konradweh/ABEP_Koppeltest/Praesentation/img/RFN/draufsicht.pdf

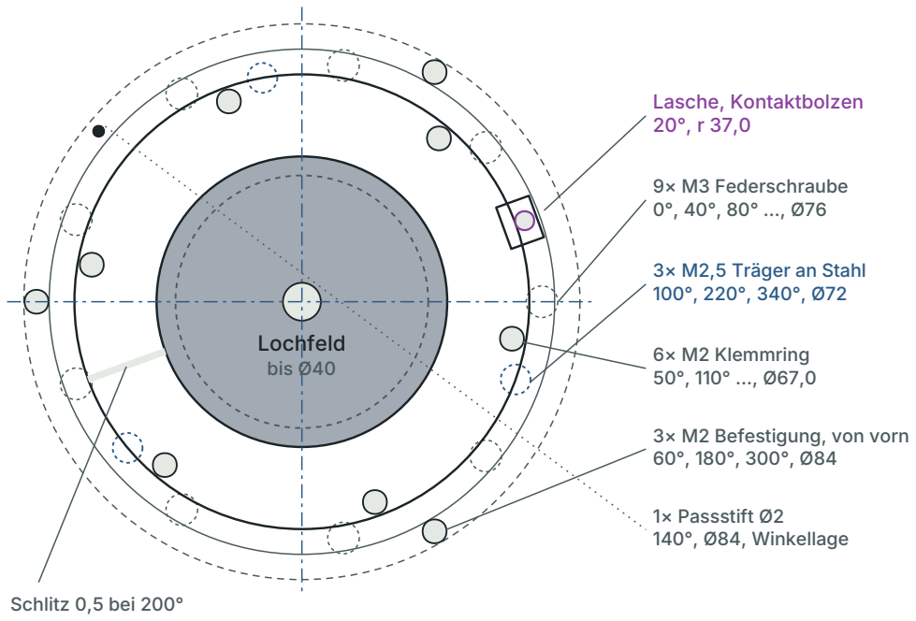
[picture p9: figure]
Lochfeld bis Ø40; Lasche, Kontaktbolzen 20°, r 37,0; 9× M3 Federschraube 0°, 40°, 80° …, Ø76; 3× M2,5 Träger an Stahl 100°, 220°, 340°, Ø72; 6× M2 Klemmring 50°, 110° …, Ø67,0; 3× M2 Befestigung, von vorn 60°, 180°, 300°, Ø84; 1× Passstift Ø2 140°, Ø84, Winkellage; Schlitz 0,5 bei 200°
