konradweh/ABEP_Koppeltest/Praesentation/img/RFN/entlueftung.pdf

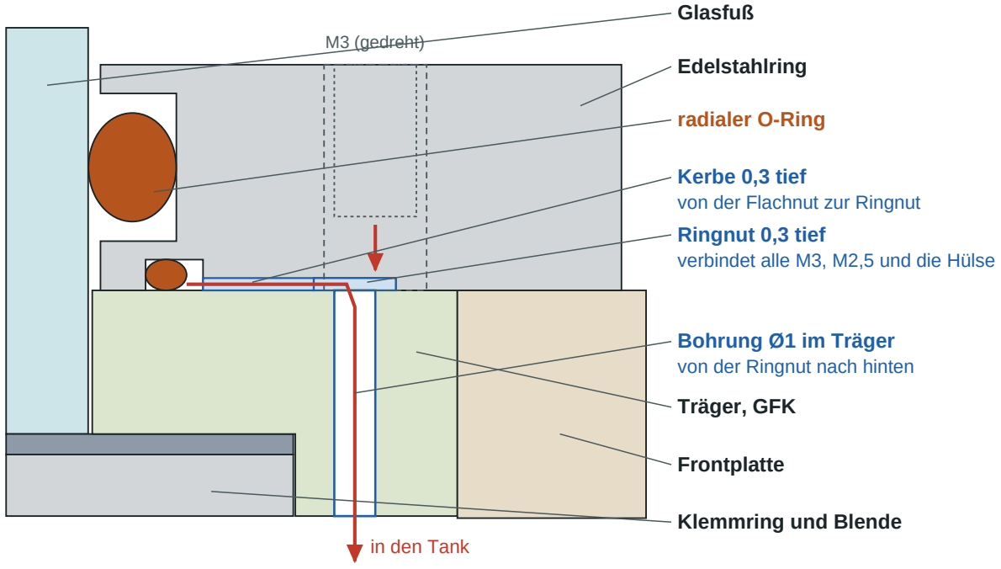
[picture p10: figure]
M3 (gedreht); in den Tank; Edelstahlring; radialer O-Ring; Kerbe 0,3 tief von der Flachnut zur Ringnut Ringnut 0,3 tief verbindet alle M3, M2,5 und die Hülse; Bohrung Ø1 im Träger von der Ringnut nach hinten; Träger, GFK; Frontplatte; Klemmring und Blende; Glasfuß

r 29 | 36,5 | 38,5 | 44
