konradweh/ABEP_Koppeltest/Praesentation/img/RFN/kontakt.pdf

Kontermutter

Kabelschuh

Mutter auf der Hülse,
0,5 über dem GFK-Ring

## Keramikhülse

Al₂O₃ Ø5 / Ø3,2 × 12,2
steht auf dem Träger

## Edelstahlring

Bohrung Ø5,3

## Träger

Bohrung Ø3,0, Freistich für die Lasche

Lasche mit M2,5-Gewinde bei r 37,0

GFK-Ring oben
Bohrung Ø6

Glasfuß

Frontplatte
