konradweh/ABEP_Koppeltest/CAD/RF-Neutralisator/RFN_Zeichnungen/DXF/100_RFN_Baugruppe.dxf

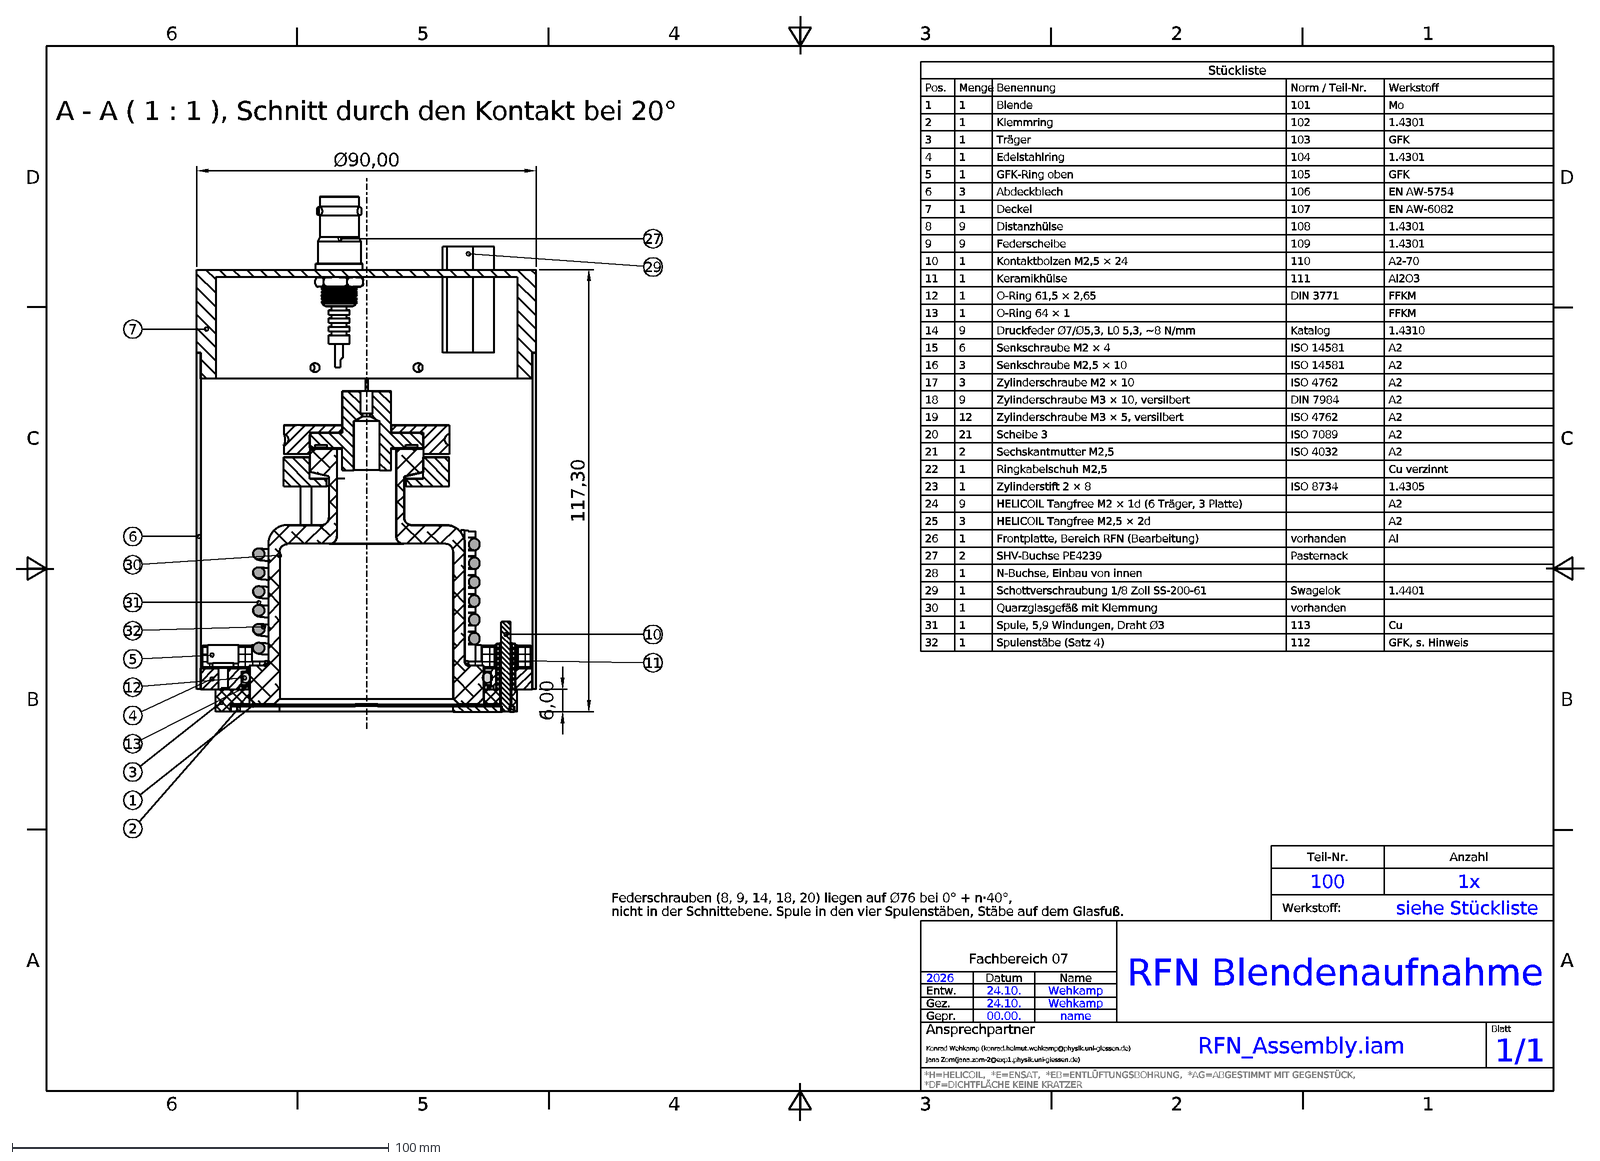
[picture p11: CAD file, 2026-10-25]
CAD/RF-Neutralisator/RFN_Zeichnungen/DXF/100_RFN_Baugruppe.dxf
6
5
4
3
2
1
A
B
C
D
Teil-Nr.
Anzahl
100
1x
Werkstoff:
siehe Stückliste
Fachbereich 07
2026
Datum
Name
Entw.
24.10.
Wehkamp
Gez.
Gepr.
00.00.
name
Ansprechpartner
Konrad Wehkamp (konrad.helmut.wehkamp@physik.uni-giessen.de)
Jana Zorn(jana.zorn-2@exp1.physik.uni-giessen.de)
RFN Blendenaufnahme
RFN_Assembly.iam
Blatt
1/1
*H=HELICOIL, *E=ENSAT, *EB=ENTLÜFTUNGSBOHRUNG, *AG=ABGESTIMMT MIT GEGENSTÜCK,
*DF=DICHTFLÄCHE KEINE KRATZER
A - A ( 1 : 1 ), Schnitt durch den Kontakt bei 20°
117,30
6,00
Ø90,00
7
30
31
32
12
13
27
29
10
11
Stückliste
Pos.
Menge
Benennung
Norm / Teil-Nr.
Werkstoff
Blende
101
Mo
Klemmring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
