konradweh/ABEP_Koppeltest/CAD/Aufhängung/RFN_Aufhängung_Drehscheibe.stp

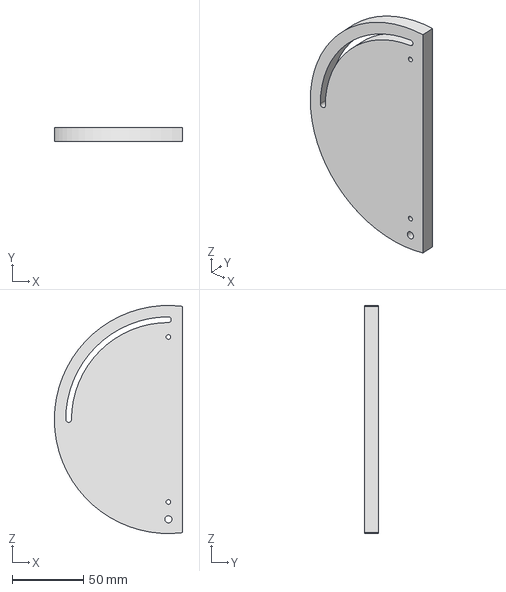
[picture p12: CAD file, 2026-10-22]
CAD/Aufhängung/RFN_Aufhängung_Drehscheibe.stp
90.0 x 10.0 x 159.9 mm
