konradweh/ABEP_Koppeltest/CAD/Halterung/Zeichnungen/Abgabe/Halterung_Grundplatte.stp

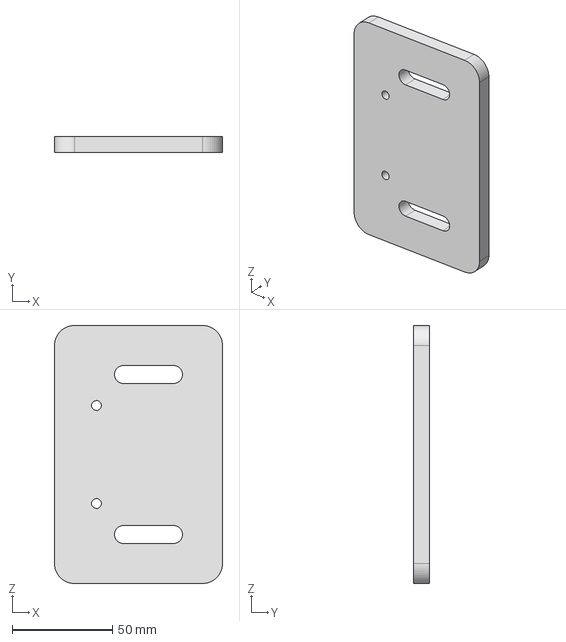
[picture p13: CAD file, 2026-10-22]
CAD/Halterung/Zeichnungen/Abgabe/Halterung_Grundplatte.stp
84.0 x 8.00 x 129.0 mm
