konradweh/ABEP_Koppeltest/CAD/RF-Neutralisator/RFN_Zeichnungen/DXF/103_Traeger.dxf

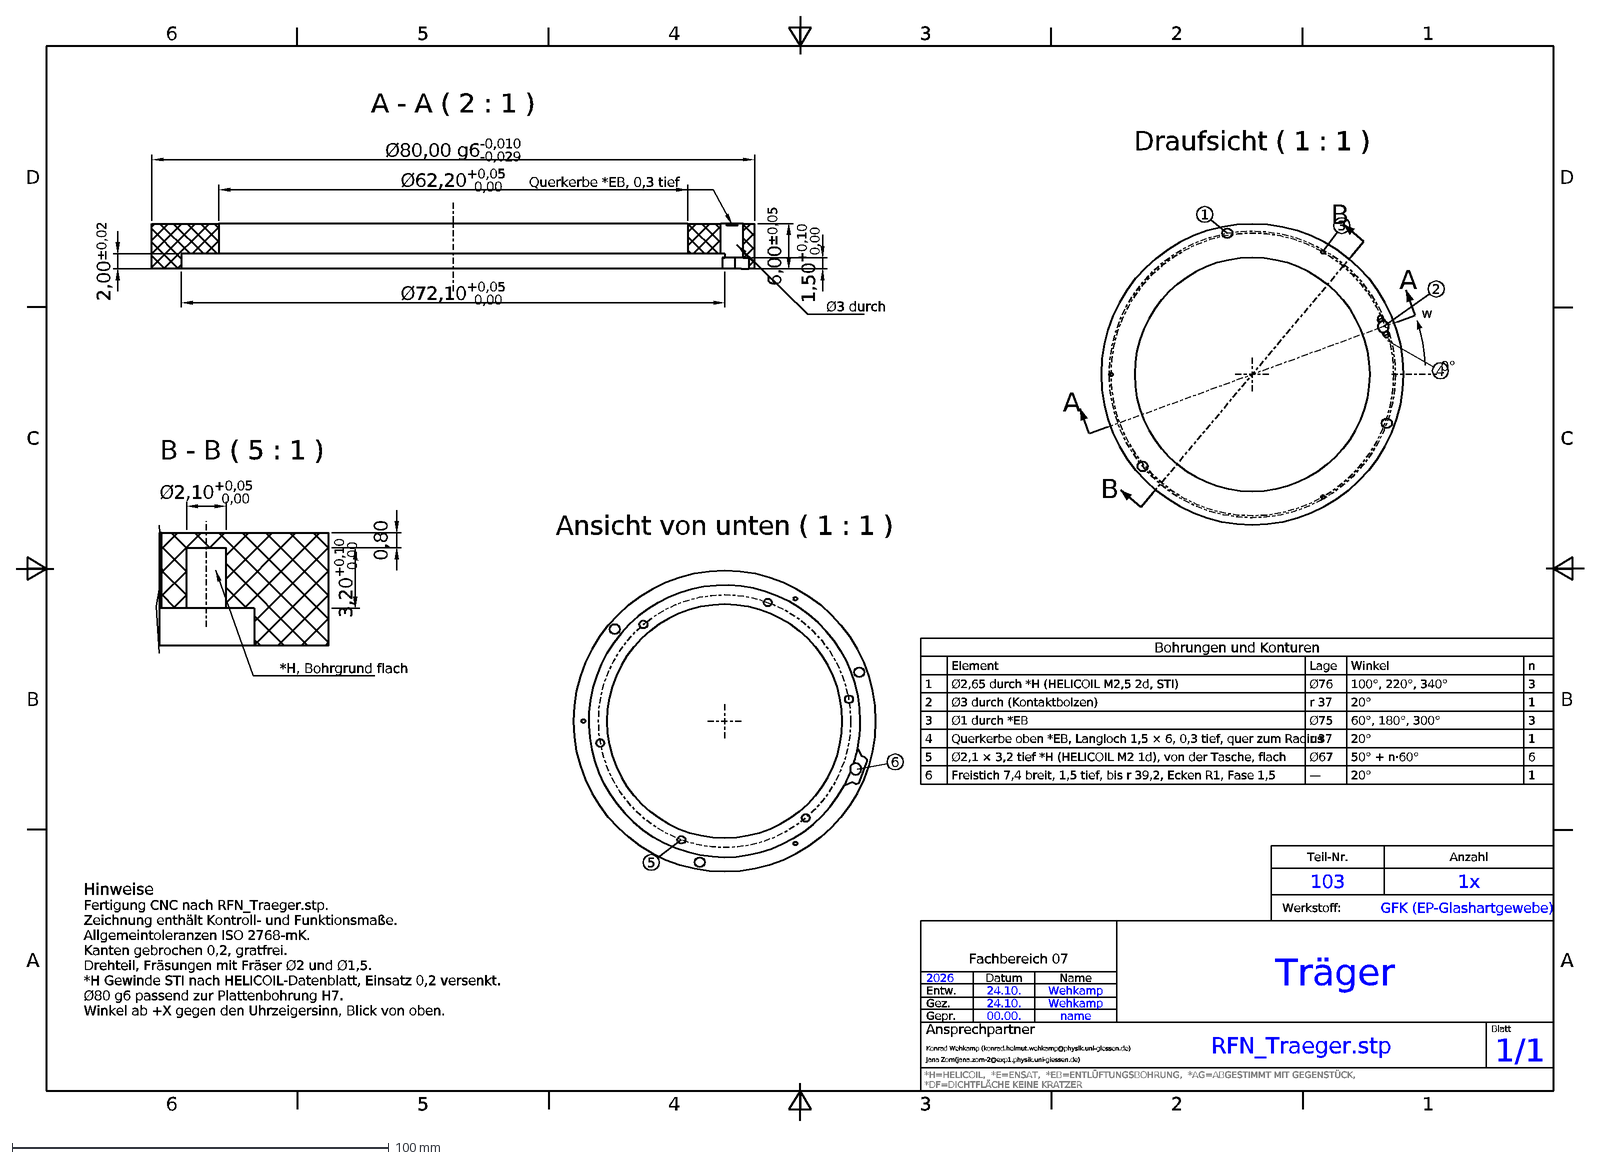
[picture p14: CAD file, 2026-10-25]
CAD/RF-Neutralisator/RFN_Zeichnungen/DXF/103_Traeger.dxf
6
5
4
3
2
1
A
B
C
D
Teil-Nr.
Anzahl
103
1x
Werkstoff:
GFK (EP-Glashartgewebe)
Fachbereich 07
2026
Datum
Name
Entw.
24.10.
Wehkamp
Gez.
Gepr.
00.00.
name
Ansprechpartner
Konrad Wehkamp (konrad.helmut.wehkamp@physik.uni-giessen.de)
Jana Zorn(jana.zorn-2@exp1.physik.uni-giessen.de)
Träger
RFN_Traeger.stp
Blatt
1/1
*H=HELICOIL, *E=ENSAT, *EB=ENTLÜFTUNGSBOHRUNG, *AG=ABGESTIMMT MIT GEGENSTÜCK,
*DF=DICHTFLÄCHE KEINE KRATZER
A - A ( 2 : 1 )
Ø62,20+0,05^ 0,00
Ø80,00 g6-0,010^-0,029
Ø72,10+0,05^ 0,00
6,00±0,05
2,00±0,02
1,50+0,10^ 0,00
Querkerbe *EB, 0,3 tief
Ø3 durch
B - B ( 5 : 1 )
Ø2,10+0,05^ 0,00
3,20+0,10^ 0,00
0,80
*H, Bohrgrund flach
Draufsicht ( 1 : 1 )
0°
w
Ansicht von unten ( 1 : 1 )
Bohrungen und Konturen
Element
Lage
Winkel
n
Ø2,65 durch *H (HELICOIL M2,5 2d, STI)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
