konradweh/ABEP_Koppeltest/CAD/RF-Neutralisator/RFN_Zeichnungen/DXF_2/Distanzhuelse.dxf

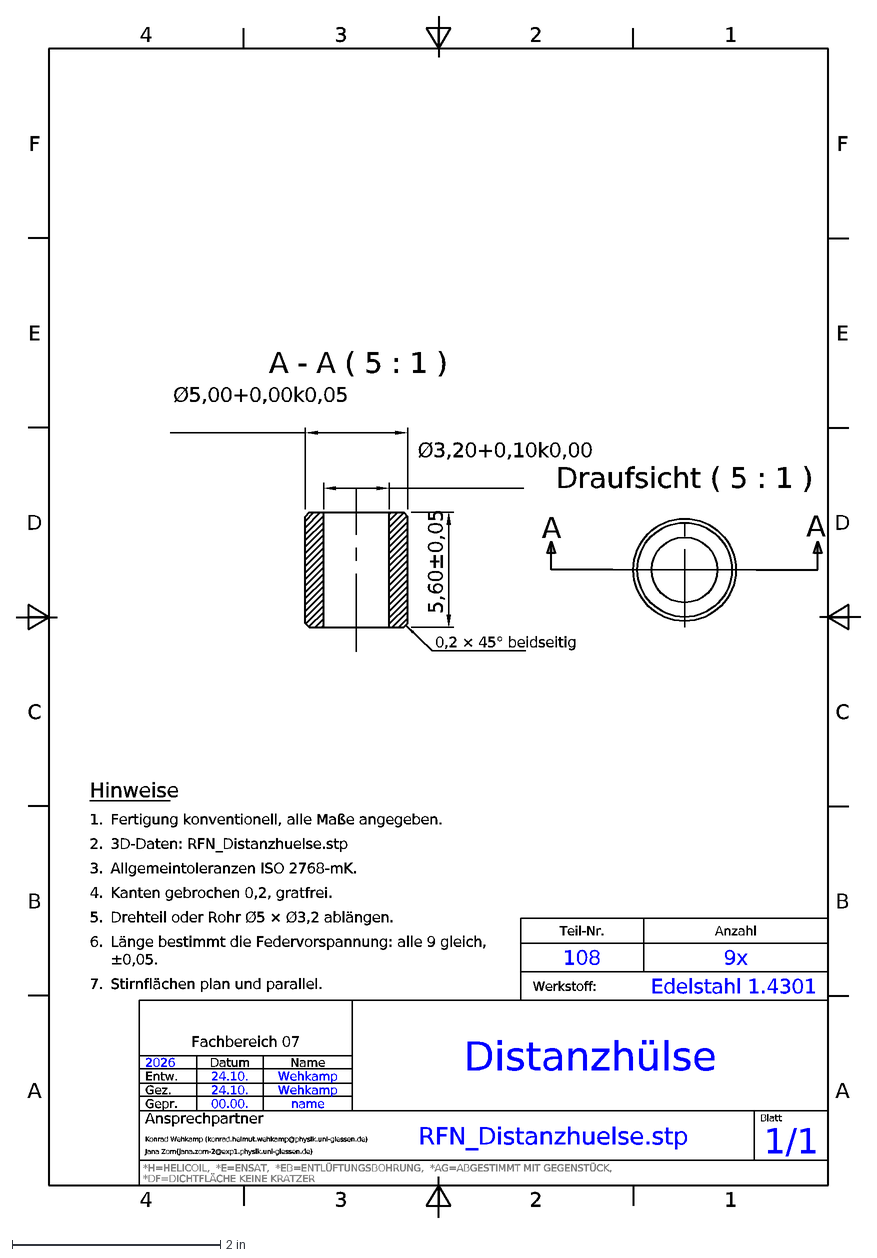
[picture p15: CAD file, 2026-10-27]
CAD/RF-Neutralisator/RFN_Zeichnungen/DXF_2/Distanzhuelse.dxf
4
3
2
1
A
B
C
D
E
F
Fachbereich 07
*H=HELICOIL, *E=ENSAT, *EB=ENTLÜFTUNGSBOHRUNG, *AG=ABGESTIMMT MIT GEGENSTÜCK,
Teil-Nr.
Werkstoff:
*DF=DICHTFLÄCHE KEINE KRATZER
Anzahl
Ansprechpartner
Blatt
108
9x
Edelstahl 1.4301
2026
A - A ( 5 : 1 )
RFN_Distanzhuelse.stp
Distanzhülse
Jana Zorn(jana.zorn-2@exp1.physik.uni-giessen.de)
Wehkamp
1/1
Konrad Wehkamp (konrad.helmut.wehkamp@physik.uni-giessen.de)
name
Draufsicht ( 5 : 1 )
00.00.
Gepr.
24.10.
Gez.
Entw.
Name
Datum
Ø5,00+0,00k0,05
Ø3,20+0,10k0,00
5,60±0,05
0,2 × 45° beidseitig
Hinweise
1.
Fertigung konventionell, alle Maße angegeben.
2.
3D-Daten: RFN_Distanzhuelse.stp
3.
Allgemeintoleranzen ISO 2768-mK.
4.
Kanten gebrochen 0,2, gratfrei.
5.
Drehteil oder Rohr Ø5 × Ø3,2 ablängen.
6.
Länge bestimmt die Federvorspannung: alle 9 gleich,
±0,05.
7.
Stirnflächen plan und parallel.
