konradweh/ABEP_Koppeltest/CAD/RF-Neutralisator/RFN_Zeichnungen/Zeichnungen_v10/Zeichnungen_v10/Aufhaengung/A-05_Teflonplatte.dxf

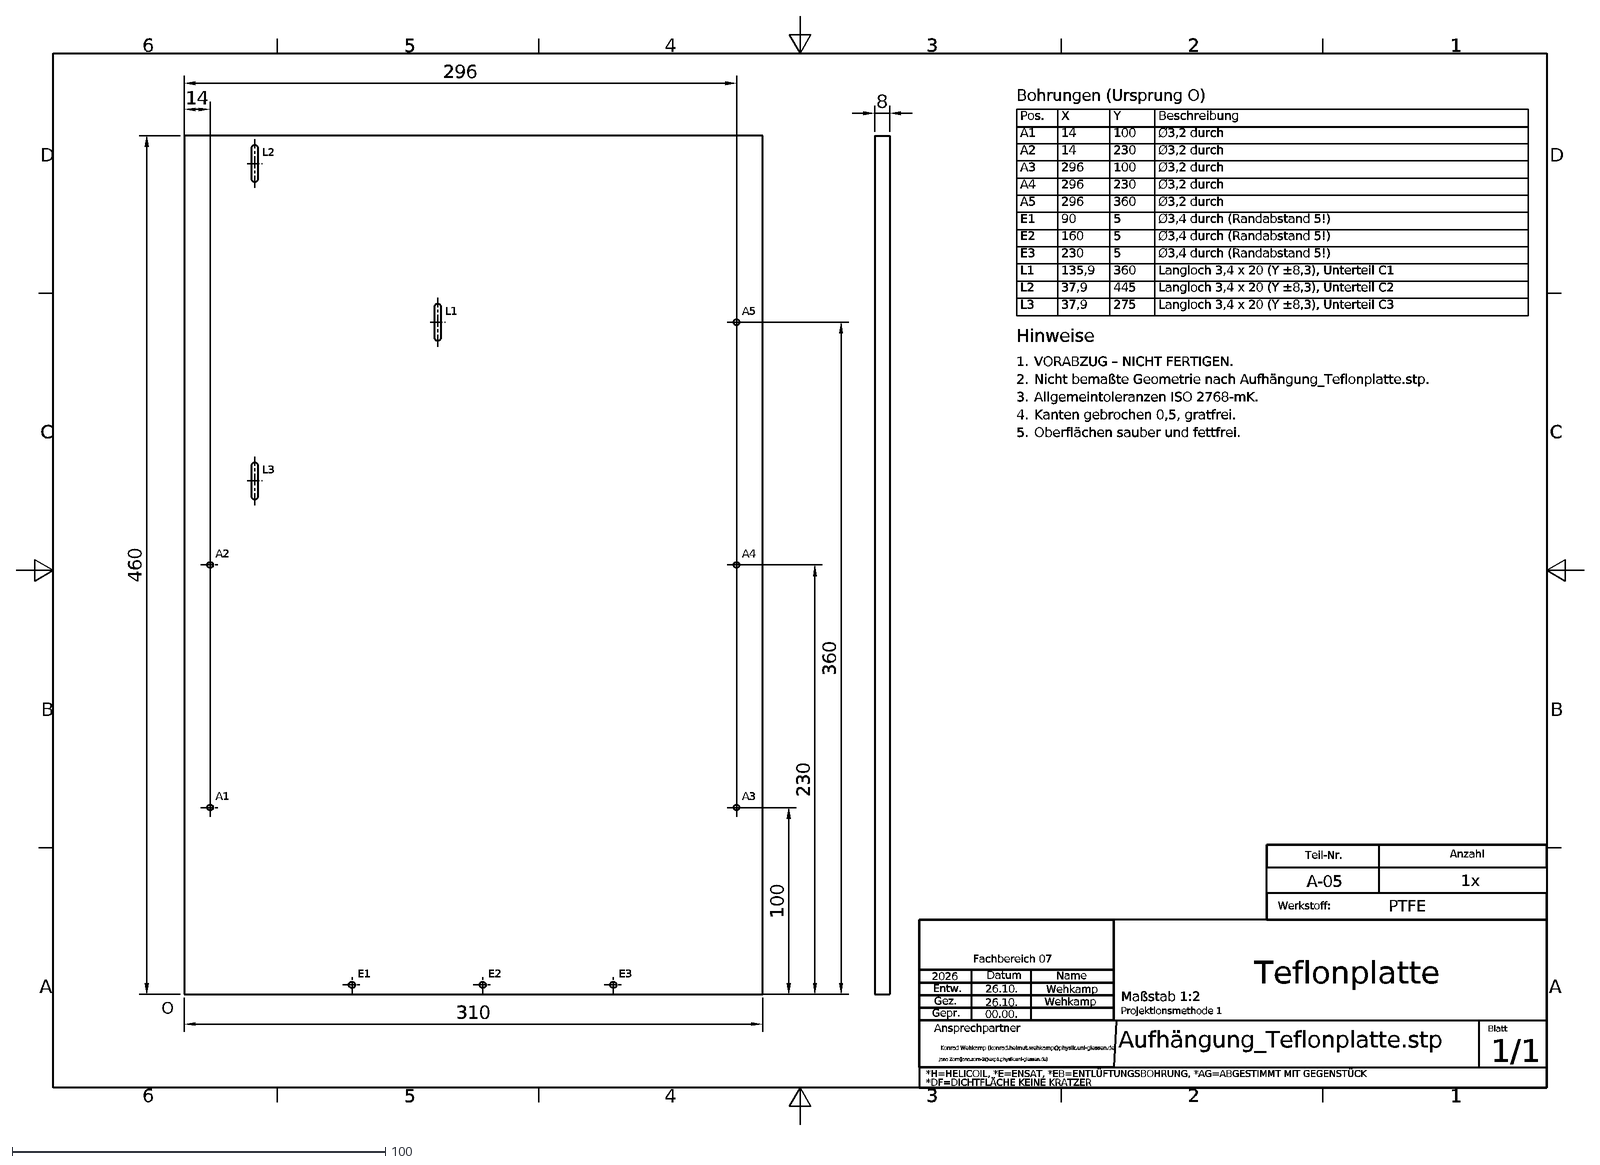
[picture p16: CAD file, 2026-10-27]
CAD/RF-Neutralisator/RFN_Zeichnungen/Zeichnungen_v10/Zeichnungen_v10/Aufhaengung/A-05_Teflonplatte.dxf
D
C
B
A
6
5
4
3
2
1
Wehkamp
00.00.
26.10.
1x
PTFE
A-05
Teflonplatte
2026
Aufhängung_Teflonplatte.stp
1/1
Werkstoff:
Anzahl
Jana Zorn(jana.zorn-2@exp1.physik.uni-giessen.de)
Konrad Wehkamp (konrad.helmut.wehkamp@physik.uni-giessen.de
Ansprechpartner
*DF=DICHTFLÄCHE KEINE KRATZER
*H=HELICOIL, *E=ENSAT, *EB=ENTLÜFTUNGSBOHRUNG, *AG=ABGESTIMMT MIT GEGENSTÜCK
Gepr.
Gez.
Entw.
Name
Datum
Fachbereich 07
Blatt
Teil-Nr.
Maßstab 1:2
Projektionsmethode 1
O
A1
A2
A3
A4
A5
E1
E2
E3
L1
L2
L3
310
460
14
296
100
230
360
8
Bohrungen (Ursprung O)
Pos.
X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
