konradweh/ABEP_Koppeltest/CAD/RF-Neutralisator/RFN_Zeichnungen/Zeichnungen_v10/Zeichnungen_v10/RFN/Spule.dxf

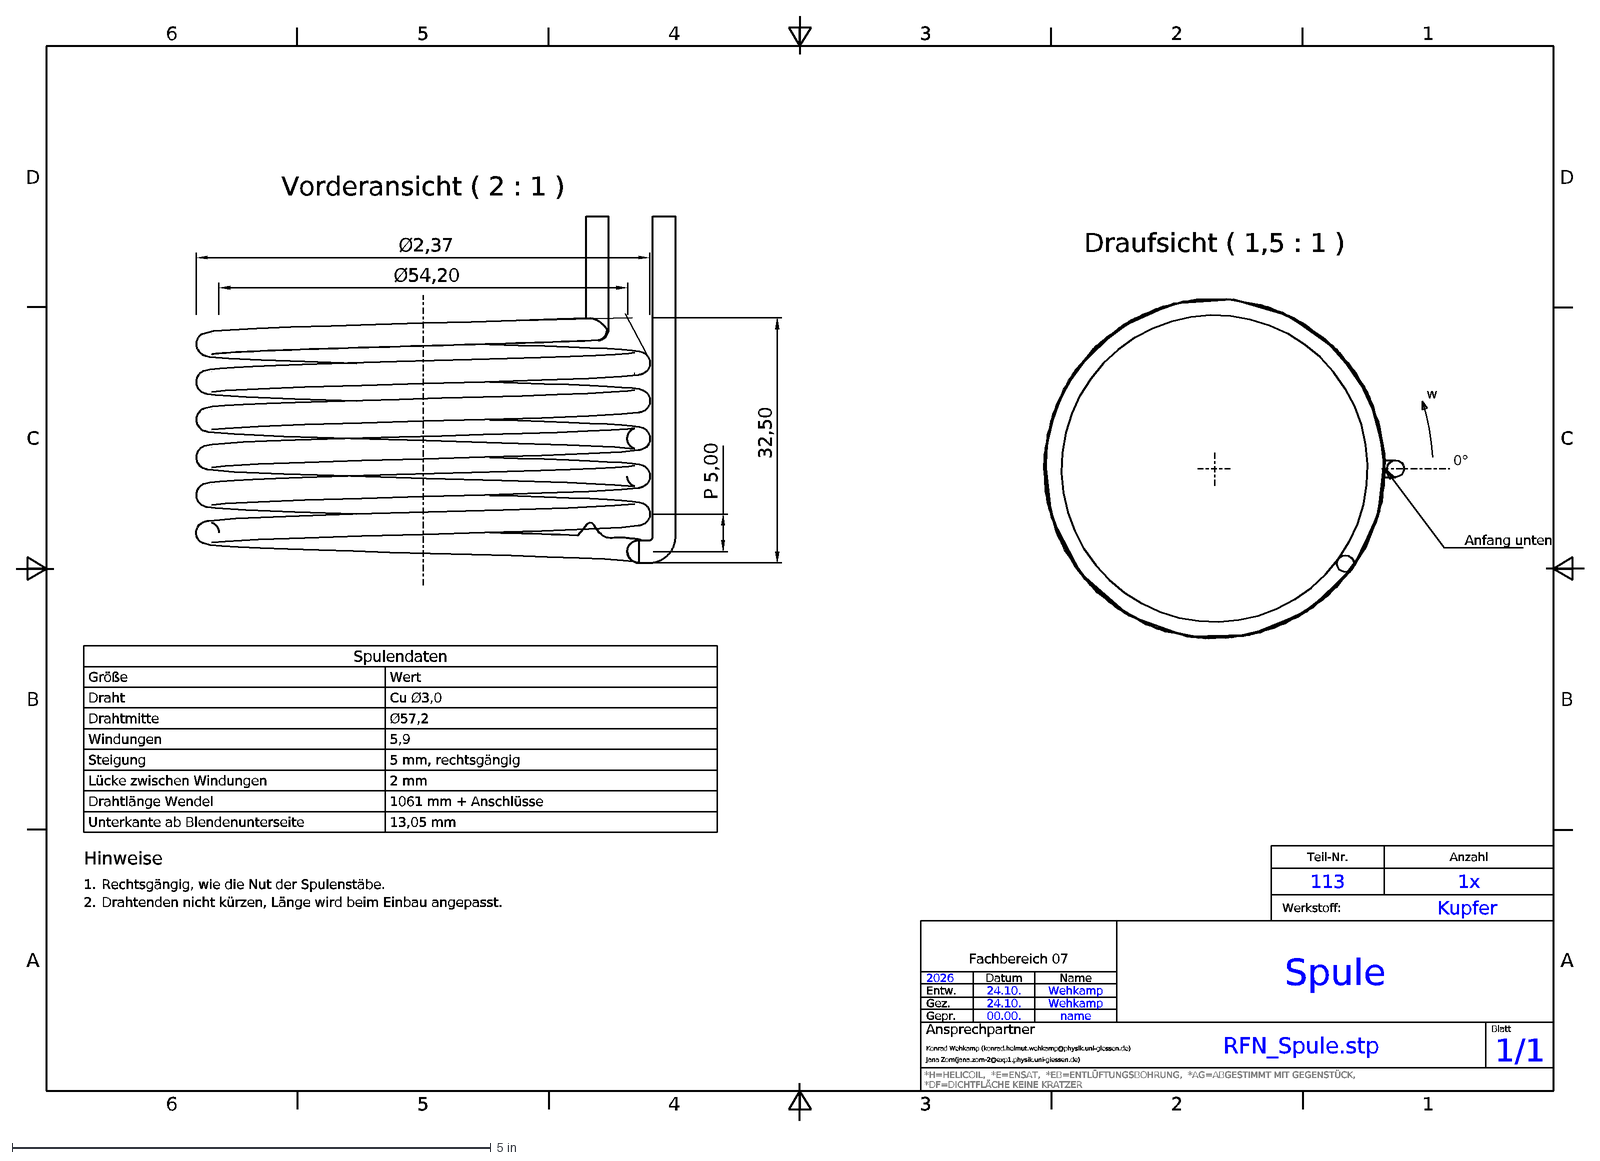
[picture p17: CAD file, 2026-10-27]
CAD/RF-Neutralisator/RFN_Zeichnungen/Zeichnungen_v10/Zeichnungen_v10/RFN/Spule.dxf
6
5
4
3
2
1
A
B
C
D
Fachbereich 07
Teil-Nr.
Anzahl
Ansprechpartner
Werkstoff:
Blatt
*H=HELICOIL, *E=ENSAT, *EB=ENTLÜFTUNGSBOHRUNG, *AG=ABGESTIMMT MIT GEGENSTÜCK,
*DF=DICHTFLÄCHE KEINE KRATZER
Vorderansicht ( 2 : 1 )
Draufsicht ( 1,5 : 1 )
name
00.00.
Gepr.
0°
Wehkamp
24.10.
w
Gez.
Anfang unten
Spulendaten
Größe
Wert
Draht
Cu Ø3,0
Drahtmitte
Ø57,2
Windungen
5,9
Steigung
5 mm, rechtsgängig
Lücke zwischen Windungen
2 mm
Drahtlänge Wendel
1061 mm + Anschlüsse
Unterkante ab Blendenunterseite
13,05 mm
Entw.
Name
Datum
2026
Kupfer
1x
113
RFN_Spule.stp
Spule
Jana Zorn(jana.zorn-2@exp1.physik.uni-giessen.de)
Konrad Wehkamp (konrad.helmut.wehkamp@physik.uni-giessen.de)
1/1
P 5,00
32,50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
