konradweh/ABEP_Koppeltest/CAD/Halterung/Zeichnungen/Abgabe/Halterung_Seitenteil.stp

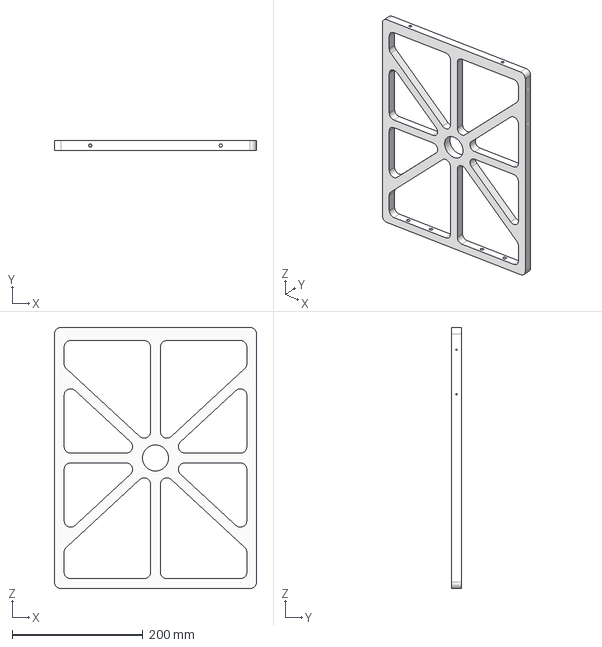
[picture p19: CAD file, 2026-10-22]
CAD/Halterung/Zeichnungen/Abgabe/Halterung_Seitenteil.stp
310.0 x 15.0 x 400.0 mm
