konradweh/ABEP_Koppeltest/CAD/RF-Neutralisator/RFN_Zeichnungen/DXF/113_Spule.dxf

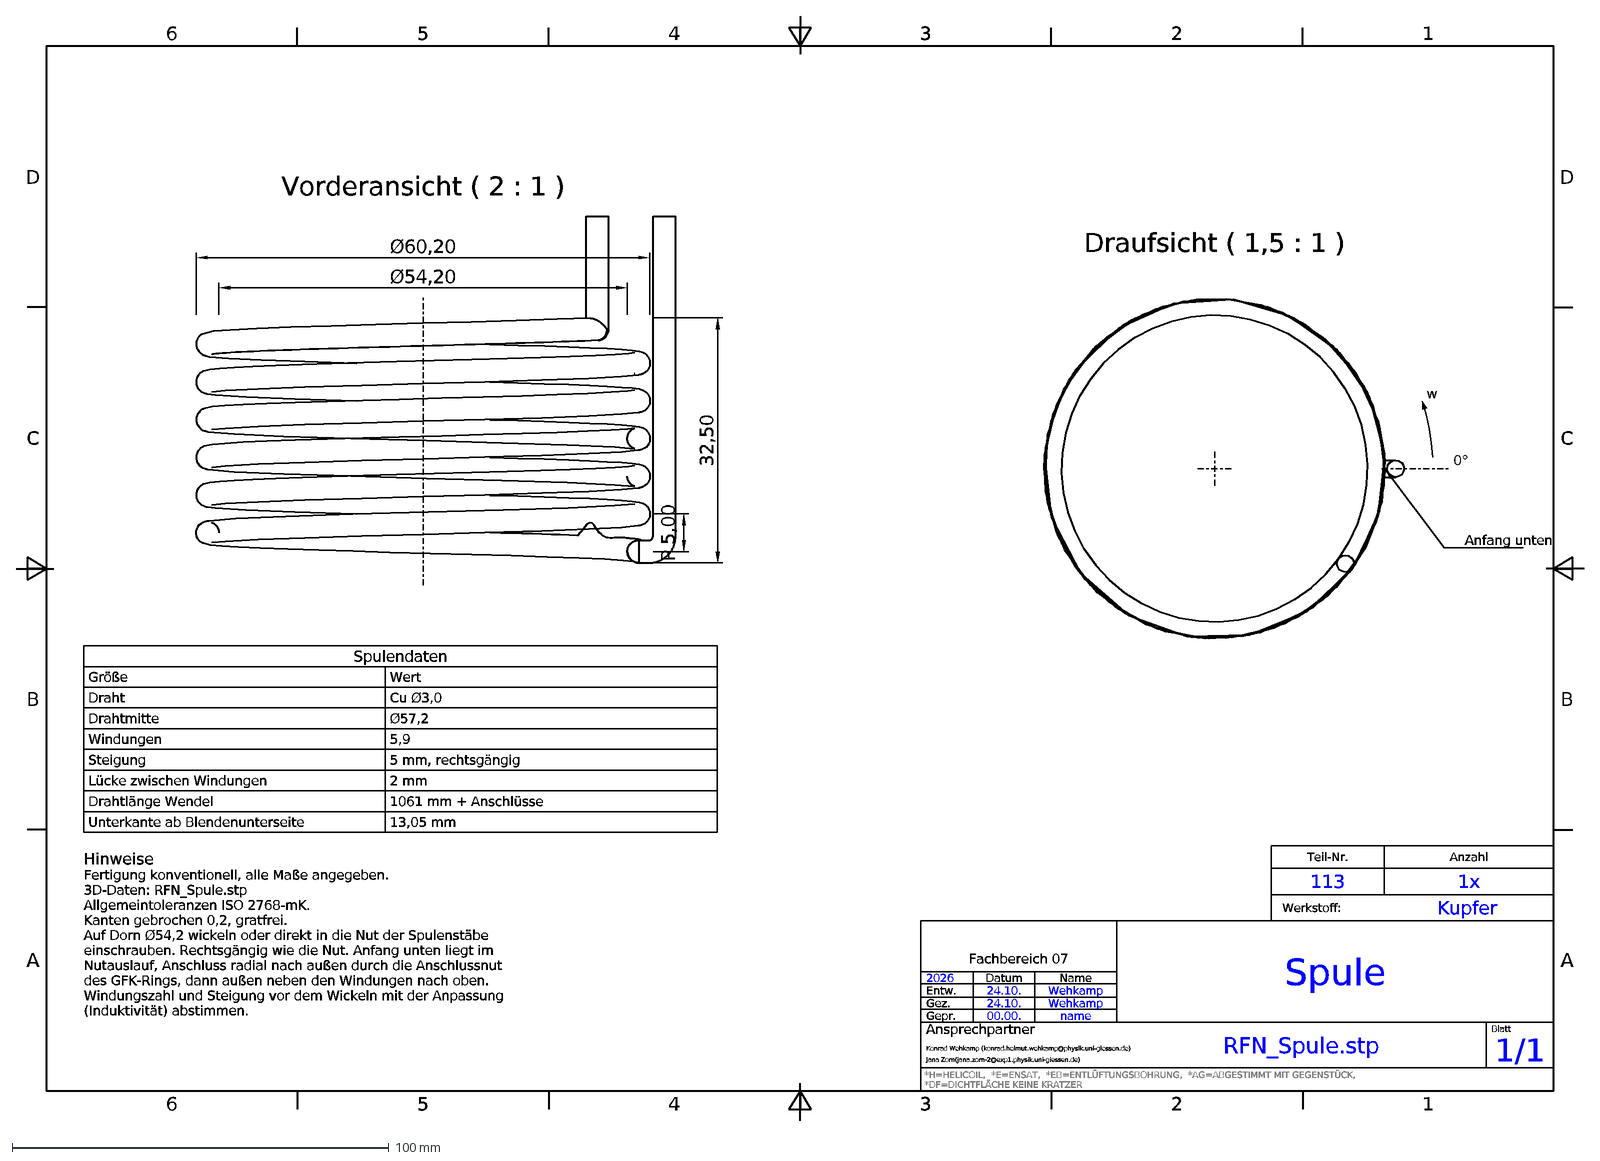
[picture p20: CAD file, 2026-10-25]
CAD/RF-Neutralisator/RFN_Zeichnungen/DXF/113_Spule.dxf
6
5
4
3
2
1
A
B
C
D
Teil-Nr.
Anzahl
113
1x
Werkstoff:
Kupfer
Fachbereich 07
2026
Datum
Name
Entw.
24.10.
Wehkamp
Gez.
Gepr.
00.00.
name
Ansprechpartner
Konrad Wehkamp (konrad.helmut.wehkamp@physik.uni-giessen.de)
Jana Zorn(jana.zorn-2@exp1.physik.uni-giessen.de)
Spule
RFN_Spule.stp
Blatt
1/1
*H=HELICOIL, *E=ENSAT, *EB=ENTLÜFTUNGSBOHRUNG, *AG=ABGESTIMMT MIT GEGENSTÜCK,
*DF=DICHTFLÄCHE KEINE KRATZER
Vorderansicht ( 2 : 1 )
Ø60,20
Ø54,20
32,50
P 5,00
Draufsicht ( 1,5 : 1 )
0°
w
Anfang unten
Spulendaten
Größe
Wert
Draht
Cu Ø3,0
Drahtmitte
Ø57,2
Windungen
5,9
Steigung
5 mm, rechtsgängig
Lücke zwischen Windungen
2 mm
Drahtlänge Wendel
1061 mm + Anschlüsse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
