konradweh/ABEP_Koppeltest/CAD/RF-Neutralisator/RFN_Zeichnungen/DXF_2/Kontaktbolzen.dxf

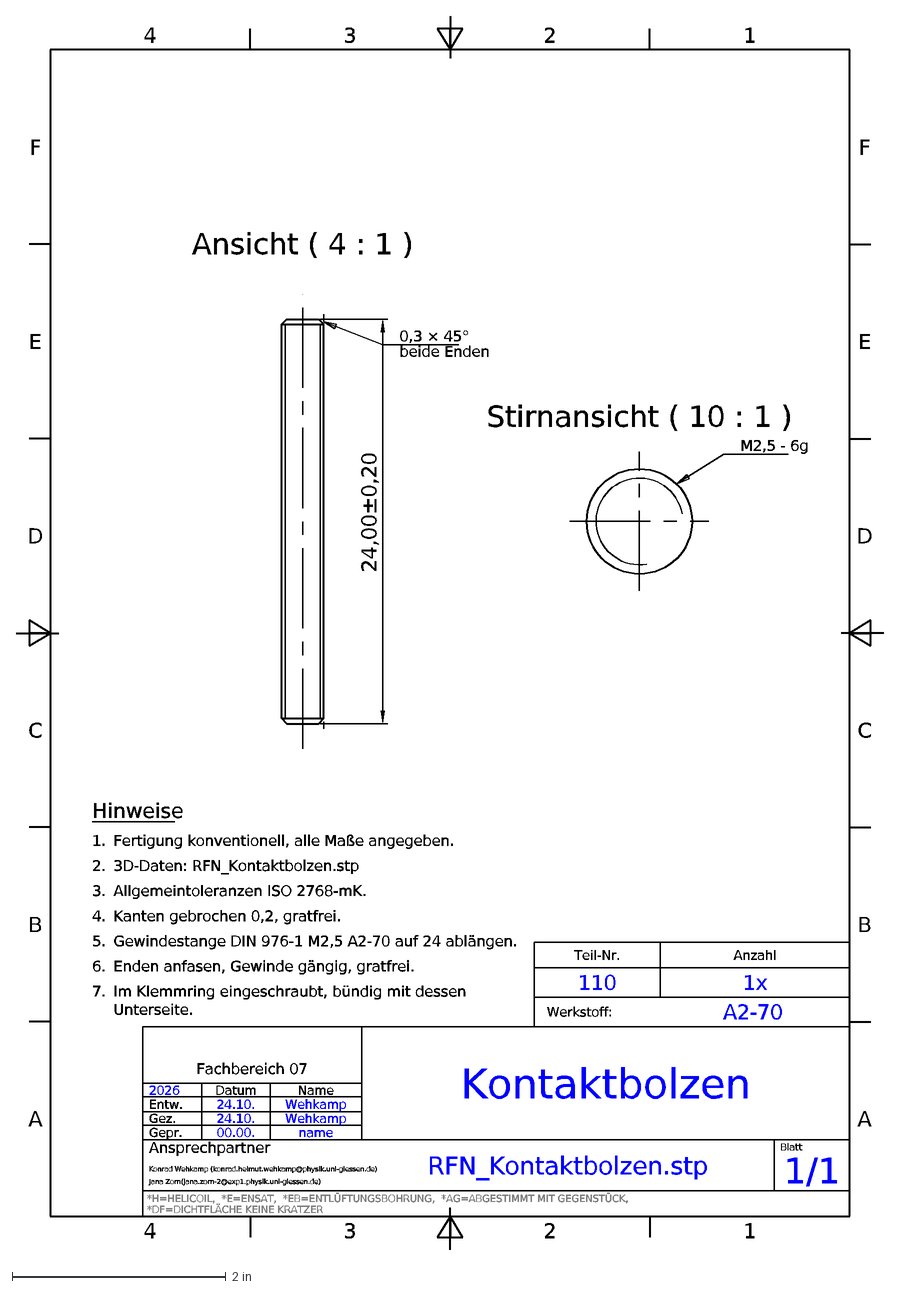
[picture p21: CAD file, 2026-10-27]
CAD/RF-Neutralisator/RFN_Zeichnungen/DXF_2/Kontaktbolzen.dxf
4
3
2
1
A
B
C
D
E
F
Fachbereich 07
Blatt
Teil-Nr.
*H=HELICOIL, *E=ENSAT, *EB=ENTLÜFTUNGSBOHRUNG, *AG=ABGESTIMMT MIT GEGENSTÜCK,
*DF=DICHTFLÄCHE KEINE KRATZER
Anzahl
Ansprechpartner
Werkstoff:
110
1x
A2-70
2026
Datum
Name
Entw.
24.10.
Wehkamp
Kontaktbolzen
Ansicht ( 4 : 1 )
Jana Zorn(jana.zorn-2@exp1.physik.uni-giessen.de)
Konrad Wehkamp (konrad.helmut.wehkamp@physik.uni-giessen.de)
0,3 × 45°
beide Enden
name
1/1
RFN_Kontaktbolzen.stp
00.00.
Gepr.
Stirnansicht ( 10 : 1 )
M2,5 - 6g
Gez.
24,00±0,20
Hinweise
1.
Fertigung konventionell, alle Maße angegeben.
2.
3D-Daten: RFN_Kontaktbolzen.stp
3.
Allgemeintoleranzen ISO 2768-mK.
4.
Kanten gebrochen 0,2, gratfrei.
5.
Gewindestange DIN 976-1 M2,5 A2-70 auf 24 ablängen.
6.
Enden anfasen, Gewinde gängig, gratfrei.
7.
Im Klemmring eingeschraubt, bündig mit dessen
Unterseite.
