konradweh/ABEP_Koppeltest/CAD/RF-Neutralisator/RFN_Zeichnungen/Zeichnungen_v10/Zeichnungen_v10/Aufhaengung/A-02_Drehscheibe.dxf

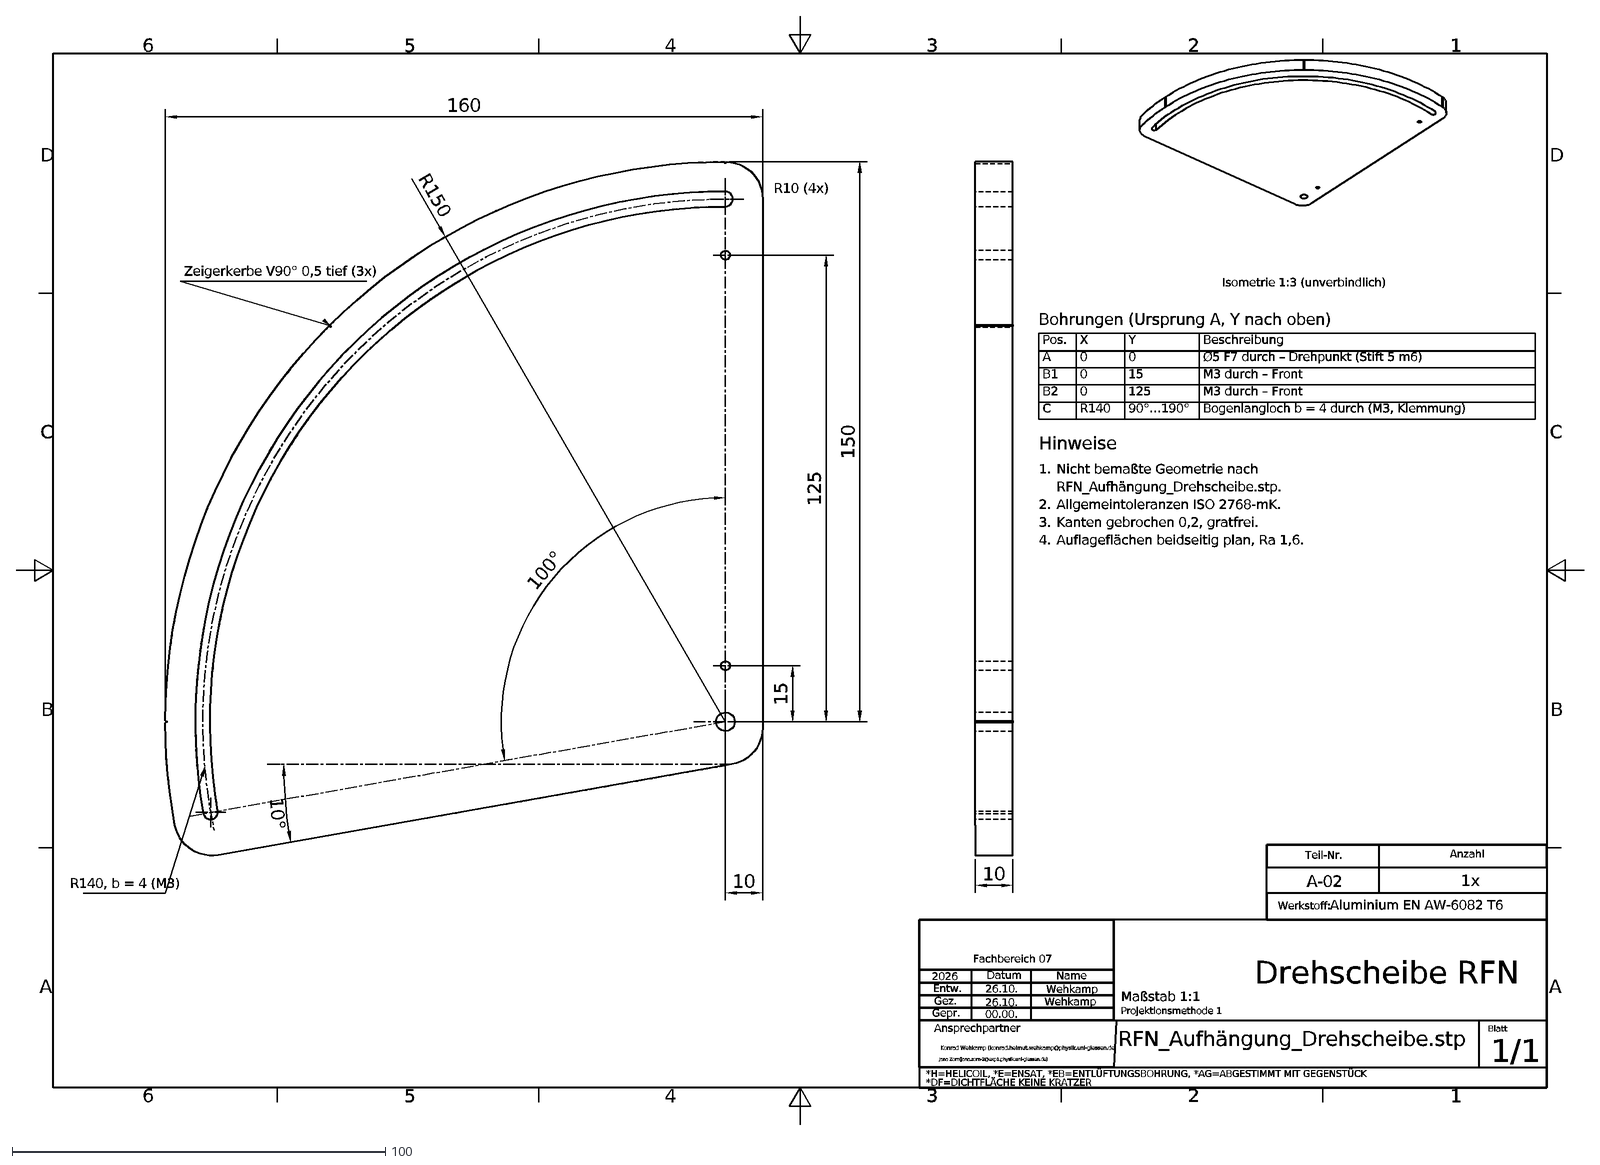
[picture p22: CAD file, 2026-10-27]
CAD/RF-Neutralisator/RFN_Zeichnungen/Zeichnungen_v10/Zeichnungen_v10/Aufhaengung/A-02_Drehscheibe.dxf
D
C
B
A
6
5
4
3
2
1
Wehkamp
00.00.
26.10.
1x
Aluminium EN AW-6082 T6
A-02
Drehscheibe RFN
2026
RFN_Aufhängung_Drehscheibe.stp
1/1
Werkstoff:
Anzahl
Jana Zorn(jana.zorn-2@exp1.physik.uni-giessen.de)
Konrad Wehkamp (konrad.helmut.wehkamp@physik.uni-giessen.de
Ansprechpartner
*DF=DICHTFLÄCHE KEINE KRATZER
*H=HELICOIL, *E=ENSAT, *EB=ENTLÜFTUNGSBOHRUNG, *AG=ABGESTIMMT MIT GEGENSTÜCK
Gepr.
Gez.
Entw.
Name
Datum
Fachbereich 07
Blatt
Teil-Nr.
Maßstab 1:1
Projektionsmethode 1
100°
R150
R140, b = 4 (M3)
160
15
125
150
10
10°
Zeigerkerbe V90° 0,5 tief (3x)
R10 (4x)
Isometrie 1:3 (unverbindlich)
Bohrungen (Ursprung A, Y nach oben)
Pos.
X
Y
Beschreibung
0
Ø5 F7 durch – Drehpunkt (Stift 5 m6)
B1
M3 durch – Front
B2
R140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
