konradweh/ABEP_Koppeltest/CAD/RF-Neutralisator/RFN_Zeichnungen/Zeichnungen_v10/Zeichnungen_v10/RFN/Keramikhuelse.dxf

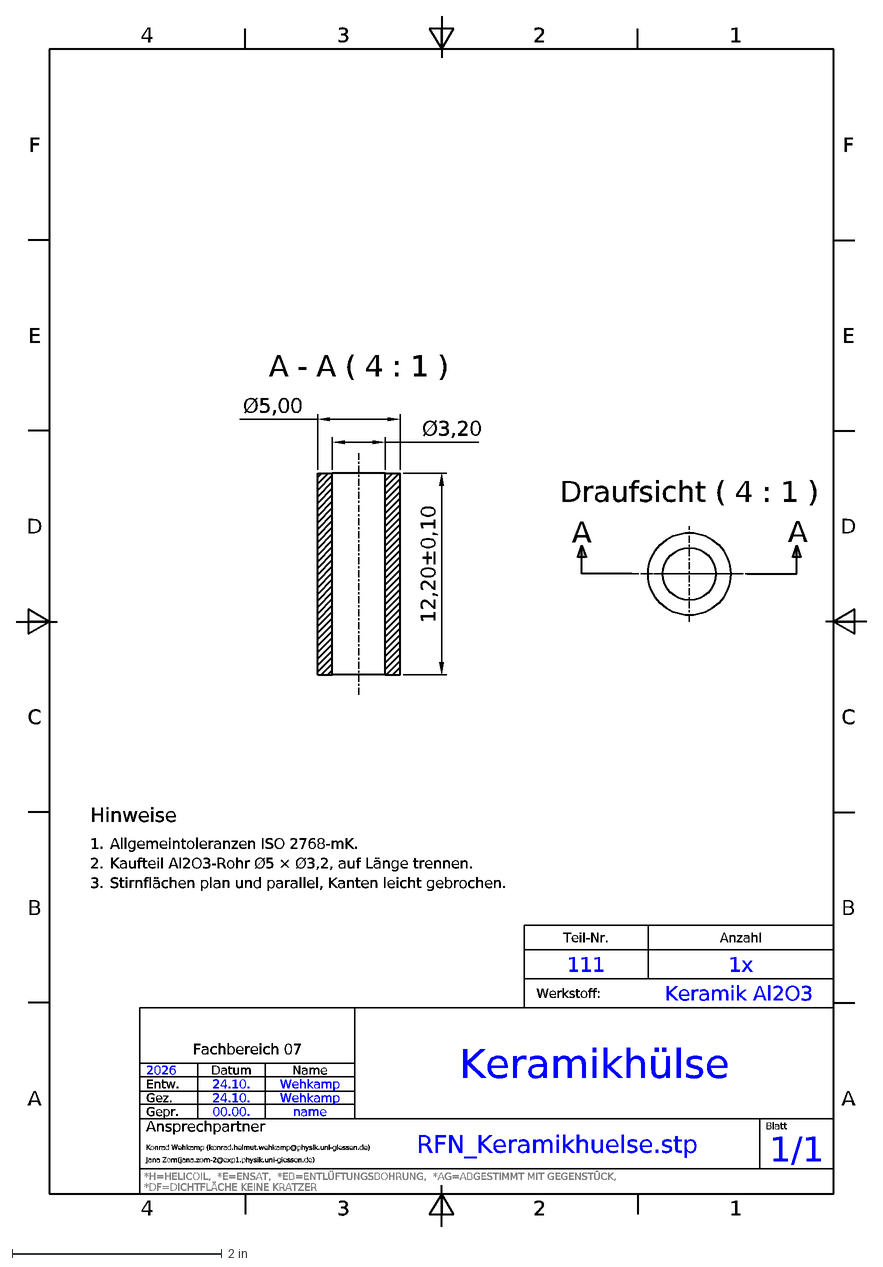
[picture p23: CAD file, 2026-10-27]
CAD/RF-Neutralisator/RFN_Zeichnungen/Zeichnungen_v10/Zeichnungen_v10/RFN/Keramikhuelse.dxf
4
3
2
1
A
B
C
D
E
F
Fachbereich 07
Blatt
*H=HELICOIL, *E=ENSAT, *EB=ENTLÜFTUNGSBOHRUNG, *AG=ABGESTIMMT MIT GEGENSTÜCK,
Teil-Nr.
*DF=DICHTFLÄCHE KEINE KRATZER
Werkstoff:
Anzahl
Ansprechpartner
111
1x
Keramik Al2O3
2026
Datum
Name
A - A ( 4 : 1 )
RFN_Keramikhuelse.stp
Keramikhülse
Jana Zorn(jana.zorn-2@exp1.physik.uni-giessen.de)
Gez.
1/1
Konrad Wehkamp (konrad.helmut.wehkamp@physik.uni-giessen.de)
name
Draufsicht ( 4 : 1 )
00.00.
Gepr.
Wehkamp
24.10.
Entw.
12,20±0,10
Ø3,20
Ø5,00
Hinweise
1.
Allgemeintoleranzen ISO 2768-mK.
2.
Kaufteil Al2O3-Rohr Ø5 × Ø3,2, auf Länge trennen.
3.
Stirnflächen plan und parallel, Kanten leicht gebrochen.
