konradweh/ABEP_Koppeltest/CAD/Halterung/Zeichnungen/Abgabe/Halterung_Winkelprofil_kurz.stp

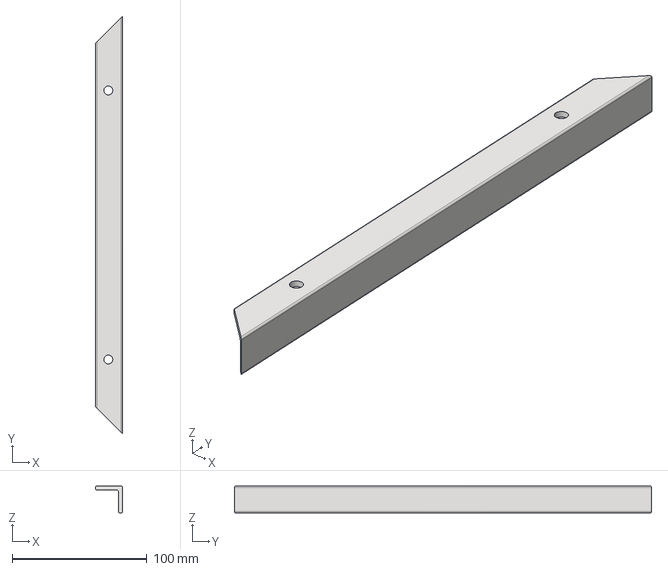
[picture p25: CAD file, 2026-10-22]
CAD/Halterung/Zeichnungen/Abgabe/Halterung_Winkelprofil_kurz.stp
20.0 x 310.0 x 20.0 mm
