konradweh/ABEP_Koppeltest/CAD/RF-Neutralisator/RFN_Zeichnungen/DXF/101_Blende.dxf

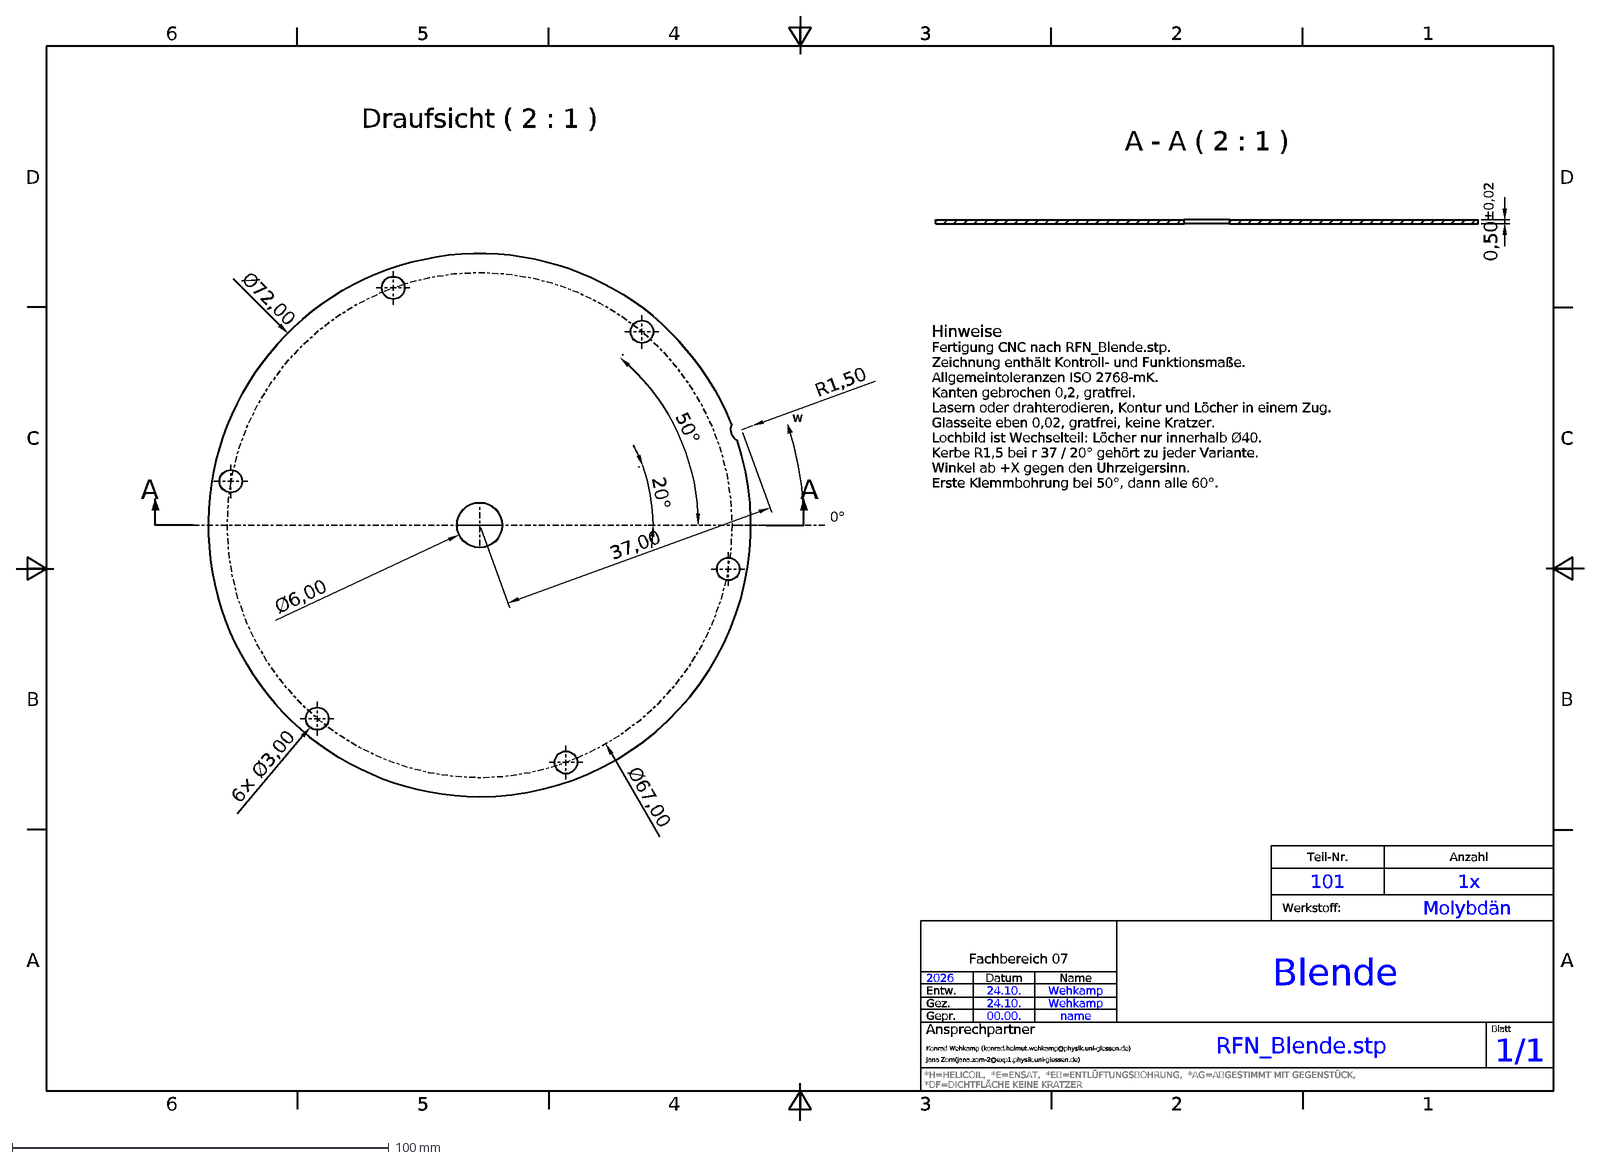
[picture p26: CAD file, 2026-10-25]
CAD/RF-Neutralisator/RFN_Zeichnungen/DXF/101_Blende.dxf
6
5
4
3
2
1
A
B
C
D
Teil-Nr.
Anzahl
101
1x
Werkstoff:
Molybdän
Fachbereich 07
2026
Datum
Name
Entw.
24.10.
Wehkamp
Gez.
Gepr.
00.00.
name
Ansprechpartner
Konrad Wehkamp (konrad.helmut.wehkamp@physik.uni-giessen.de)
Jana Zorn(jana.zorn-2@exp1.physik.uni-giessen.de)
Blende
RFN_Blende.stp
Blatt
1/1
*H=HELICOIL, *E=ENSAT, *EB=ENTLÜFTUNGSBOHRUNG, *AG=ABGESTIMMT MIT GEGENSTÜCK,
*DF=DICHTFLÄCHE KEINE KRATZER
Draufsicht ( 2 : 1 )
Ø72,00
Ø6,00
Ø67,00
6× Ø3,00
R1,50
37,00
20°
50°
0°
w
A - A ( 2 : 1 )
0,50±0,02
Hinweise
Fertigung CNC nach RFN_Blende.stp.
Zeichnung enthält Kontroll- und Funktionsmaße.
Allgemeintoleranzen ISO 2768-mK.
Kanten gebrochen 0,2, gratfrei.
Lasern oder drahterodieren, Kontur und Löcher in einem Zug.
Glasseite eben 0,02, gratfrei, keine Kratzer.
Lochbild ist Wechselteil: Löcher nur innerhalb Ø40.
Kerbe R1,5 bei r 37 / 20° gehört zu jeder Variante.
Winkel ab +X gegen den Uhrzeigersinn.
Erste Klemmbohrung bei 50°, dann alle 60°.
