konradweh/ABEP_Koppeltest/CAD/RF-Neutralisator/RFN_Zeichnungen/Zeichnungen_v10/Zeichnungen_v10/Aufhaengung/A-04_Erhoehung.dxf

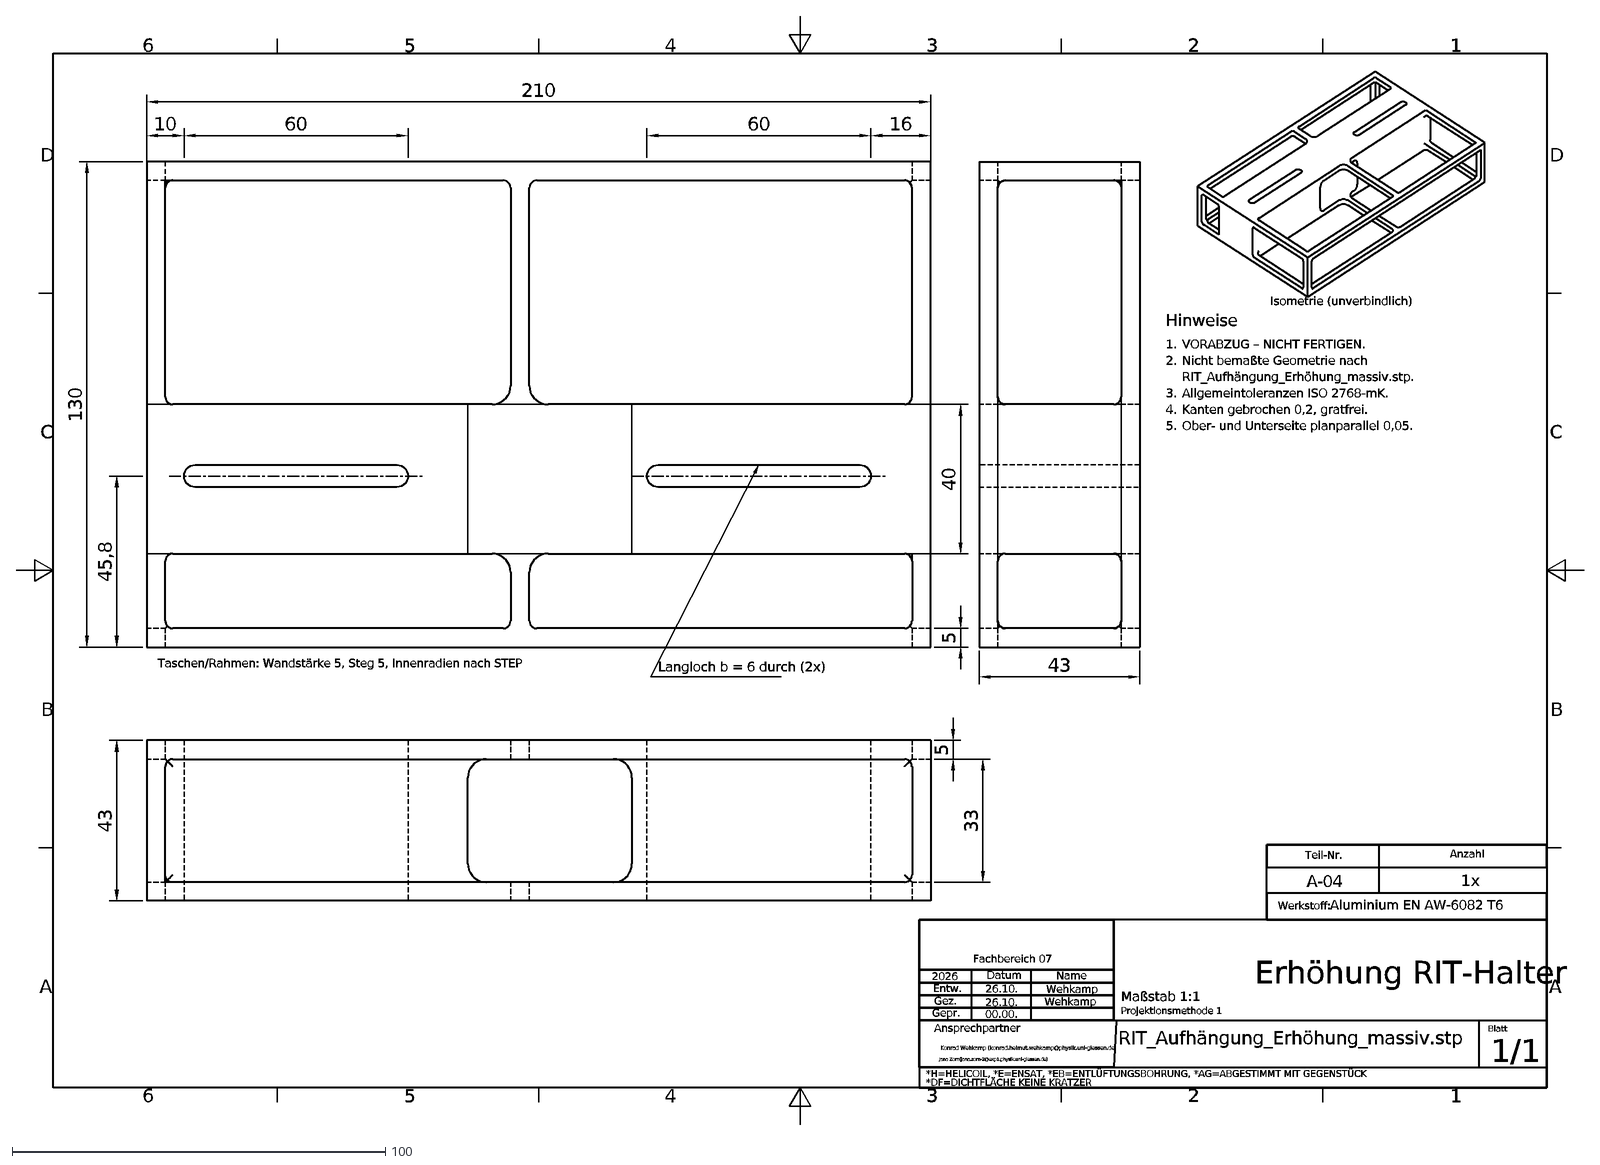
[picture p28: CAD file, 2026-10-27]
CAD/RF-Neutralisator/RFN_Zeichnungen/Zeichnungen_v10/Zeichnungen_v10/Aufhaengung/A-04_Erhoehung.dxf
D
C
B
A
6
5
4
3
2
1
Wehkamp
00.00.
26.10.
1x
Aluminium EN AW-6082 T6
A-04
Erhöhung RIT-Halter
2026
RIT_Aufhängung_Erhöhung_massiv.stp
1/1
Werkstoff:
Anzahl
Jana Zorn(jana.zorn-2@exp1.physik.uni-giessen.de)
Konrad Wehkamp (konrad.helmut.wehkamp@physik.uni-giessen.de
Ansprechpartner
*DF=DICHTFLÄCHE KEINE KRATZER
*H=HELICOIL, *E=ENSAT, *EB=ENTLÜFTUNGSBOHRUNG, *AG=ABGESTIMMT MIT GEGENSTÜCK
Gepr.
Gez.
Entw.
Name
Datum
Fachbereich 07
Blatt
Teil-Nr.
Maßstab 1:1
Projektionsmethode 1
210
16
60
10
130
45,8
40
Langloch b = 6 durch (2x)
Taschen/Rahmen: Wandstärke 5, Steg 5, Innenradien nach STEP
43
33
Isometrie (unverbindlich)
Hinweise
1.
VORABZUG – NICHT FERTIGEN.
2.
Nicht bemaßte Geometrie nach
RIT_Aufhängung_Erhöhung_massiv.stp.
3.
Allgemeintoleranzen ISO 2768-mK.
4.
Kanten gebrochen 0,2, gratfrei.
5.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
