konradweh/ABEP_Koppeltest/CAD/RF-Neutralisator/RFN_Zeichnungen/Zeichnungen_v10/Zeichnungen_v10/RFN/Spulenstaebe.dxf

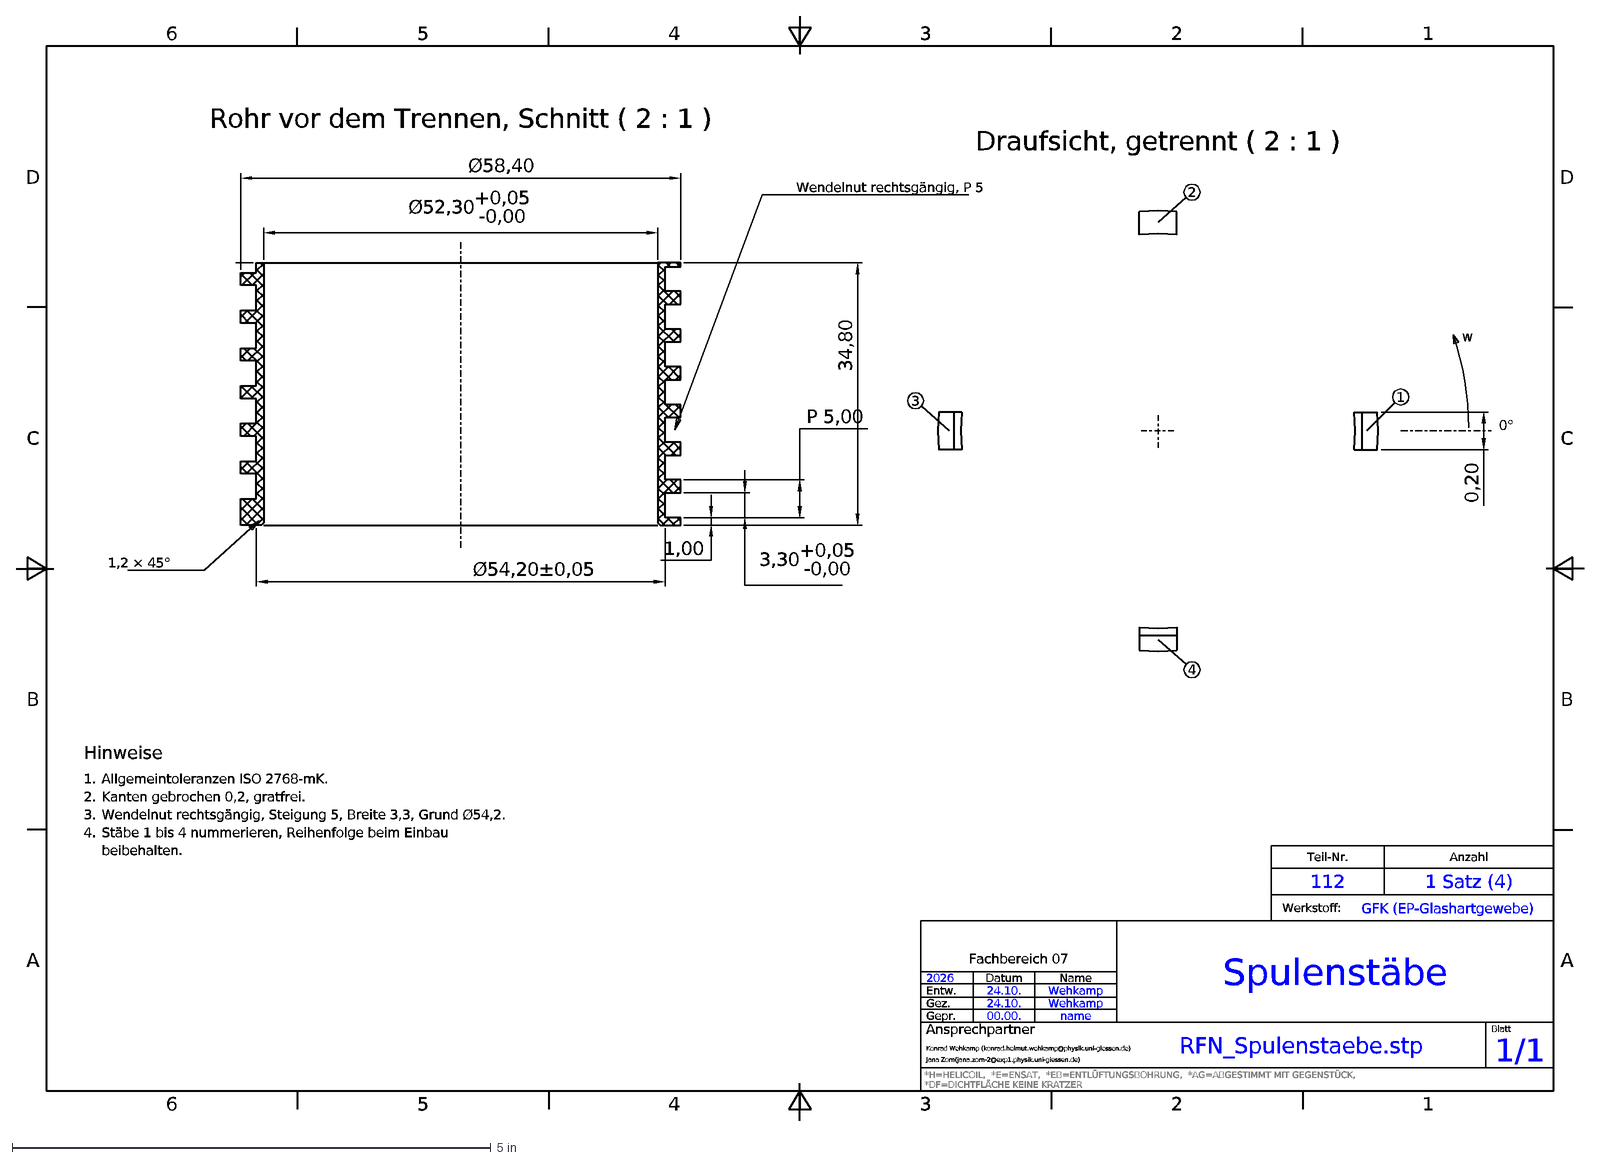
[picture p29: CAD file, 2026-10-27]
CAD/RF-Neutralisator/RFN_Zeichnungen/Zeichnungen_v10/Zeichnungen_v10/RFN/Spulenstaebe.dxf
A
B
C
D
6
5
4
3
2
1
Teil-Nr.
Anzahl
Werkstoff:
*DF=DICHTFLÄCHE KEINE KRATZER
Ansprechpartner
Blatt
*H=HELICOIL, *E=ENSAT, *EB=ENTLÜFTUNGSBOHRUNG, *AG=ABGESTIMMT MIT GEGENSTÜCK,
Fachbereich 07
1/1
Rohr vor dem Trennen, Schnitt ( 2 : 1 )
RFN_Spulenstaebe.stp
Spulenstäbe
Jana Zorn(jana.zorn-2@exp1.physik.uni-giessen.de)
Konrad Wehkamp (konrad.helmut.wehkamp@physik.uni-giessen.de)
name
Gepr.
Wehkamp
Draufsicht, getrennt ( 2 : 1 )
Name
24.10.
Datum
2026
GFK (EP-Glashartgewebe)
1 Satz (4)
112
1,2 × 45°
Gez.
Wendelnut rechtsgängig, P 5
0°
Entw.
00.00.
w
34,80
P 5,00
3,30+0,05^-0,00
1,00
Ø54,20±0,05
Ø58,40
Ø52,30+0,05^-0,00
0,20
Hinweise
1.
Allgemeintoleranzen ISO 2768-mK.
2.
Kanten gebrochen 0,2, gratfrei.
3.
Wendelnut rechtsgängig, Steigung 5, Breite 3,3, Grund Ø54,2.
4.
Stäbe 1 bis 4 nummerieren, Reihenfolge beim Einbau
beibehalten.
