konradweh/ABEP_Koppeltest/CAD/Zeichnungen_v10/Zeichnungen_v10/RFN/Federscheibe.dxf

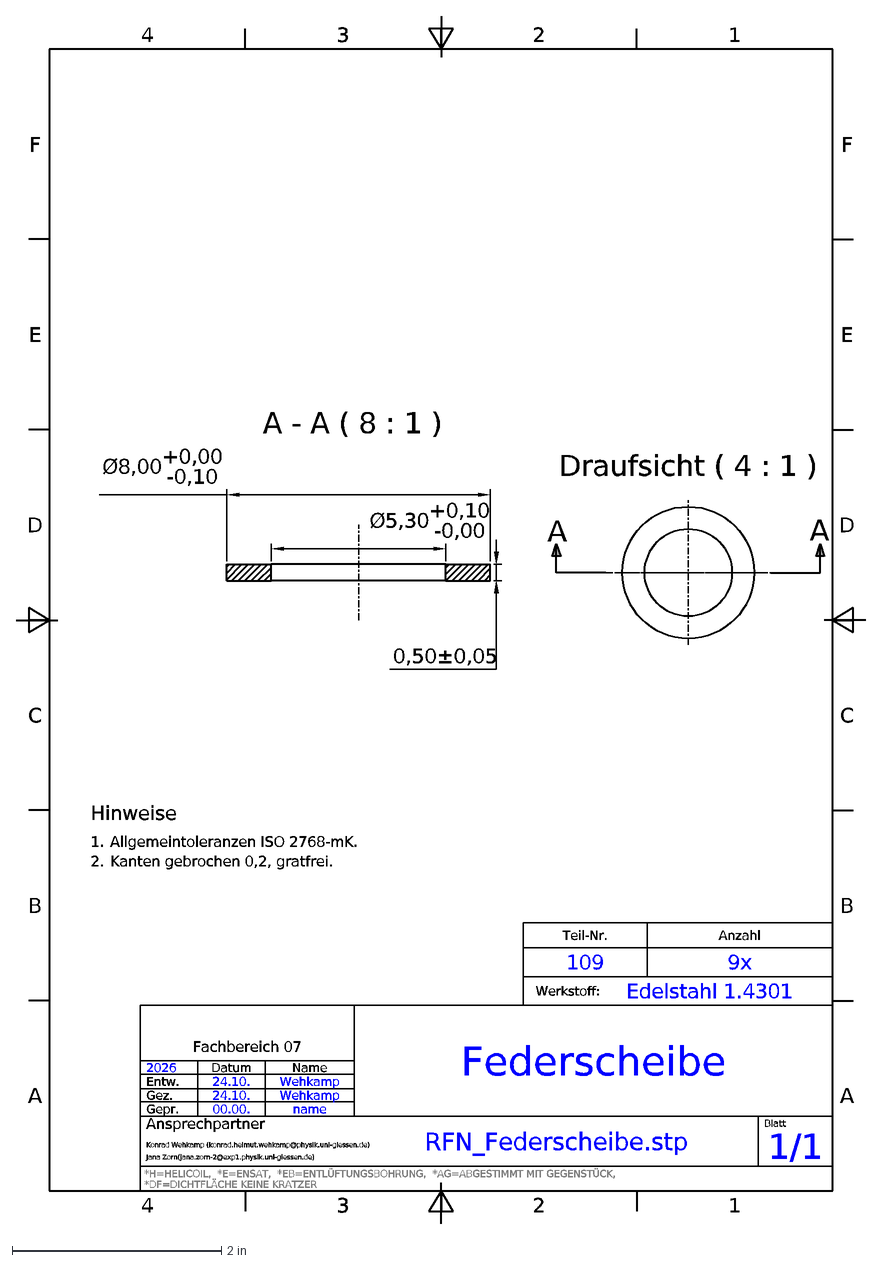
[picture p30: CAD file, 2026-10-27]
CAD/Zeichnungen_v10/Zeichnungen_v10/RFN/Federscheibe.dxf
4
3
2
1
A
B
C
D
E
F
Fachbereich 07
Blatt
*H=HELICOIL, *E=ENSAT, *EB=ENTLÜFTUNGSBOHRUNG, *AG=ABGESTIMMT MIT GEGENSTÜCK,
Teil-Nr.
*DF=DICHTFLÄCHE KEINE KRATZER
Werkstoff:
Anzahl
Ansprechpartner
109
9x
Edelstahl 1.4301
2026
Datum
Name
A - A ( 8 : 1 )
RFN_Federscheibe.stp
Federscheibe
Jana Zorn(jana.zorn-2@exp1.physik.uni-giessen.de)
Wehkamp
1/1
Konrad Wehkamp (konrad.helmut.wehkamp@physik.uni-giessen.de)
name
Draufsicht ( 4 : 1 )
00.00.
Gepr.
24.10.
Gez.
Entw.
0,50±0,05
Ø5,30+0,10^-0,00
Ø8,00+0,00^-0,10
Hinweise
1.
Allgemeintoleranzen ISO 2768-mK.
2.
Kanten gebrochen 0,2, gratfrei.
