konradweh/ABEP_Koppeltest/CAD/RF-Neutralisator/RFN_Zeichnungen/DXF/109_Federscheibe.dxf

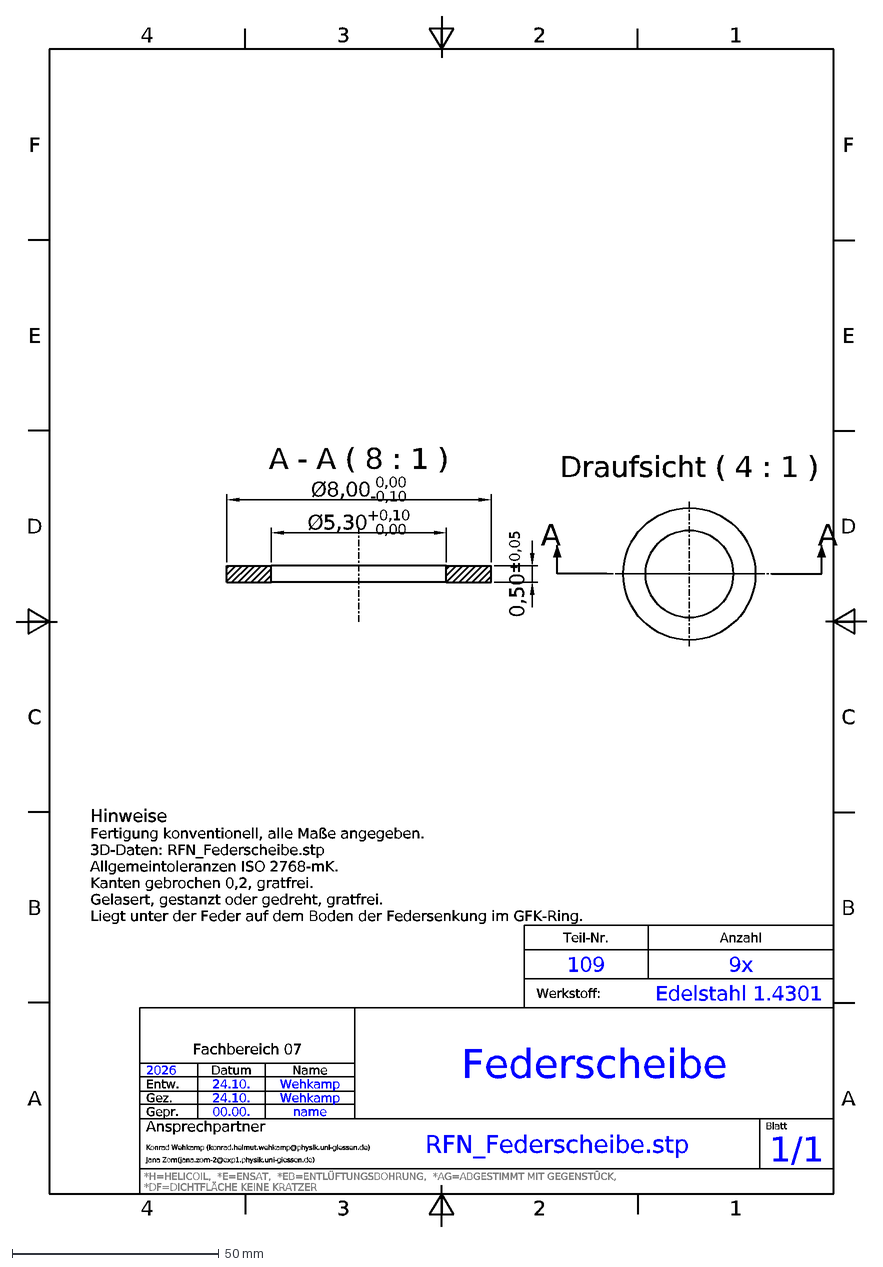
[picture p31: CAD file, 2026-10-25]
CAD/RF-Neutralisator/RFN_Zeichnungen/DXF/109_Federscheibe.dxf
4
3
2
1
A
B
C
D
E
F
Teil-Nr.
Anzahl
109
9x
Werkstoff:
Edelstahl 1.4301
Fachbereich 07
2026
Datum
Name
Entw.
24.10.
Wehkamp
Gez.
Gepr.
00.00.
name
Ansprechpartner
Konrad Wehkamp (konrad.helmut.wehkamp@physik.uni-giessen.de)
Jana Zorn(jana.zorn-2@exp1.physik.uni-giessen.de)
Federscheibe
RFN_Federscheibe.stp
Blatt
1/1
*H=HELICOIL, *E=ENSAT, *EB=ENTLÜFTUNGSBOHRUNG, *AG=ABGESTIMMT MIT GEGENSTÜCK,
*DF=DICHTFLÄCHE KEINE KRATZER
A - A ( 8 : 1 )
Ø8,00 0,00^-0,10
Ø5,30+0,10^ 0,00
0,50±0,05
Draufsicht ( 4 : 1 )
Hinweise
Fertigung konventionell, alle Maße angegeben.
3D-Daten: RFN_Federscheibe.stp
Allgemeintoleranzen ISO 2768-mK.
Kanten gebrochen 0,2, gratfrei.
Gelasert, gestanzt oder gedreht, gratfrei.
Liegt unter der Feder auf dem Boden der Federsenkung im GFK-Ring.
