konradweh/ABEP_Koppeltest/CAD/RF-Neutralisator/RFN_Zeichnungen/DXF_2/Abdeckblech.dxf

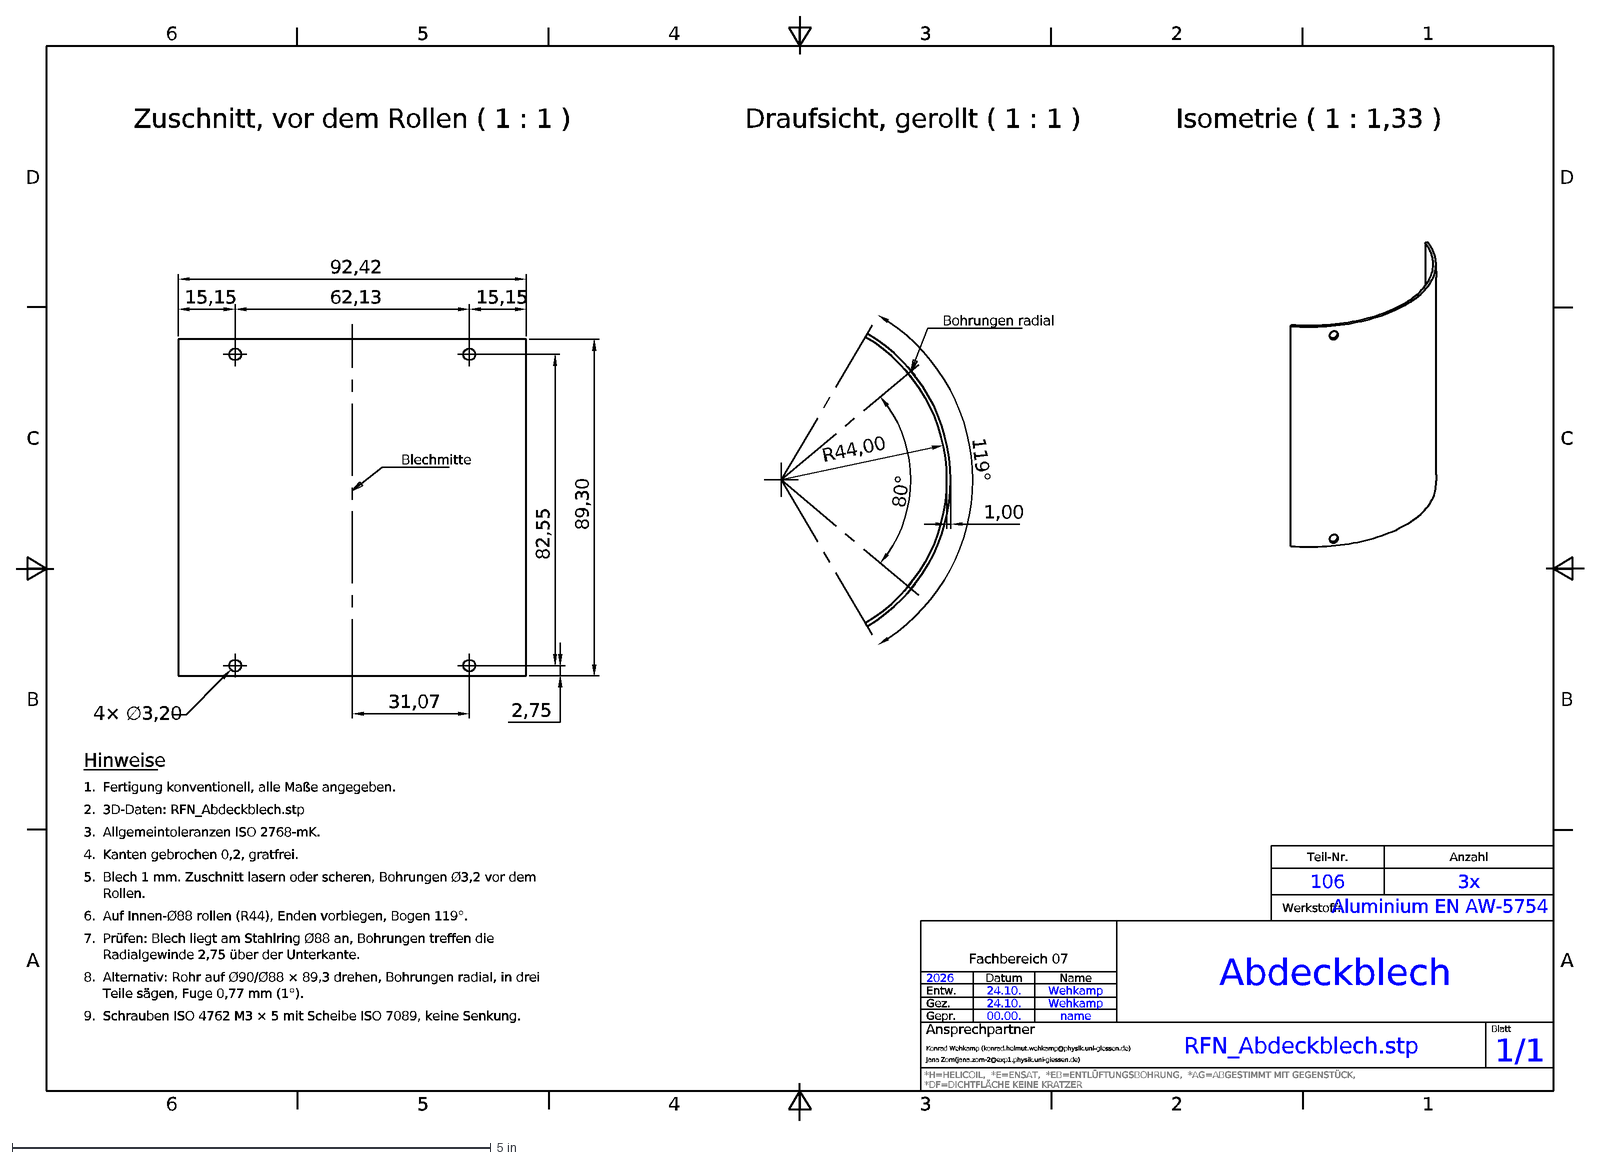
[picture p32: CAD file, 2026-10-27]
CAD/RF-Neutralisator/RFN_Zeichnungen/DXF_2/Abdeckblech.dxf
A
B
C
D
6
5
4
3
2
1
Ansprechpartner
Fachbereich 07
Blatt
*H=HELICOIL, *E=ENSAT, *EB=ENTLÜFTUNGSBOHRUNG, *AG=ABGESTIMMT MIT GEGENSTÜCK,
*DF=DICHTFLÄCHE KEINE KRATZER
Teil-Nr.
Anzahl
Werkstoff:
106
3x
Aluminium EN AW-5754
2026
Datum
Name
Entw.
24.10.
Wehkamp
Gez.
Bohrungen radial
Draufsicht, gerollt ( 1 : 1 )
Blechmitte
Zuschnitt, vor dem Rollen ( 1 : 1 )
1/1
RFN_Abdeckblech.stp
Abdeckblech
Jana Zorn(jana.zorn-2@exp1.physik.uni-giessen.de)
Konrad Wehkamp (konrad.helmut.wehkamp@physik.uni-giessen.de)
name
00.00.
Gepr.
Isometrie ( 1 : 1,33 )
92,42
15,15
62,13
1,00
80°
119°
R44,00
89,30
2,75
82,55
31,07
4× ∅3,20
Hinweise
1.
Fertigung konventionell, alle Maße angegeben.
2.
3D-Daten: RFN_Abdeckblech.stp
3.
Allgemeintoleranzen ISO 2768-mK.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
