konradweh/ABEP_Koppeltest/CAD/RF-Neutralisator/RFN_Zeichnungen/Zeichnungen_v10/Zeichnungen_v10/Aufhaengung/A-01_Unterteil.dxf

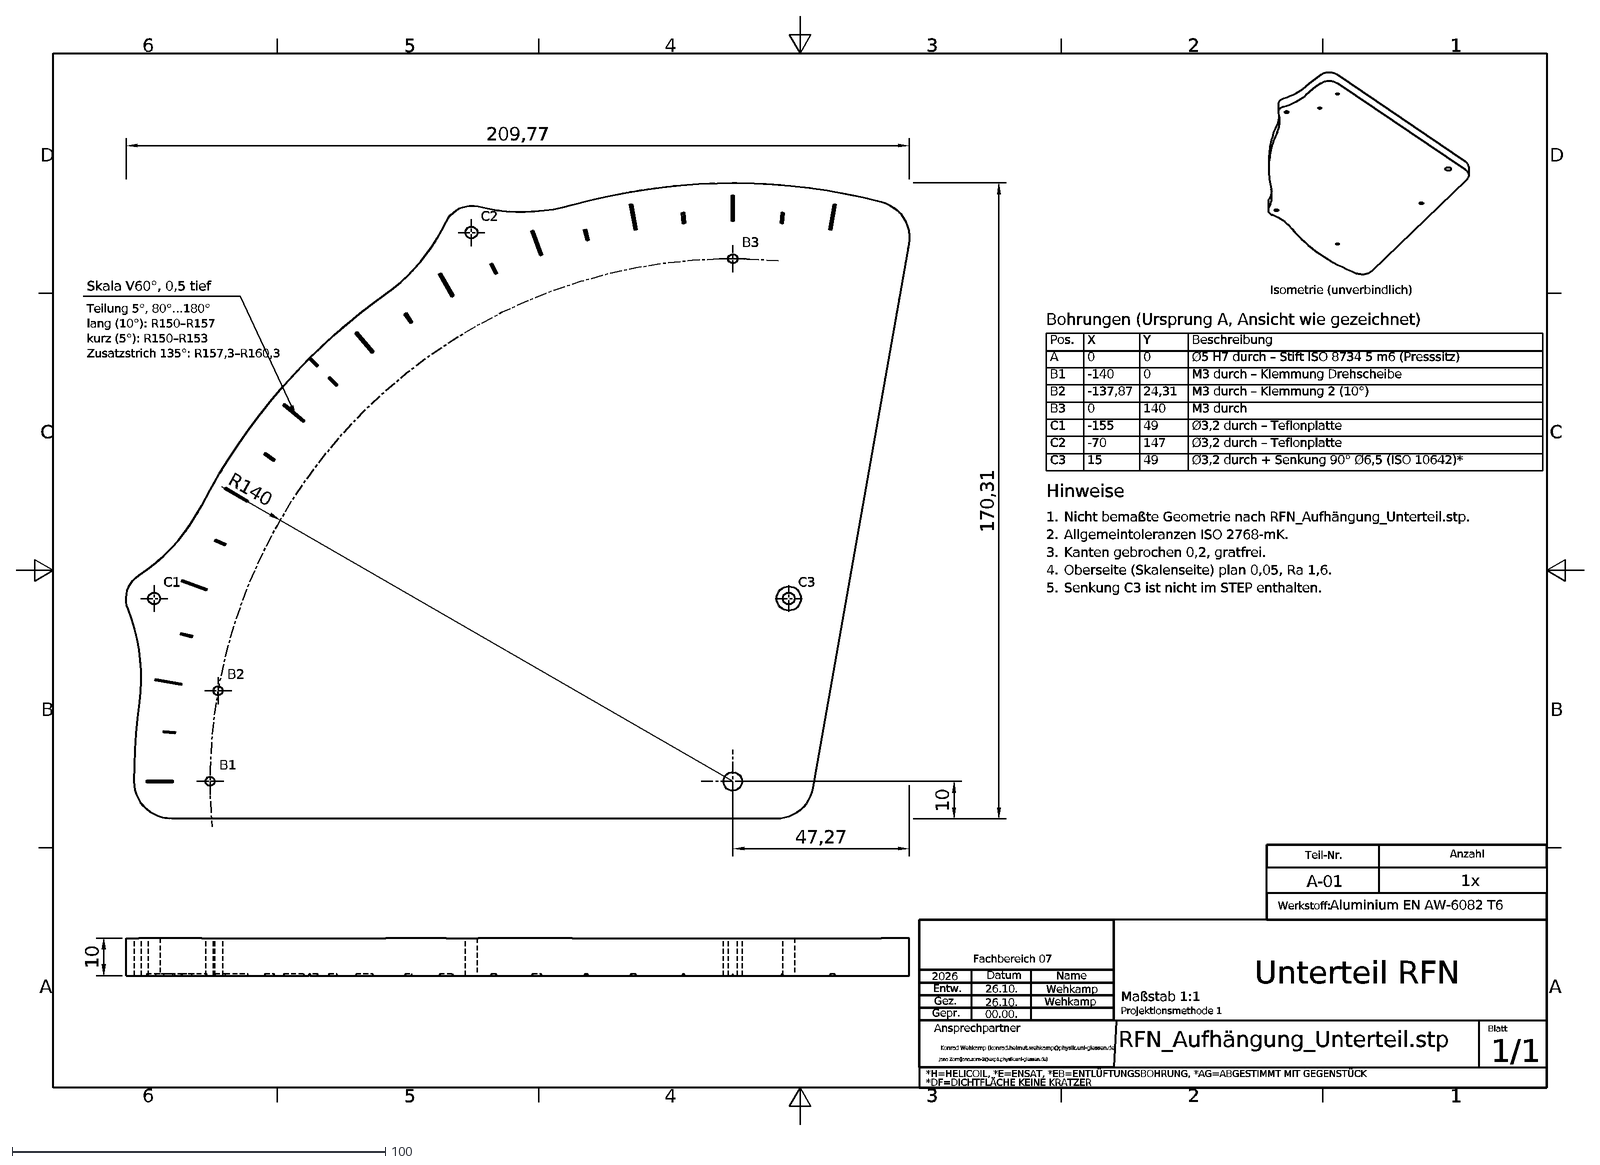
[picture p33: CAD file, 2026-10-27]
CAD/RF-Neutralisator/RFN_Zeichnungen/Zeichnungen_v10/Zeichnungen_v10/Aufhaengung/A-01_Unterteil.dxf
D
C
B
A
6
5
4
3
2
1
Wehkamp
00.00.
26.10.
1x
Aluminium EN AW-6082 T6
A-01
Unterteil RFN
2026
RFN_Aufhängung_Unterteil.stp
1/1
Werkstoff:
Anzahl
Jana Zorn(jana.zorn-2@exp1.physik.uni-giessen.de)
Konrad Wehkamp (konrad.helmut.wehkamp@physik.uni-giessen.de
Ansprechpartner
*DF=DICHTFLÄCHE KEINE KRATZER
*H=HELICOIL, *E=ENSAT, *EB=ENTLÜFTUNGSBOHRUNG, *AG=ABGESTIMMT MIT GEGENSTÜCK
Gepr.
Gez.
Entw.
Name
Datum
Fachbereich 07
Blatt
Teil-Nr.
Maßstab 1:1
Projektionsmethode 1
B1
B2
B3
C1
C2
C3
209,77
170,31
47,27
10
R140
Skala V60°, 0,5 tief
Teilung 5°, 80°…180°
lang (10°): R150–R157
kurz (5°): R150–R153
Zusatzstrich 135°: R157,3–R160,3
Isometrie (unverbindlich)
Bohrungen (Ursprung A, Ansicht wie gezeichnet)
Pos.
X
Y
Beschreibung
0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
