konradweh/ABEP_Koppeltest/CAD/RF-Neutralisator/RFN_Zeichnungen/DXF/108_Distanzhuelse.dxf

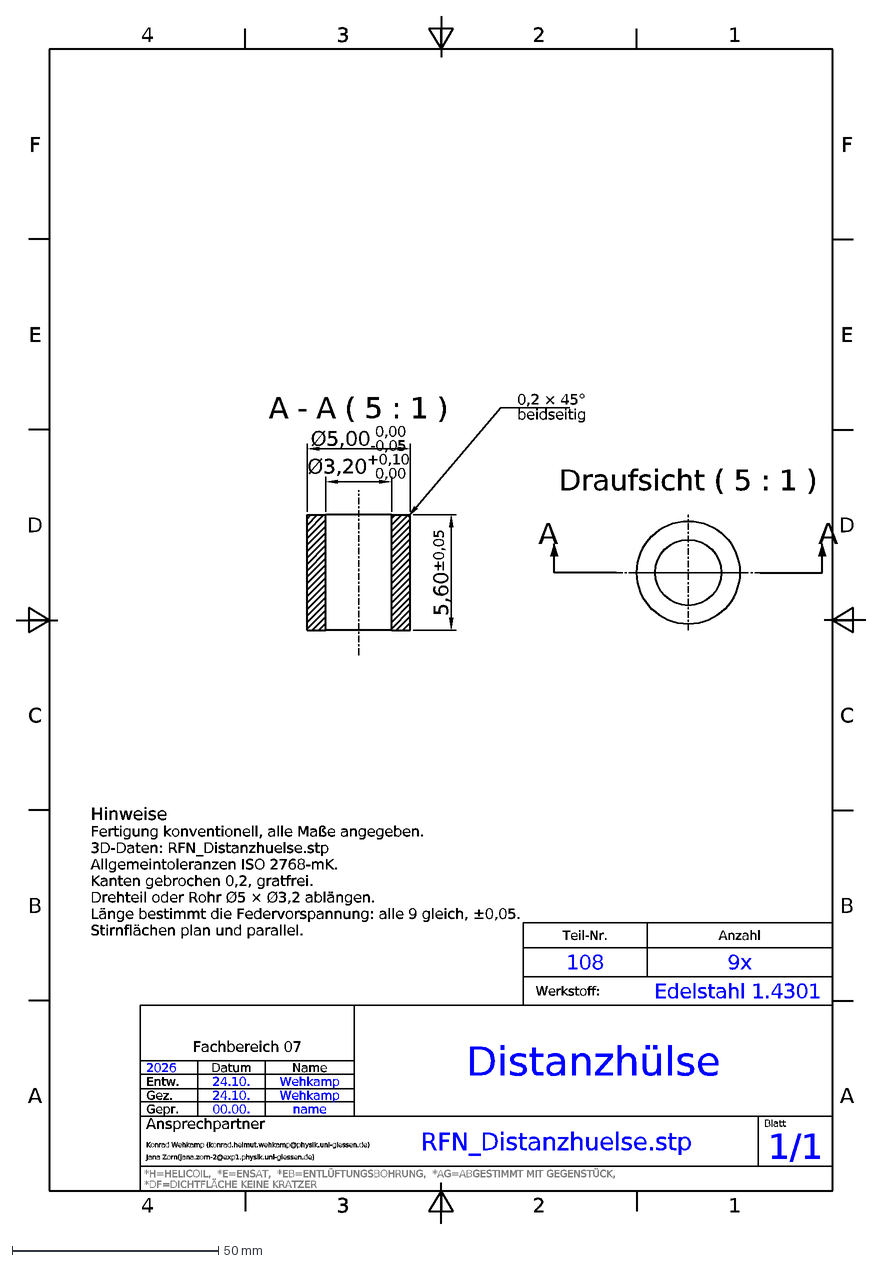
[picture p35: CAD file, 2026-10-25]
CAD/RF-Neutralisator/RFN_Zeichnungen/DXF/108_Distanzhuelse.dxf
4
3
2
1
A
B
C
D
E
F
Teil-Nr.
Anzahl
108
9x
Werkstoff:
Edelstahl 1.4301
Fachbereich 07
2026
Datum
Name
Entw.
24.10.
Wehkamp
Gez.
Gepr.
00.00.
name
Ansprechpartner
Konrad Wehkamp (konrad.helmut.wehkamp@physik.uni-giessen.de)
Jana Zorn(jana.zorn-2@exp1.physik.uni-giessen.de)
Distanzhülse
RFN_Distanzhuelse.stp
Blatt
1/1
*H=HELICOIL, *E=ENSAT, *EB=ENTLÜFTUNGSBOHRUNG, *AG=ABGESTIMMT MIT GEGENSTÜCK,
*DF=DICHTFLÄCHE KEINE KRATZER
A - A ( 5 : 1 )
Ø5,00 0,00^-0,05
Ø3,20+0,10^ 0,00
5,60±0,05
Draufsicht ( 5 : 1 )
0,2 × 45°
beidseitig
Hinweise
Fertigung konventionell, alle Maße angegeben.
3D-Daten: RFN_Distanzhuelse.stp
Allgemeintoleranzen ISO 2768-mK.
Kanten gebrochen 0,2, gratfrei.
Drehteil oder Rohr Ø5 × Ø3,2 ablängen.
Länge bestimmt die Federvorspannung: alle 9 gleich, ±0,05.
Stirnflächen plan und parallel.
