konradweh/ABEP_Koppeltest/CAD/RF-Neutralisator/RFN_Zeichnungen/DXF_2/Klemmring.dxf

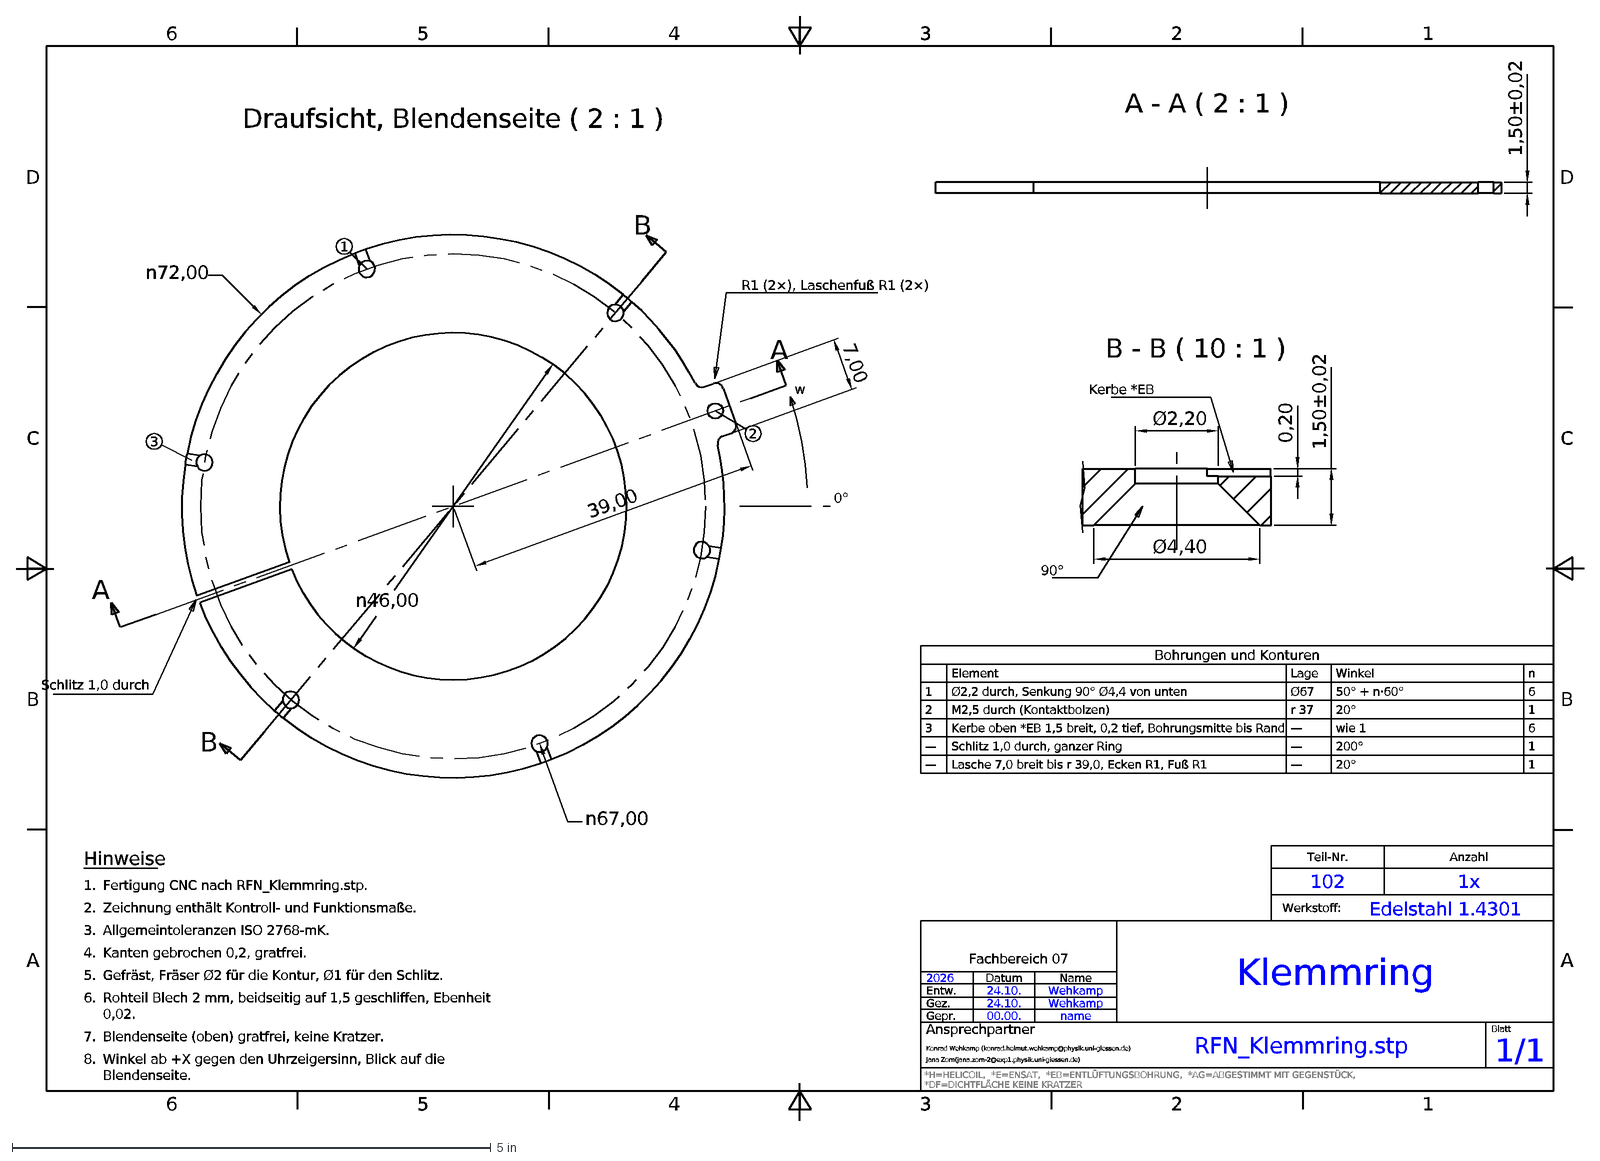
[picture p36: CAD file, 2026-10-27]
CAD/RF-Neutralisator/RFN_Zeichnungen/DXF_2/Klemmring.dxf
5
4
3
2
1
A
B
C
D
6
*H=HELICOIL, *E=ENSAT, *EB=ENTLÜFTUNGSBOHRUNG, *AG=ABGESTIMMT MIT GEGENSTÜCK,
*DF=DICHTFLÄCHE KEINE KRATZER
Werkstoff:
Anzahl
Teil-Nr.
Fachbereich 07
Ansprechpartner
Blatt
102
1x
Edelstahl 1.4301
2026
Datum
Name
A - A ( 2 : 1 )
0°
w
B - B ( 10 : 1 )
Schlitz 1,0 durch
R1 (2×), Laschenfuß R1 (2×)
90°
24.10.
Kerbe *EB
Bohrungen und Konturen
Element
Lage
Winkel
n
Ø2,2 durch, Senkung 90° Ø4,4 von unten
Ø67
50° + n·60°
M2,5 durch (Kontaktbolzen)
r 37
20°
Kerbe oben *EB 1,5 breit, 0,2 tief, Bohrungsmitte bis Rand
—
wie 1
Schlitz 1,0 durch, ganzer Ring
200°
Lasche 7,0 breit bis r 39,0, Ecken R1, Fuß R1
Draufsicht, Blendenseite ( 2 : 1 )
1/1
RFN_Klemmring.stp
Klemmring
Jana Zorn(jana.zorn-2@exp1.physik.uni-giessen.de)
Konrad Wehkamp (konrad.helmut.wehkamp@physik.uni-giessen.de)
name
00.00.
Gepr.
Wehkamp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
