konradweh/ABEP_Koppeltest/CAD/RF-Neutralisator/RFN_Zeichnungen/Zeichnungen_v10/Zeichnungen_v10/Aufhaengung/A-03_Front.dxf

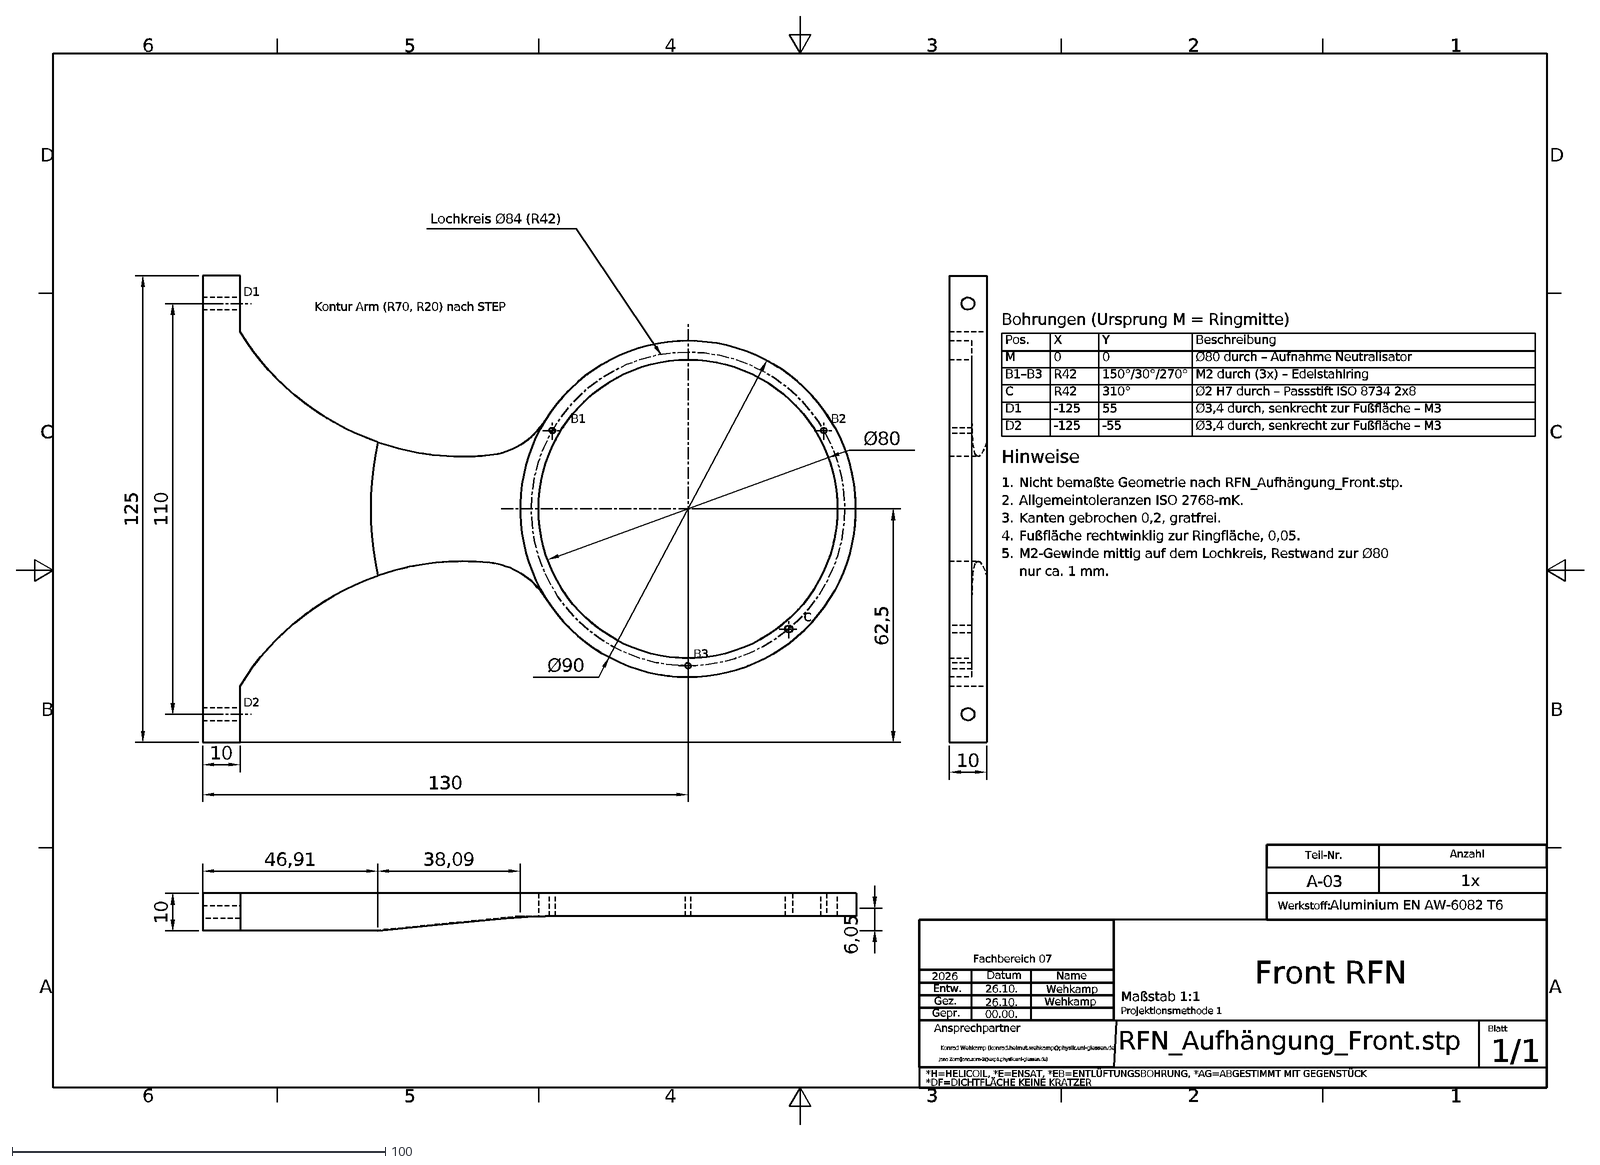
[picture p37: CAD file, 2026-10-27]
CAD/RF-Neutralisator/RFN_Zeichnungen/Zeichnungen_v10/Zeichnungen_v10/Aufhaengung/A-03_Front.dxf
D
C
B
A
6
5
4
3
2
1
Wehkamp
00.00.
26.10.
1x
Aluminium EN AW-6082 T6
A-03
Front RFN
2026
RFN_Aufhängung_Front.stp
1/1
Werkstoff:
Anzahl
Jana Zorn(jana.zorn-2@exp1.physik.uni-giessen.de)
Konrad Wehkamp (konrad.helmut.wehkamp@physik.uni-giessen.de
Ansprechpartner
*DF=DICHTFLÄCHE KEINE KRATZER
*H=HELICOIL, *E=ENSAT, *EB=ENTLÜFTUNGSBOHRUNG, *AG=ABGESTIMMT MIT GEGENSTÜCK
Gepr.
Gez.
Entw.
Name
Datum
Fachbereich 07
Blatt
Teil-Nr.
Maßstab 1:1
Projektionsmethode 1
B1
B2
B3
D1
D2
Ø80
Ø90
130
10
125
110
62,5
Lochkreis Ø84 (R42)
Kontur Arm (R70, R20) nach STEP
6,05
46,91
38,09
Bohrungen (Ursprung M = Ringmitte)
Pos.
X
Y
Beschreibung
M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
