konradweh/ABEP_Koppeltest/CAD/Zeichnungen_v10/Zeichnungen_v10/RFN/Distanzhuelse.dxf

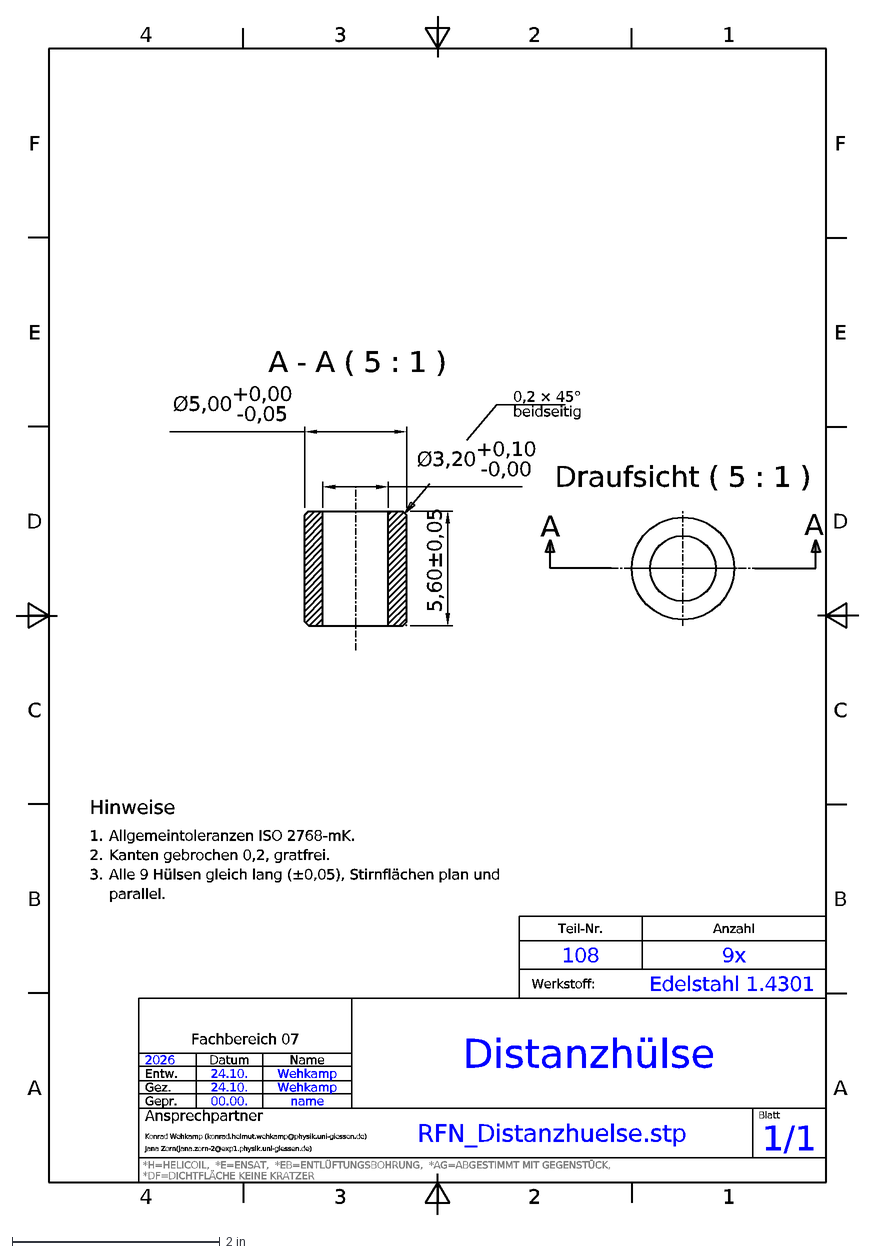
[picture p39: CAD file, 2026-10-27]
CAD/Zeichnungen_v10/Zeichnungen_v10/RFN/Distanzhuelse.dxf
4
3
2
1
A
B
C
D
E
F
Fachbereich 07
*H=HELICOIL, *E=ENSAT, *EB=ENTLÜFTUNGSBOHRUNG, *AG=ABGESTIMMT MIT GEGENSTÜCK,
Teil-Nr.
Werkstoff:
*DF=DICHTFLÄCHE KEINE KRATZER
Anzahl
Ansprechpartner
Blatt
108
9x
Edelstahl 1.4301
2026
A - A ( 5 : 1 )
RFN_Distanzhuelse.stp
Distanzhülse
Jana Zorn(jana.zorn-2@exp1.physik.uni-giessen.de)
Wehkamp
1/1
Konrad Wehkamp (konrad.helmut.wehkamp@physik.uni-giessen.de)
name
Draufsicht ( 5 : 1 )
00.00.
Gepr.
24.10.
Gez.
Entw.
Name
0,2 × 45°
beidseitig
Datum
Ø5,00+0,00^-0,05
Ø3,20+0,10^-0,00
5,60±0,05
Hinweise
1.
Allgemeintoleranzen ISO 2768-mK.
2.
Kanten gebrochen 0,2, gratfrei.
3.
Alle 9 Hülsen gleich lang (±0,05), Stirnflächen plan und
parallel.
