konradweh/ABEP_Koppeltest/CAD/RF-Neutralisator/RFN_Zeichnungen/DXF/112_Spulenstaebe.dxf

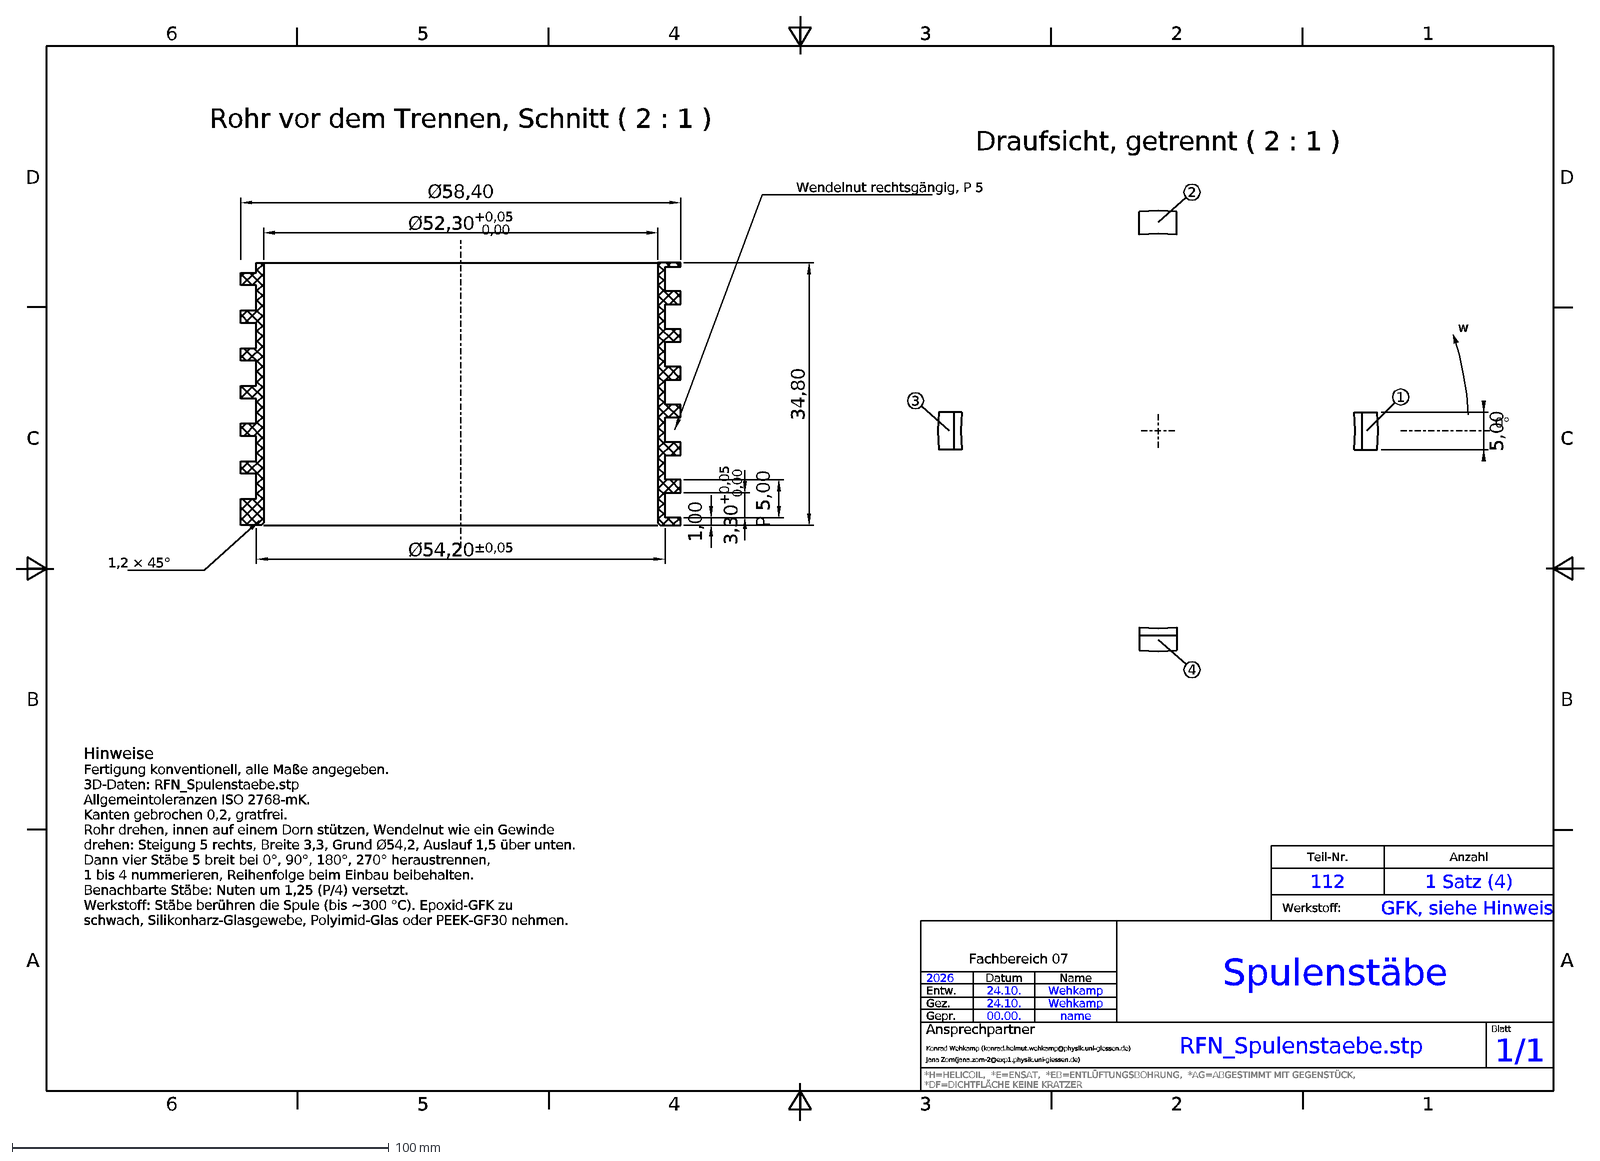
[picture p40: CAD file, 2026-10-25]
CAD/RF-Neutralisator/RFN_Zeichnungen/DXF/112_Spulenstaebe.dxf
6
5
4
3
2
1
A
B
C
D
Teil-Nr.
Anzahl
112
1 Satz (4)
Werkstoff:
GFK, siehe Hinweis
Fachbereich 07
2026
Datum
Name
Entw.
24.10.
Wehkamp
Gez.
Gepr.
00.00.
name
Ansprechpartner
Konrad Wehkamp (konrad.helmut.wehkamp@physik.uni-giessen.de)
Jana Zorn(jana.zorn-2@exp1.physik.uni-giessen.de)
Spulenstäbe
RFN_Spulenstaebe.stp
Blatt
1/1
*H=HELICOIL, *E=ENSAT, *EB=ENTLÜFTUNGSBOHRUNG, *AG=ABGESTIMMT MIT GEGENSTÜCK,
*DF=DICHTFLÄCHE KEINE KRATZER
Rohr vor dem Trennen, Schnitt ( 2 : 1 )
Ø52,30+0,05^ 0,00
Ø58,40
Ø54,20±0,05
34,80
1,00
3,30+0,05^ 0,00
P 5,00
1,2 × 45°
Wendelnut rechtsgängig, P 5
Draufsicht, getrennt ( 2 : 1 )
5,00
0°
w
Hinweise
Fertigung konventionell, alle Maße angegeben.
3D-Daten: RFN_Spulenstaebe.stp
Allgemeintoleranzen ISO 2768-mK.
Kanten gebrochen 0,2, gratfrei.
Rohr drehen, innen auf einem Dorn stützen, Wendelnut wie ein Gewinde
drehen: Steigung 5 rechts, Breite 3,3, Grund Ø54,2, Auslauf 1,5 über unten.
Dann vier Stäbe 5 breit bei 0°, 90°, 180°, 270° heraustrennen,
1 bis 4 nummerieren, Reihenfolge beim Einbau beibehalten.
Benachbarte Stäbe: Nuten um 1,25 (P/4) versetzt.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
