konradweh/ABEP_Koppeltest/CAD/RF-Neutralisator/RFN_Zeichnungen/DXF_2/Deckel.dxf

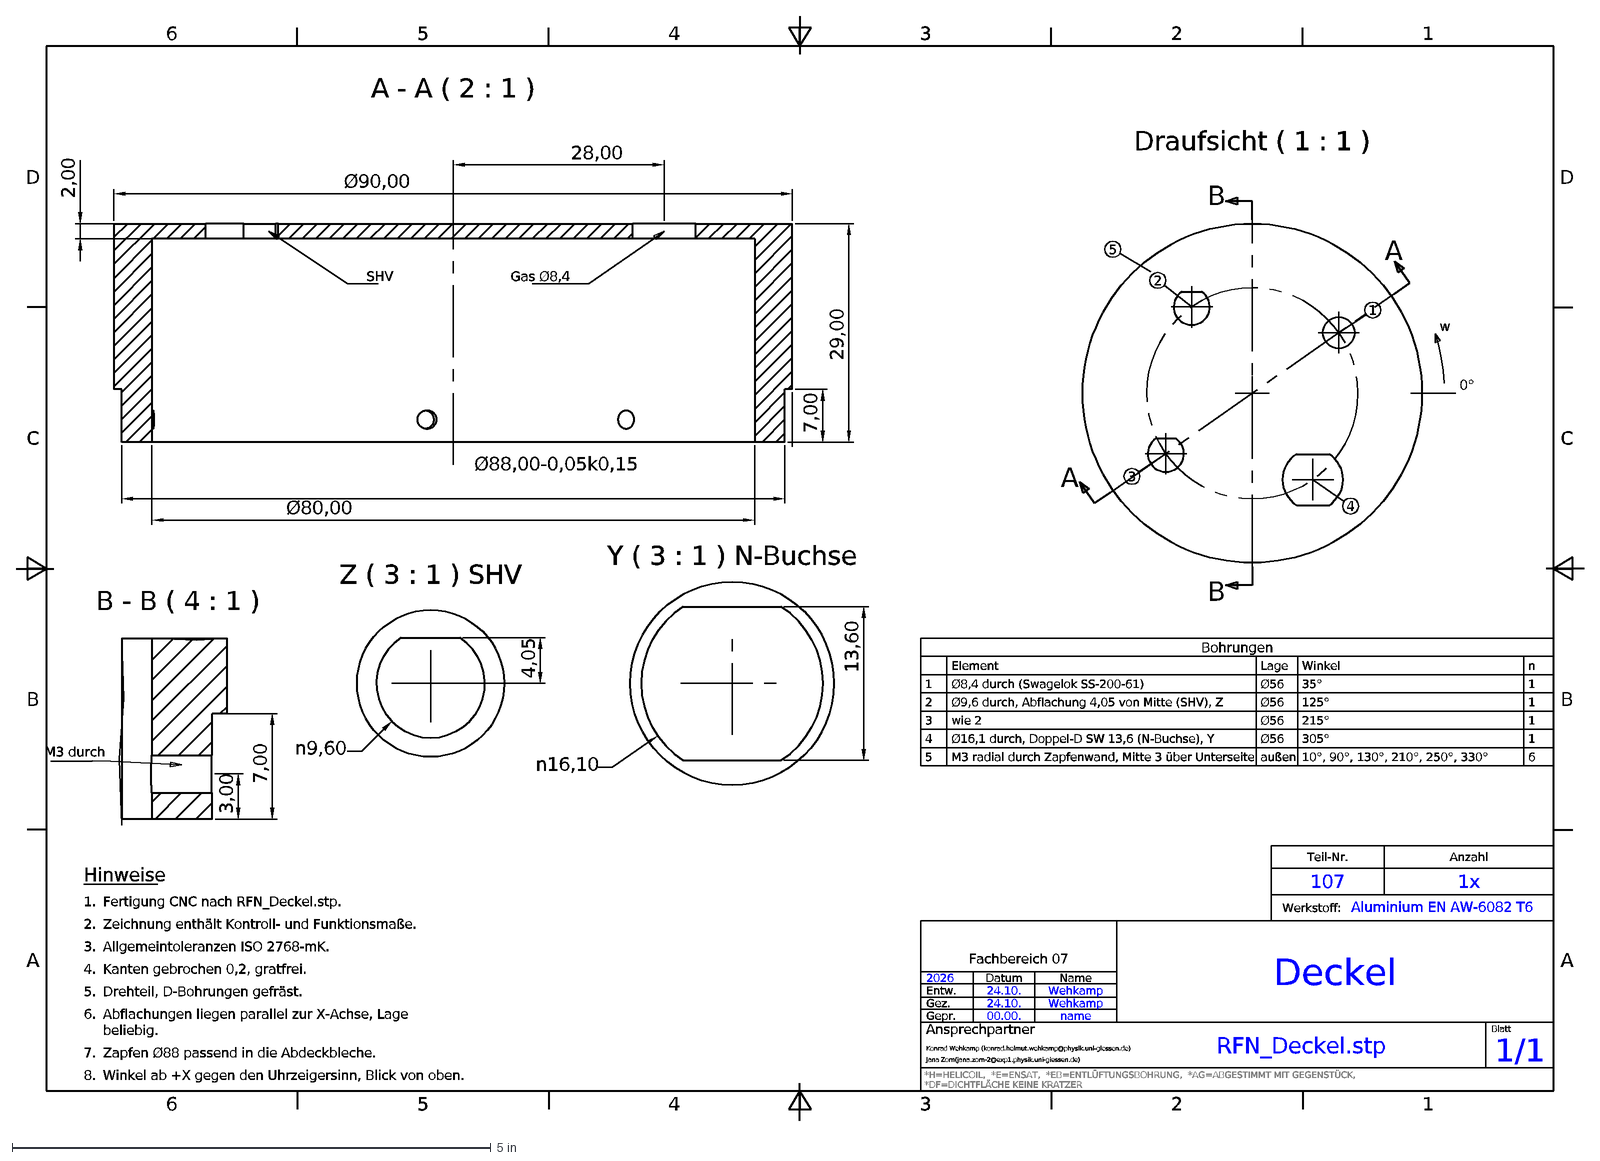
[picture p41: CAD file, 2026-10-27]
CAD/RF-Neutralisator/RFN_Zeichnungen/DXF_2/Deckel.dxf
A
B
C
D
3
6
5
4
2
1
Anzahl
Teil-Nr.
Fachbereich 07
Ansprechpartner
Blatt
*H=HELICOIL, *E=ENSAT, *EB=ENTLÜFTUNGSBOHRUNG, *AG=ABGESTIMMT MIT GEGENSTÜCK,
*DF=DICHTFLÄCHE KEINE KRATZER
Werkstoff:
24.10.
Y ( 3 : 1 ) N-Buchse
Entw.
Name
Datum
2026
Aluminium EN AW-6082 T6
1x
107
Gez.
SHV
B - B ( 4 : 1 )
0°
Wehkamp
M3 durch
w
Bohrungen
Element
Lage
Winkel
n
Ø8,4 durch (Swagelok SS-200-61)
Ø56
35°
Ø9,6 durch, Abflachung 4,05 von Mitte (SHV), Z
125°
wie 2
215°
Ø16,1 durch, Doppel-D SW 13,6 (N-Buchse), Y
305°
M3 radial durch Zapfenwand, Mitte 3 über Unterseite
außen
10°, 90°, 130°, 210°, 250°, 330°
1/1
A - A ( 2 : 1 )
RFN_Deckel.stp
Deckel
Jana Zorn(jana.zorn-2@exp1.physik.uni-giessen.de)
Z ( 3 : 1 ) SHV
Konrad Wehkamp (konrad.helmut.wehkamp@physik.uni-giessen.de)
name
00.00.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
