konradweh/ABEP_Koppeltest/CAD/RF-Neutralisator/RFN_Zeichnungen/DXF/107_Deckel.dxf

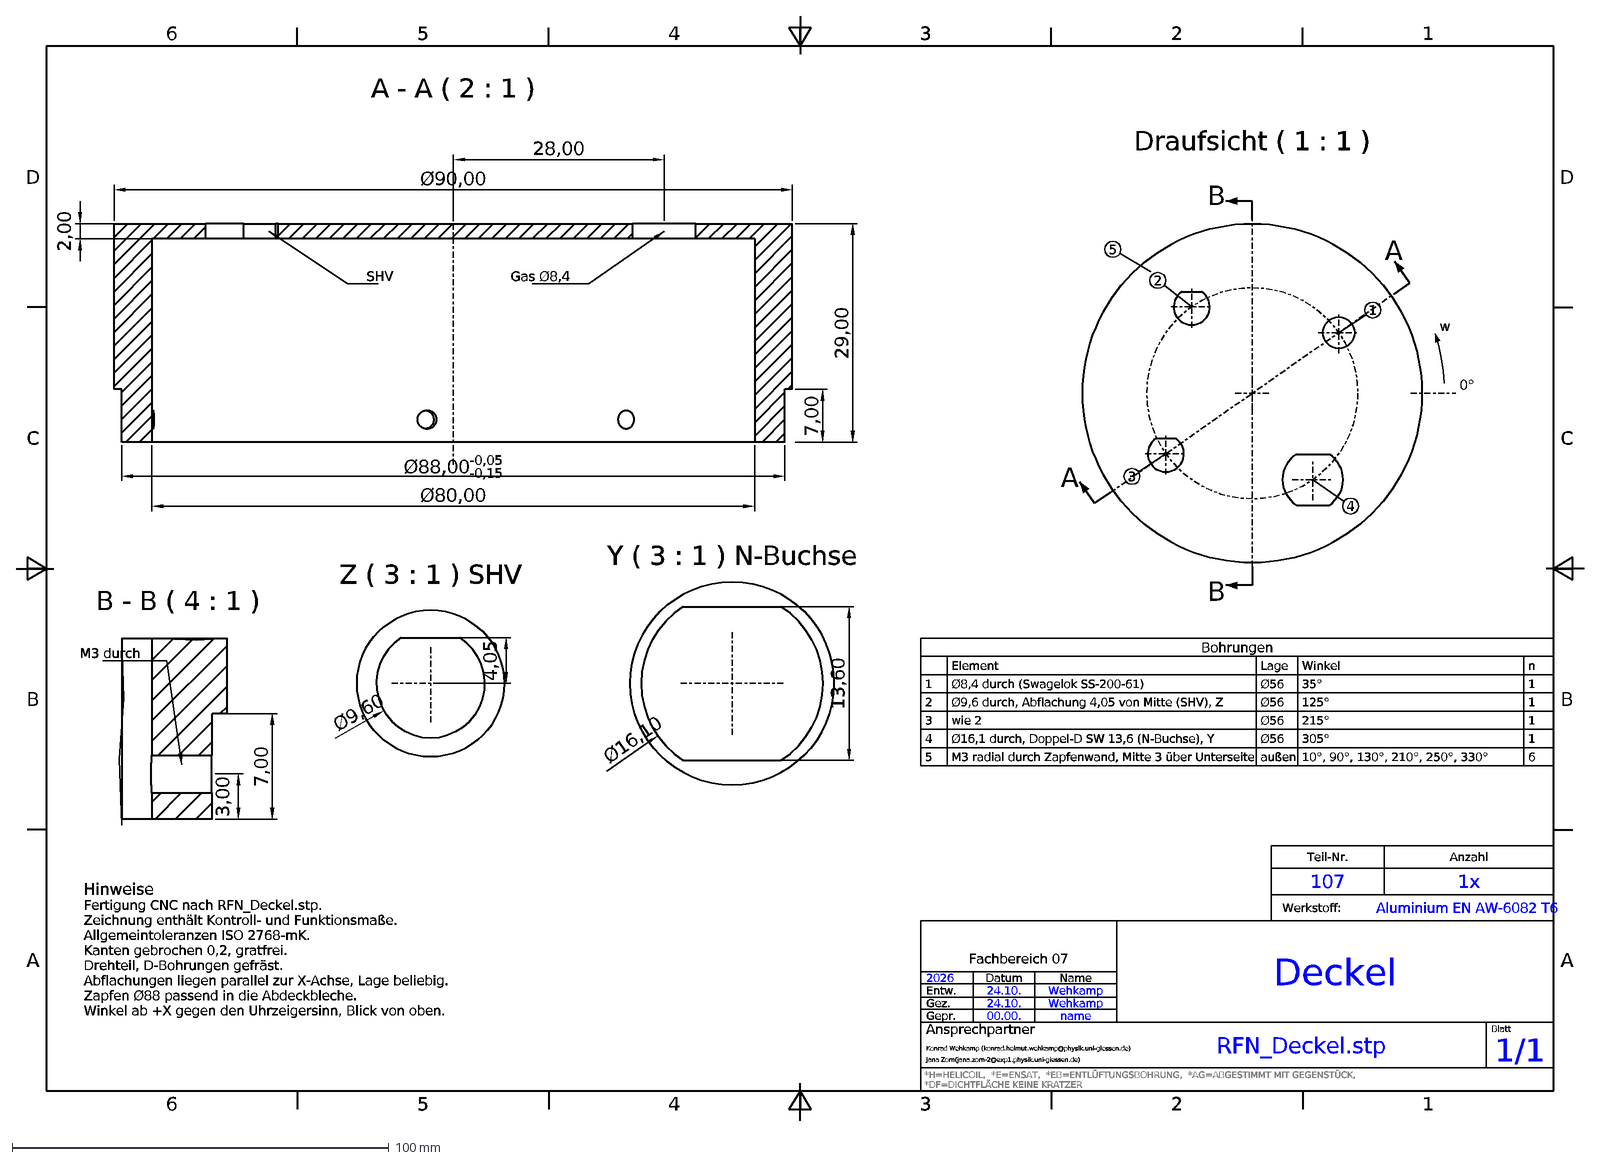
[picture p42: CAD file, 2026-10-25]
CAD/RF-Neutralisator/RFN_Zeichnungen/DXF/107_Deckel.dxf
6
5
4
3
2
1
A
B
C
D
Teil-Nr.
Anzahl
107
1x
Werkstoff:
Aluminium EN AW-6082 T6
Fachbereich 07
2026
Datum
Name
Entw.
24.10.
Wehkamp
Gez.
Gepr.
00.00.
name
Ansprechpartner
Konrad Wehkamp (konrad.helmut.wehkamp@physik.uni-giessen.de)
Jana Zorn(jana.zorn-2@exp1.physik.uni-giessen.de)
Deckel
RFN_Deckel.stp
Blatt
1/1
*H=HELICOIL, *E=ENSAT, *EB=ENTLÜFTUNGSBOHRUNG, *AG=ABGESTIMMT MIT GEGENSTÜCK,
*DF=DICHTFLÄCHE KEINE KRATZER
A - A ( 2 : 1 )
Ø90,00
Ø88,00-0,05^-0,15
Ø80,00
29,00
7,00
2,00
28,00
Gas Ø8,4
SHV
Draufsicht ( 1 : 1 )
0°
w
Z ( 3 : 1 ) SHV
Ø9,60
4,05
Y ( 3 : 1 ) N-Buchse
Ø16,10
13,60
B - B ( 4 : 1 )
3,00
M3 durch
Bohrungen
Element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
