konradweh/ABEP_Koppeltest/CAD/RF-Neutralisator/RFN_Zeichnungen/DXF_2/Edelstahlring.dxf

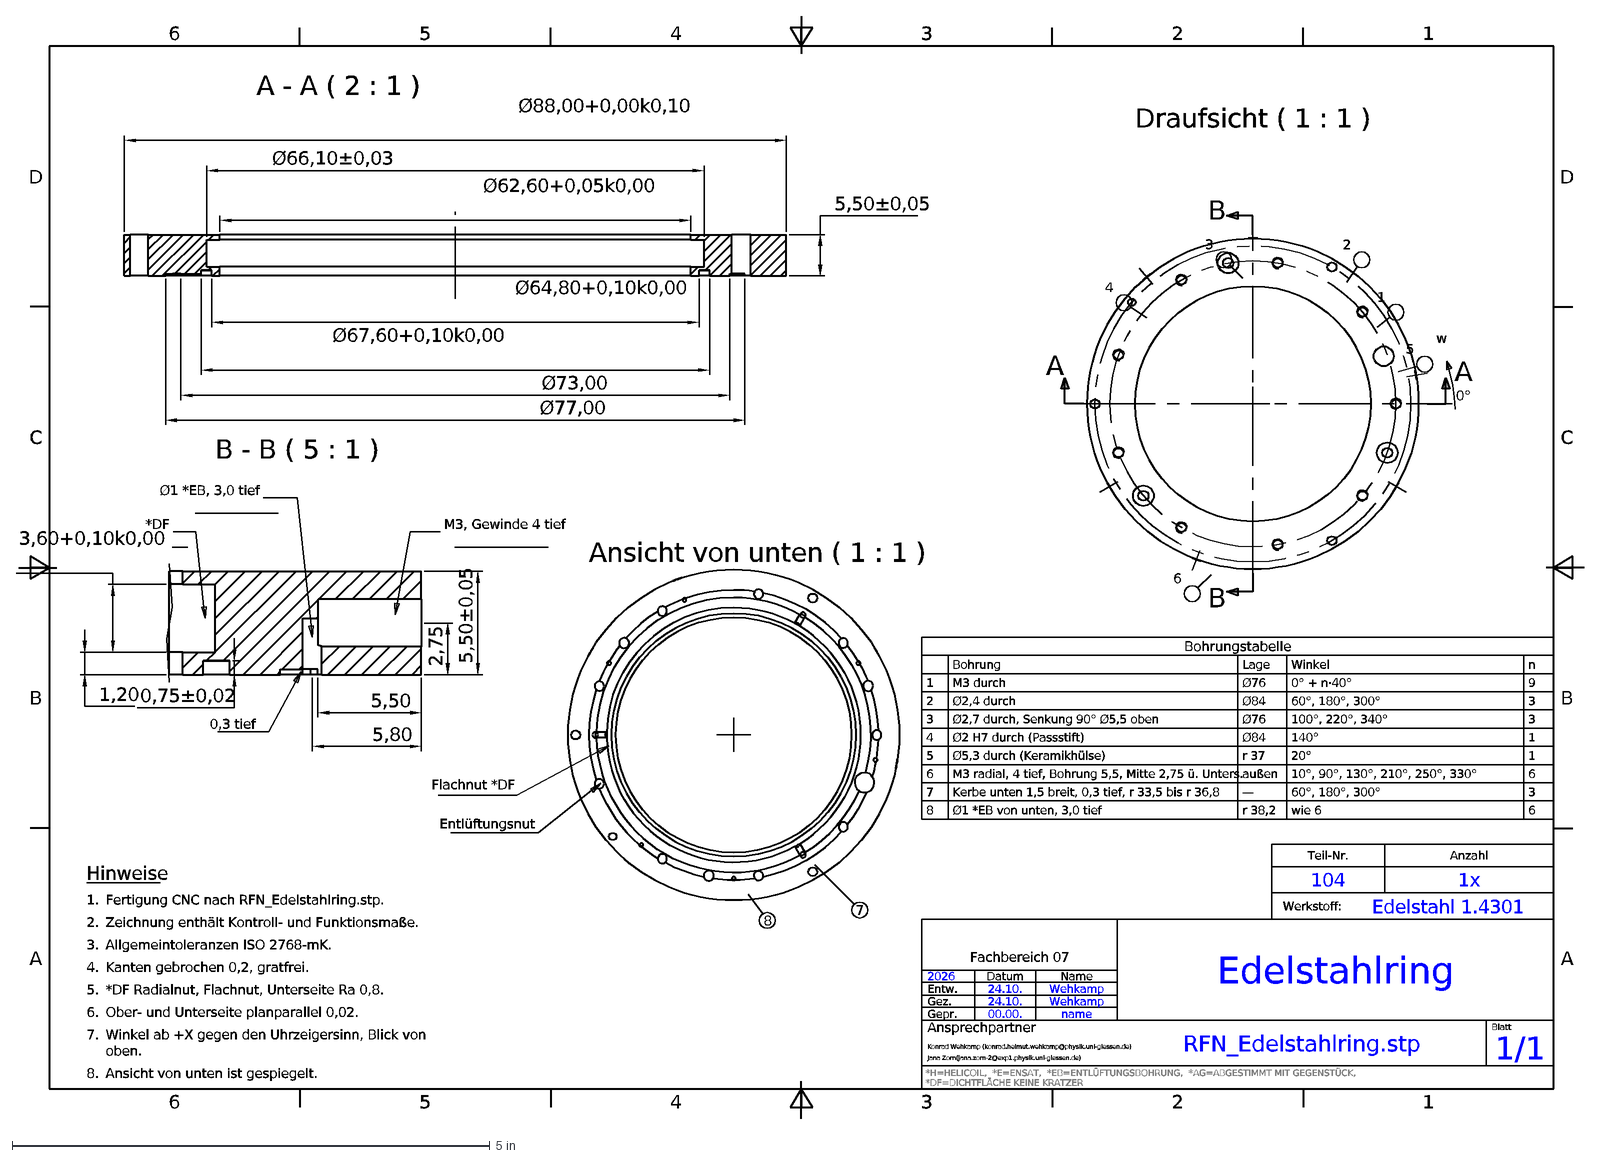
[picture p43: CAD file, 2026-10-27]
CAD/RF-Neutralisator/RFN_Zeichnungen/DXF_2/Edelstahlring.dxf
6
5
4
3
2
1
A
D
C
B
Werkstoff:
Blatt
Anzahl
Ansprechpartner
Fachbereich 07
Teil-Nr.
*H=HELICOIL, *E=ENSAT, *EB=ENTLÜFTUNGSBOHRUNG, *AG=ABGESTIMMT MIT GEGENSTÜCK,
*DF=DICHTFLÄCHE KEINE KRATZER
Draufsicht ( 1 : 1 )
0,3 tief
Ø1 *EB, 3,0 tief
*DF
M3, Gewinde 4 tief
B - B ( 5 : 1 )
Ansicht von unten ( 1 : 1 )
A - A ( 2 : 1 )
1/1
7
RFN_Edelstahlring.stp
8
Edelstahlring
Entlüftungsnut
Jana Zorn(jana.zorn-2@exp1.physik.uni-giessen.de)
Flachnut *DF
0°
Bohrungstabelle
Bohrung
Lage
Winkel
n
M3 durch
Ø76
0° + n·40°
9
Ø2,4 durch
Ø84
60°, 180°, 300°
Ø2,7 durch, Senkung 90° Ø5,5 oben
100°, 220°, 340°
Ø2 H7 durch (Passstift)
140°
Ø5,3 durch (Keramikhülse)
r 37
20°
M3 radial, 4 tief, Bohrung 5,5, Mitte 2,75 ü. Unters.
außen
10°, 90°, 130°, 210°, 250°, 330°
Kerbe unten 1,5 breit, 0,3 tief, r 33,5 bis r 36,8
—
Ø1 *EB von unten, 3,0 tief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
