konradweh/ABEP_Koppeltest/CAD/RF-Neutralisator/RFN_Zeichnungen/Zeichnungen_v10/Zeichnungen_v10/RFN/Kontaktbolzen.dxf

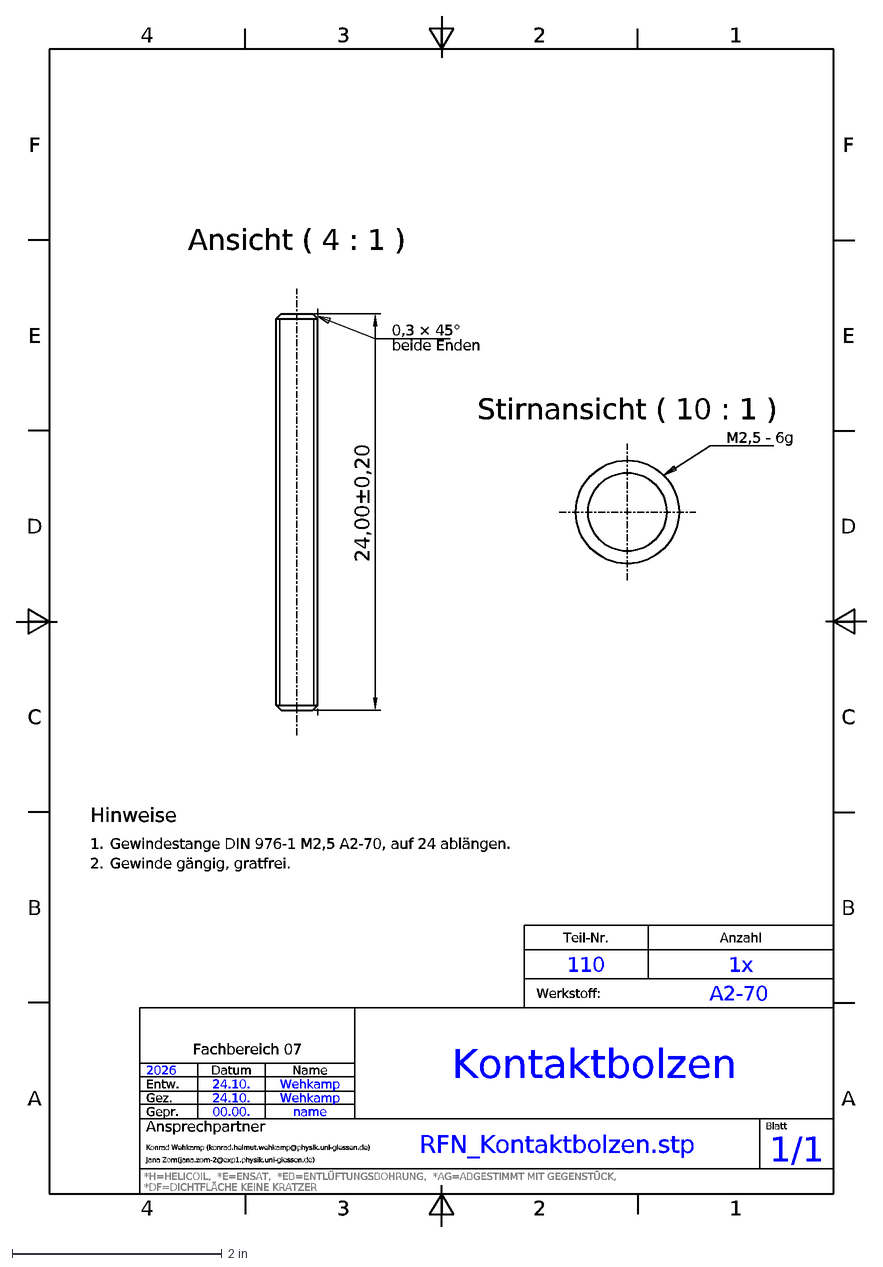
[picture p44: CAD file, 2026-10-27]
CAD/RF-Neutralisator/RFN_Zeichnungen/Zeichnungen_v10/Zeichnungen_v10/RFN/Kontaktbolzen.dxf
4
3
2
1
A
B
C
D
E
F
Fachbereich 07
Blatt
Teil-Nr.
*H=HELICOIL, *E=ENSAT, *EB=ENTLÜFTUNGSBOHRUNG, *AG=ABGESTIMMT MIT GEGENSTÜCK,
*DF=DICHTFLÄCHE KEINE KRATZER
Anzahl
Ansprechpartner
Werkstoff:
110
1x
A2-70
2026
Datum
Name
Entw.
24.10.
Wehkamp
Kontaktbolzen
Ansicht ( 4 : 1 )
Jana Zorn(jana.zorn-2@exp1.physik.uni-giessen.de)
Konrad Wehkamp (konrad.helmut.wehkamp@physik.uni-giessen.de)
0,3 × 45°
beide Enden
name
1/1
RFN_Kontaktbolzen.stp
00.00.
Gepr.
Stirnansicht ( 10 : 1 )
M2,5 - 6g
Gez.
24,00±0,20
Hinweise
1.
Gewindestange DIN 976-1 M2,5 A2-70, auf 24 ablängen.
2.
Gewinde gängig, gratfrei.
