konradweh/ABEP_Koppeltest/CAD/RF-Neutralisator/RFN_Zeichnungen/DXF/110_Kontaktbolzen.dxf

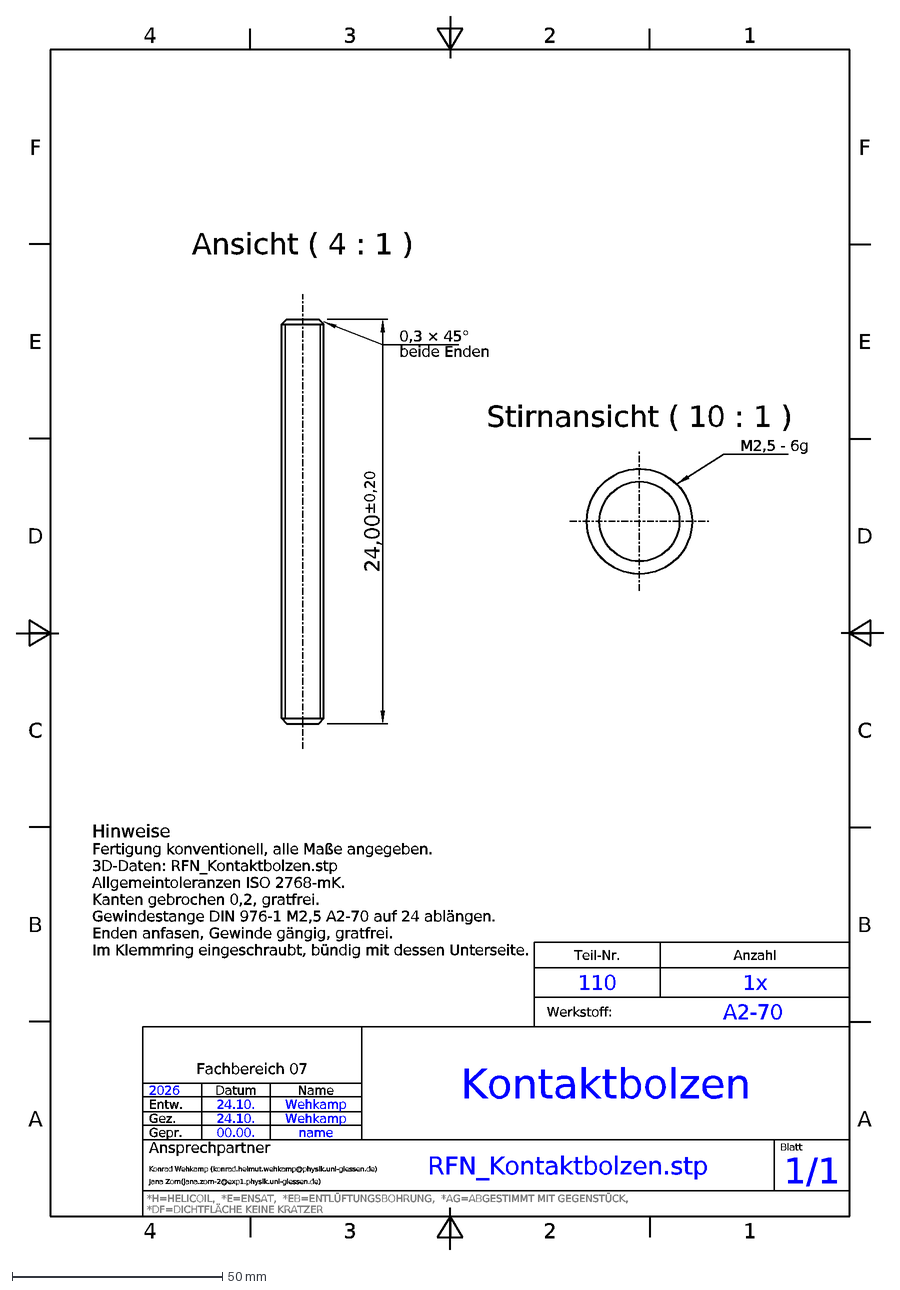
[picture p45: CAD file, 2026-10-25]
CAD/RF-Neutralisator/RFN_Zeichnungen/DXF/110_Kontaktbolzen.dxf
4
3
2
1
A
B
C
D
E
F
Teil-Nr.
Anzahl
110
1x
Werkstoff:
A2-70
Fachbereich 07
2026
Datum
Name
Entw.
24.10.
Wehkamp
Gez.
Gepr.
00.00.
name
Ansprechpartner
Konrad Wehkamp (konrad.helmut.wehkamp@physik.uni-giessen.de)
Jana Zorn(jana.zorn-2@exp1.physik.uni-giessen.de)
Kontaktbolzen
RFN_Kontaktbolzen.stp
Blatt
1/1
*H=HELICOIL, *E=ENSAT, *EB=ENTLÜFTUNGSBOHRUNG, *AG=ABGESTIMMT MIT GEGENSTÜCK,
*DF=DICHTFLÄCHE KEINE KRATZER
Ansicht ( 4 : 1 )
24,00±0,20
0,3 × 45°
beide Enden
Stirnansicht ( 10 : 1 )
M2,5 - 6g
Hinweise
Fertigung konventionell, alle Maße angegeben.
3D-Daten: RFN_Kontaktbolzen.stp
Allgemeintoleranzen ISO 2768-mK.
Kanten gebrochen 0,2, gratfrei.
Gewindestange DIN 976-1 M2,5 A2-70 auf 24 ablängen.
Enden anfasen, Gewinde gängig, gratfrei.
Im Klemmring eingeschraubt, bündig mit dessen Unterseite.
