konradweh/ABEP_Koppeltest/CAD/RF-Neutralisator/RFN_Zeichnungen/DXF_2/Federscheibe.dxf

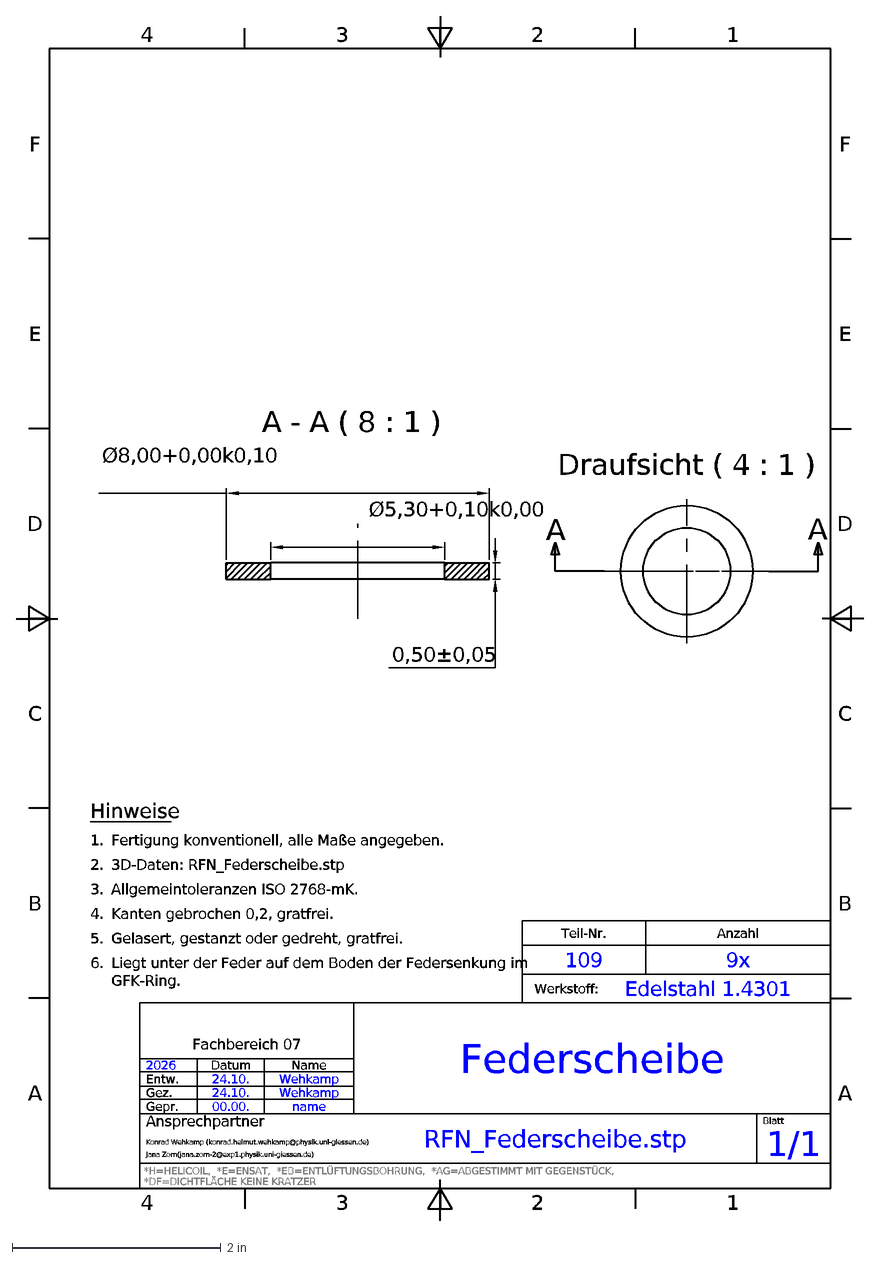
[picture p46: CAD file, 2026-10-27]
CAD/RF-Neutralisator/RFN_Zeichnungen/DXF_2/Federscheibe.dxf
4
3
2
1
A
B
C
D
E
F
Fachbereich 07
Blatt
*H=HELICOIL, *E=ENSAT, *EB=ENTLÜFTUNGSBOHRUNG, *AG=ABGESTIMMT MIT GEGENSTÜCK,
Teil-Nr.
*DF=DICHTFLÄCHE KEINE KRATZER
Werkstoff:
Anzahl
Ansprechpartner
109
9x
Edelstahl 1.4301
2026
Datum
Name
A - A ( 8 : 1 )
RFN_Federscheibe.stp
Federscheibe
Jana Zorn(jana.zorn-2@exp1.physik.uni-giessen.de)
Wehkamp
1/1
Konrad Wehkamp (konrad.helmut.wehkamp@physik.uni-giessen.de)
name
Draufsicht ( 4 : 1 )
00.00.
Gepr.
24.10.
Gez.
Entw.
0,50±0,05
Ø5,30+0,10k0,00
Ø8,00+0,00k0,10
Hinweise
1.
Fertigung konventionell, alle Maße angegeben.
2.
3D-Daten: RFN_Federscheibe.stp
3.
Allgemeintoleranzen ISO 2768-mK.
4.
Kanten gebrochen 0,2, gratfrei.
5.
Gelasert, gestanzt oder gedreht, gratfrei.
6.
Liegt unter der Feder auf dem Boden der Federsenkung im
GFK-Ring.
