konradweh/ABEP_Koppeltest/CAD/RF-Neutralisator/RFN_Zeichnungen/DXF/104_Edelstahlring.dxf

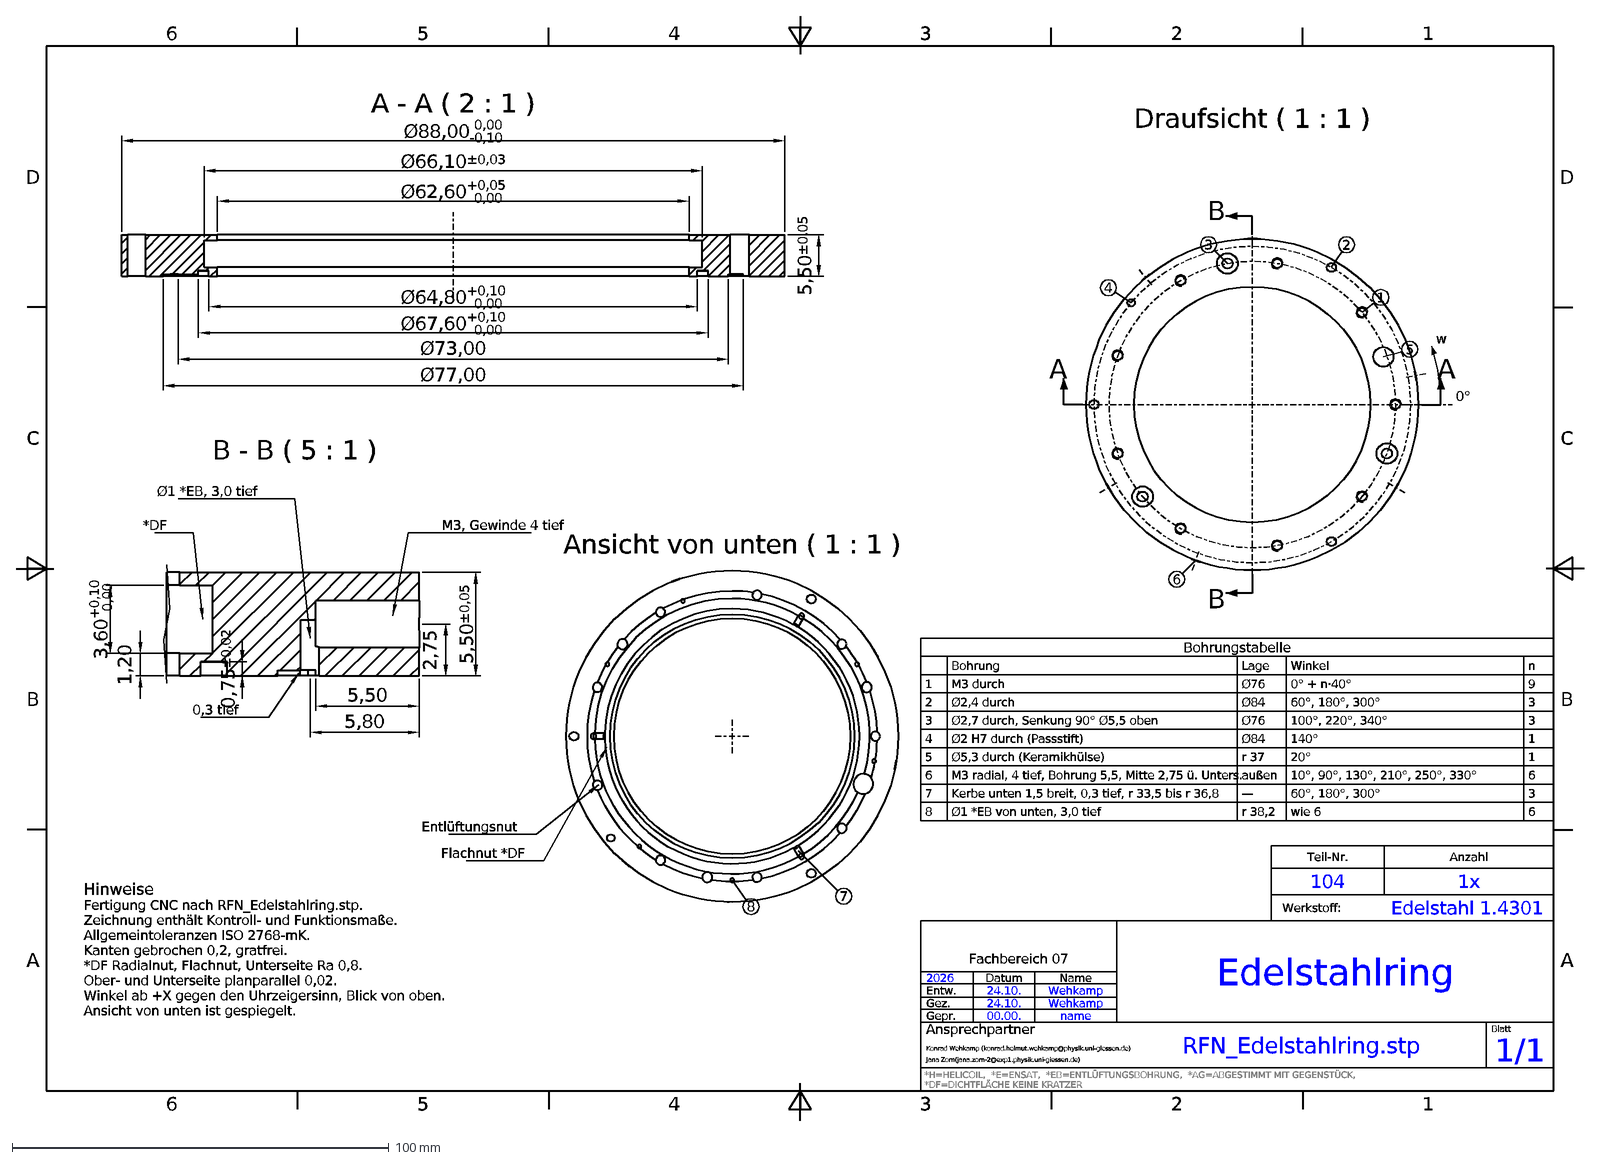
[picture p48: CAD file, 2026-10-25]
CAD/RF-Neutralisator/RFN_Zeichnungen/DXF/104_Edelstahlring.dxf
6
5
4
3
2
1
A
B
C
D
Teil-Nr.
Anzahl
104
1x
Werkstoff:
Edelstahl 1.4301
Fachbereich 07
2026
Datum
Name
Entw.
24.10.
Wehkamp
Gez.
Gepr.
00.00.
name
Ansprechpartner
Konrad Wehkamp (konrad.helmut.wehkamp@physik.uni-giessen.de)
Jana Zorn(jana.zorn-2@exp1.physik.uni-giessen.de)
Edelstahlring
RFN_Edelstahlring.stp
Blatt
1/1
*H=HELICOIL, *E=ENSAT, *EB=ENTLÜFTUNGSBOHRUNG, *AG=ABGESTIMMT MIT GEGENSTÜCK,
*DF=DICHTFLÄCHE KEINE KRATZER
A - A ( 2 : 1 )
Ø62,60+0,05^ 0,00
Ø66,10±0,03
Ø88,00 0,00^-0,10
5,50±0,05
Ø64,80+0,10^ 0,00
Ø67,60+0,10^ 0,00
Ø73,00
Ø77,00
B - B ( 5 : 1 )
1,20
3,60+0,10^ 0,00
2,75
0,75±0,02
5,50
5,80
M3, Gewinde 4 tief
*DF
Ø1 *EB, 3,0 tief
0,3 tief
Draufsicht ( 1 : 1 )
0°
w
Ansicht von unten ( 1 : 1 )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
