konradweh/ABEP_Koppeltest/CAD/RF-Neutralisator/RFN_Zeichnungen/DXF/105_GFK_Ring_oben.dxf

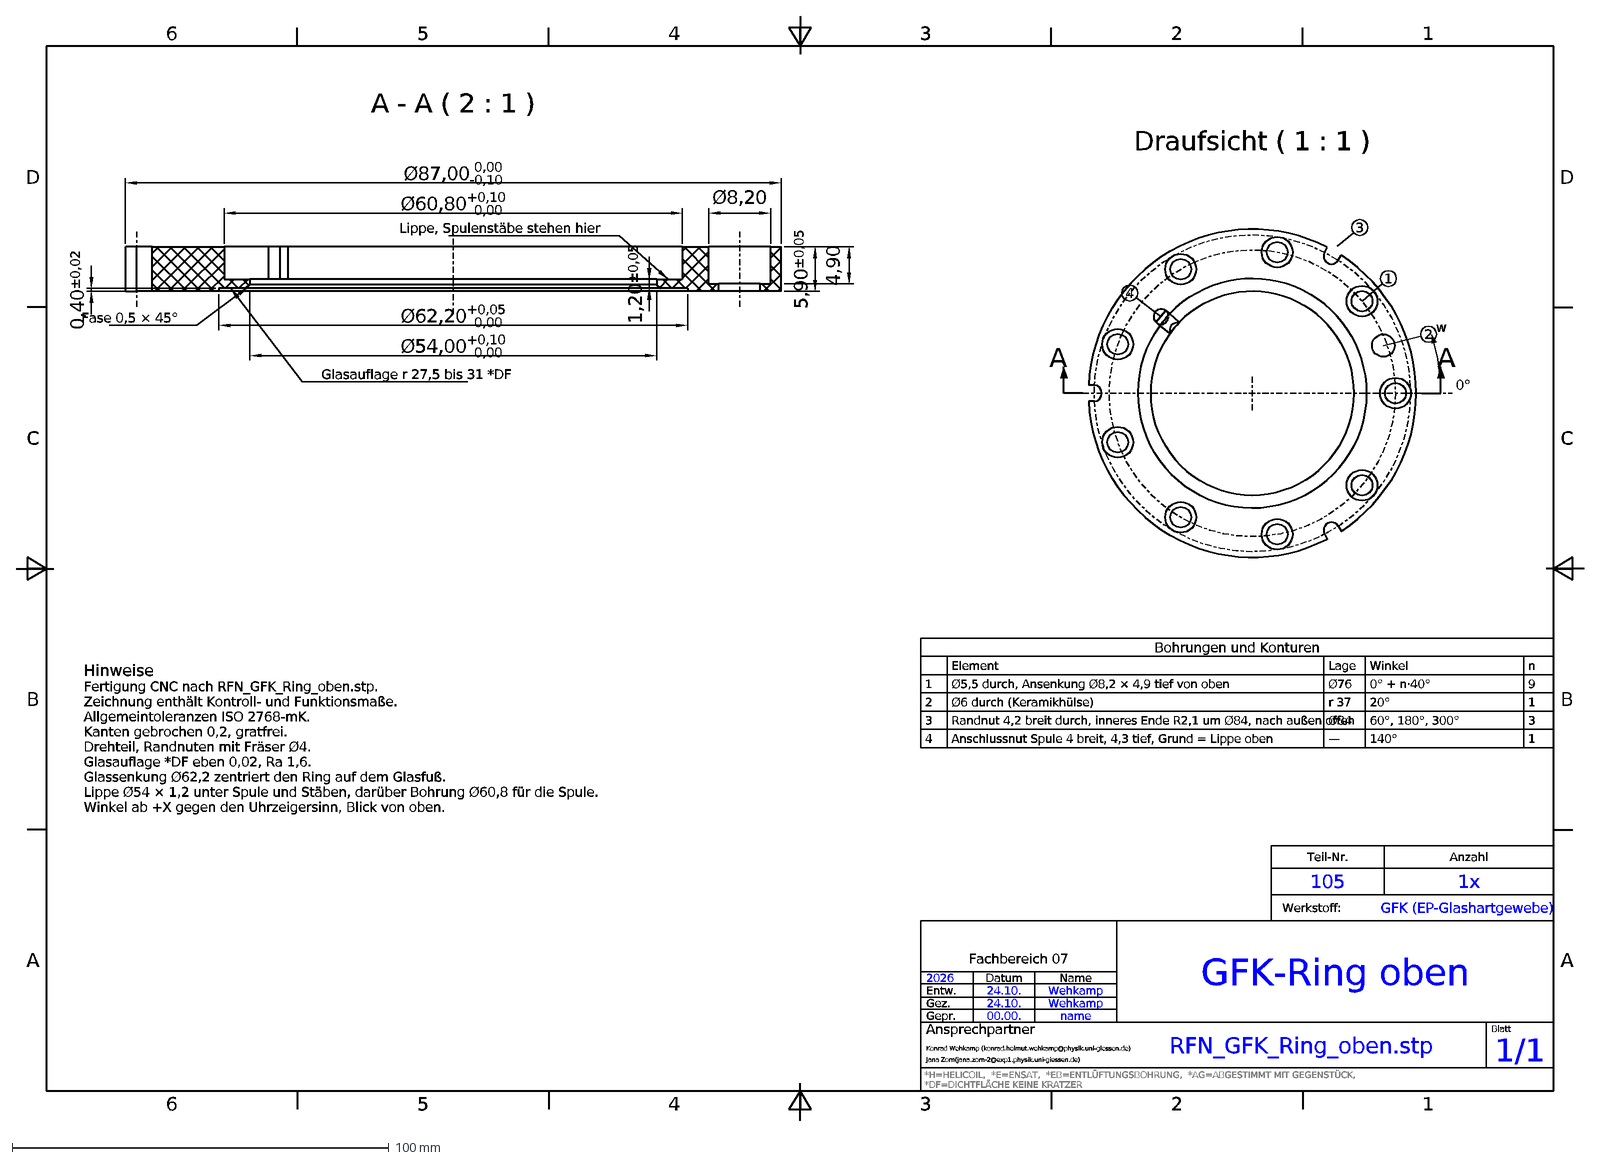
[picture p50: CAD file, 2026-10-25]
CAD/RF-Neutralisator/RFN_Zeichnungen/DXF/105_GFK_Ring_oben.dxf
6
5
4
3
2
1
A
B
C
D
Teil-Nr.
Anzahl
105
1x
Werkstoff:
GFK (EP-Glashartgewebe)
Fachbereich 07
2026
Datum
Name
Entw.
24.10.
Wehkamp
Gez.
Gepr.
00.00.
name
Ansprechpartner
Konrad Wehkamp (konrad.helmut.wehkamp@physik.uni-giessen.de)
Jana Zorn(jana.zorn-2@exp1.physik.uni-giessen.de)
GFK-Ring oben
RFN_GFK_Ring_oben.stp
Blatt
1/1
*H=HELICOIL, *E=ENSAT, *EB=ENTLÜFTUNGSBOHRUNG, *AG=ABGESTIMMT MIT GEGENSTÜCK,
*DF=DICHTFLÄCHE KEINE KRATZER
A - A ( 2 : 1 )
Ø60,80+0,10^ 0,00
Ø87,00 0,00^-0,10
Ø62,20+0,05^ 0,00
Ø54,00+0,10^ 0,00
1,20±0,05
Ø8,20
5,90±0,05
4,90
0,40±0,02
Fase 0,5 × 45°
Glasauflage r 27,5 bis 31 *DF
Lippe, Spulenstäbe stehen hier
Draufsicht ( 1 : 1 )
0°
w
Bohrungen und Konturen
Element
Lage
Winkel
n
Ø5,5 durch, Ansenkung Ø8,2 × 4,9 tief von oben
Ø76
0° + n·40°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
