konradweh/ABEP_Koppeltest/CAD/RF-Neutralisator/RFN_Zeichnungen/DXF_2/Spulenstaebe.dxf

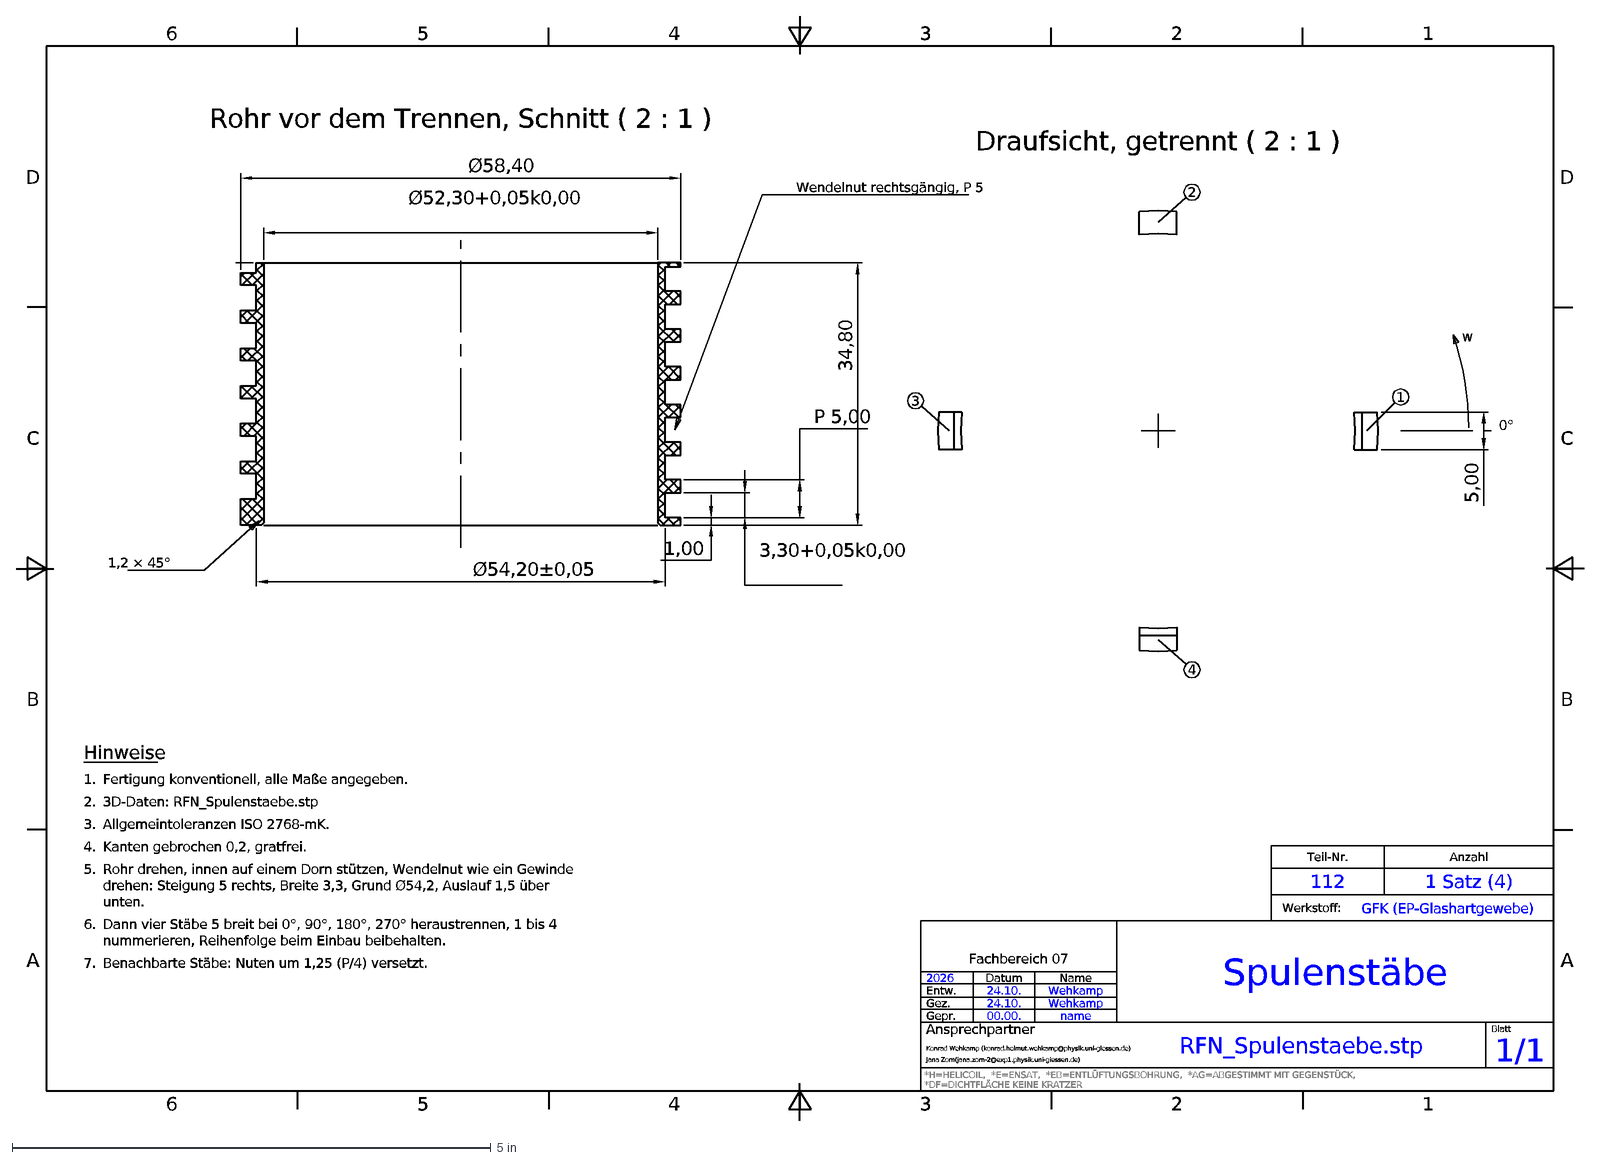
[picture p51: CAD file, 2026-10-27]
CAD/RF-Neutralisator/RFN_Zeichnungen/DXF_2/Spulenstaebe.dxf
A
B
C
D
6
5
4
3
2
1
Teil-Nr.
Anzahl
Werkstoff:
*DF=DICHTFLÄCHE KEINE KRATZER
Ansprechpartner
Blatt
*H=HELICOIL, *E=ENSAT, *EB=ENTLÜFTUNGSBOHRUNG, *AG=ABGESTIMMT MIT GEGENSTÜCK,
Fachbereich 07
1/1
Rohr vor dem Trennen, Schnitt ( 2 : 1 )
RFN_Spulenstaebe.stp
Spulenstäbe
Jana Zorn(jana.zorn-2@exp1.physik.uni-giessen.de)
Konrad Wehkamp (konrad.helmut.wehkamp@physik.uni-giessen.de)
name
Gepr.
Wehkamp
Draufsicht, getrennt ( 2 : 1 )
Name
24.10.
Datum
2026
GFK (EP-Glashartgewebe)
1 Satz (4)
112
1,2 × 45°
Gez.
Wendelnut rechtsgängig, P 5
0°
Entw.
00.00.
w
34,80
P 5,00
3,30+0,05k0,00
1,00
Ø54,20±0,05
Ø58,40
Ø52,30+0,05k0,00
5,00
Hinweise
1.
Fertigung konventionell, alle Maße angegeben.
2.
3D-Daten: RFN_Spulenstaebe.stp
3.
Allgemeintoleranzen ISO 2768-mK.
4.
Kanten gebrochen 0,2, gratfrei.
5.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
