konradweh/ABEP_Koppeltest/CAD/RF-Neutralisator/RFN_Zeichnungen/DXF/102_Klemmring.dxf

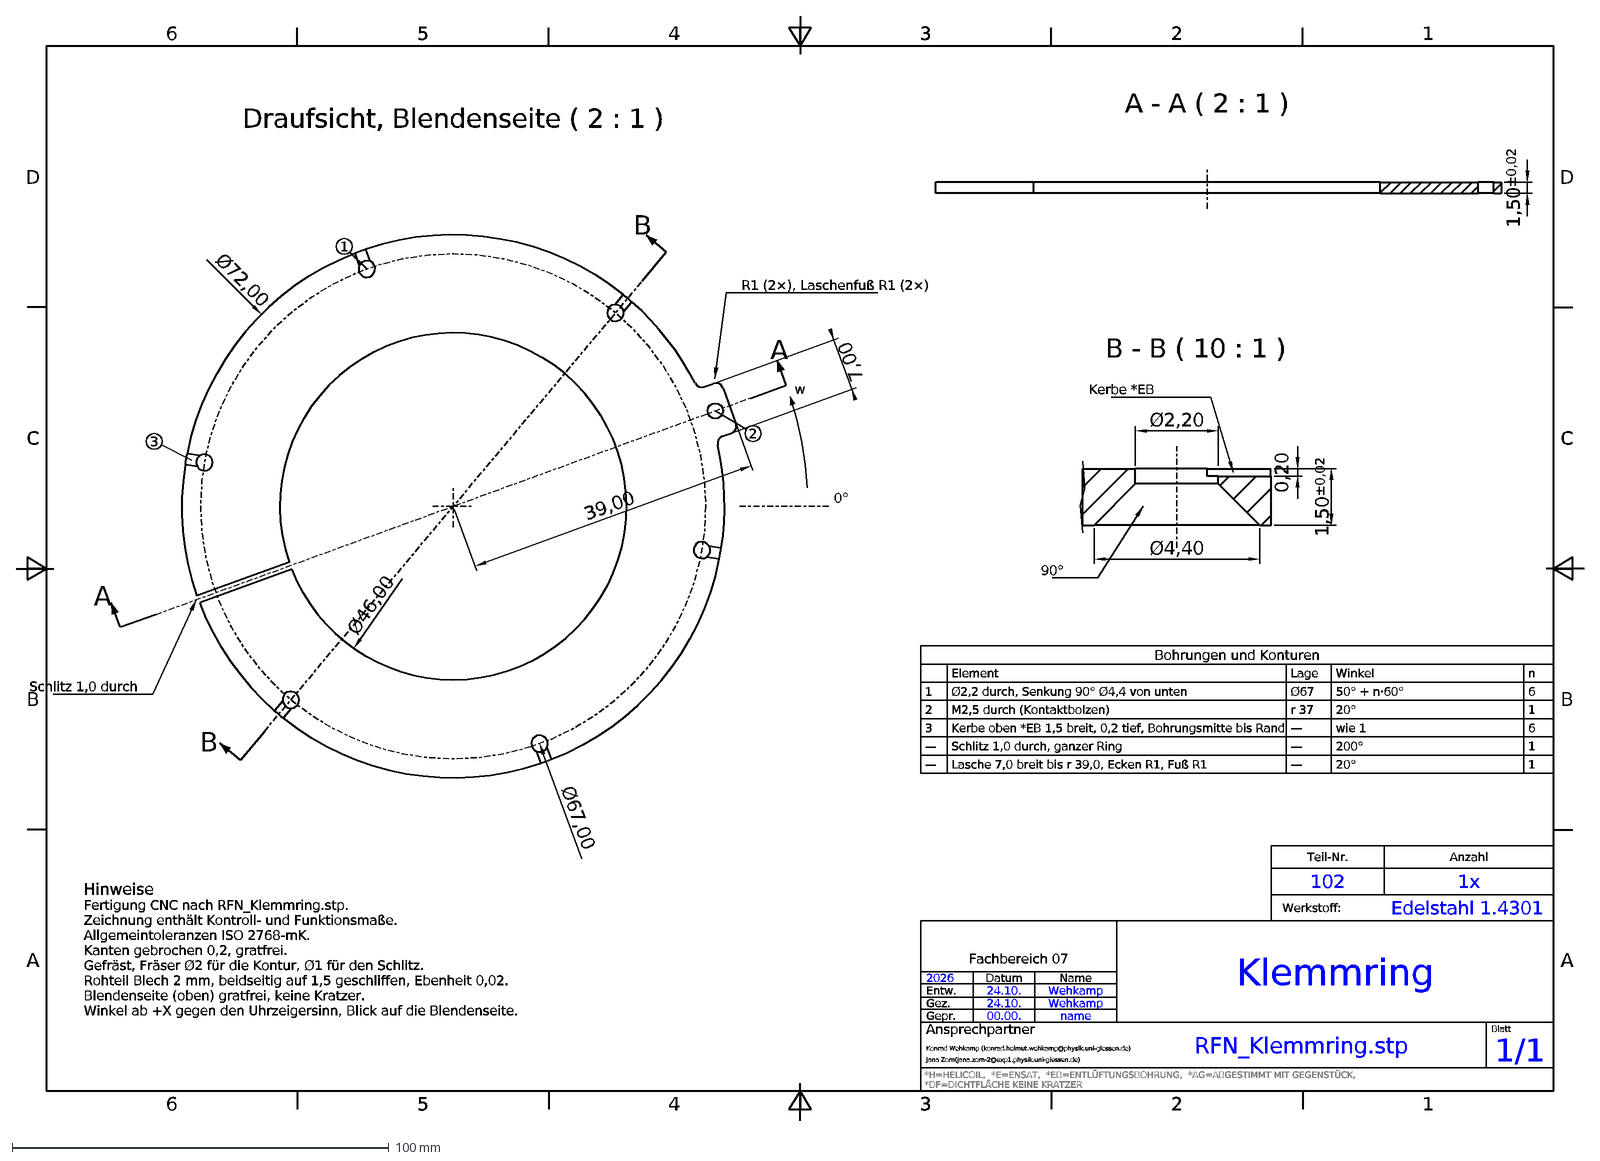
[picture p52: CAD file, 2026-10-25]
CAD/RF-Neutralisator/RFN_Zeichnungen/DXF/102_Klemmring.dxf
6
5
4
3
2
1
A
B
C
D
Teil-Nr.
Anzahl
102
1x
Werkstoff:
Edelstahl 1.4301
Fachbereich 07
2026
Datum
Name
Entw.
24.10.
Wehkamp
Gez.
Gepr.
00.00.
name
Ansprechpartner
Konrad Wehkamp (konrad.helmut.wehkamp@physik.uni-giessen.de)
Jana Zorn(jana.zorn-2@exp1.physik.uni-giessen.de)
Klemmring
RFN_Klemmring.stp
Blatt
1/1
*H=HELICOIL, *E=ENSAT, *EB=ENTLÜFTUNGSBOHRUNG, *AG=ABGESTIMMT MIT GEGENSTÜCK,
*DF=DICHTFLÄCHE KEINE KRATZER
Draufsicht, Blendenseite ( 2 : 1 )
Ø72,00
Ø46,00
Ø67,00
39,00
7,00
R1 (2×), Laschenfuß R1 (2×)
Schlitz 1,0 durch
0°
w
A - A ( 2 : 1 )
1,50±0,02
B - B ( 10 : 1 )
Ø4,40
Ø2,20
0,20
90°
Kerbe *EB
Bohrungen und Konturen
Element
Lage
Winkel
n
Ø2,2 durch, Senkung 90° Ø4,4 von unten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
