konradweh/ABEP_Koppeltest/CAD/RF-Neutralisator/RFN_Zeichnungen/DXF_2/Traeger.dxf

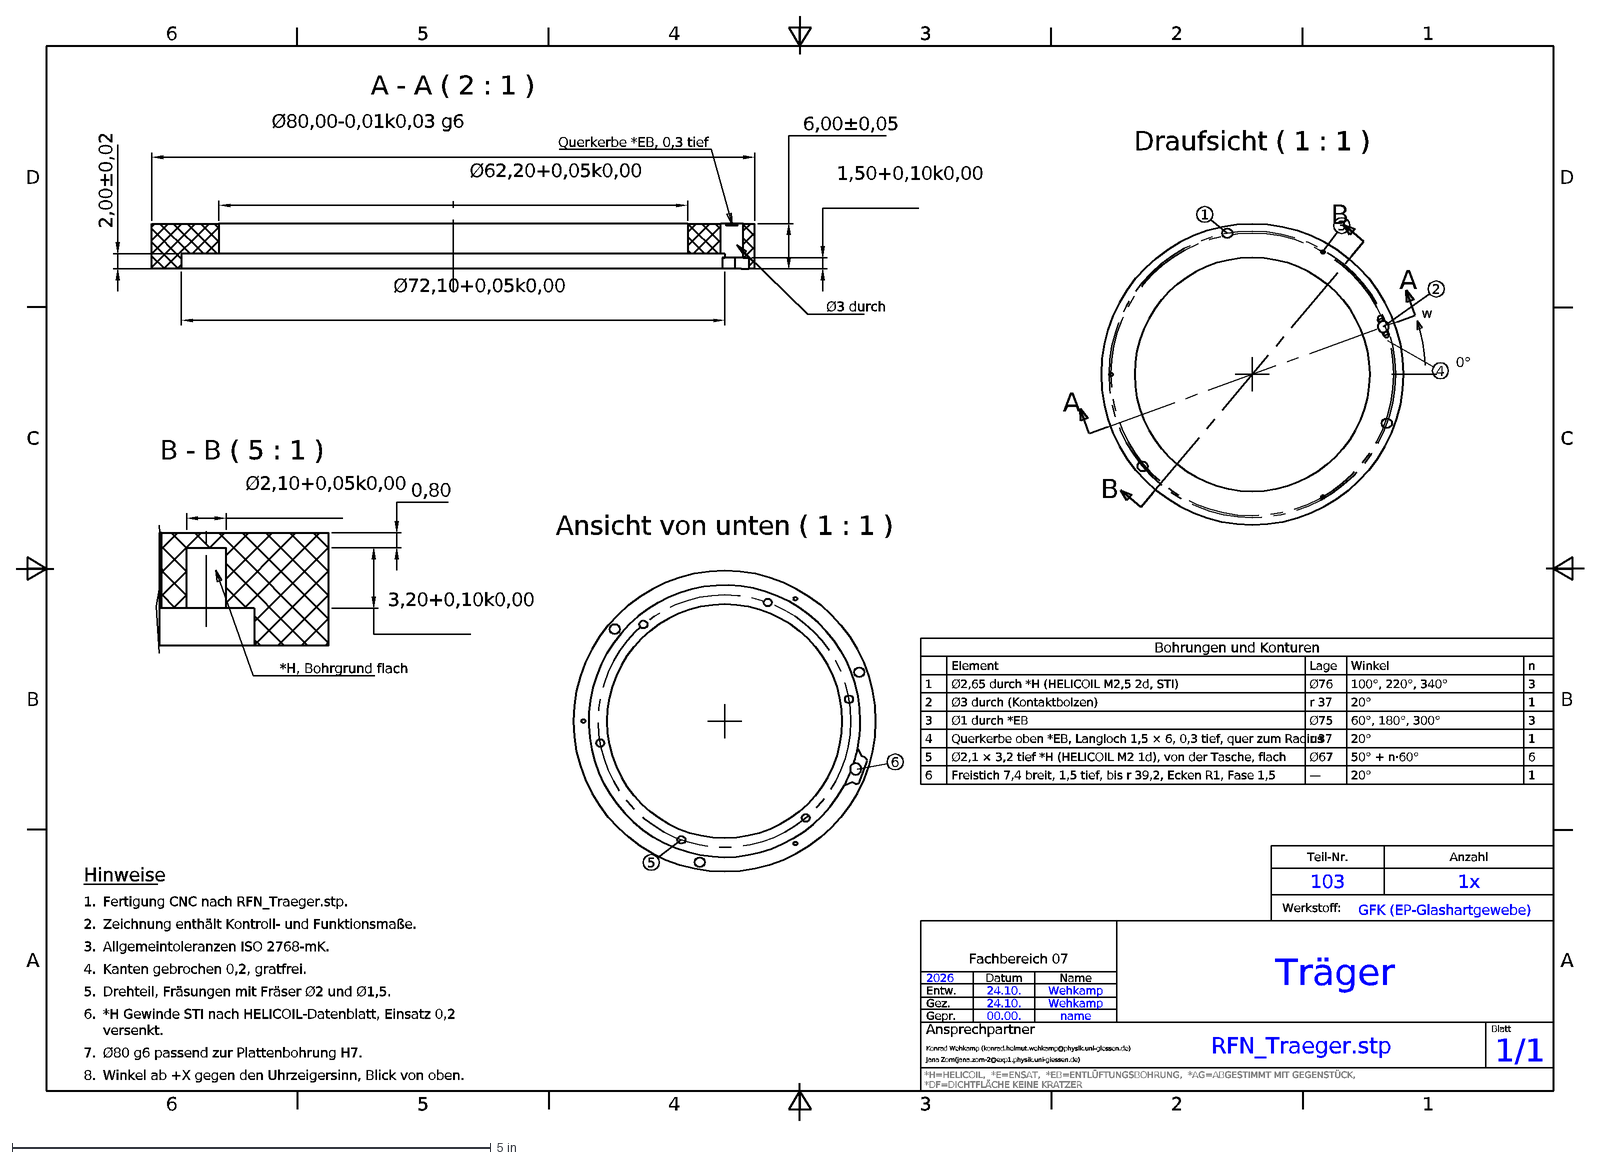
[picture p53: CAD file, 2026-10-27]
CAD/RF-Neutralisator/RFN_Zeichnungen/DXF_2/Traeger.dxf
3
2
1
A
B
C
D
4
6
5
*H=HELICOIL, *E=ENSAT, *EB=ENTLÜFTUNGSBOHRUNG, *AG=ABGESTIMMT MIT GEGENSTÜCK,
*DF=DICHTFLÄCHE KEINE KRATZER
Anzahl
Fachbereich 07
Teil-Nr.
Werkstoff:
Blatt
Ansprechpartner
name
00.00.
B - B ( 5 : 1 )
Wehkamp
24.10.
Entw.
Name
Datum
*H, Bohrgrund flach
2026
Ansicht von unten ( 1 : 1 )
Gepr.
Querkerbe *EB, 0,3 tief
0°
Bohrungen und Konturen
Element
Lage
Winkel
n
Ø2,65 durch *H (HELICOIL M2,5 2d, STI)
Ø76
100°, 220°, 340°
Ø3 durch (Kontaktbolzen)
r 37
20°
Ø1 durch *EB
Ø75
60°, 180°, 300°
Querkerbe oben *EB, Langloch 1,5 × 6, 0,3 tief, quer zum Radius
Ø2,1 × 3,2 tief *H (HELICOIL M2 1d), von der Tasche, flach
Ø67
50° + n·60°
Freistich 7,4 breit, 1,5 tief, bis r 39,2, Ecken R1, Fase 1,5
—
Draufsicht ( 1 : 1 )
w
GFK (EP-Glashartgewebe)
1x
103
Ø3 durch
Gez.
1/1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
