konradweh/ABEP_Koppeltest/CAD/RF-Neutralisator/RFN_Zeichnungen/DXF/106_Abdeckblech.dxf

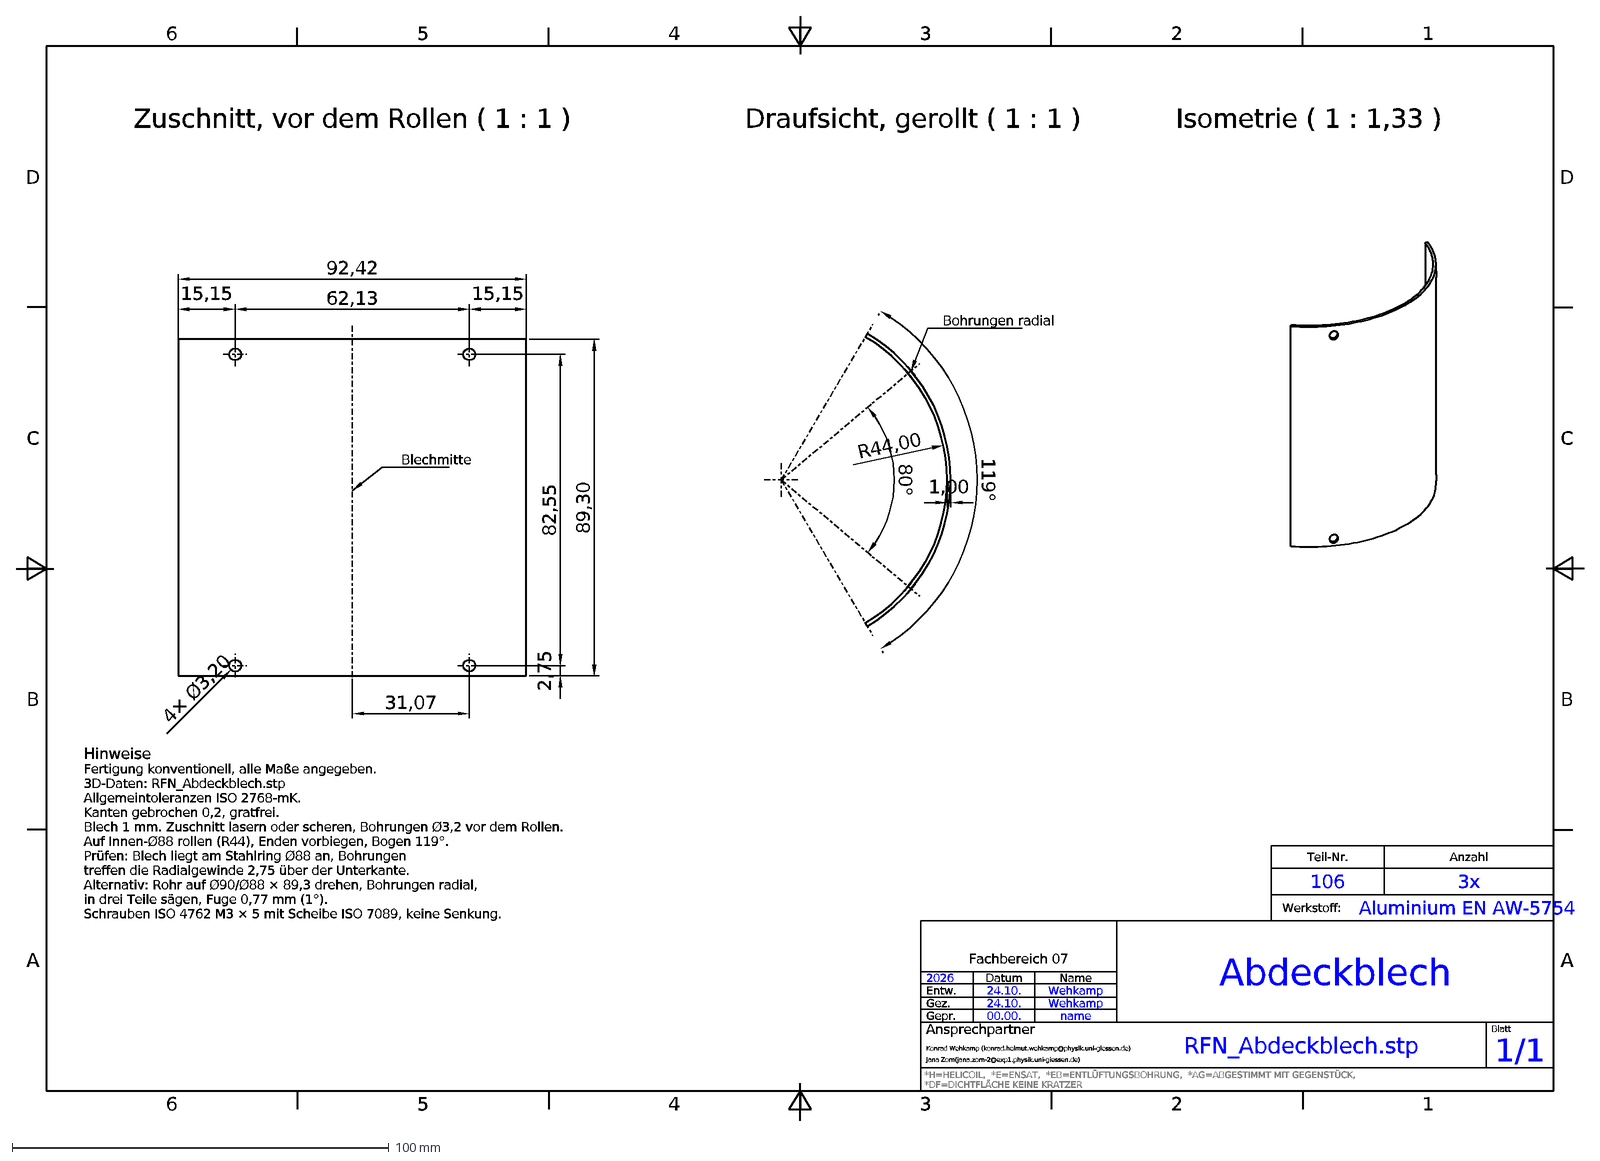
[picture p55: CAD file, 2026-10-25]
CAD/RF-Neutralisator/RFN_Zeichnungen/DXF/106_Abdeckblech.dxf
6
5
4
3
2
1
A
B
C
D
Teil-Nr.
Anzahl
106
3x
Werkstoff:
Aluminium EN AW-5754
Fachbereich 07
2026
Datum
Name
Entw.
24.10.
Wehkamp
Gez.
Gepr.
00.00.
name
Ansprechpartner
Konrad Wehkamp (konrad.helmut.wehkamp@physik.uni-giessen.de)
Jana Zorn(jana.zorn-2@exp1.physik.uni-giessen.de)
Abdeckblech
RFN_Abdeckblech.stp
Blatt
1/1
*H=HELICOIL, *E=ENSAT, *EB=ENTLÜFTUNGSBOHRUNG, *AG=ABGESTIMMT MIT GEGENSTÜCK,
*DF=DICHTFLÄCHE KEINE KRATZER
Zuschnitt, vor dem Rollen ( 1 : 1 )
92,42
15,15
62,13
89,30
2,75
82,55
31,07
4× Ø3,20
Blechmitte
Draufsicht, gerollt ( 1 : 1 )
R44,00
119°
80°
1,00
Bohrungen radial
Isometrie ( 1 : 1,33 )
Hinweise
Fertigung konventionell, alle Maße angegeben.
3D-Daten: RFN_Abdeckblech.stp
Allgemeintoleranzen ISO 2768-mK.
Kanten gebrochen 0,2, gratfrei.
Blech 1 mm. Zuschnitt lasern oder scheren, Bohrungen Ø3,2 vor dem Rollen.
Auf Innen-Ø88 rollen (R44), Enden vorbiegen, Bogen 119°.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
