konradweh/ABEP_Koppeltest/CAD/RF-Neutralisator/RFN_Zeichnungen/DXF_2/GFK-Ring_oben.dxf

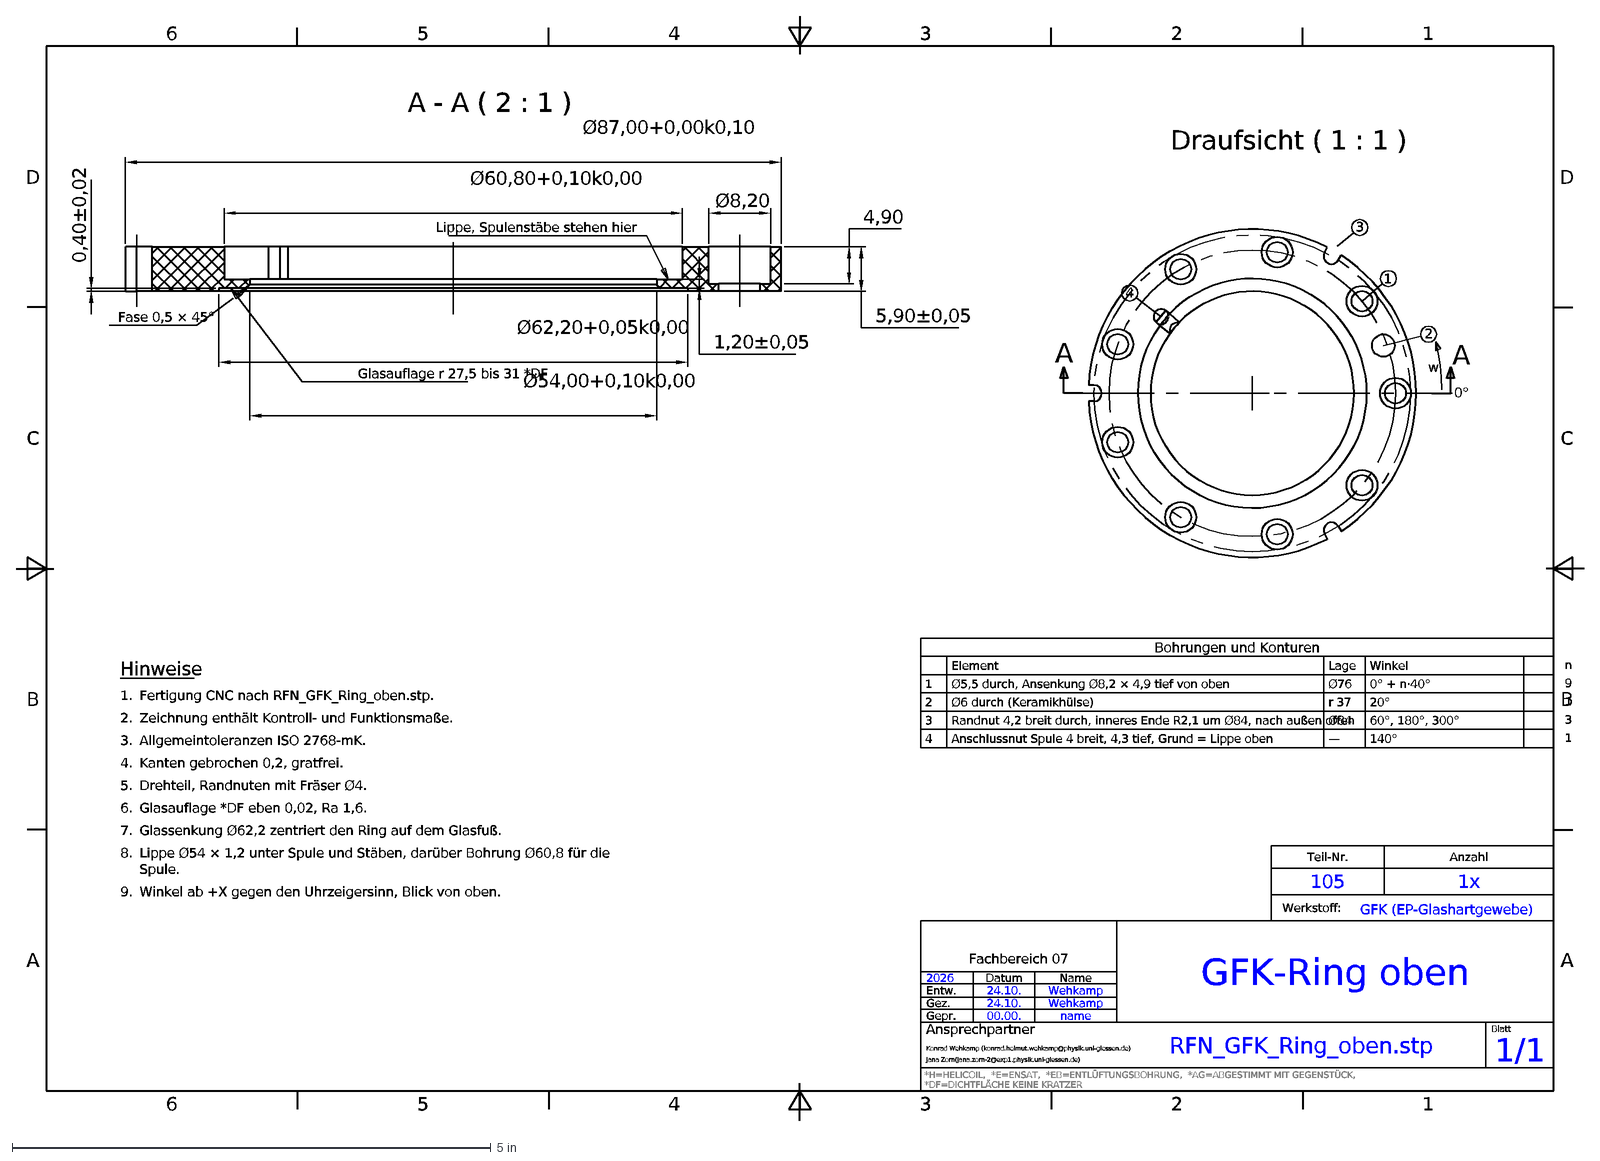
[picture p56: CAD file, 2026-10-27]
CAD/RF-Neutralisator/RFN_Zeichnungen/DXF_2/GFK-Ring_oben.dxf
3
2
1
A
B
C
D
6
5
4
Ansprechpartner
Blatt
*H=HELICOIL, *E=ENSAT, *EB=ENTLÜFTUNGSBOHRUNG, *AG=ABGESTIMMT MIT GEGENSTÜCK,
Fachbereich 07
Werkstoff:
*DF=DICHTFLÄCHE KEINE KRATZER
Anzahl
Teil-Nr.
Glasauflage r 27,5 bis 31 *DF
Datum
2026
Lippe, Spulenstäbe stehen hier
GFK (EP-Glashartgewebe)
1/1
RFN_GFK_Ring_oben.stp
GFK-Ring oben
A - A ( 2 : 1 )
Jana Zorn(jana.zorn-2@exp1.physik.uni-giessen.de)
Konrad Wehkamp (konrad.helmut.wehkamp@physik.uni-giessen.de)
0°
name
00.00.
w
Bohrungen und Konturen
Element
Lage
Winkel
n
Ø5,5 durch, Ansenkung Ø8,2 × 4,9 tief von oben
Ø76
0° + n·40°
9
Ø6 durch (Keramikhülse)
r 37
20°
Randnut 4,2 breit durch, inneres Ende R2,1 um Ø84, nach außen offen
Ø84
60°, 180°, 300°
Anschlussnut Spule 4 breit, 4,3 tief, Grund = Lippe oben
—
140°
Gepr.
Wehkamp
Draufsicht ( 1 : 1 )
1x
105
24.10.
Gez.
Fase 0,5 × 45°
Entw.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
