konradweh/ABEP_Koppeltest/CAD/RF-Neutralisator/RFN_Zeichnungen/DXF/111_Keramikhuelse.dxf

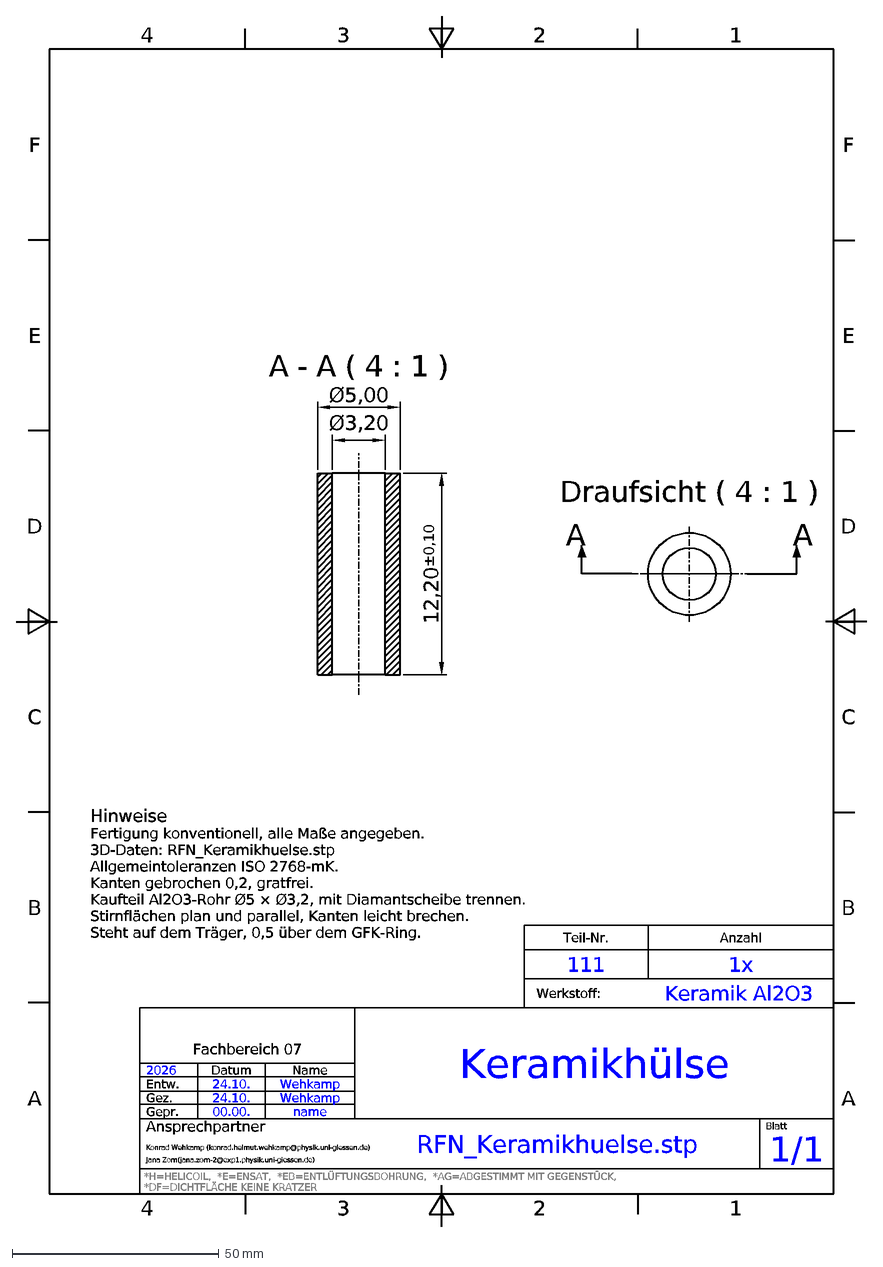
[picture p57: CAD file, 2026-10-25]
CAD/RF-Neutralisator/RFN_Zeichnungen/DXF/111_Keramikhuelse.dxf
4
3
2
1
A
B
C
D
E
F
Teil-Nr.
Anzahl
111
1x
Werkstoff:
Keramik Al2O3
Fachbereich 07
2026
Datum
Name
Entw.
24.10.
Wehkamp
Gez.
Gepr.
00.00.
name
Ansprechpartner
Konrad Wehkamp (konrad.helmut.wehkamp@physik.uni-giessen.de)
Jana Zorn(jana.zorn-2@exp1.physik.uni-giessen.de)
Keramikhülse
RFN_Keramikhuelse.stp
Blatt
1/1
*H=HELICOIL, *E=ENSAT, *EB=ENTLÜFTUNGSBOHRUNG, *AG=ABGESTIMMT MIT GEGENSTÜCK,
*DF=DICHTFLÄCHE KEINE KRATZER
A - A ( 4 : 1 )
Ø5,00
Ø3,20
12,20±0,10
Draufsicht ( 4 : 1 )
Hinweise
Fertigung konventionell, alle Maße angegeben.
3D-Daten: RFN_Keramikhuelse.stp
Allgemeintoleranzen ISO 2768-mK.
Kanten gebrochen 0,2, gratfrei.
Kaufteil Al2O3-Rohr Ø5 × Ø3,2, mit Diamantscheibe trennen.
Stirnflächen plan und parallel, Kanten leicht brechen.
Steht auf dem Träger, 0,5 über dem GFK-Ring.
