konradweh/ABEP_Koppeltest/(list of files, cad)

Other CAD files:
Fertigung/Halterung/Halterung_Assembly.stp
CAD/Halterung/Zeichnungen/Halterung_Assembly.dwg
CAD/Aufhängung/Zeichnungen/RFN_Aufhängung_Drehscheibe.dwg
CAD/Halterung/Zeichnungen/Halterung_Grundplatte.dwg
CAD/RF-Neutralisator/RFN_Zeichnungen/IDW_richtig/Distanzhülse.dwg
CAD/RF-Neutralisator/RFN_Zeichnungen/selbst_gemacht/Träger.dwg
CAD/RF-Neutralisator/Zeichnungen/Blende.dwg
Fertigung/Aufhängung/RFN_Aufhängung_Drehscheibe.stp
Fertigung/Halterung/Halterung_Winkelprofil_kurz.stp
Fertigung/RF-Neutralisator/Blende.dwg
Koppeltest_Halterung/RFN_Aufhängung_Drehscheibe_2.stp
Koppeltest_Halterung/Zeichnungen/Template.dwg
Zeichnungen/Halterung_Grundplatte.dwg
CAD/Halterung/Zeichnungen/Halterung_Seitenteil.dwg
CAD/RF-Neutralisator/RFN_Zeichnungen/IDW_richtig/Keramikhuelse.dwg
CAD/RF-Neutralisator/RFN_Zeichnungen/selbst_gemacht/Ring_unten.dwg
CAD/RF-Neutralisator/Zeichnungen/Klemmring.dwg
Fertigung/Halterung/Halterung_Winkelprofil_lang.stp
Fertigung/RF-Neutralisator/Abdeckung_Gaseinlass.dwg
Koppeltest_Halterung/Halterung_Seitenteil.stp
Koppeltest_Halterung/Zeichnungen/Halterung_Querwinkel.dwg
Zeichnungen/Template.dwg
CAD/Halterung/Zeichnungen/Halterung_Winkelprofil_kurz.dwg
CAD/RF-Neutralisator/RFN_Zeichnungen/IDW_richtig/Klemmring.dwg
CAD/RF-Neutralisator/RFN_Zeichnungen/selbst_gemacht/Klemmring.dwg
CAD/RF-Neutralisator/Zeichnungen/Träger.dwg
Fertigung/Halterung/Halterung_Querwinkel.stp
Koppeltest_Halterung/Zeichnungen/Halterung_Seitenteil.dwg
CAD/Halterung/Zeichnungen/Halterung_Gewindestange.dwg
CAD/RF-Neutralisator/RFN_Zeichnungen/IDW_richtig/Federscheibe+.dwg
CAD/RF-Neutralisator/Zeichnungen/Ring_unten.dwg
CAD/Zeichnungen_v10/Zeichnungen_v10/RFN/GFK-Ring_oben.dxf
Fertigung/Halterung/Halterung_Seitenteil.stp
Koppeltest_Halterung/Zeichnungen/Aufhängung_Seitenteil.dwg
CAD/Halterung/Zeichnungen/Halterung_Winkelprofilrahmen.dwg
CAD/RF-Neutralisator/RFN_Zeichnungen/IDW_richtig/Kontaktbolzen.dwg
CAD/RF-Neutralisator/Zeichnungen/Abdeckung_Gaseinlass.dwg
CAD/RF-Neutralisator/RFN_Zeichnungen/Zeichnungen_v10/Zeichnungen_v10/RFN/Abdeckblech.dxf
CAD/Zeichnungen_v10/Zeichnungen_v10/RFN/Spulenstaebe.dxf
Fertigung/Halterung/Halterung_Grundplatte.stp
CAD/Halterung/Zeichnungen/Halterung_Querwinkel.dwg
CAD/Zeichnungen_v10/Zeichnungen_v10/RFN/Keramikhuelse.dxf
Fertigung/Halterung/Halterung_Gewindestange.stp
CAD/Halterung/Zeichnungen/Halterung_Winkelprofil_lang.dwg
CAD/RF-Neutralisator/RFN_Zeichnungen/Zeichnungen_v10/Zeichnungen_v10/RFN/Federscheibe.dxf
Fertigung/Halterung/Aufhängung_Seitenteil.dwg
CAD/RF-Neutralisator/RFN_Zeichnungen/Zeichnungen_v10/Zeichnungen_v10/RFN/Deckel.dxf
CAD/Zeichnungen_v10/Zeichnungen_v10/RFN/Spule.dxf
CAD/RF-Neutralisator/RFN_Zeichnungen/Zeichnungen_v10/Zeichnungen_v10/RFN/Traeger.dxf
CAD/Zeichnungen_v10/Zeichnungen_v10/RFN/Kontaktbolzen.dxf
CAD/Zeichnungen_v10/Zeichnungen_v10/RFN/Klemmring.dxf
CAD/RF-Neutralisator/RFN_Zeichnungen/Zeichnungen_v10/Zeichnungen_v10/RFN/Distanzhuelse.dxf
CAD/Zeichnungen_v10/Zeichnungen_v10/RFN/Edelstahlring.dxf
19K_001_010_00_A_RIM_10_2019_EFRE_3D_2024_0228/15K_019_010_00_A_80XX_00_ISO_K_ZENTRIERRING_AUSSEN_312 ZRA 160.ipt
19K_001_010_00_A_RIM_10_2019_EFRE_3D_2024_0228/15K_019_025_00_A_010_00_GRUNDTRAEGER_V1.ipt
19K_001_010_00_A_RIM_10_2019_EFRE_3D_2024_0228/15K_019_025_00_A_010_00_SCHWEISSTEIL.iam
19K_001_010_00_A_RIM_10_2019_EFRE_3D_2024_0228/15K_019_025_00_A_030_00_ROHR_06MM_X_1.ipt
19K_001_010_00_A_RIM_10_2019_EFRE_3D_2024_0228/15K_019_025_00_A_GRUNDTRAEGER_ISO_K_160_OPTI_3D.iam
19K_001_010_00_A_RIM_10_2019_EFRE_3D_2024_0228/15K_019_028_00_A_010_00_KONTAKT.ipt
19K_001_010_00_A_RIM_10_2019_EFRE_3D_2024_0228/15K_019_028_00_A_020_00_STAB.ipt
19K_001_010_00_A_RIM_10_2019_EFRE_3D_2024_0228/15K_019_030_00_A_010_00_GRIDTRAEGER_3.ipt
19K_001_010_00_A_RIM_10_2019_EFRE_3D_2024_0228/15K_019_030_00_A_020_01_GRIDTRAEGER_2.ipt
19K_001_010_00_A_RIM_10_2019_EFRE_3D_2024_0228/15K_019_030_00_A_070_00_GRID_1_37L.ipt
19K_001_010_00_A_RIM_10_2019_EFRE_3D_2024_0228/15K_019_030_00_A_090_00_GRID_2_37L.ipt
19K_001_010_00_A_RIM_10_2019_EFRE_3D_2024_0228/15K_019_038_00_A_010_00_BOLZEN.ipt
19K_001_010_00_A_RIM_10_2019_EFRE_3D_2024_0228/15K_019_038_00_A_020_00_DREHTEIL.ipt
19K_001_010_00_A_RIM_10_2019_EFRE_3D_2024_0228/15K_019_038_00_A_030_00_HUELSE.ipt
19K_001_010_00_A_RIM_10_2019_EFRE_3D_2024_0228/15K_019_038_00_A_ISOLIEBOLZEN_3D.iam
19K_001_010_00_A_RIM_10_2019_EFRE_3D_2024_0228/15K_019_050_00_A_450_00_KABELSCHUH.ipt
19K_001_010_00_A_RIM_10_2019_EFRE_3D_2024_0228/19K_001_010_00_A_RIM_10_2019_EFRE_3D_2024_0228.ipt
19K_001_010_00_A_RIM_10_2019_EFRE_3D_2024_0228/19K_001_040_00_A_GEFAESS_SPULE_3D.iam
19K_001_010_00_A_RIM_10_2019_EFRE_3D_2024_0228/19K_005_040_00_A_010_00_KLEMMRING.ipt
19K_001_010_00_A_RIM_10_2019_EFRE_3D_2024_0228/19K_005_040_00_A_020_00_KAMM_01.ipt
19K_001_010_00_A_RIM_10_2019_EFRE_3D_2024_0228/19K_005_040_00_A_040_00_KAMM_03.ipt
19K_001_010_00_A_RIM_10_2019_EFRE_3D_2024_0228/19K_005_040_00_A_060_00_KAMM_05.ipt
19K_001_010_00_A_RIM_10_2019_EFRE_3D_2024_0228/19K_005_040_00_A_070_00_KAMM_06.ipt
19K_001_010_00_A_RIM_10_2019_EFRE_3D_2024_0228/19K_005_040_00_A_090_00_KLOTZ.ipt
19K_001_010_00_A_RIM_10_2019_EFRE_3D_2024_0228/19K_005_040_00_A_100_00_SPULE.ipt
19K_001_010_00_A_RIM_10_2019_EFRE_3D_2024_0228/19K_005_040_00_A_100_MONTAGE.iam
19K_001_010_00_A_RIM_10_2019_EFRE_3D_2024_0228/19K_005_040_00_A_110_00_KERAMIKGEFAESS.ipt
19K_001_010_00_A_RIM_10_2019_EFRE_3D_2024_0228/19K_005_040_00_A_440_00_FESTO_SCHW_QSL-G1_8-6.ipt
19K_001_010_00_A_RIM_10_2019_EFRE_3D_2024_0228/19K_005_040_00_A_450_00_ORING_115X_2P5.ipt
19K_001_010_00_A_RIM_10_2019_EFRE_3D_2024_0228/19K_005_040_00_A_6504_00_ZYL_M_IN_DIN4762_M_4_006.ipt
19K_001_010_00_A_RIM_10_2019_EFRE_3D_2024_0228/19K_005_040_00_A_6504_00_ZYL_M_IN_DIN4762_M_4_012.ipt
19K_001_010_00_A_RIM_10_2019_EFRE_3D_2024_0228/19K_005_040_00_A_650_00_KABELSCHUH_D_FUER_M4.ipt
19K_001_010_00_A_RIM_10_2019_EFRE_3D_2024_0228/OldVersions/15K_019_025_00_A_020_00_DECKEL.0001.ipt
19K_001_010_00_A_RIM_10_2019_EFRE_3D_2024_0228/OldVersions/15K_019_025_00_A_030_00_ROHR_06MM_X_1.0001.ipt
19K_001_010_00_A_RIM_10_2019_EFRE_3D_2024_0228/OldVersions/15K_019_025_00_A_040_00_BOLZEN.0001.ipt
19K_001_010_00_A_RIM_10_2019_EFRE_3D_2024_0228/OldVersions/15K_019_025_00_A_GRUNDTRAEGER_ISO_K_160_OPTI_3D.0001.iam
19K_001_010_00_A_RIM_10_2019_EFRE_3D_2024_0228/OldVersions/15K_019_028_00_A_010_00_KONTAKT.0001.ipt
19K_001_010_00_A_RIM_10_2019_EFRE_3D_2024_0228/OldVersions/15K_019_028_00_A_020_00_STAB.0001.ipt
19K_001_010_00_A_RIM_10_2019_EFRE_3D_2024_0228/OldVersions/15K_019_030_00_A_010_00_GRIDTRAEGER_3.0001.ipt
19K_001_010_00_A_RIM_10_2019_EFRE_3D_2024_0228/OldVersions/15K_019_030_00_A_020_00_SCHWEISSTEIL.0001.iam
19K_001_010_00_A_RIM_10_2019_EFRE_3D_2024_0228/OldVersions/15K_019_030_00_A_020_01_GRIDTRAEGER_2.0001.ipt
19K_001_010_00_A_RIM_10_2019_EFRE_3D_2024_0228/OldVersions/15K_019_030_00_A_030_00_GRIDTRAEGER_1.0001.ipt
19K_001_010_00_A_RIM_10_2019_EFRE_3D_2024_0228/OldVersions/15K_019_030_00_A_070_00_GRID_1_37L.0001.ipt
19K_001_010_00_A_RIM_10_2019_EFRE_3D_2024_0228/OldVersions/15K_019_038_00_A_010_00_BOLZEN.0001.ipt
19K_001_010_00_A_RIM_10_2019_EFRE_3D_2024_0228/OldVersions/15K_019_038_00_A_040_00_ABSTANDHALTER.0001.ipt
19K_001_010_00_A_RIM_10_2019_EFRE_3D_2024_0228/OldVersions/15K_019_038_00_A_ISOLIEBOLZEN_3D.0001.iam
19K_001_010_00_A_RIM_10_2019_EFRE_3D_2024_0228/OldVersions/15P_019_030_00_A_TOEPFE_MIT_GITTER_3D.0001.iam
19K_001_010_00_A_RIM_10_2019_EFRE_3D_2024_0228/OldVersions/19K_005_040_00_A_010_00_KLEMMRING.0001.ipt
19K_001_010_00_A_RIM_10_2019_EFRE_3D_2024_0228/OldVersions/19K_005_040_00_A_040_00_KAMM_03.0001.ipt
19K_001_010_00_A_RIM_10_2019_EFRE_3D_2024_0228/OldVersions/19K_005_040_00_A_050_00_KAMM_04.0001.ipt
19K_001_010_00_A_RIM_10_2019_EFRE_3D_2024_0228/OldVersions/19K_005_040_00_A_070_00_KAMM_06.0001.ipt
19K_001_010_00_A_RIM_10_2019_EFRE_3D_2024_0228/OldVersions/19K_005_040_00_A_080_00_DREHTEIL.0001.ipt
19K_001_010_00_A_RIM_10_2019_EFRE_3D_2024_0228/OldVersions/19K_005_040_00_A_090_00_KLOTZ.0001.ipt
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
