konradweh/ABEP_Koppeltest/Fertigung/RF-Neutralisator/PDF/RF-NeutralisatorSpule.pdf

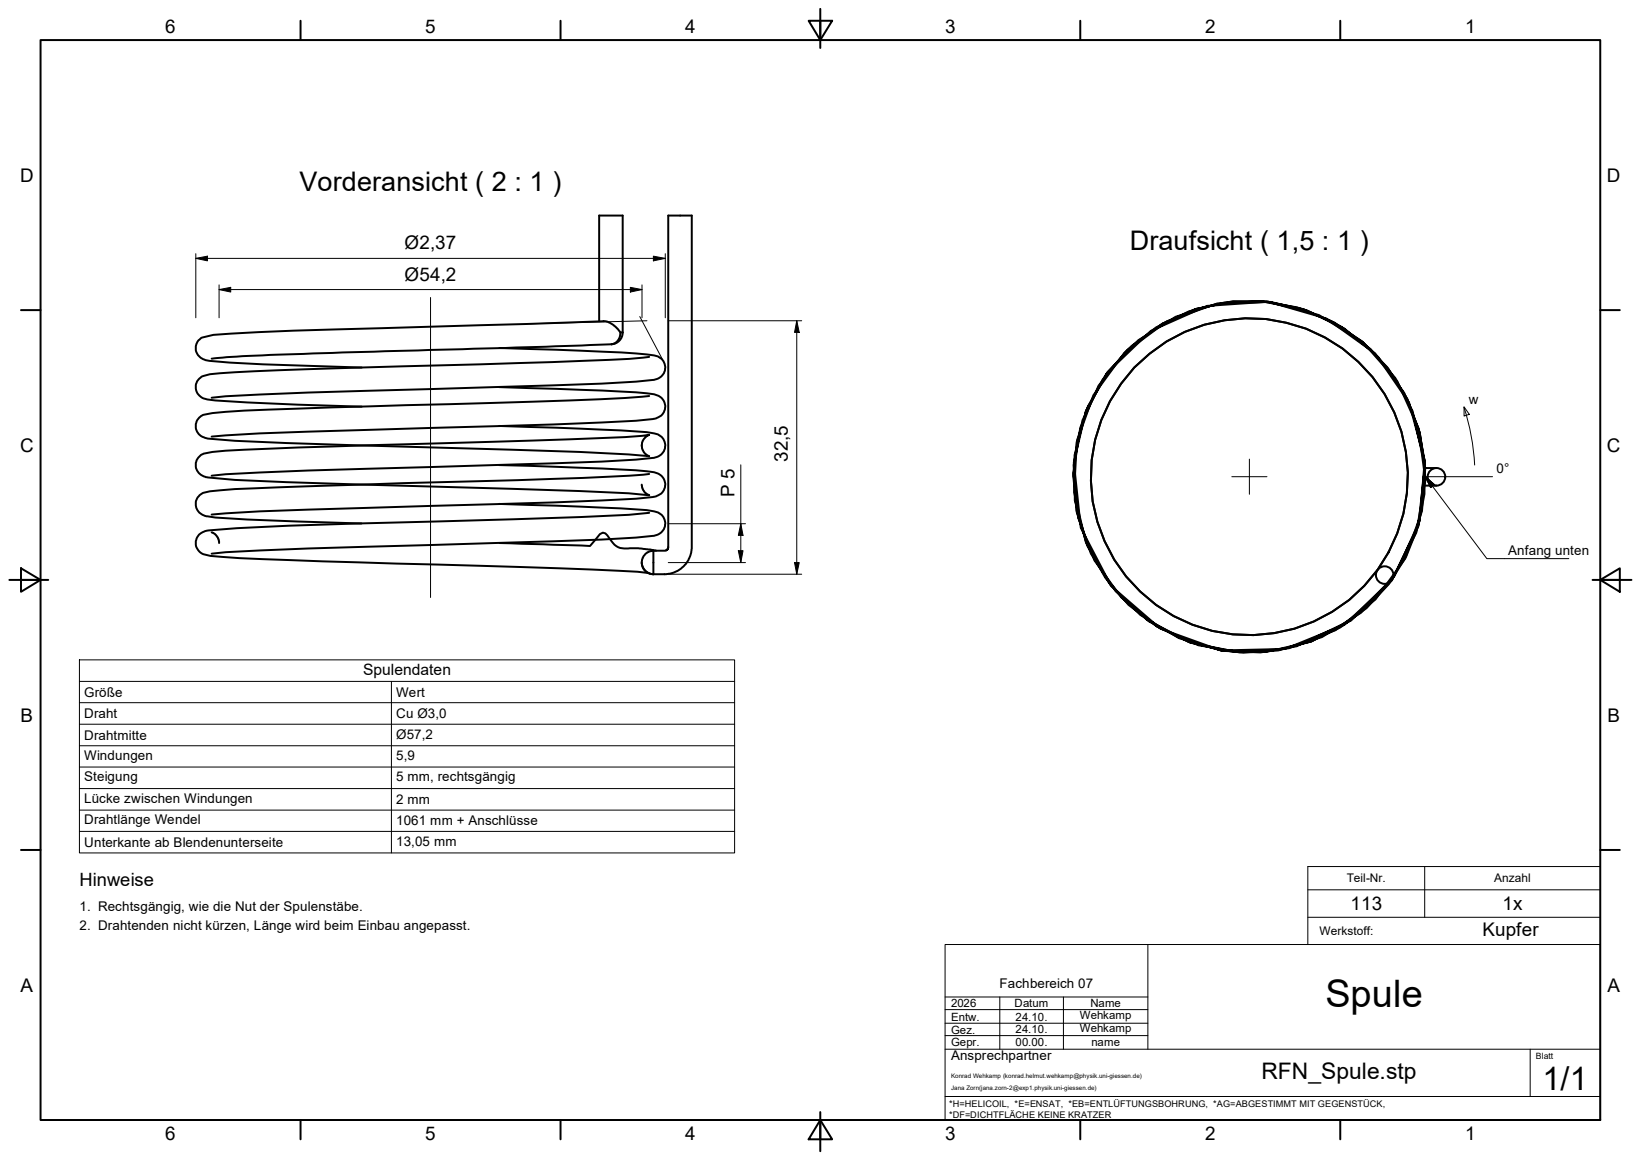
[picture p62: page 1]
Anfang unten; Vorderansicht ( 2 : 1 ); Draufsicht ( 1,5 : 1 )

Größe | Wert
Draht | Cu Ø3,0
Drahtmitte | Ø57,2
Windungen | 5,9
Steigung | 5 mm, rechtsgängig
Lücke zwischen Windungen | 2 mm
Drahtlänge Wendel | 1061 mm + Anschlüsse
Unterkante ab Blendenunterseite | 13,05 mm

Teil-Nr. | Anzahl
113 | 1x

1. Rechtsgängig, wie die Nut der Spulenstäbe.
2. Drahtenden nicht kürzen, Länge wird beim Einbau angepasst.

Fachbereich 07 | Spule

2026 | Datum | Name
Entw. | 24.10. | Wehkamp
Gez. | 24.10. Wehkamp
Gepr. | 00.00. | name
Ansprechpartner RFN_Spule.stp Konrad Wehkamp (konrad.helmut.wehkamp@physik.uni-giessen.de) Jana Zorn(jana.zorn-2@exp1.physik.uni-giessen.de) | Blatt 1/1

*H=HELICOIL, *E=ENSAT, *EB=ENTLÜFTUNGSBOHRUNG, *AG=ABGESTIMMT MIT GEGENSTÜCK,
*DF=DICHTFLÄCHE KEINE KRATZER
