konradweh/ABEP_Koppeltest/Fertigung/Halterung/Halterung_Assembly.pdf

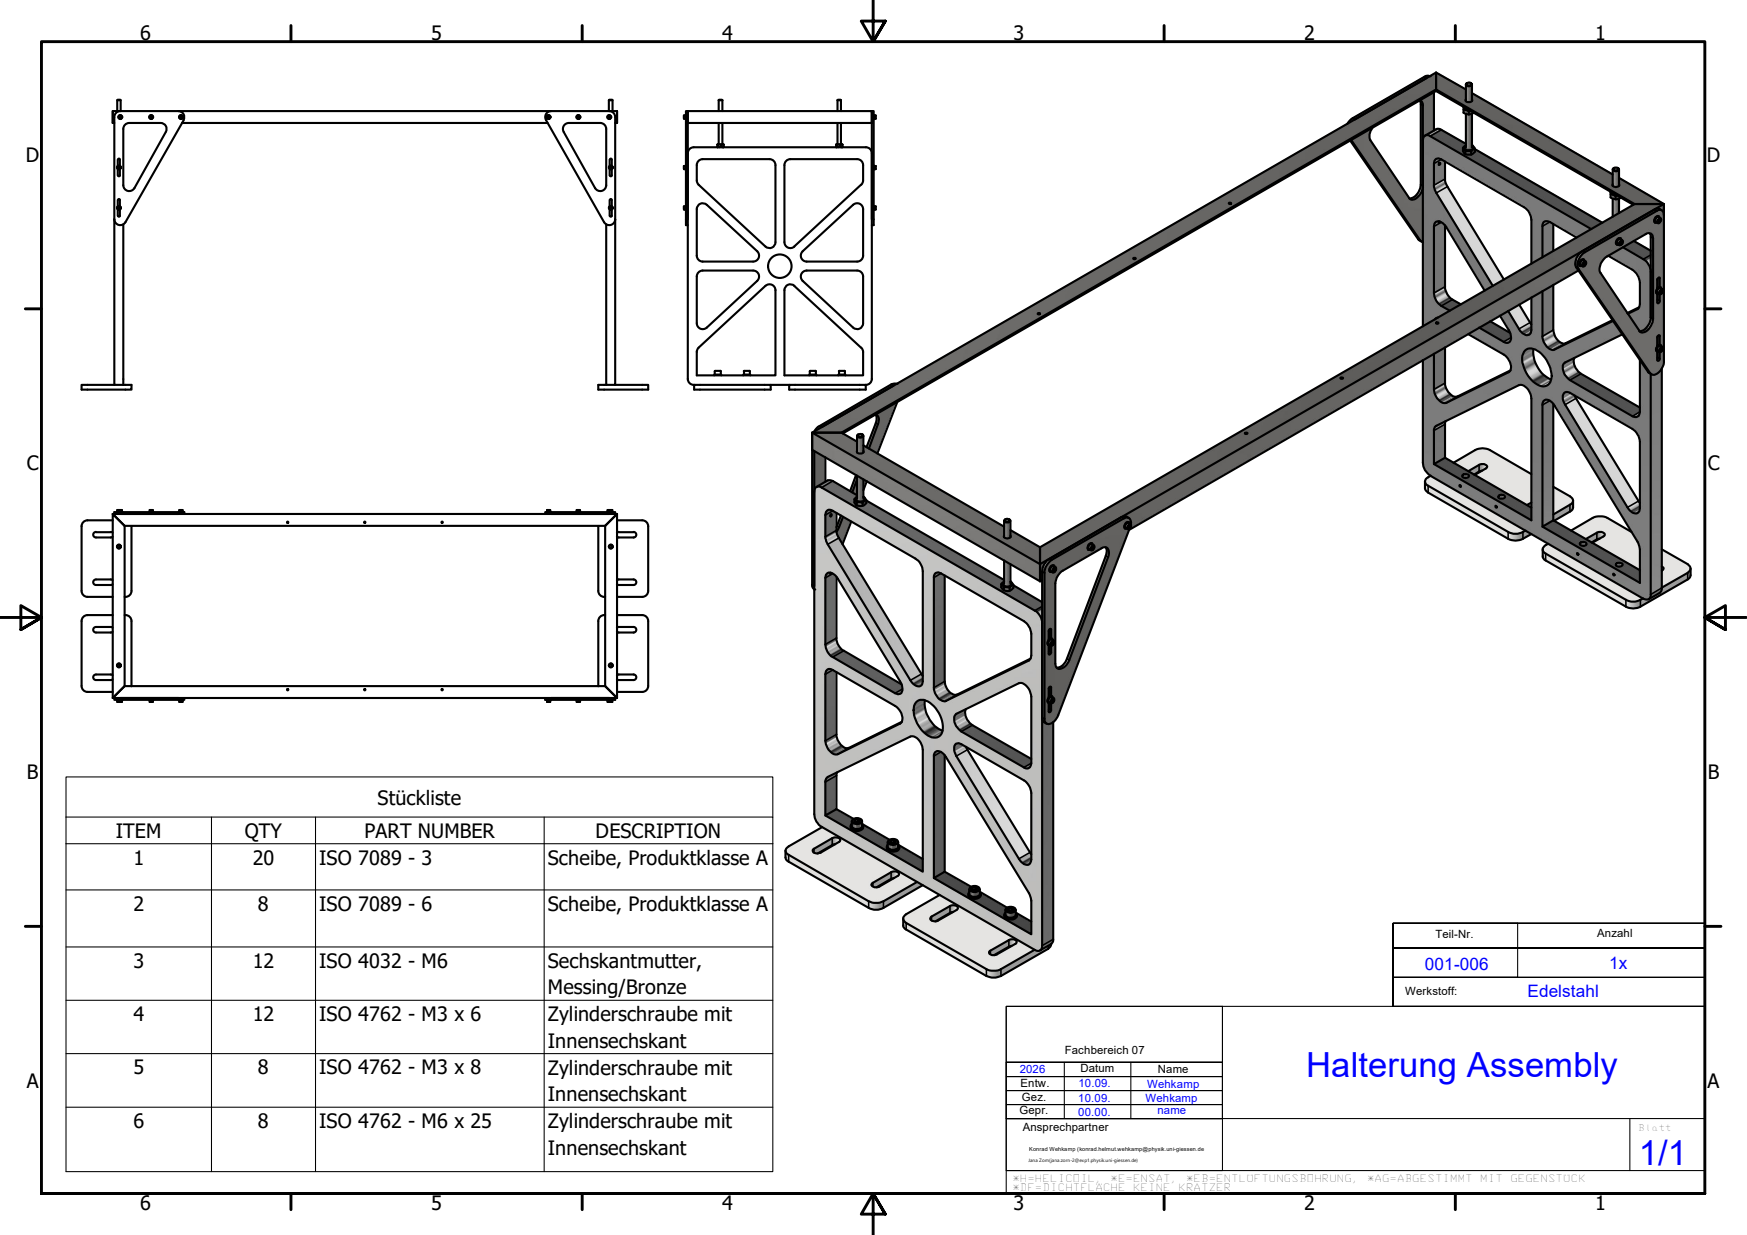
[picture p63: page 1]
ISO 4032 - M6; Zylinderschraube mit; ISO 4762 - M6 x 25

ITEM | QTY | PART NUMBER | DESCRIPTION
1 | 20 | ISO 7089 - 3 | Scheibe, Produktklasse A

2 | 8 | ISO 7089 - 6 | Scheibe, Produktklasse A

Teil-Nr. | Anzahl

4 | 12 | ISO 4762 - M3 x 6 | Zylinderschraube mit Innensechskant

Fachbereich 07 | Halterung Assembly
2026 | Datum | Name

5 | 8 | ISO 4762 - M3 x 8 | Zylinderschraube mit Innensechskant

Entw. | 10.09. | Wehkamp
Gez. | 10.09. | Wehkamp

Konrad Wehkamp (konrad.helmut.wehkamp@physik.uni-giessen.de

Jana Zorn(jana.zorn-2@exp1.physik.uni-giessen.de)
*H=HELICOIL, *E=ENSAT, *EB=ENTLÜFTUNGSBOHRUNG, *AG=ABGESTIMMT MIT GEGENSTÜCK
*DF=DICHTFLÄCHE KEINE KRATZER
