konradweh/ABEP_Koppeltest/Fertigung/Aufhängung/Aufhaengung_010-014.pdf

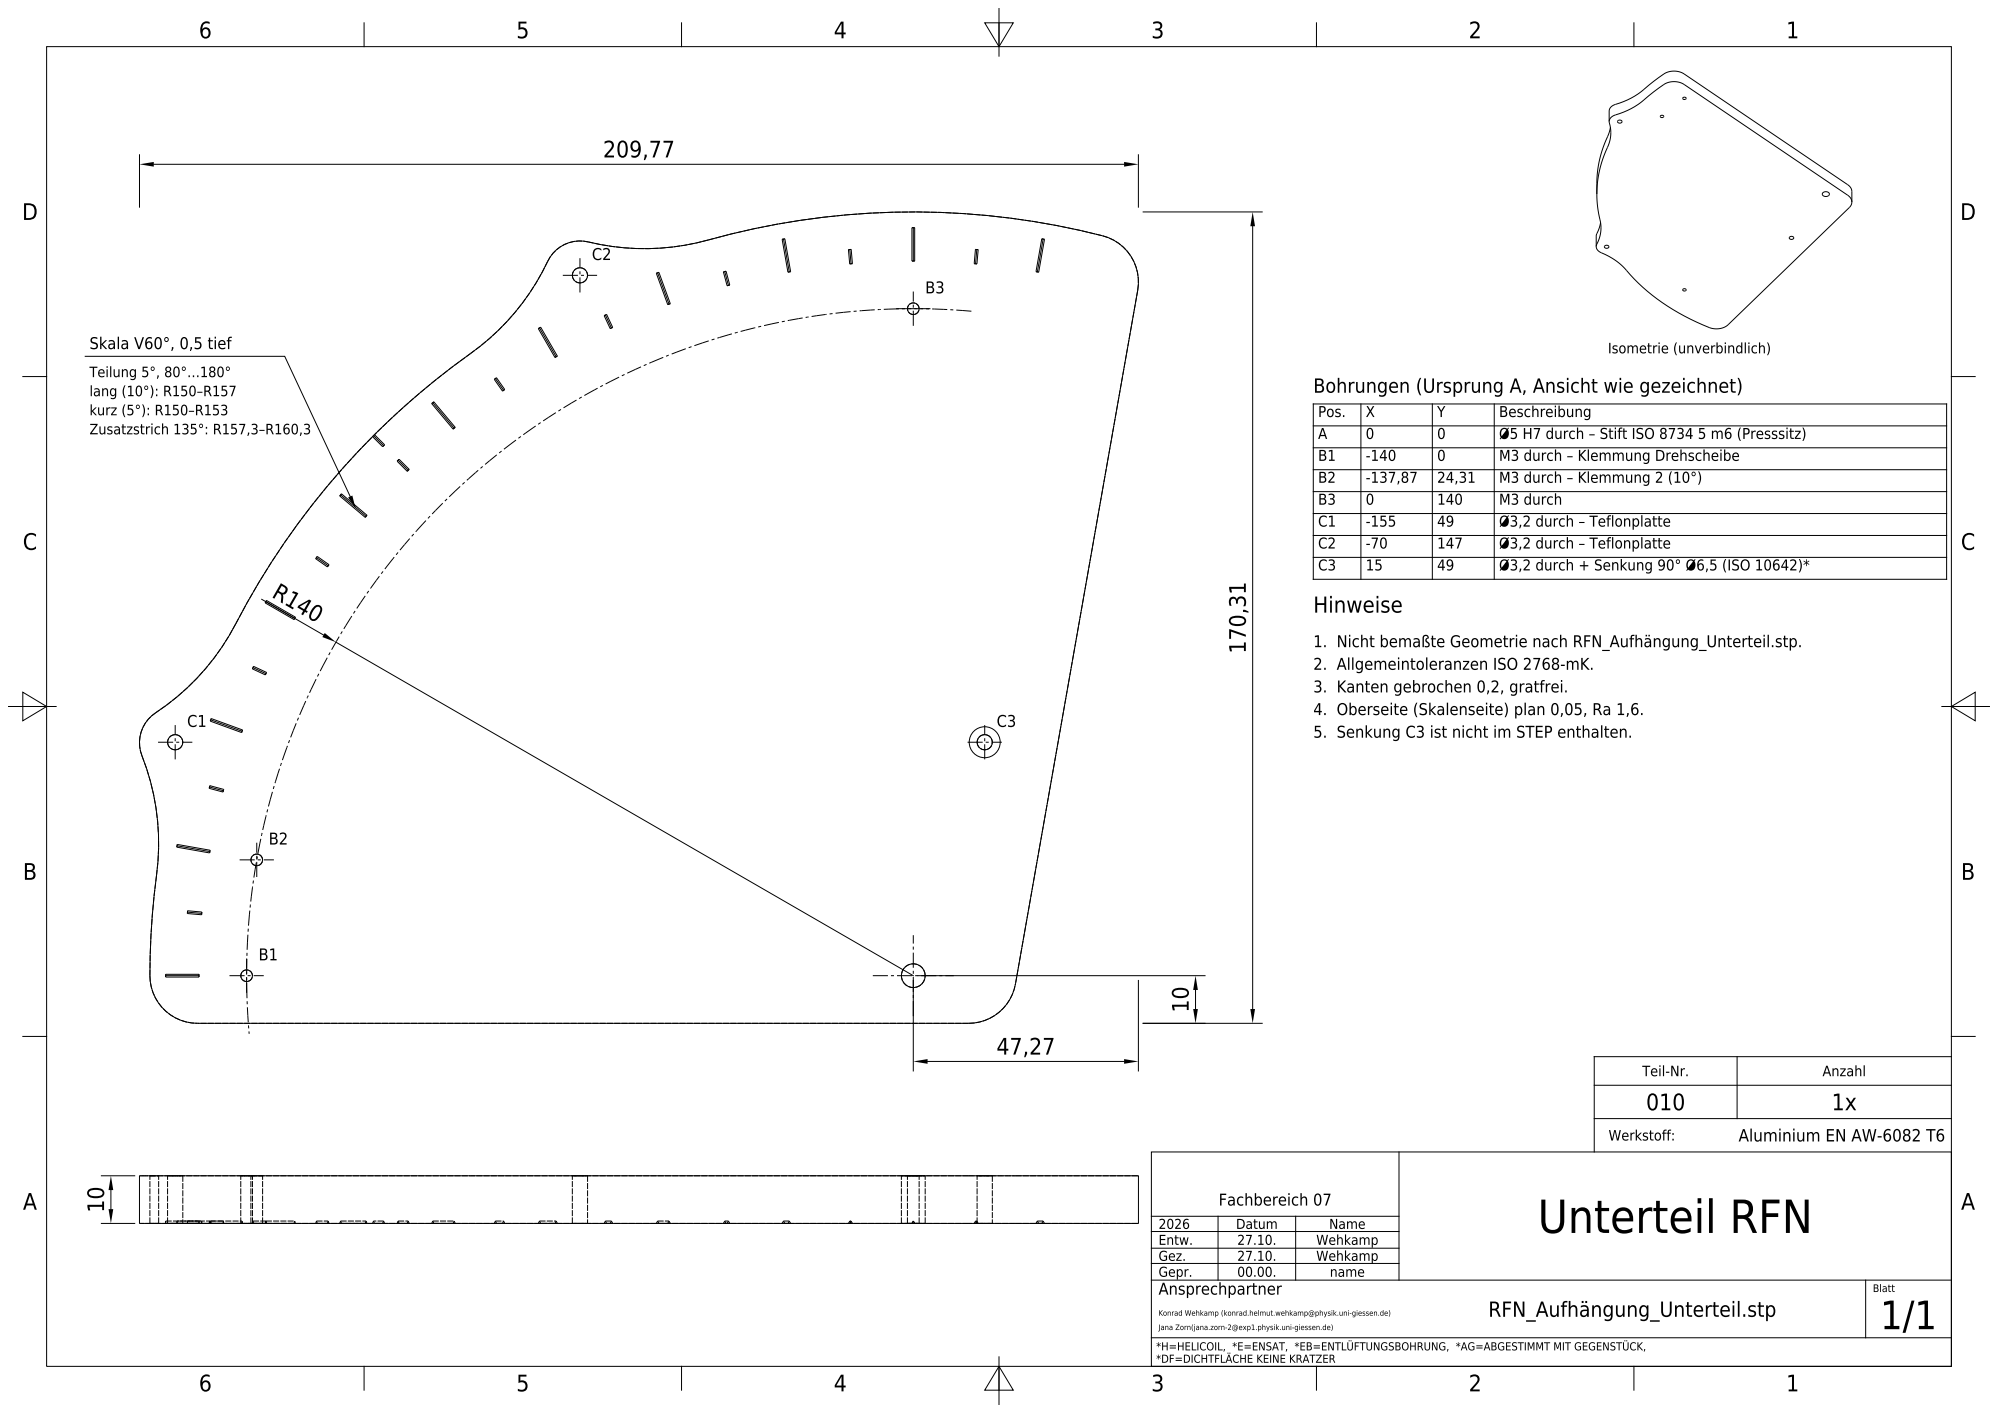
[picture p64: page 1]

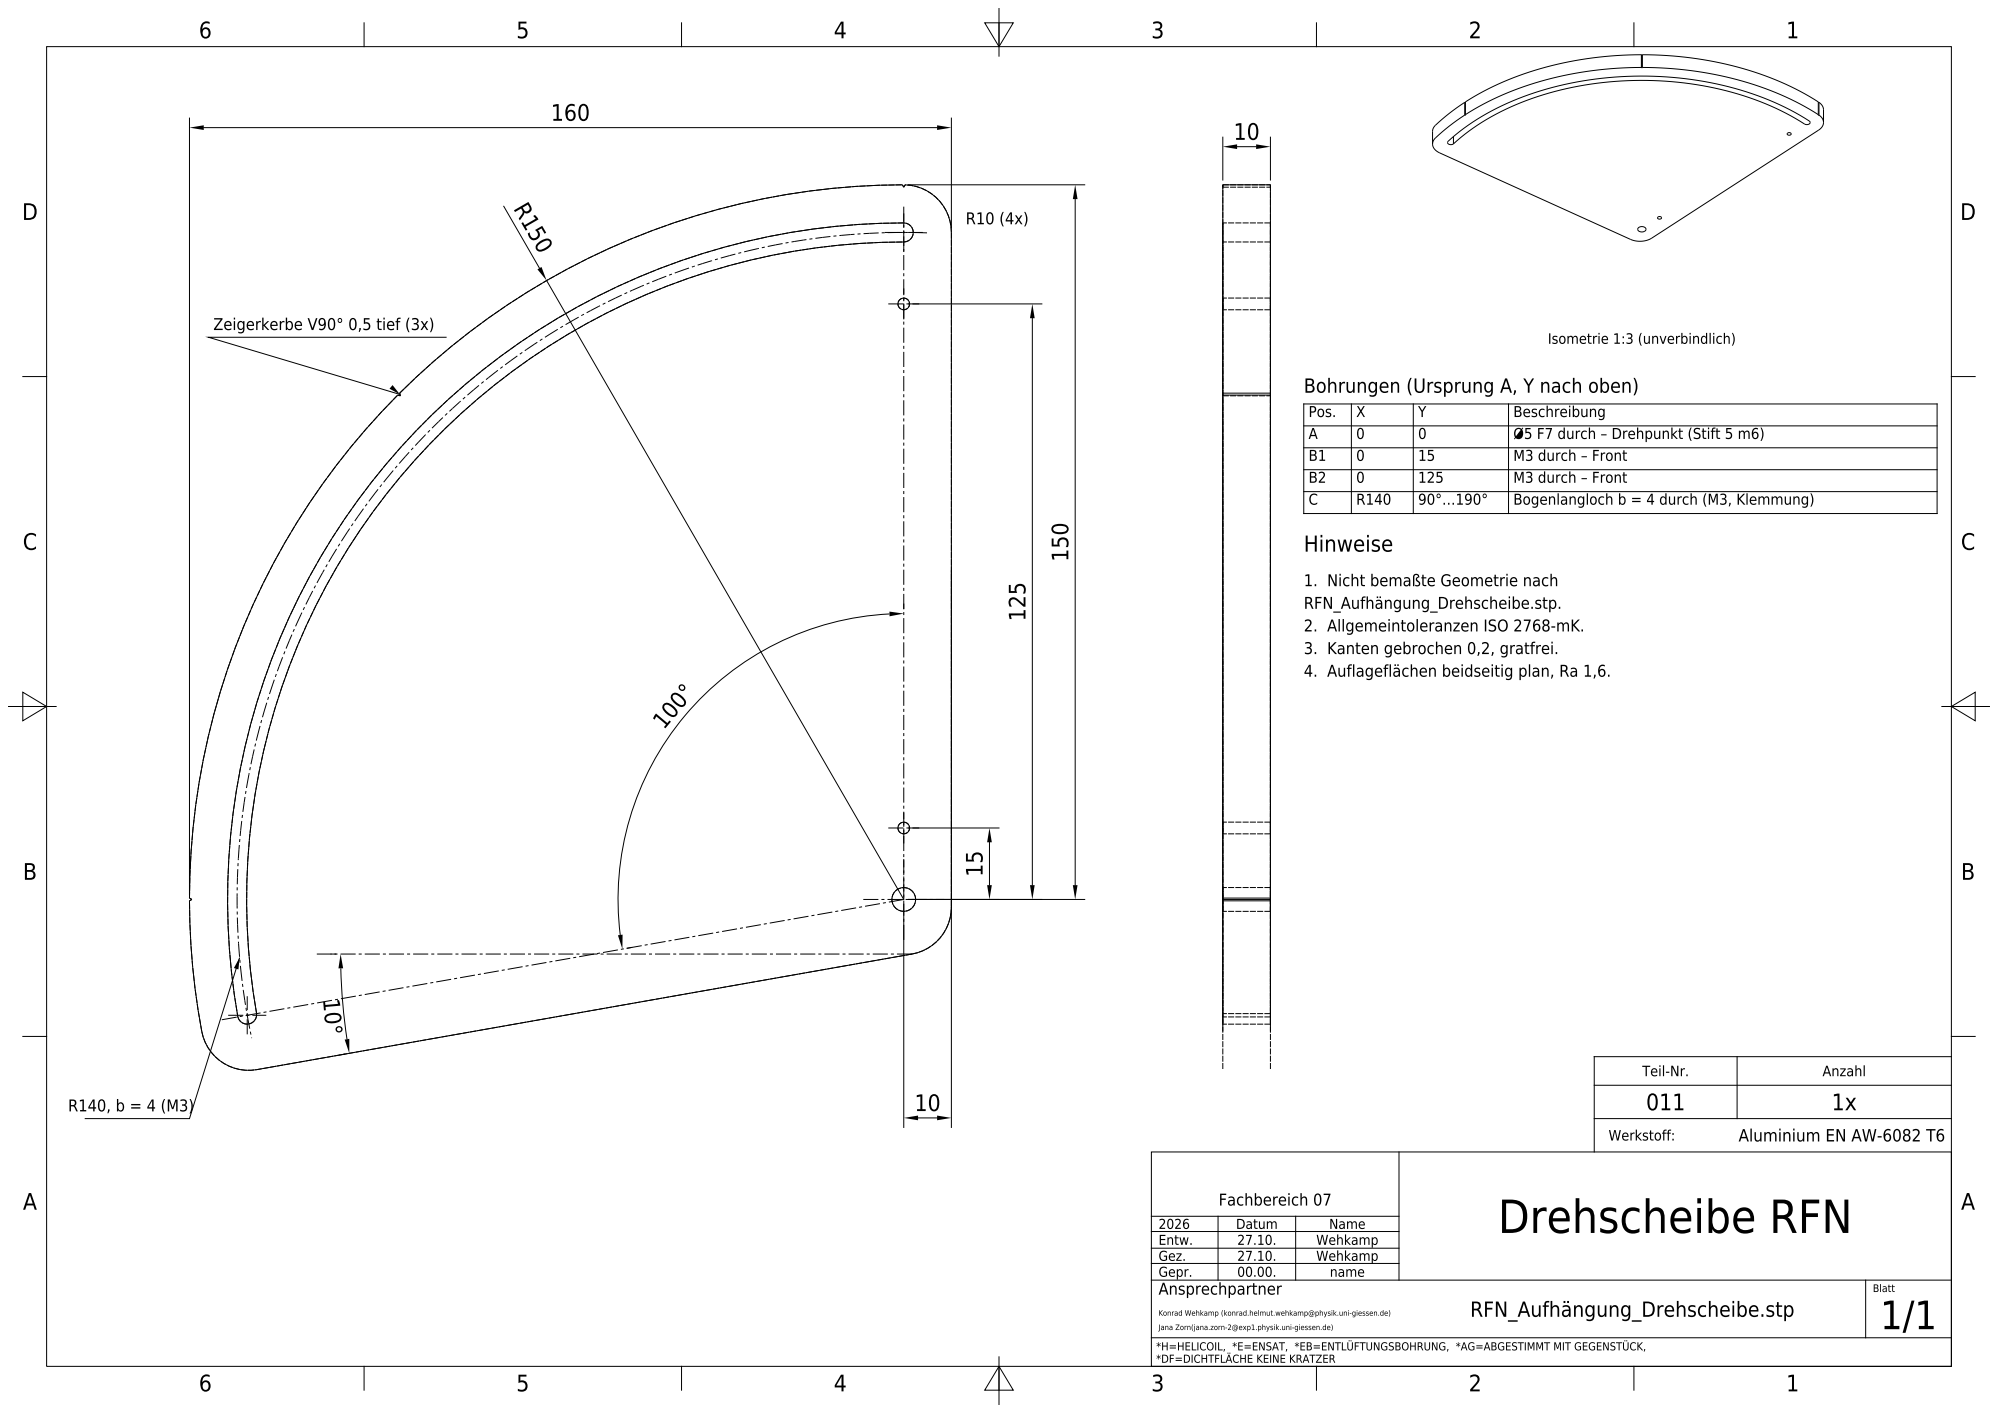
[picture p65: page 2]

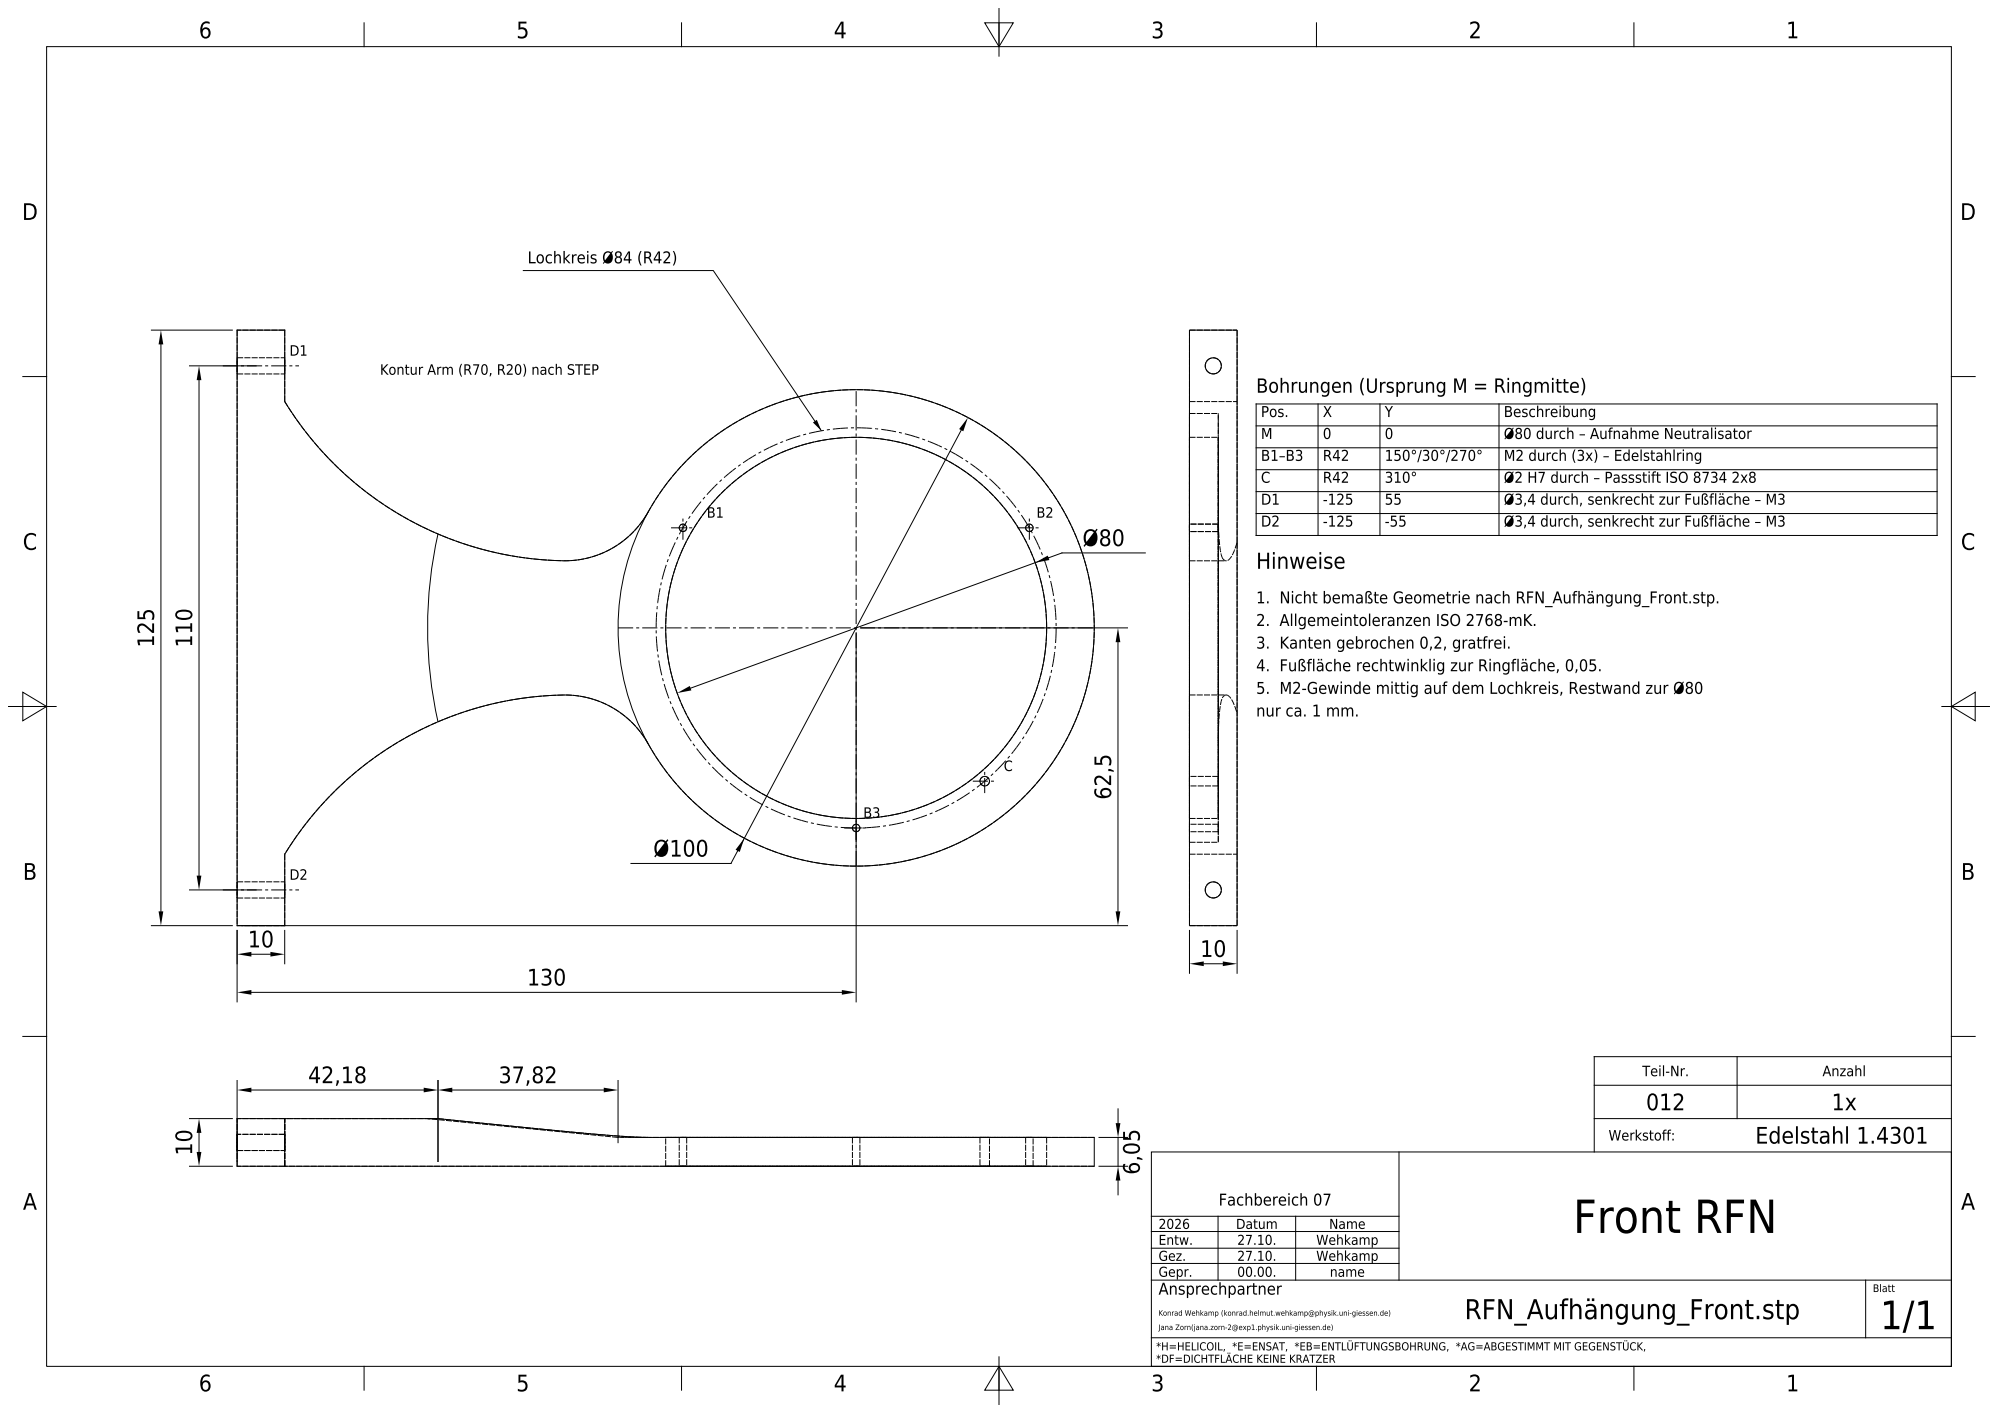
[picture p66: page 3]

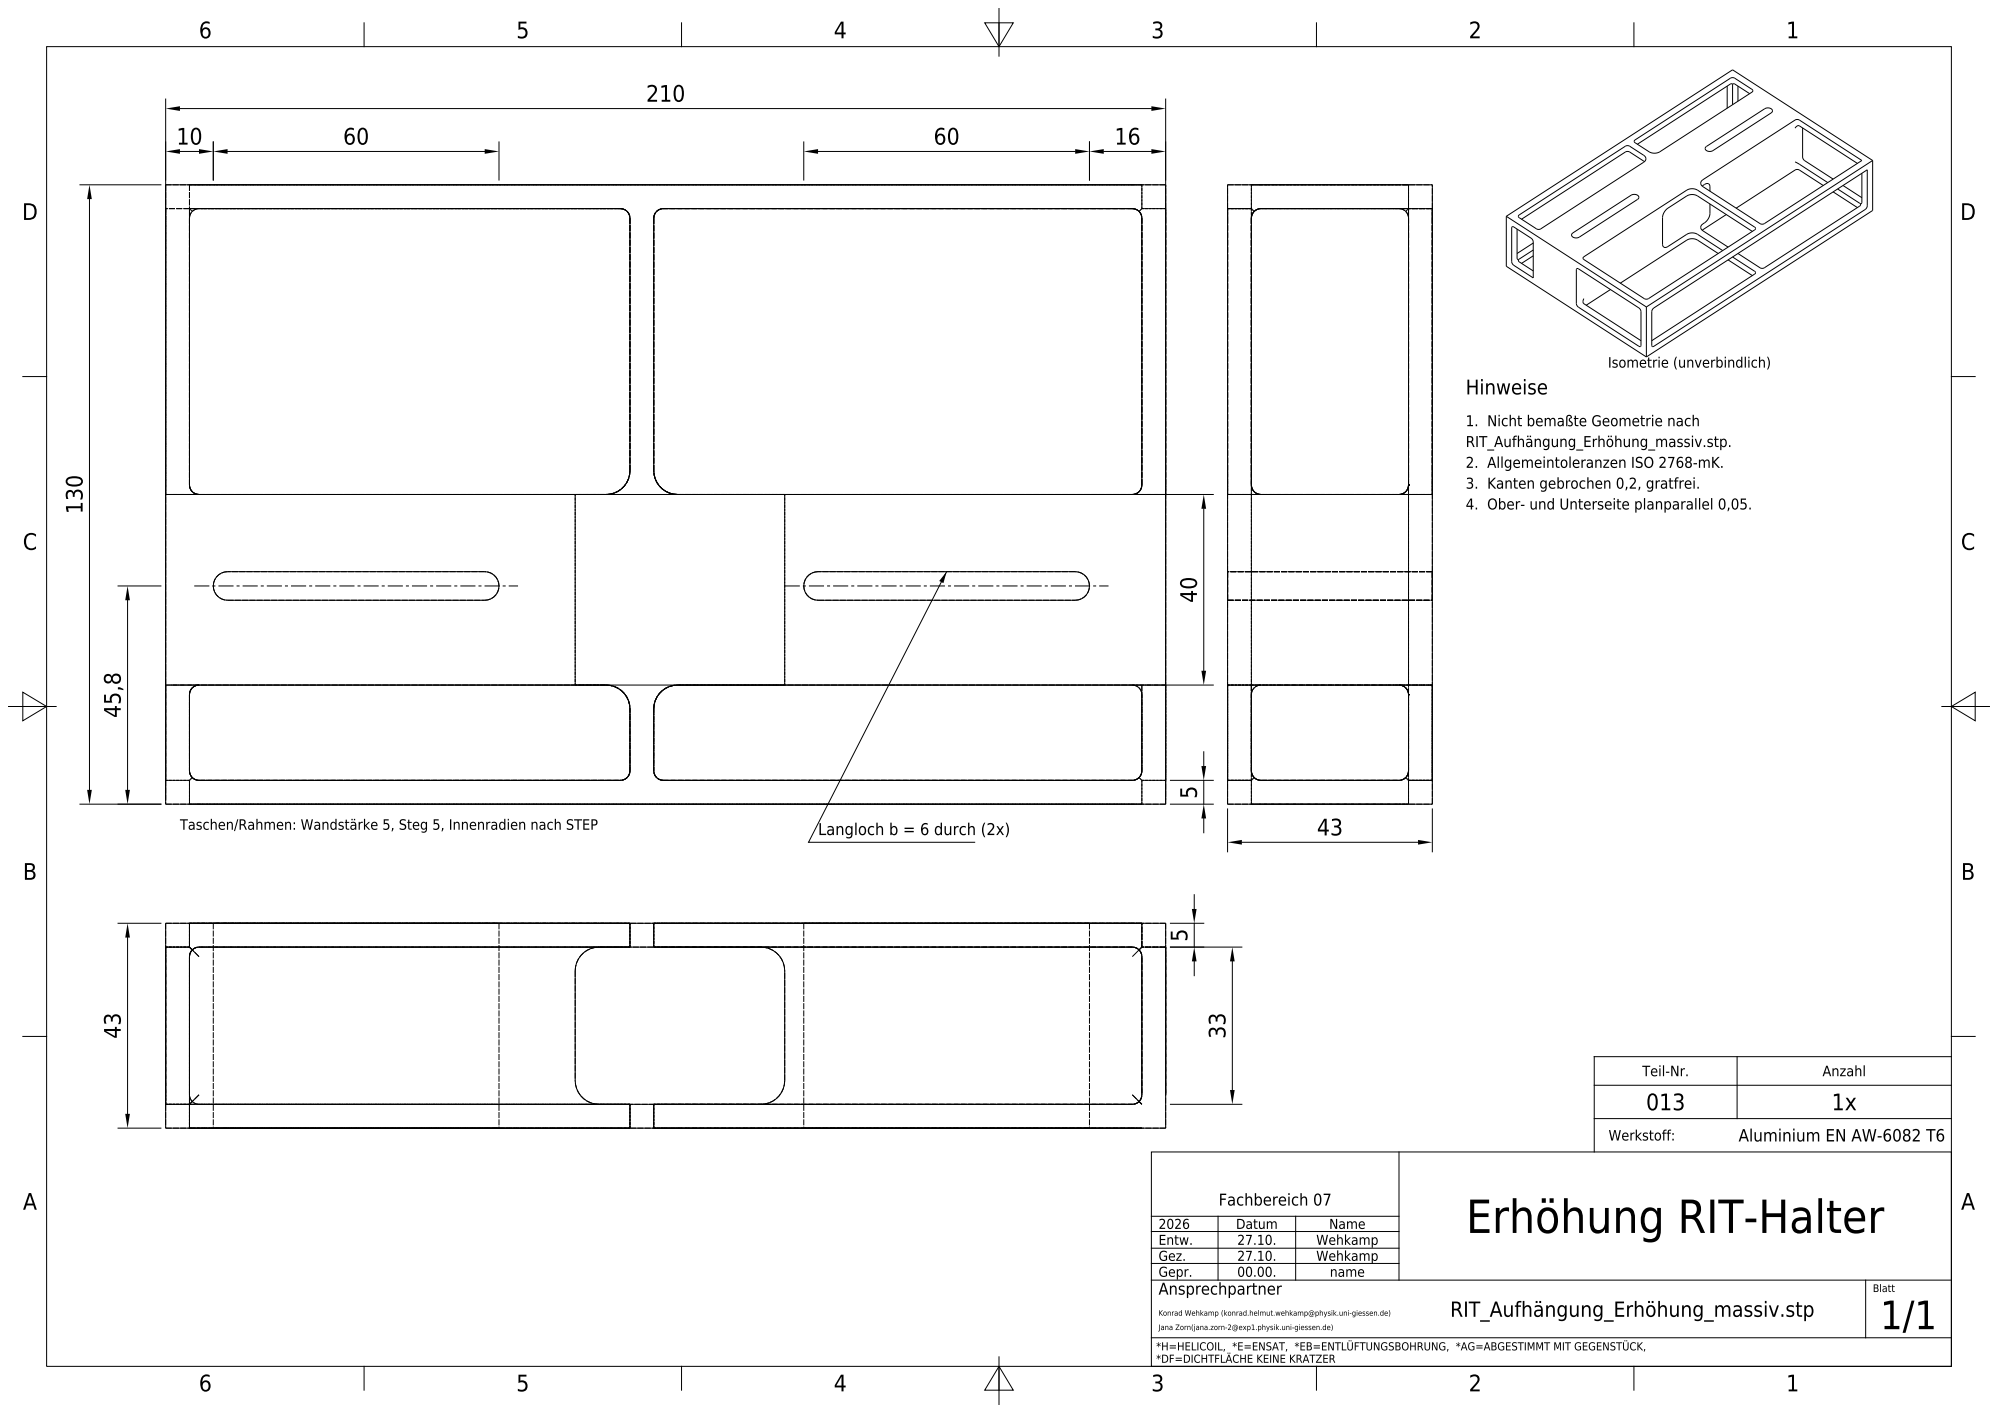
[picture p67: page 4]

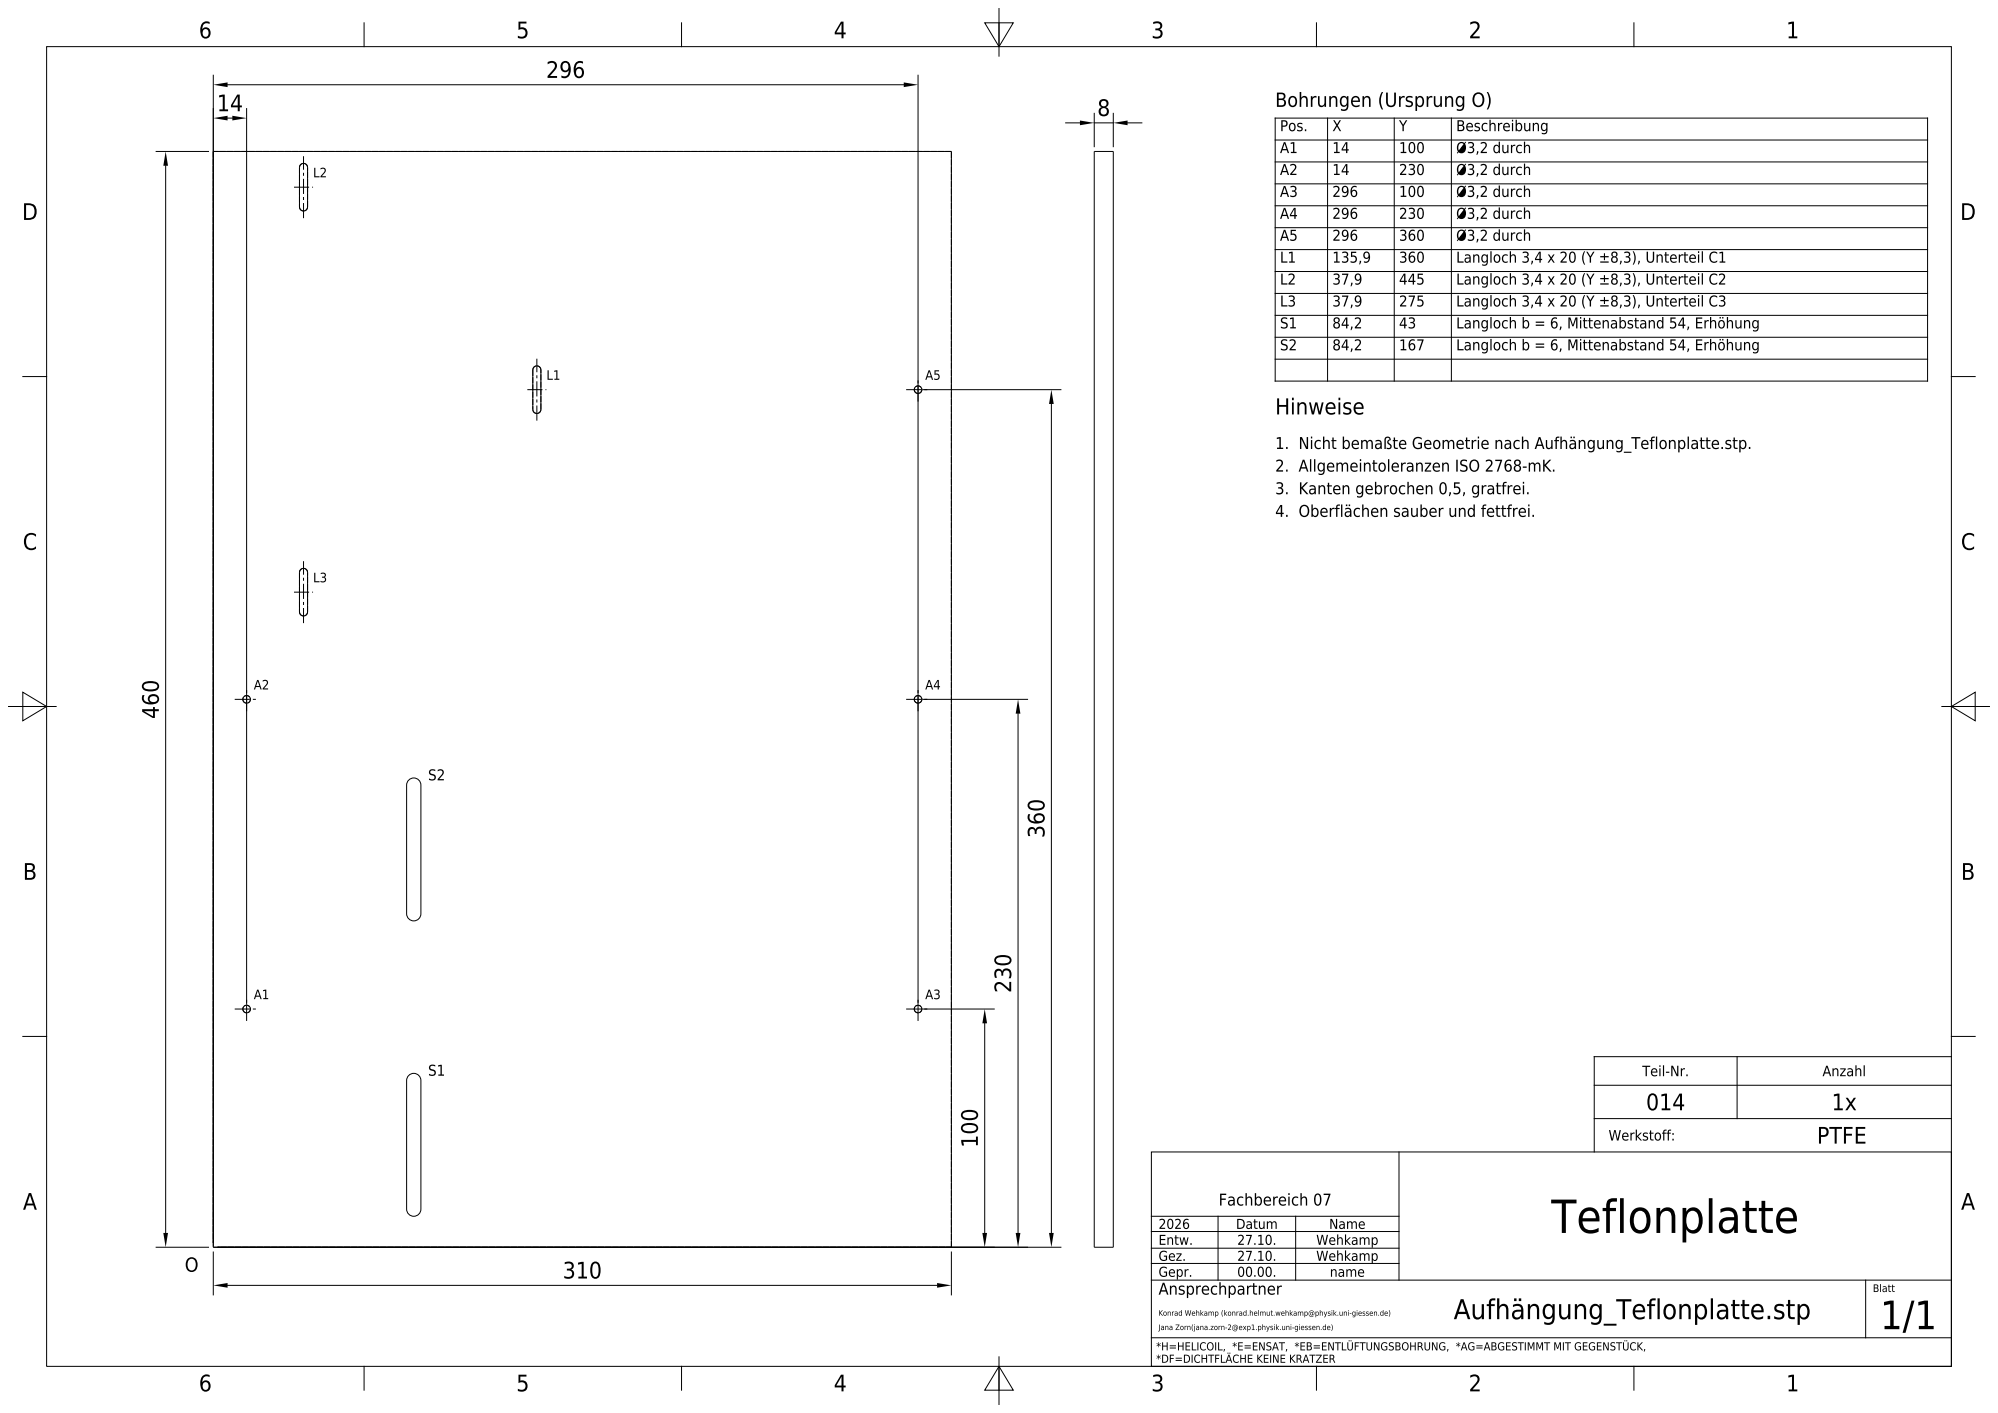
[picture p68: page 5]
