konradweh/ABEP_Koppeltest/Fertigung/RF-Neutralisator/Aufhaengung_Zeichnungssatz.pdf

D | D

6

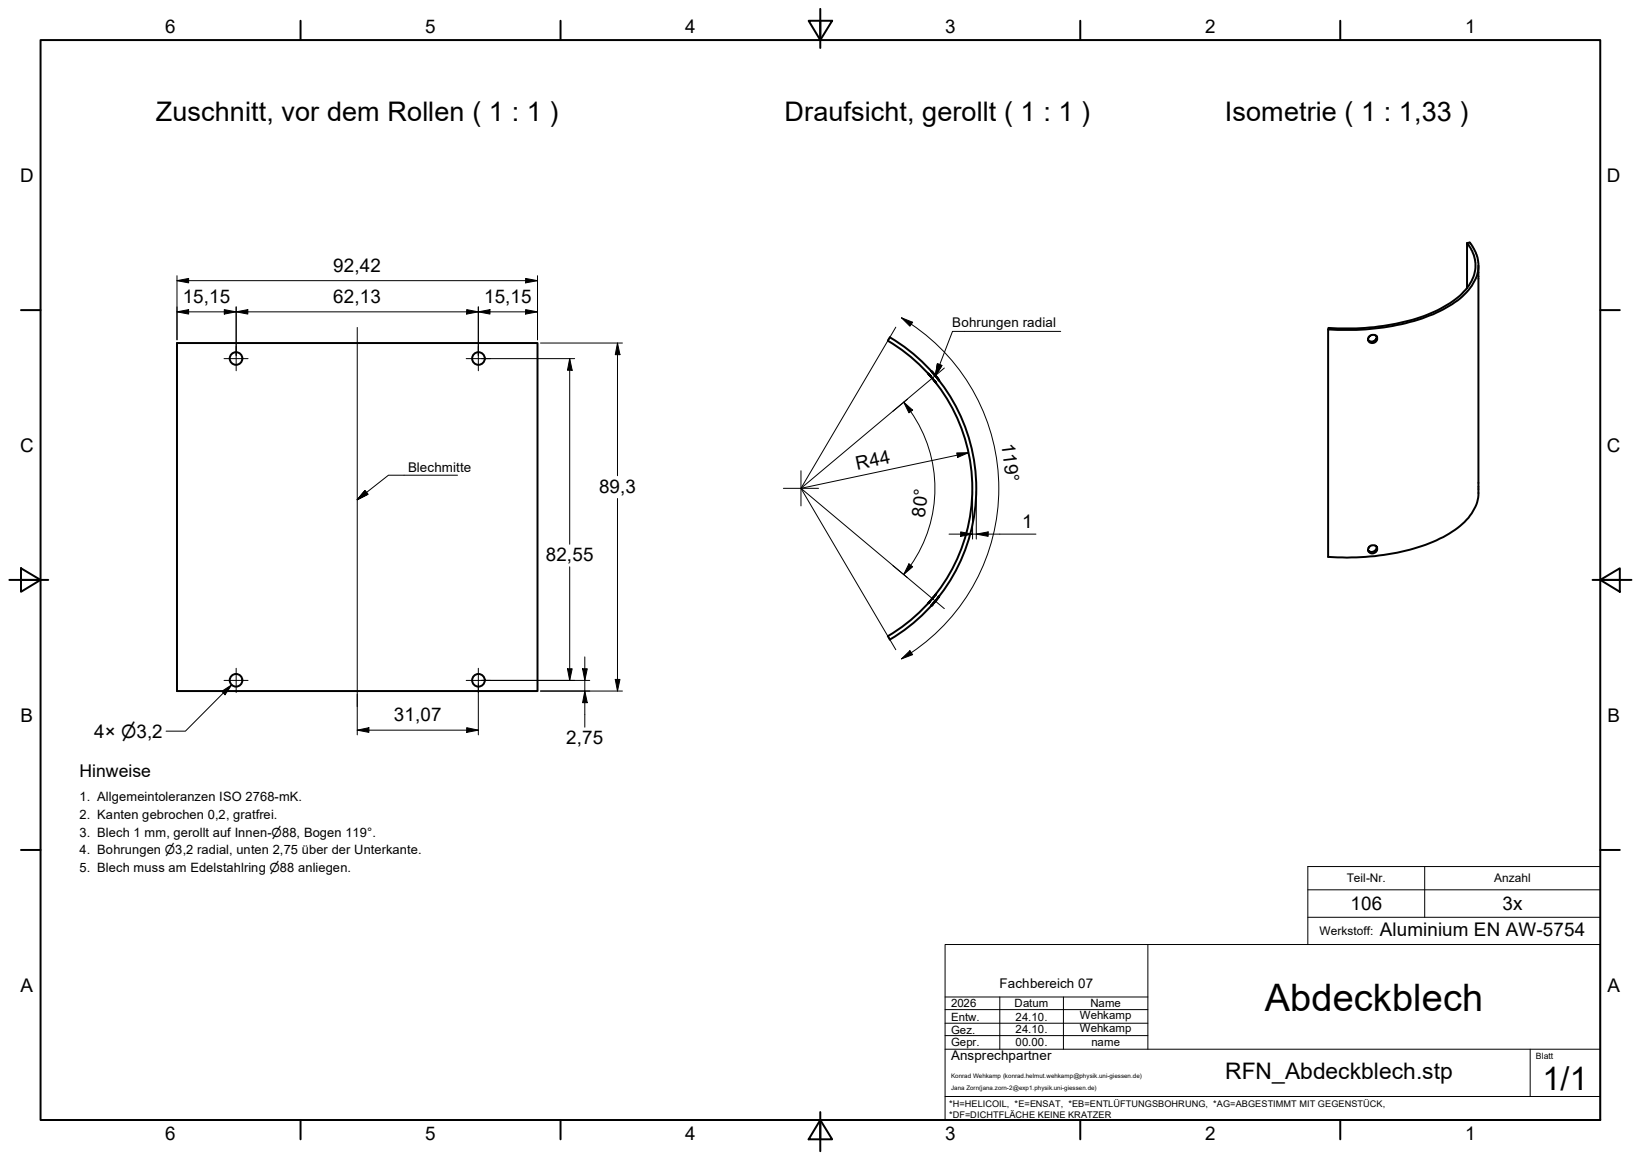
[picture p69: page 1]
Ansprechpartner; Fachbereich 07; Blatt; Werkstoff:; Anzahl; Draufsicht, gerollt ( 1 : 1 ); Blechmitte; RFN_Abdeckblech.stp; Abdeckblech; Gepr.; name; Isometrie ( 1 : 1,33 ); Datum; Name; Entw.; Wehkamp; Gez.; Bohrungen radial; Hinweise

Zuschnitt, vor dem Rollen ( 1 : 1 )

1. Allgemeintoleranzen ISO 2768-mK.
2. Kanten gebrochen 0,2, gratfrei.
3. Blech 1 mm, gerollt auf Innen-n88, Bogen 119°.
4. Bohrungen n3,2 radial, unten 2,75 über der Unterkante.
5. Blech muss am Edelstahlring n88 anliegen.

Teil-Nr.
Aluminium EN AW-5754

Konrad Wehkamp (konrad.helmut.wehkamp@physik.uni-giessen.de)

Jana Zorn(jana.zorn-2@exp1.physik.uni-giessen.de)
*H=HELICOIL, *E=ENSAT, *EB=ENTLÜFTUNGSBOHRUNG, *AG=ABGESTIMMT MIT GEGENSTÜCK,
*DF=DICHTFLÄCHE KEINE KRATZER

D | D

6

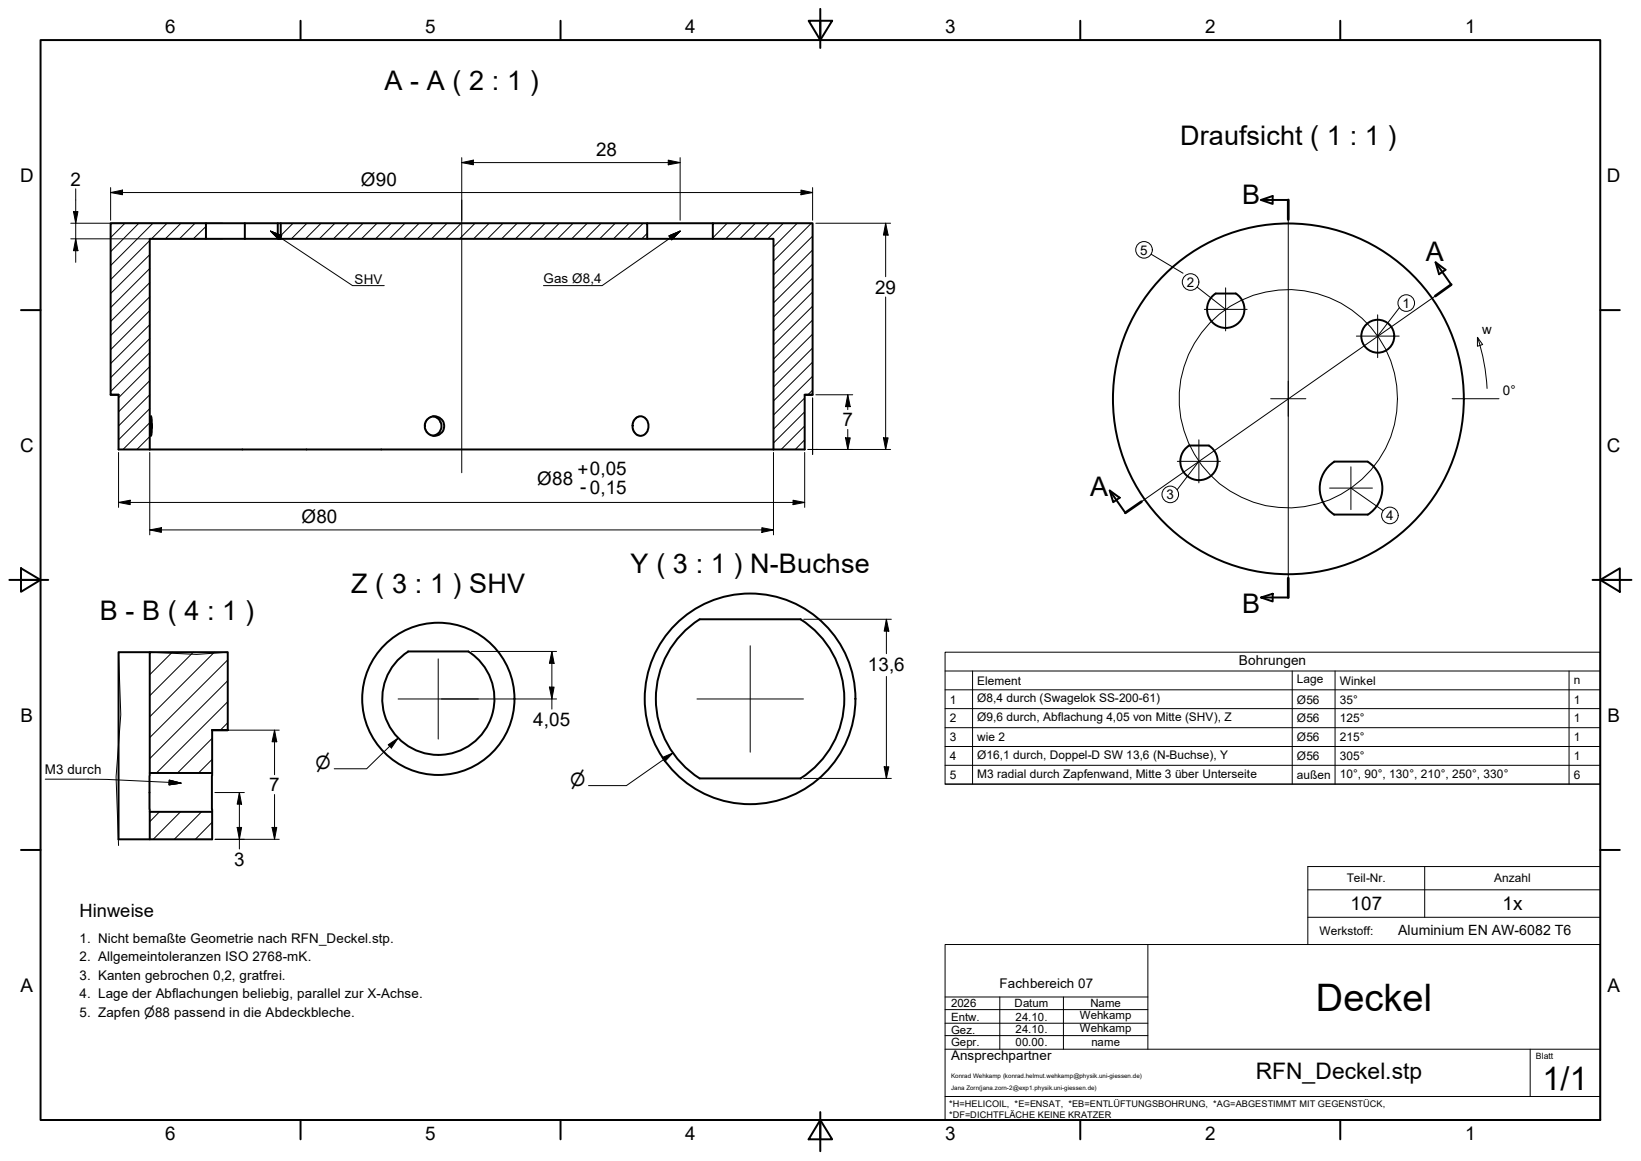
[picture p70: page 2]
Teil-Nr.; Anzahl; Fachbereich 07; Blatt; Werkstoff:; Ansprechpartner; Gez.; SHV; Wehkamp; M3 durch; Bohrungen; Element; Lage; Winkel; Ø8,4 durch (Swagelok SS-200-61); Ø9,6 durch, Abflachung 4,05 von Mitte (SHV), Z; wie 2; Ø16,1 durch, Doppel-D SW 13,6 (N-Buchse), Y; M3 radial durch Zapfenwand, Mitte 3 über Unterseite; außen; RFN_Deckel.stp; Z ( 3 : 1 ) SHV; Gepr.; name; Gas Ø8,4; Draufsicht ( 1 : 1 ); Y ( 3 : 1 ) N-Buchse; Entw.; Name; Datum; Hinweise

Aluminium EN AW-6082 T6
Deckel

1. Nicht bemaßte Geometrie nach RFN_Deckel.stp.
2. Allgemeintoleranzen ISO 2768-mK.
3. Kanten gebrochen 0,2, gratfrei.
4. Lage der Abflachungen beliebig, parallel zur X-Achse.
5. Zapfen n88 passend in die Abdeckbleche.

Konrad Wehkamp (konrad.helmut.wehkamp@physik.uni-giessen.de)

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

4 | 3
2

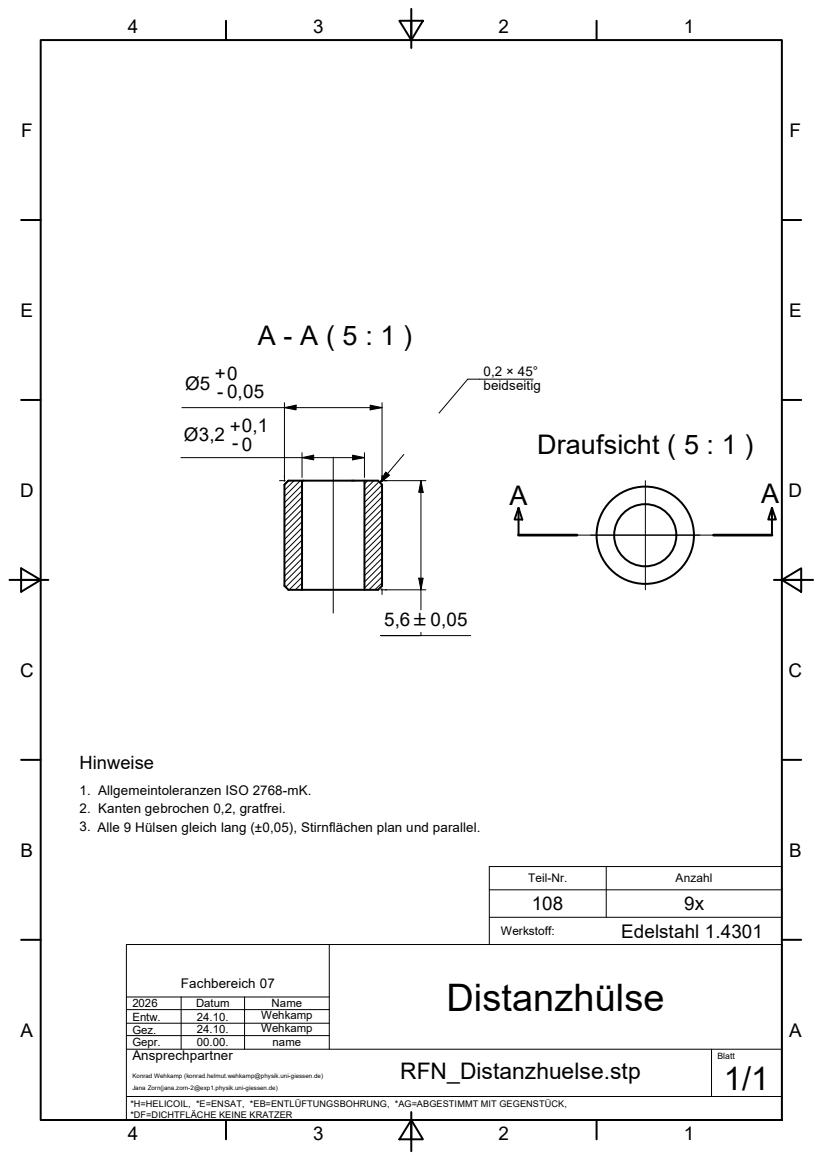
[picture p71: page 3]
Fachbereich 07; Teil-Nr.; Werkstoff:; Anzahl; Ansprechpartner; Blatt; Wehkamp; name; Draufsicht ( 5 : 1 ); Gepr.; Gez.; 24.10. Wehkamp; Entw.; Name; 0,2 × 45° beidseitig; Datum; Edelstahl 1.4301; Hinweise; RFN_Distanzhuelse.stp; Distanzhülse

1. Allgemeintoleranzen ISO 2768-mK.
2. Kanten gebrochen 0,2, gratfrei.
3. Alle 9 Hülsen gleich lang (±0,05), Stirnflächen plan und parallel.

Konrad Wehkamp (konrad.helmut.wehkamp@physik.uni-giessen.de)

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

6

5

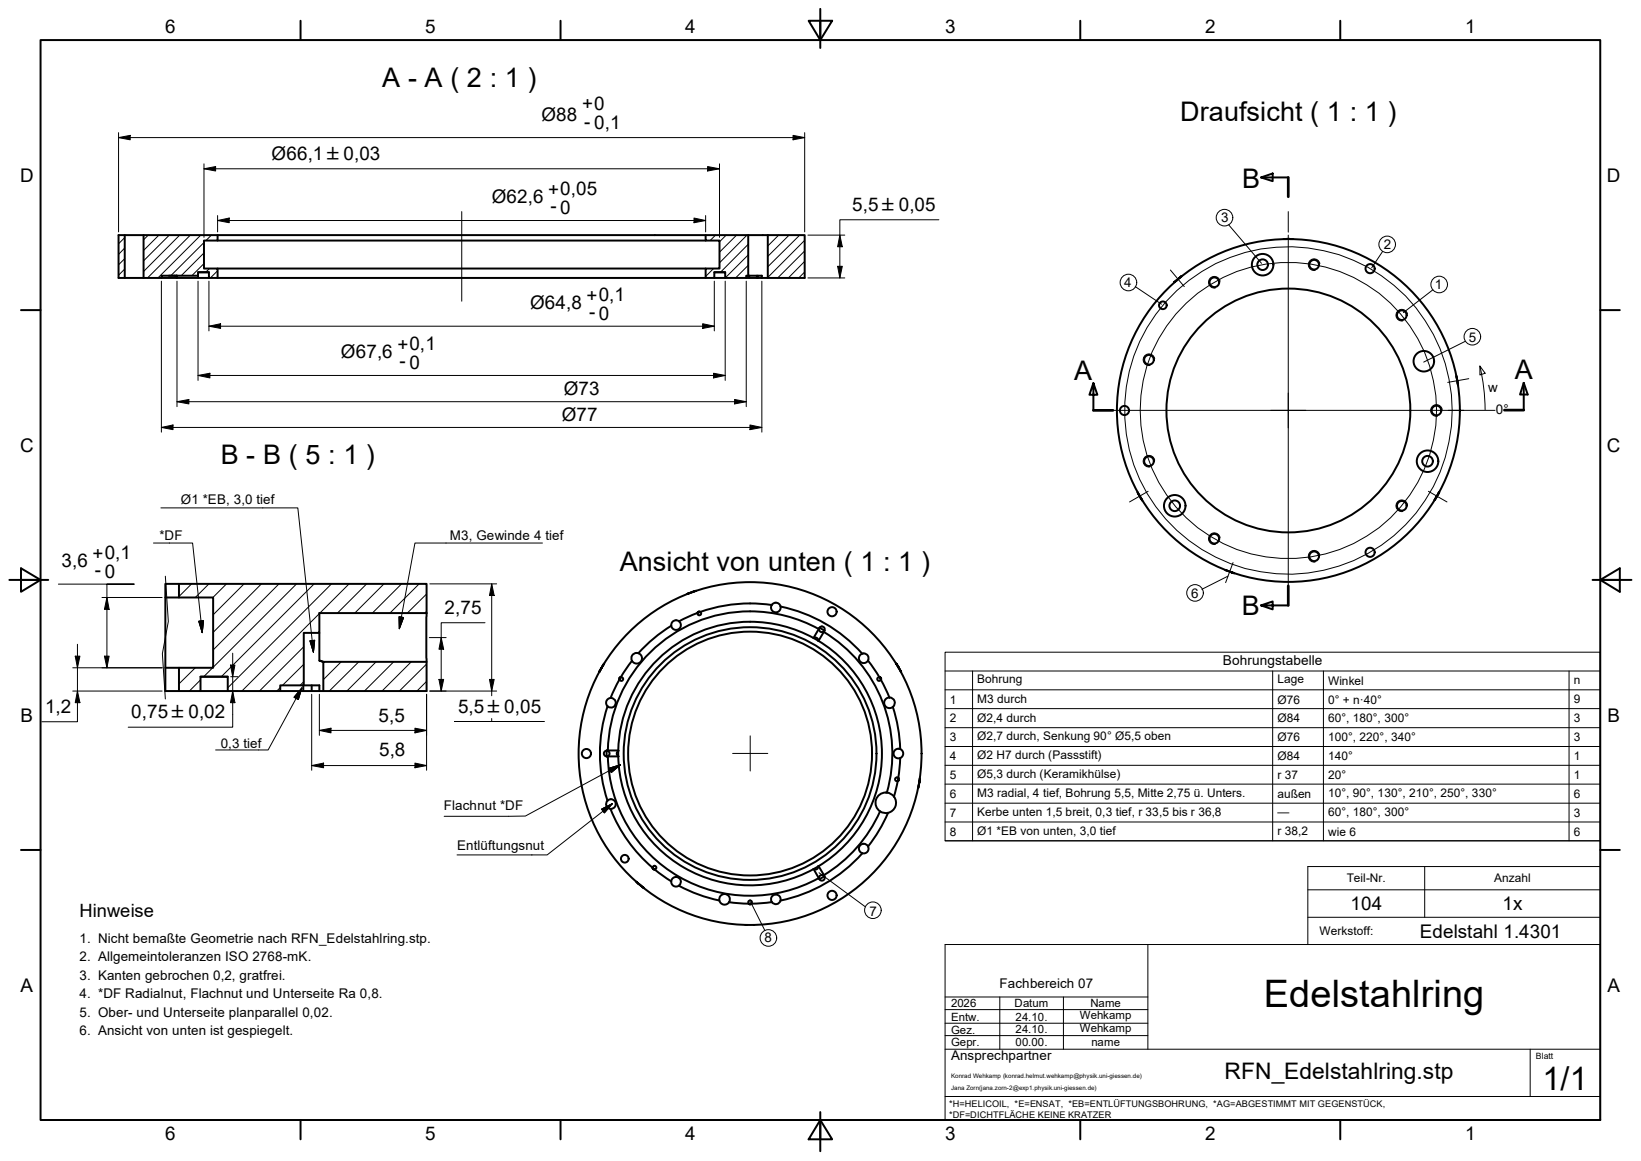
[picture p72: page 4]
Werkstoff:; Blatt; Anzahl; Ansprechpartner; Fachbereich 07; Teil-Nr.; RFN_Edelstahlring.stp; Edelstahlring; Entlüftungsnut; Flachnut *DF; Bohrungstabelle; Bohrung; Lage; Winkel; M3 durch; Ø2,4 durch; Ø2,7 durch, Senkung 90° Ø5,5 oben; Ø2 H7 durch (Passstift); Ø5,3 durch (Keramikhülse); M3 radial, 4 tief, Bohrung 5,5, Mitte 2,75 ü. Unters.; außen; Kerbe unten 1,5 breit, 0,3 tief, r 33,5 bis r 36,8; Ø1 *EB von unten, 3,0 tief; wie 6; Gepr.; name; Edelstahl 1.4301; Draufsicht ( 1 : 1 ); 0,3 tief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

Ansicht von unten ( 1 : 1 )

1. Nicht bemaßte Geometrie nach RFN_Edelstahlring.stp.
2. Allgemeintoleranzen ISO 2768-mK.
3. Kanten gebrochen 0,2, gratfrei.
4. *DF Radialnut, Flachnut und Unterseite Ra 0,8.
5. Ober- und Unterseite planparallel 0,02.
6. Ansicht von unten ist gespiegelt.

2026 | Datum | Name
Entw. | 24.10. | Wehkamp
Gez. | 24.10. | Wehkamp

Konrad Wehkamp (konrad.helmut.wehkamp@physik.uni-giessen.de)

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

4 | 3
2

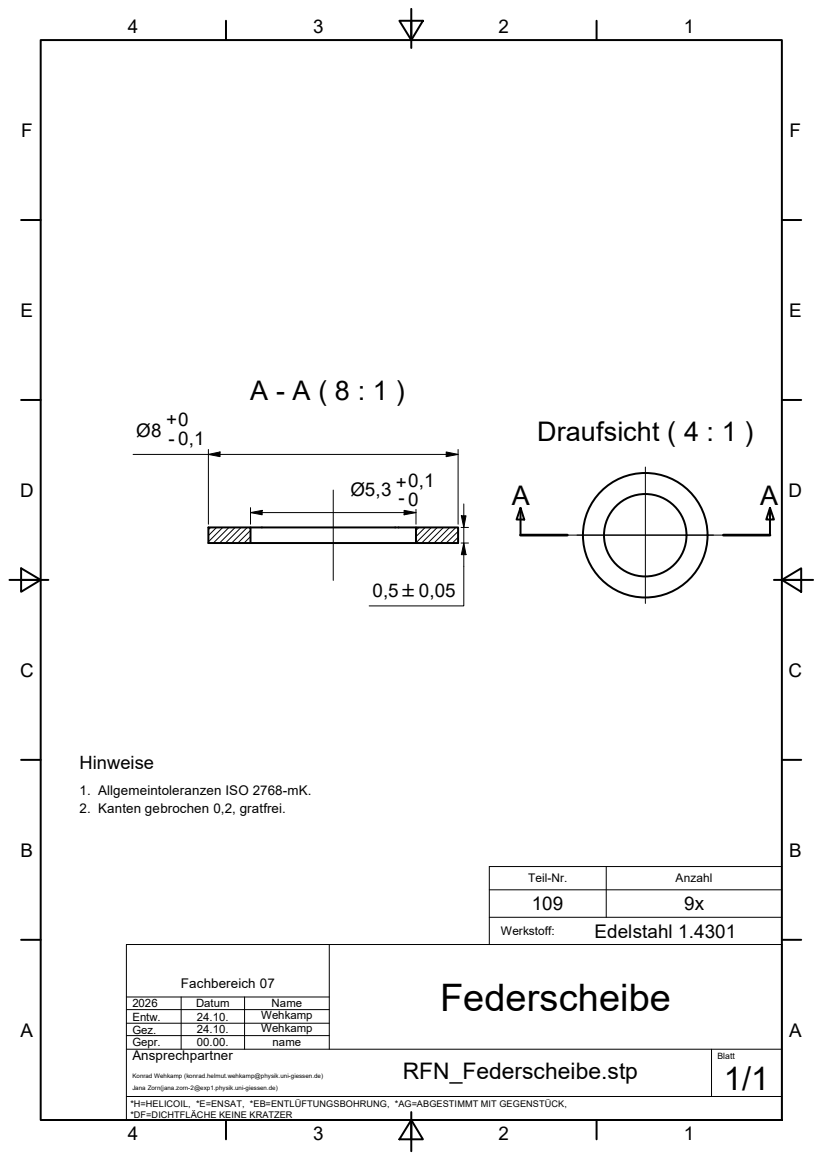
[picture p73: page 5]
Fachbereich 07; Blatt; Teil-Nr.; Werkstoff:; Anzahl; Ansprechpartner; Datum; Name; RFN_Federscheibe.stp; Federscheibe; Wehkamp; name; Draufsicht ( 4 : 1 ); Gepr.; Gez.; Entw.; Edelstahl 1.4301; Hinweise

1. Allgemeintoleranzen ISO 2768-mK.
2. Kanten gebrochen 0,2, gratfrei.

Konrad Wehkamp (konrad.helmut.wehkamp@physik.uni-giessen.de)

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

3
2

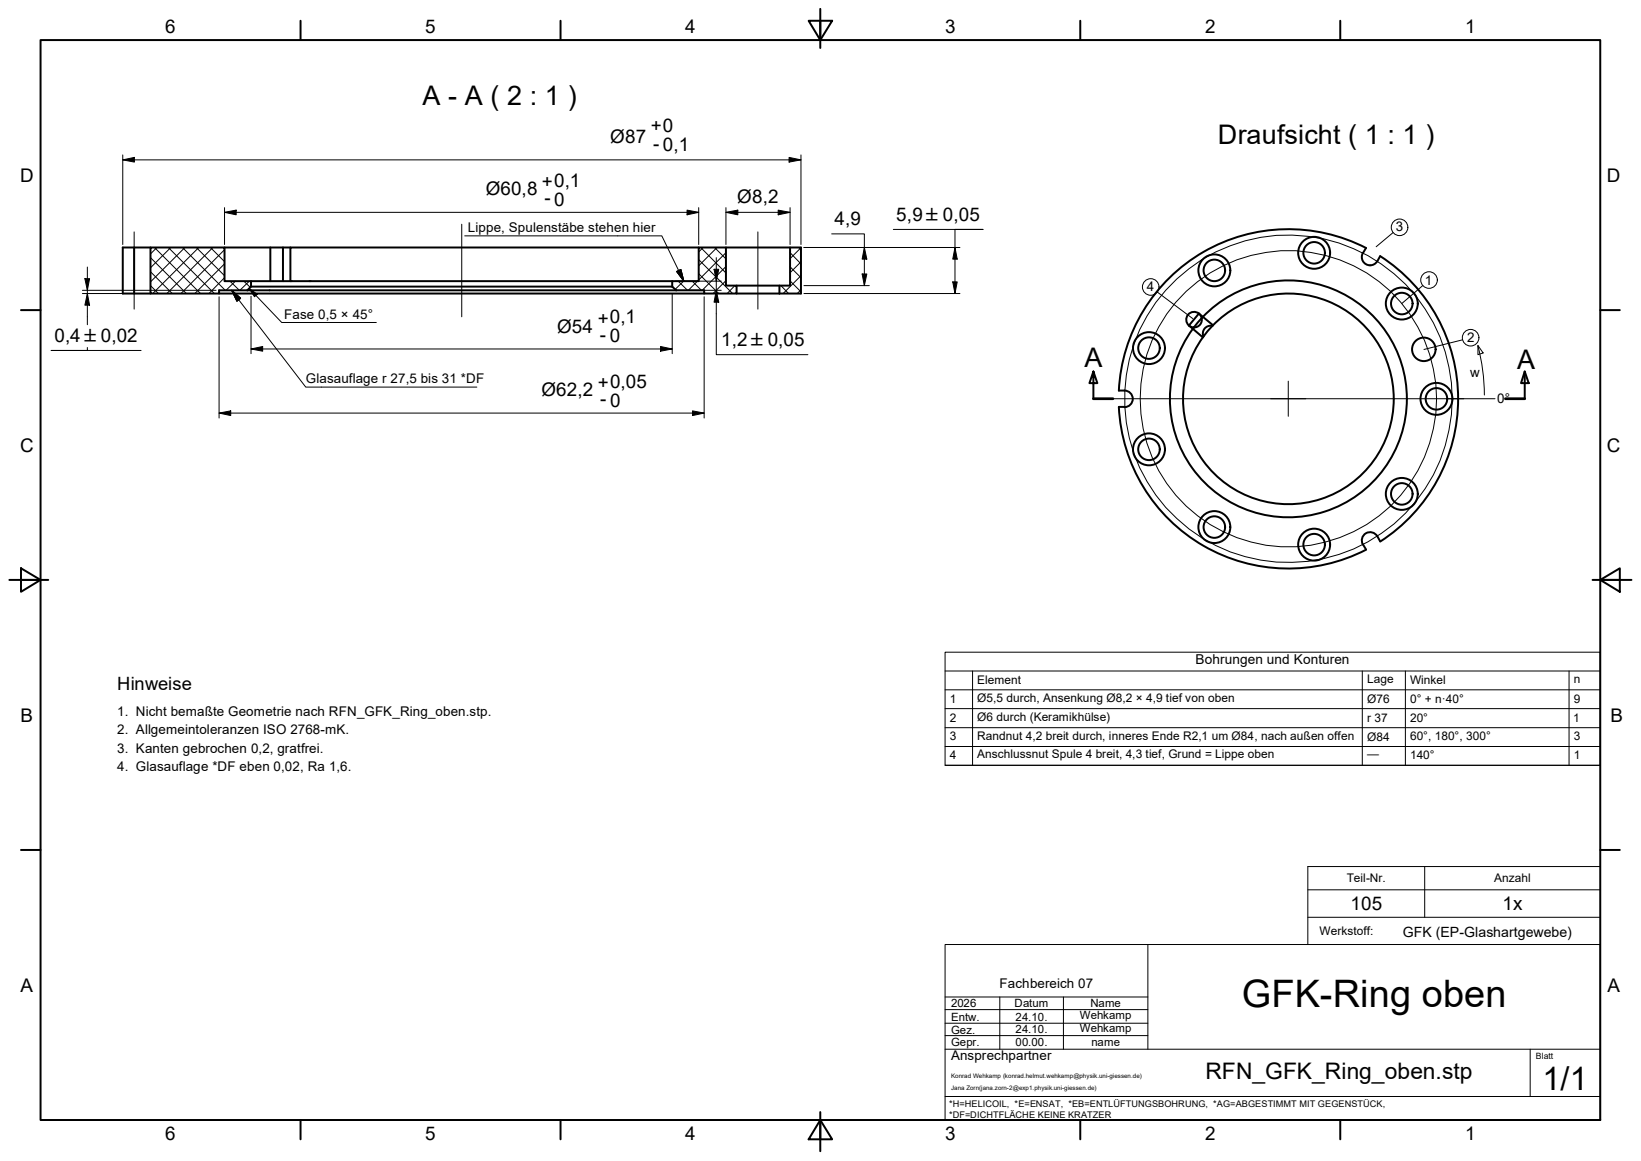
[picture p74: page 6]
Ansprechpartner; Blatt; Fachbereich 07; Teil-Nr.; Anzahl; 00.00. name; Element; Lage; Winkel; Ø5,5 durch, Ansenkung Ø8,2 × 4,9 tief von oben; Ø6 durch (Keramikhülse); Randnut 4,2 breit durch, inneres Ende R2,1 um Ø84, nach außen offen; Anschlussnut Spule 4 breit, 4,3 tief, Grund = Lippe oben; Gepr.; Wehkamp; Draufsicht ( 1 : 1 ); Gez.; 24.10. Wehkamp; Fase 0,5 × 45°; Entw.; Name; Datum; RFN_GFK_Ring_oben.stp; Hinweise

Lippe, Spulenstäbe stehen hier

Glasauflage r 27,5 bis 31 *DF

Bohrungen und Konturen

1. Nicht bemaßte Geometrie nach RFN_GFK_Ring_oben.stp.
2. Allgemeintoleranzen ISO 2768-mK.
3. Kanten gebrochen 0,2, gratfrei.
4. Glasauflage *DF eben 0,02, Ra 1,6.

Werkstoff:
GFK-Ring oben

GFK (EP-Glashartgewebe)

Konrad Wehkamp (konrad.helmut.wehkamp@physik.uni-giessen.de)

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

4 | 3
2

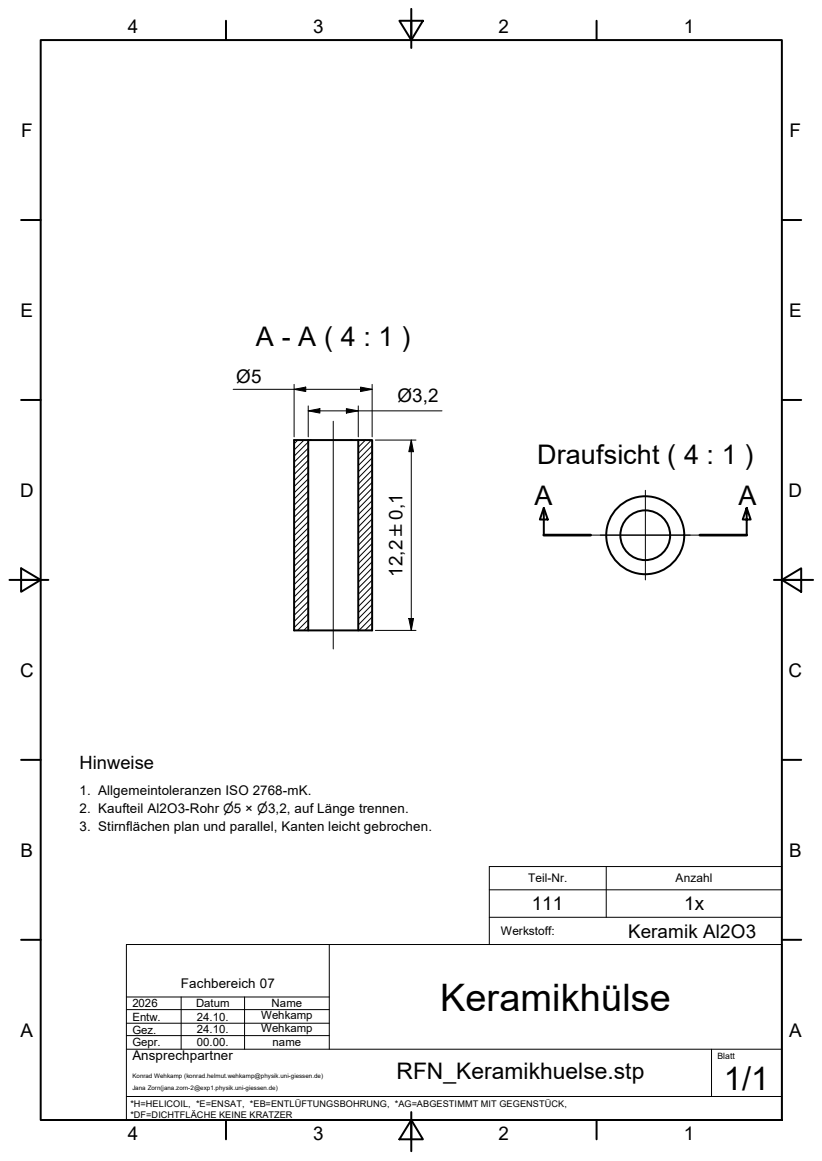
[picture p75: page 7]
Fachbereich 07; Blatt; Teil-Nr.; Werkstoff:; Anzahl; Ansprechpartner; Datum; Name; RFN_Keramikhuelse.stp; Keramikhülse; Gez.; name; Draufsicht ( 4 : 1 ); Gepr.; Wehkamp; 24.10. Wehkamp; Entw.; Keramik Al2O3; Hinweise

1. Allgemeintoleranzen ISO 2768-mK.
2. Kaufteil Al2O3-Rohr n5 × n3,2, auf Länge trennen.
3. Stirnflächen plan und parallel, Kanten leicht gebrochen.

Konrad Wehkamp (konrad.helmut.wehkamp@physik.uni-giessen.de)

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

5 | 4

3

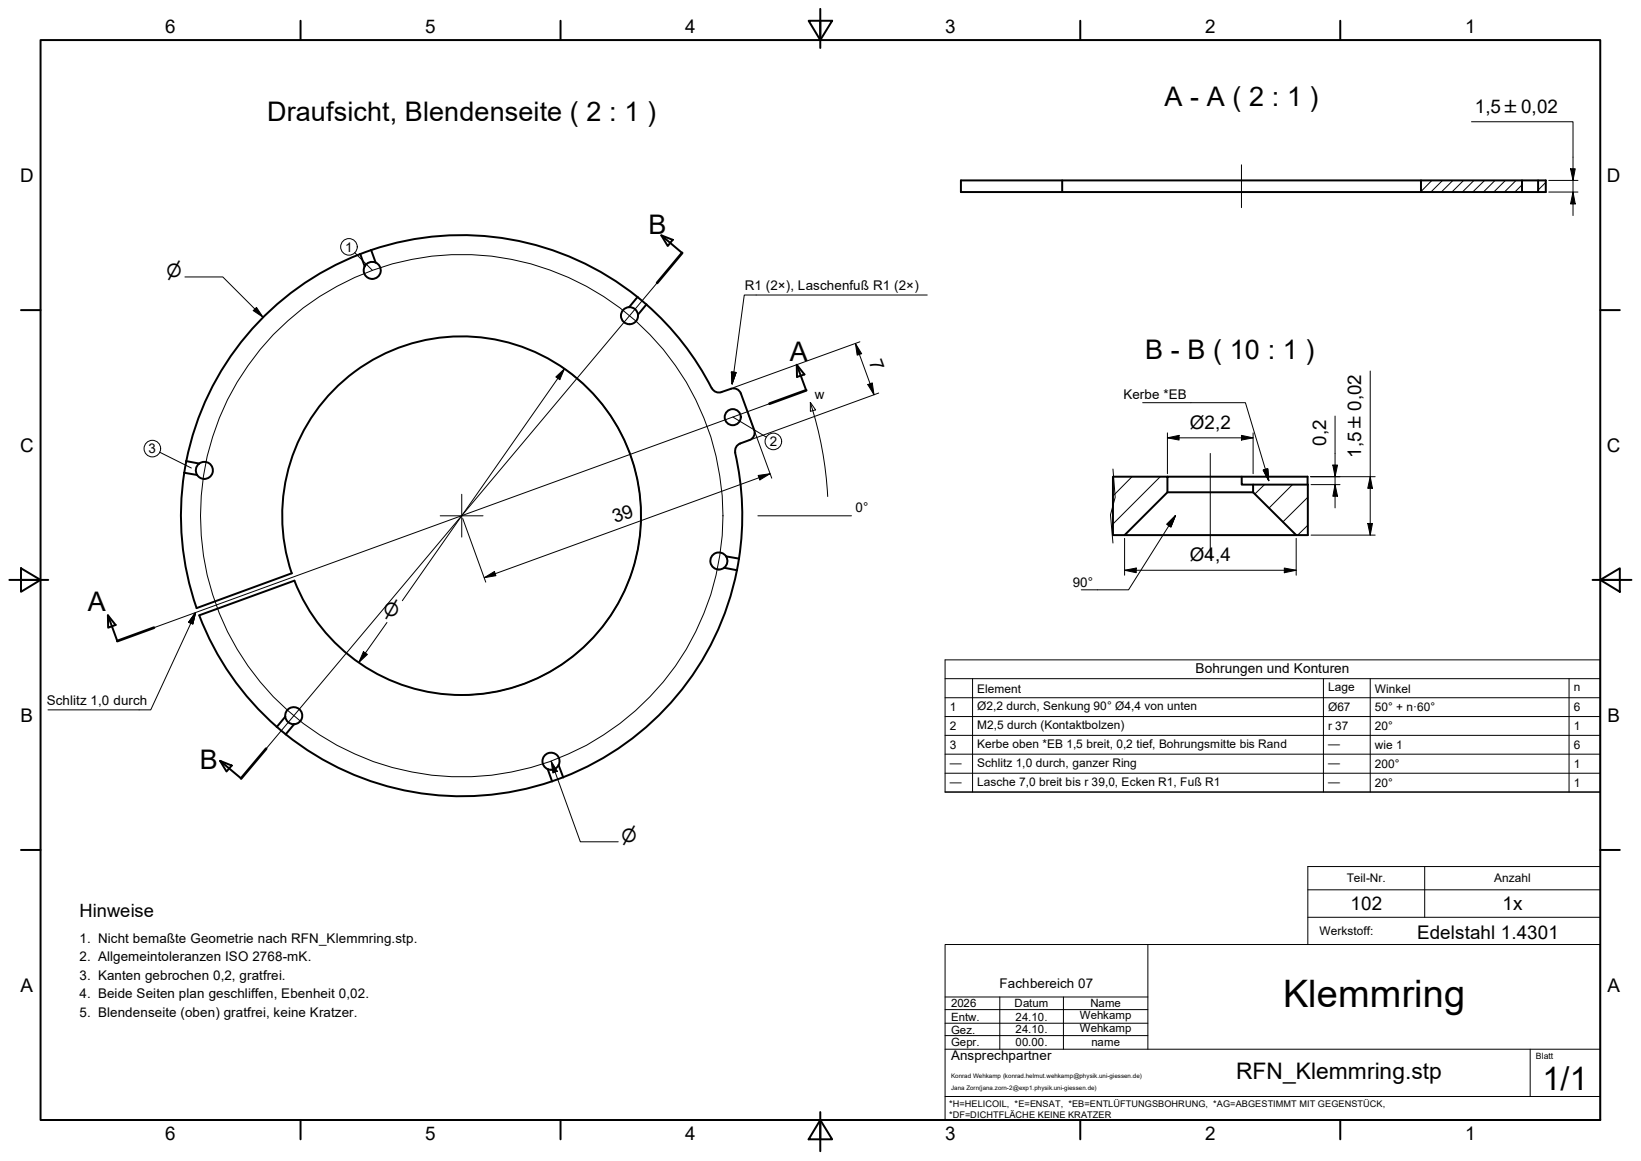
[picture p76: page 8]
Werkstoff:; Teil-Nr.; Fachbereich 07; Ansprechpartner; Blatt; Anzahl; Schlitz 1,0 durch; R1 (2×), Laschenfuß R1 (2×); Kerbe *EB; Draufsicht, Blendenseite ( 2 : 1 ); RFN_Klemmring.stp; Klemmring; Gepr.; name; Gez.; Wehkamp; Entw.; Edelstahl 1.4301; Datum; Name; Hinweise

Bohrungen und Konturen

Element | Lage | Winkel | n
1 | Ø2,2 durch, Senkung 90° Ø4,4 von unten | Ø67 | 50° + n·60° | 6
2 | M2,5 durch (Kontaktbolzen) | r 37 | 20° | 1
3 | Kerbe oben *EB 1,5 breit, 0,2 tief, Bohrungsmitte bis Rand | — | wie 1 | 6
— | Schlitz 1,0 durch, ganzer Ring | — | 200° | 1
— | Lasche 7,0 breit bis r 39,0, Ecken R1, Fuß R1 | — | 20° | 1

1. Nicht bemaßte Geometrie nach RFN_Klemmring.stp.
2. Allgemeintoleranzen ISO 2768-mK.
3. Kanten gebrochen 0,2, gratfrei.
4. Beide Seiten plan geschliffen, Ebenheit 0,02.
5. Blendenseite (oben) gratfrei, keine Kratzer.

Konrad Wehkamp (konrad.helmut.wehkamp@physik.uni-giessen.de)

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

3
2

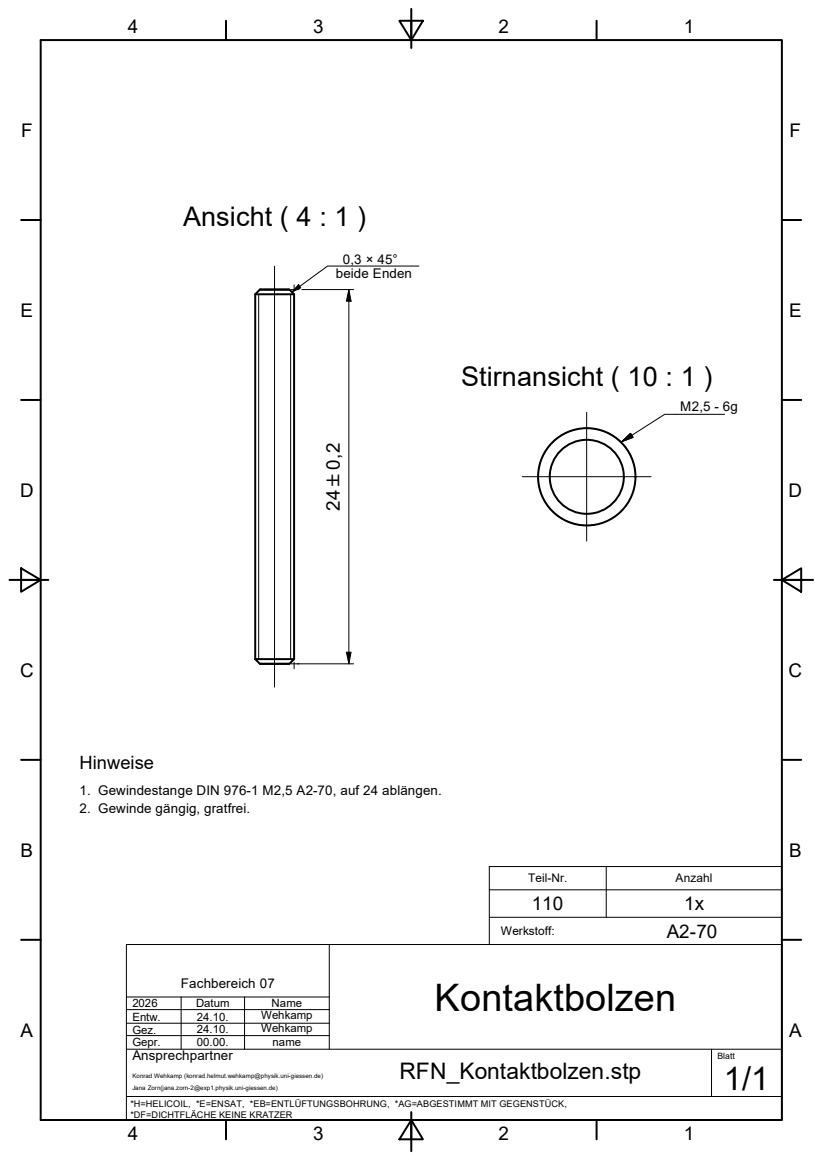
[picture p77: page 9]
Blatt; Teil-Nr.; Anzahl; Ansprechpartner; Werkstoff:; Fachbereich 07; 24.10. Wehkamp; Kontaktbolzen; Ansicht ( 4 : 1 ); 0,3 × 45° beide Enden; name; RFN_Kontaktbolzen.stp; Gepr.; Wehkamp; Stirnansicht ( 10 : 1 ); Gez.; Datum; Hinweise; Name; Entw.

1. Gewindestange DIN 976-1 M2,5 A2-70, auf 24 ablängen.
2. Gewinde gängig, gratfrei.

Konrad Wehkamp (konrad.helmut.wehkamp@physik.uni-giessen.de)

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

6

5

Teil-Nr.; Anzahl; Ansprechpartner; Werkstoff:; Blatt; Fachbereich 07; 24.10. Wehkamp; Gez.; Anfang unten; Wehkamp; Spulendaten; Größe; Wert; Draht; Drahtmitte; Windungen; Steigung; 5 mm, rechtsgängig; Lücke zwischen Windungen; Drahtlänge Wendel; 1061 mm + Anschlüsse; Unterkante ab Blendenunterseite; Entw.; Datum; Name; Kupfer; RFN_Spule.stp; Spule; Konrad Wehkamp (konrad.helmut.wehkamp@physik.uni-giessen.de); Vorderansicht ( 2 : 1 ); Draufsicht ( 1,5 : 1 ); Gepr.; name; Hinweise

1. Rechtsgängig, wie die Nut der Spulenstäbe.
2. Drahtenden nicht kürzen, Länge wird beim Einbau angepasst.

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

D | D

6

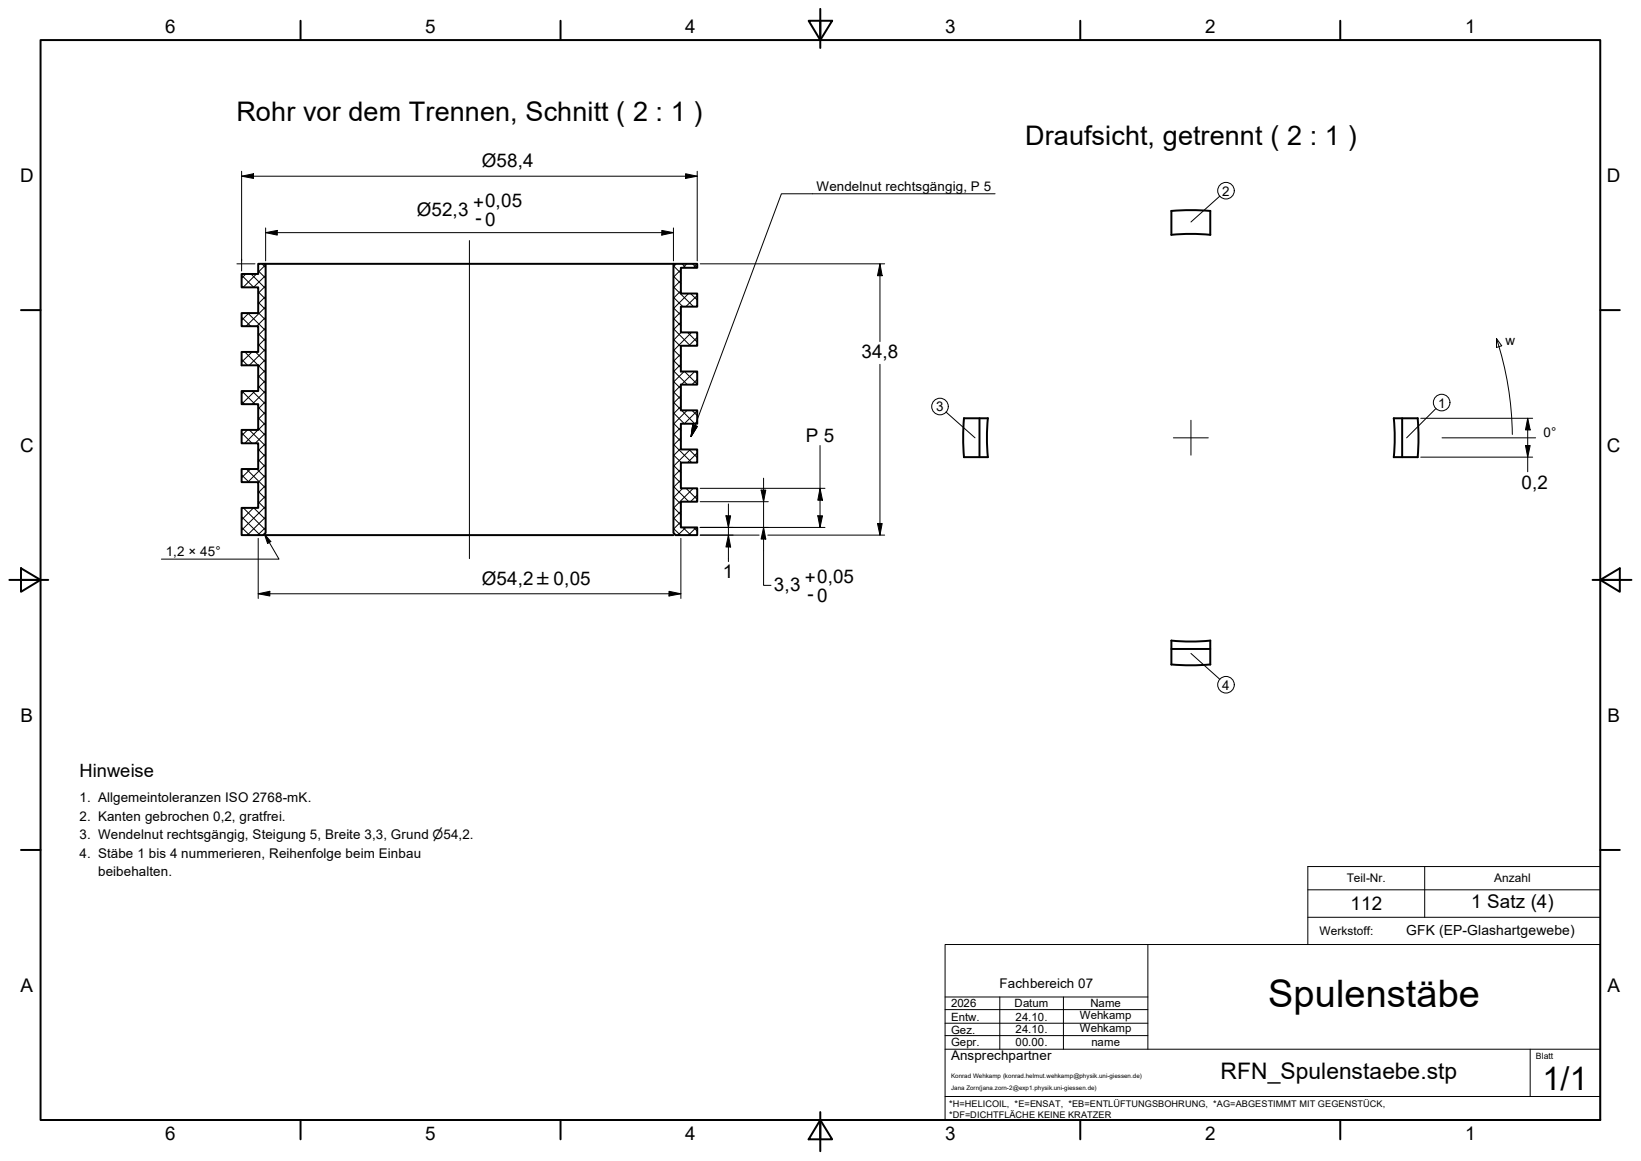
[picture p78: page 11]
Teil-Nr.; Anzahl; Werkstoff:; Blatt; Fachbereich 07; Ansprechpartner; Name; Datum; 1 Satz (4); Gez.; Wehkamp; Wendelnut rechtsgängig, P 5; Entw.; RFN_Spulenstaebe.stp; Spulenstäbe; Gepr.; name; Draufsicht, getrennt ( 2 : 1 ); Hinweise

Rohr vor dem Trennen, Schnitt ( 2 : 1 )

1. Allgemeintoleranzen ISO 2768-mK.
2. Kanten gebrochen 0,2, gratfrei.
3. Wendelnut rechtsgängig, Steigung 5, Breite 3,3, Grund n54,2.
4. Stäbe 1 bis 4 nummerieren, Reihenfolge beim Einbau
beibehalten.

GFK (EP-Glashartgewebe)

Konrad Wehkamp (konrad.helmut.wehkamp@physik.uni-giessen.de)

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

3
2

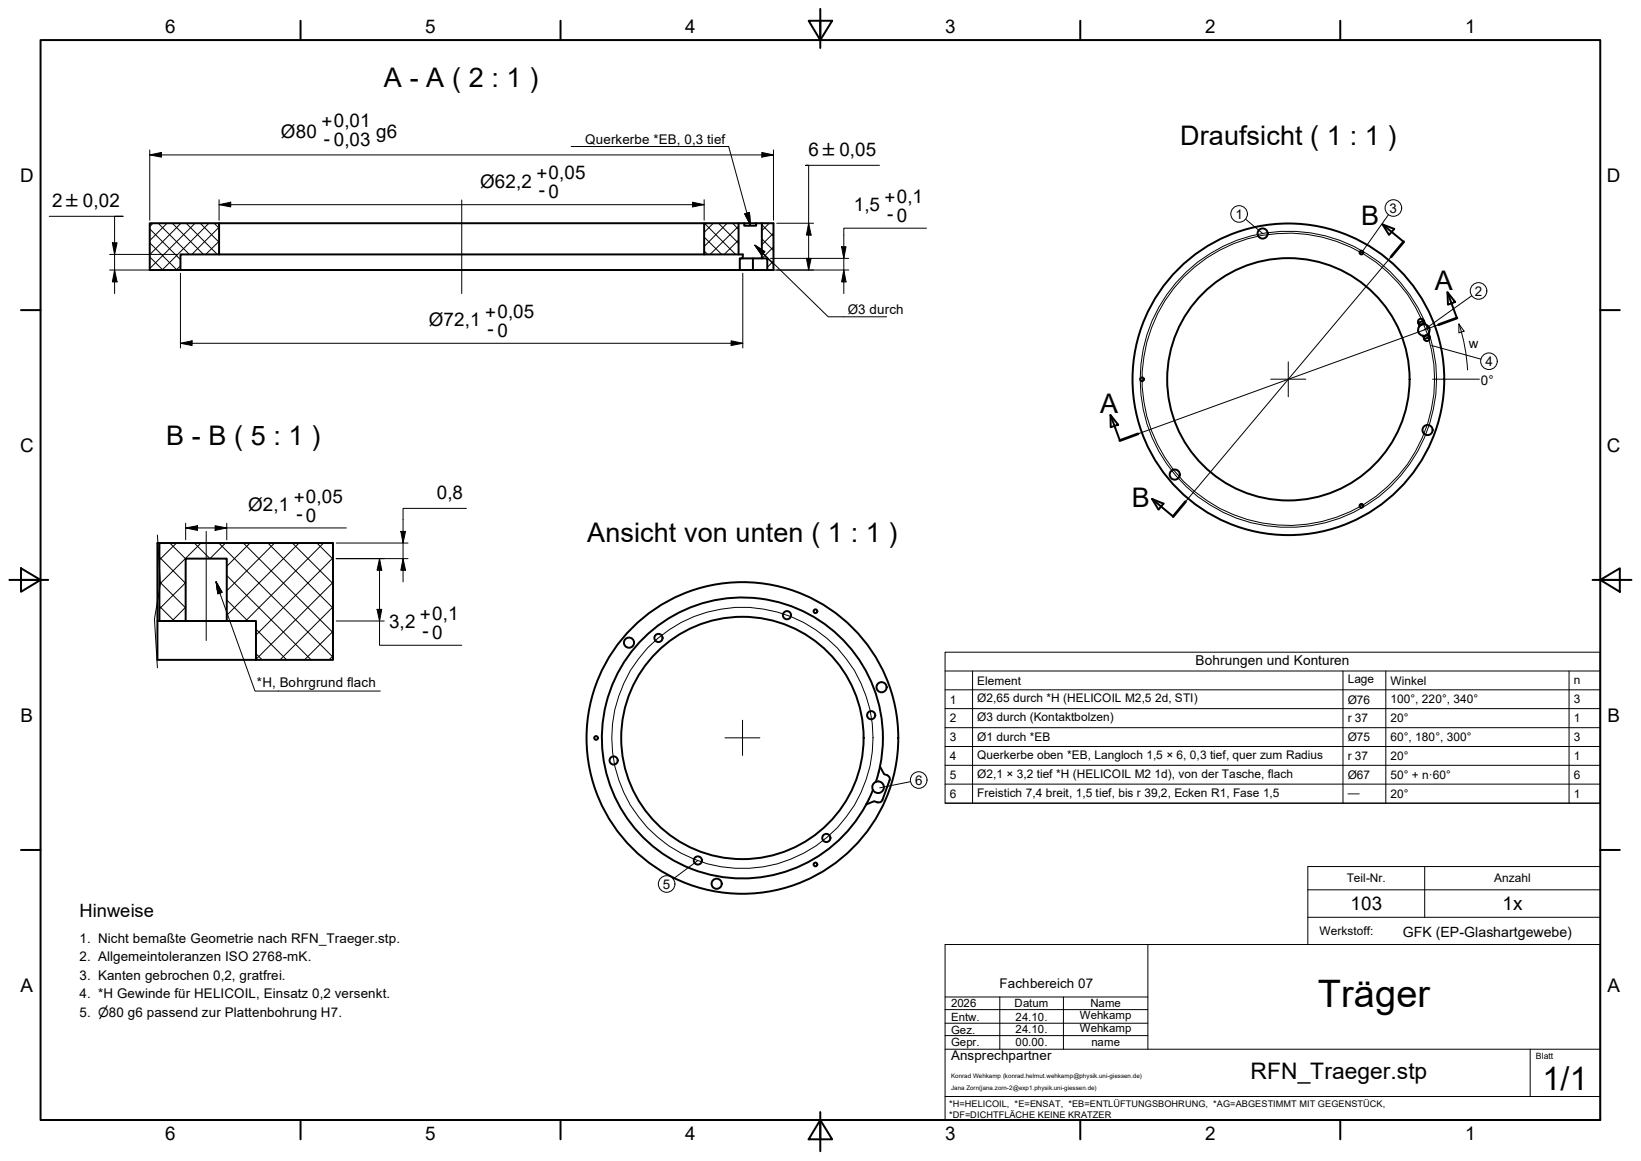
[picture p79: page 12]
Fachbereich 07; Teil-Nr.; Werkstoff:; Ansprechpartner; Blatt; Anzahl; Entw.; Datum; Name; *H, Bohrgrund flach; Gepr.; Wehkamp; Element; Lage; Winkel; Ø2,65 durch *H (HELICOIL M2,5 2d, STI); Ø3 durch (Kontaktbolzen); Ø1 durch *EB; Querkerbe oben *EB, Langloch 1,5 × 6, 0,3 tief, quer zum Radius; Ø2,1 × 3,2 tief *H (HELICOIL M2 1d), von der Tasche, flach; Freistich 7,4 breit, 1,5 tief, bis r 39,2, Ecken R1, Fase 1,5; Draufsicht ( 1 : 1 ); Ø3 durch; Gez.; RFN_Traeger.stp; 00.00. name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

Querkerbe *EB, 0,3 tief

Ansicht von unten ( 1 : 1 )

Bohrungen und Konturen

GFK (EP-Glashartgewebe)
Träger

1. Nicht bemaßte Geometrie nach RFN_Traeger.stp.
2. Allgemeintoleranzen ISO 2768-mK.
3. Kanten gebrochen 0,2, gratfrei.
4. *H Gewinde für HELICOIL, Einsatz 0,2 versenkt.
5. n80 g6 passend zur Plattenbohrung H7.

Konrad Wehkamp (konrad.helmut.wehkamp@physik.uni-giessen.de)

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
