konradweh/ABEP_Koppeltest/Fertigung/Halterung/Halterung_Grundplatte.pdf

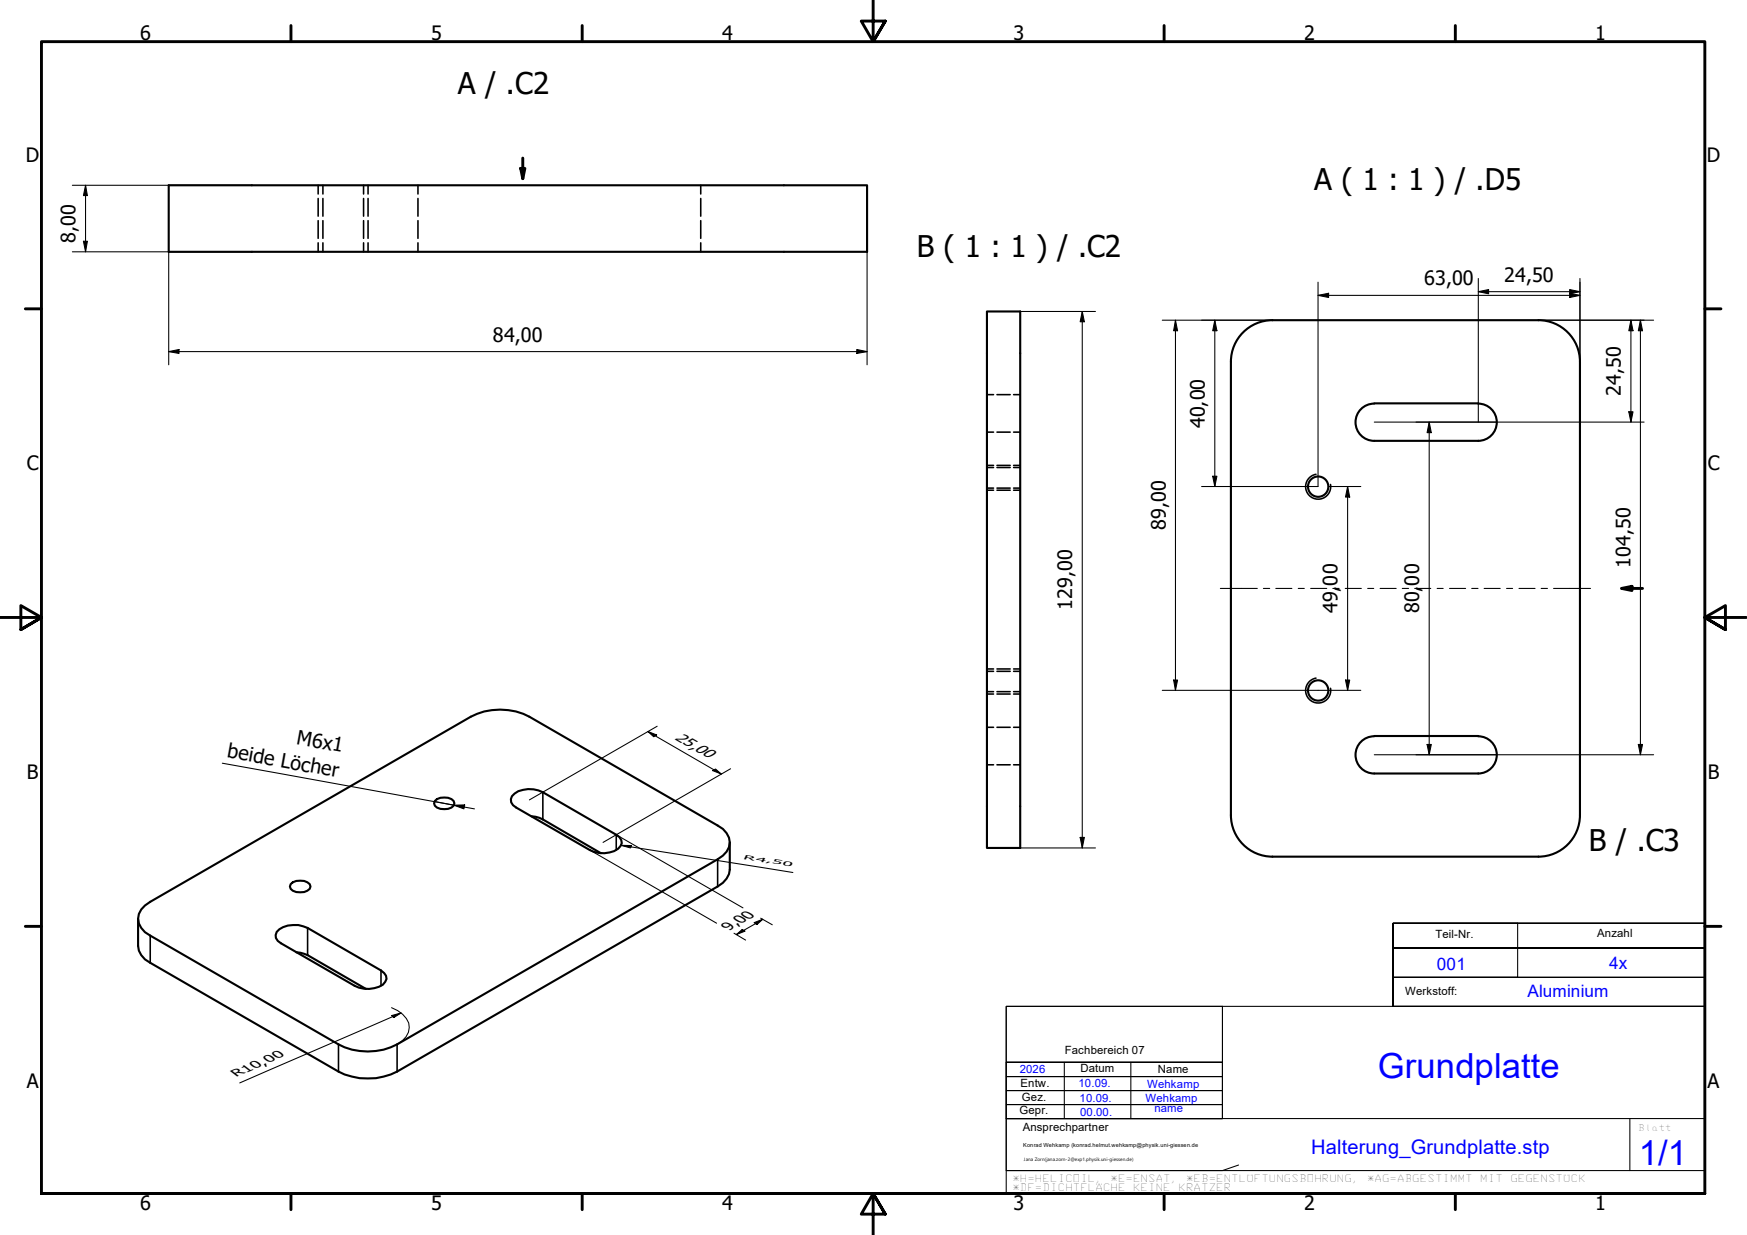
[picture p80: page 1]
beide Löcher

Teil-Nr. | Anzahl
001 | 4x

Fachbereich 07 | Grundplatte
2026 | Datum | Name

Entw. | 10.09. | Wehkamp
Gez. | 10.09. | Wehkamp
Gepr. | 00.00. | name

Ansprechpartner Halterung_Grundplatte.stp Konrad Wehkamp (konrad.helmut.wehkamp@physik.uni-giessen.de Jana Zorn(jana.zorn-2@exp1.physik.uni-giessen.de) | Blatt 1/1

*H=HELICOIL, *E=ENSAT, *EB=ENTLÜFTUNGSBOHRUNG, *AG=ABGESTIMMT MIT GEGENSTÜCK
*DF=DICHTFLÄCHE KEINE KRATZER
