konradweh/ABEP_Koppeltest/Fertigung/Halterung/Halterung_Seitenteil.pdf

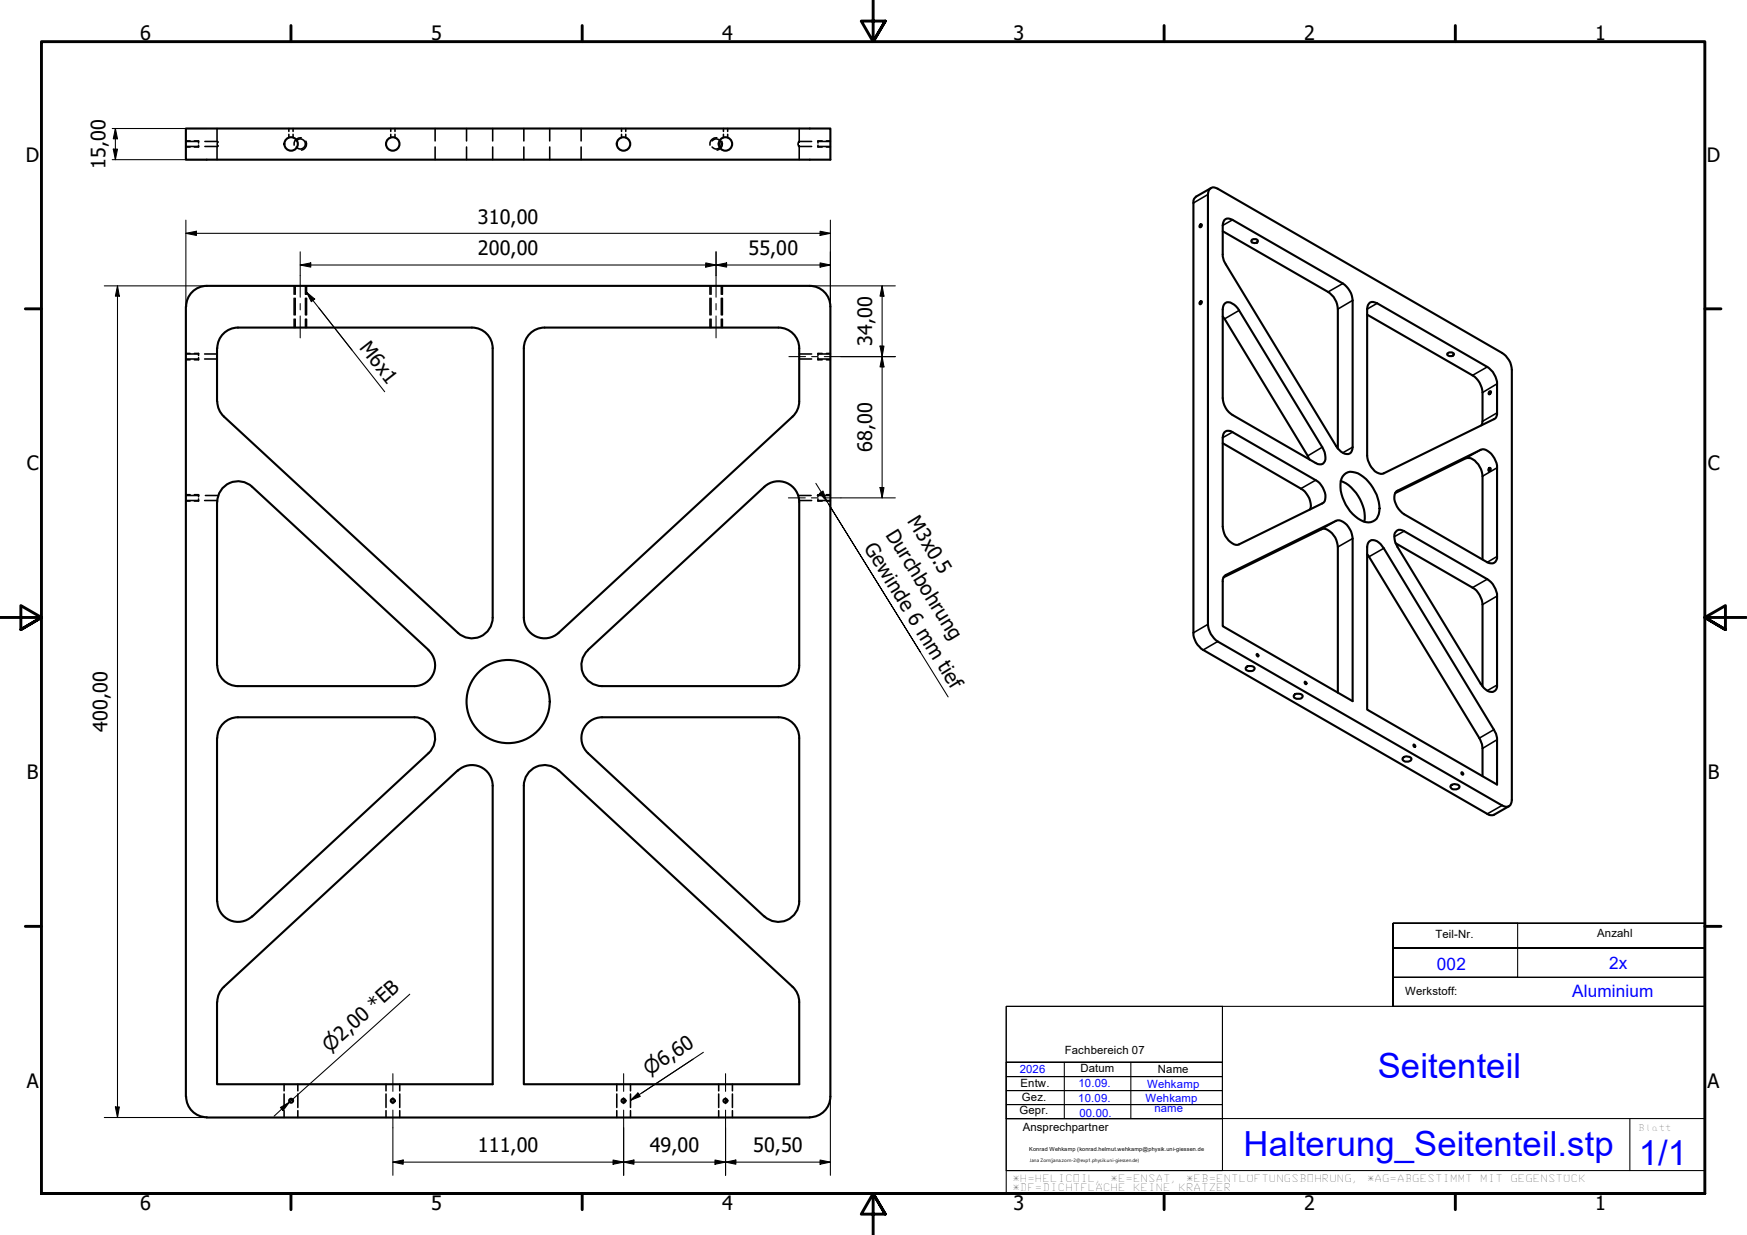
[picture p81: page 1]
Gewinde 6; mm tief

Teil-Nr. | Anzahl
002 | 2x

Fachbereich 07 | Seitenteil
2026 | Datum | Name

Entw. | 10.09. | Wehkamp
Gez. | 10.09. | Wehkamp
Gepr. | 00.00. | name

Ansprechpartner Konrad Wehkamp (konrad.helmut.wehkamp@physik.uni-giessen.de Jana Zorn(jana.zorn-2@exp1.physik.uni-giessen.de) | Halterung_Seitenteil.stp | Blatt 1/1

*H=HELICOIL, *E=ENSAT, *EB=ENTLÜFTUNGSBOHRUNG, *AG=ABGESTIMMT MIT GEGENSTÜCK
*DF=DICHTFLÄCHE KEINE KRATZER
