konradweh/ABEP_Koppeltest/Praesentation/img/JLU_Giessen-Logo.pdf

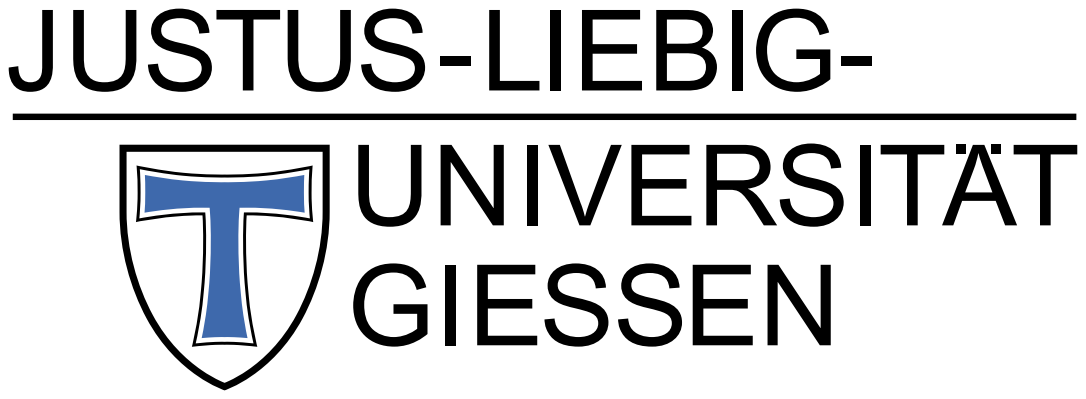
[picture p82: page 1]
