konradweh/ABEP_Koppeltest/CAD/RF-Neutralisator/RFN_Zeichnungen/all.pdf

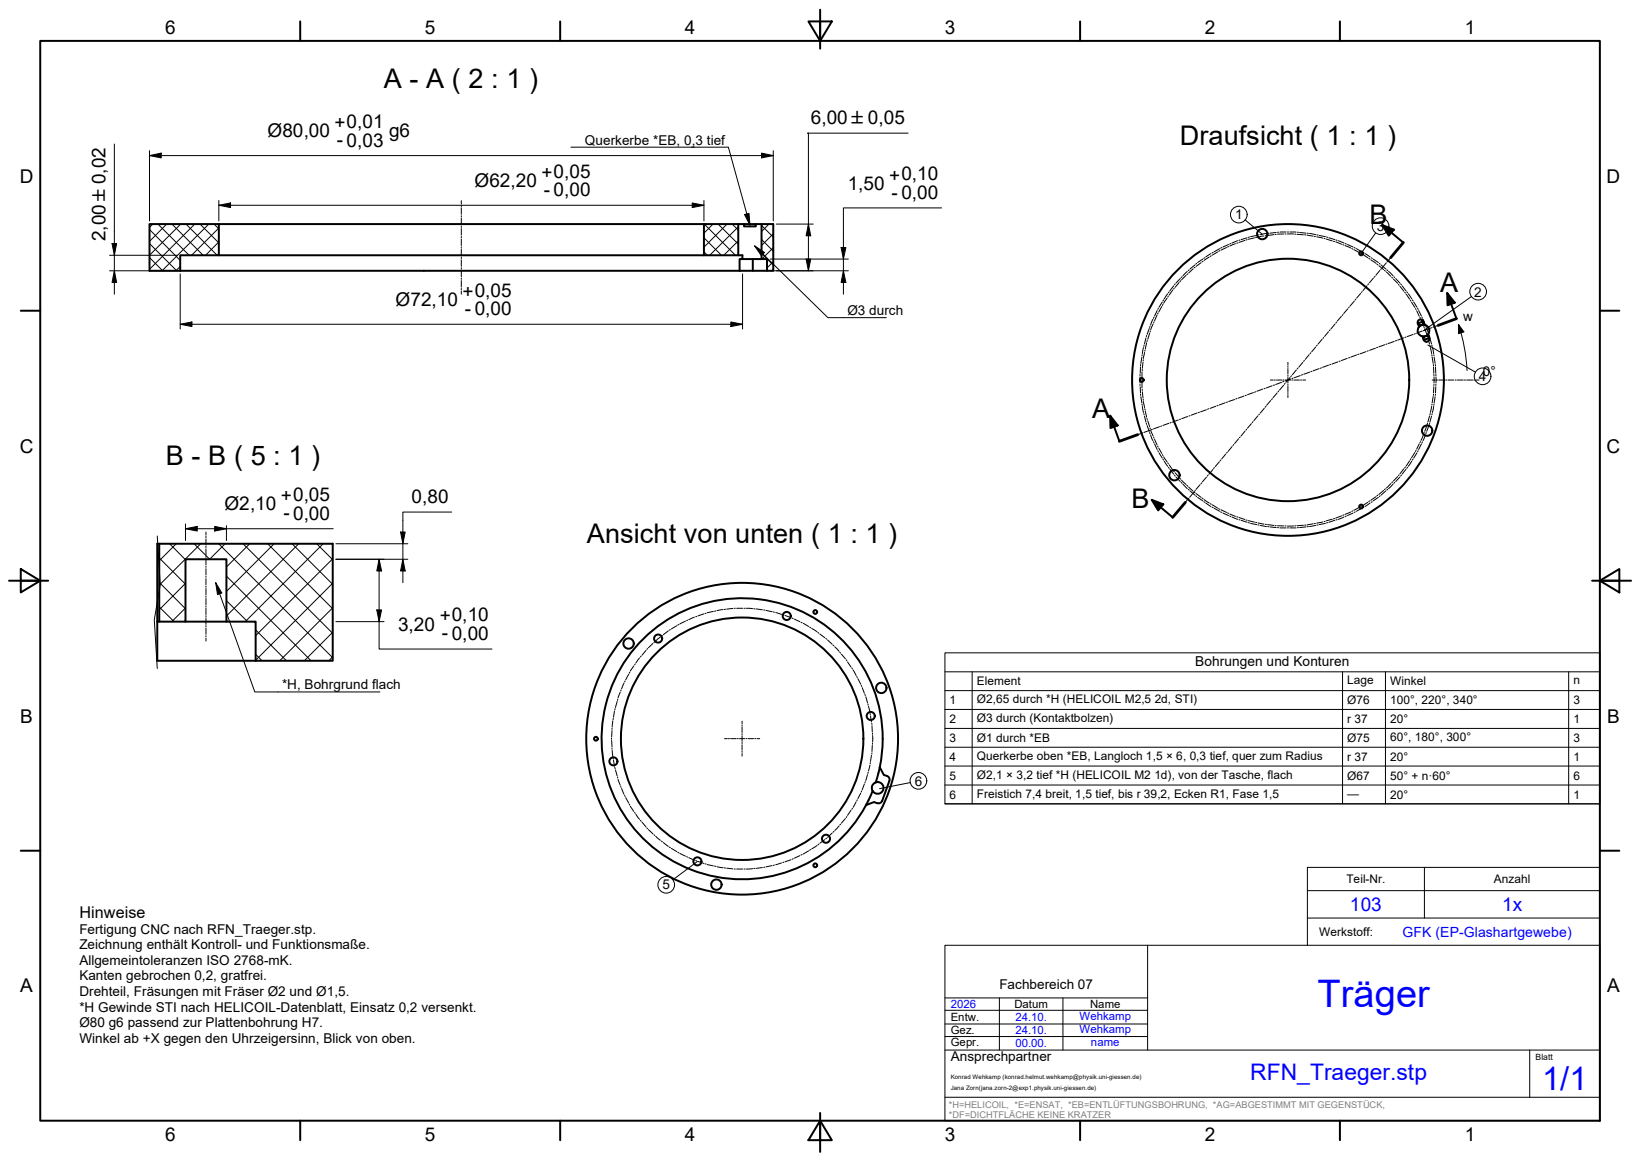
[picture p83: page 1]
*H, Bohrgrund flach; Draufsicht ( 1 : 1 ); Ø3 durch

Querkerbe *EB, 0,3 tief

Ansicht von unten ( 1 : 1 )

Bohrungen und Konturen

Element | Lage | Winkel | n
1 | Ø2,65 durch *H (HELICOIL M2,5 2d, STI) | Ø76 | 100°, 220°, 340° | 3
2 | Ø3 durch (Kontaktbolzen) | r 37 | 20° | 1
3 | Ø1 durch *EB | Ø75 | 60°, 180°, 300° | 3
4 | Querkerbe oben *EB, Langloch 1,5 × 6, 0,3 tief, quer zum Radius | r 37 | 20° | 1
5 | Ø2,1 × 3,2 tief *H (HELICOIL M2 1d), von der Tasche, flach | Ø67 | 50° + n·60° | 6
6 | Freistich 7,4 breit, 1,5 tief, bis r 39,2, Ecken R1, Fase 1,5 | — | 20° | 1

Teil-Nr. | Anzahl
103 | 1x

Hinweise
Fertigung CNC nach RFN_Traeger.stp.
Zeichnung enthält Kontroll- und Funktionsmaße.
Allgemeintoleranzen ISO 2768-mK.
Kanten gebrochen 0,2, gratfrei.
Drehteil, Fräsungen mit Fräser Ø2 und Ø1,5.
*H Gewinde STI nach HELICOIL-Datenblatt, Einsatz 0,2 versenkt.
Ø80 g6 passend zur Plattenbohrung H7.
Winkel ab +X gegen den Uhrzeigersinn, Blick von oben.

GFK (EP-Glashartgewebe)

Fachbereich 07 | Träger

2026 | Datum | Name
Entw. | 24.10. | Wehkamp
Gez. | 24.10. | Wehkamp
Gepr. | 00.00. name
Ansprechpartner RFN_Traeger.stp Konrad Wehkamp (konrad.helmut.wehkamp@physik.uni-giessen.de) Jana Zorn(jana.zorn-2@exp1.physik.uni-giessen.de) | Blatt 1/1

*H=HELICOIL, *E=ENSAT, *EB=ENTLÜFTUNGSBOHRUNG, *AG=ABGESTIMMT MIT GEGENSTÜCK,
*DF=DICHTFLÄCHE KEINE KRATZER
