konradweh/ABEP_Koppeltest/Fertigung/RF-Neutralisator/PDF/RF-NeutralisatorAbdeckblech.pdf

Draufsicht, gerollt ( 1 : 1 ); Isometrie ( 1 : 1,33 ); Bohrungen radial

Zuschnitt, vor dem Rollen ( 1 : 1 )

1. Allgemeintoleranzen ISO 2768-mK.
2. Kanten gebrochen 0,2, gratfrei.
3. Blech 1 mm, gerollt auf Innen-⌀88, Bogen 119°.
4. Bohrungen ⌀3,2 radial, unten 2,75 über der Unterkante.
5. Blech muss am Edelstahlring ⌀88 anliegen.

Teil-Nr. | Anzahl
106 | 3x

Aluminium EN AW-5754

Fachbereich 07 | Abdeckblech

2026 | Datum | Name
Entw. | 24.10. | Wehkamp
Gez. | 24.10. | Wehkamp
Gepr. | 00.00. | name
Ansprechpartner RFN_Abdeckblech.stp Konrad Wehkamp (konrad.helmut.wehkamp@physik.uni-giessen.de) Jana Zorn(jana.zorn-2@exp1.physik.uni-giessen.de) | Blatt 1/1

*H=HELICOIL, *E=ENSAT, *EB=ENTLÜFTUNGSBOHRUNG, *AG=ABGESTIMMT MIT GEGENSTÜCK,
*DF=DICHTFLÄCHE KEINE KRATZER
