konradweh/ABEP_Koppeltest/Fertigung/RF-Neutralisator/PDF/RF-NeutralisatorDeckel.pdf

M3 durch; wie 2; Z ( 3 : 1 ) SHV; Gas Ø8,4; Draufsicht ( 1 : 1 ); Y ( 3 : 1 ) N-Buchse

Element | Lage | Winkel | n
1 | Ø8,4 durch (Swagelok SS-200-61) | Ø56 | 35° | 1
2 | Ø9,6 durch, Abflachung 4,05 von Mitte (SHV), Z | Ø56 | 125° | 1

4 | Ø16,1 durch, Doppel-D SW 13,6 (N-Buchse), Y | Ø56 | 305° | 1
5 | M3 radial durch Zapfenwand, Mitte 3 über Unterseite | außen | 10°, 90°, 130°, 210°, 250°, 330° | 6

Teil-Nr. | Anzahl
107 | 1x

Aluminium EN AW-6082 T6

1. Nicht bemaßte Geometrie nach RFN_Deckel.stp.
2. Allgemeintoleranzen ISO 2768-mK.
3. Kanten gebrochen 0,2, gratfrei.
4. Lage der Abflachungen beliebig, parallel zur X-Achse.
5. Zapfen ⌀88 passend in die Abdeckbleche.

Fachbereich 07 | Deckel

2026 | Datum | Name
Entw. | 24.10. | Wehkamp
Gez. | 24.10. | Wehkamp
Gepr. | 00.00. | name
Ansprechpartner RFN_Deckel.stp Konrad Wehkamp (konrad.helmut.wehkamp@physik.uni-giessen.de) Jana Zorn(jana.zorn-2@exp1.physik.uni-giessen.de) | Blatt 1/1

*H=HELICOIL, *E=ENSAT, *EB=ENTLÜFTUNGSBOHRUNG, *AG=ABGESTIMMT MIT GEGENSTÜCK,
*DF=DICHTFLÄCHE KEINE KRATZER
