konradweh/ABEP_Koppeltest/Fertigung/RF-Neutralisator/PDF/RF-NeutralisatorDistanzhuelse.pdf

Draufsicht ( 5 : 1 ); Edelstahl 1.4301

1. Allgemeintoleranzen ISO 2768-mK.
2. Kanten gebrochen 0,2, gratfrei.
3. Alle 9 Hülsen gleich lang (±0,05), Stirnflächen plan und parallel.

Teil-Nr. | Anzahl
108 | 9x

Fachbereich 07 | Distanzhülse

2026 | Datum | Name
Entw. | 24.10. Wehkamp
Gez. | 24.10. | Wehkamp
Gepr. | 00.00. | name
Ansprechpartner RFN_Distanzhuelse.stp Konrad Wehkamp (konrad.helmut.wehkamp@physik.uni-giessen.de) Jana Zorn(jana.zorn-2@exp1.physik.uni-giessen.de) | Blatt 1/1

*H=HELICOIL, *E=ENSAT, *EB=ENTLÜFTUNGSBOHRUNG, *AG=ABGESTIMMT MIT GEGENSTÜCK,
*DF=DICHTFLÄCHE KEINE KRATZER
