konradweh/ABEP_Koppeltest/Fertigung/RF-Neutralisator/PDF/RF-NeutralisatorEdelstahlring.pdf

Flachnut *DF; Ø2,7 durch, Senkung 90° Ø5,5 oben; Edelstahl 1.4301; Draufsicht ( 1 : 1 ); 0,3 tief; Ø1 *EB, 3,0 tief; M3, Gewinde 4 tief

Ansicht von unten ( 1 : 1 )

Bohrung | Lage | Winkel | n
1 | M3 durch | Ø76 | 0° + n·40° | 9
2 | Ø2,4 durch | Ø84 | 60°, 180°, 300° | 3

4 | Ø2 H7 durch (Passstift) | Ø84 | 140° | 1
5 | Ø5,3 durch (Keramikhülse) | r 37 | 20° | 1
6 | M3 radial, 4 tief, Bohrung 5,5, Mitte 2,75 ü. Unters. | außen | 10°, 90°, 130°, 210°, 250°, 330° | 6
7 | Kerbe unten 1,5 breit, 0,3 tief, r 33,5 bis r 36,8 | — | 60°, 180°, 300° | 3
8 | Ø1 *EB von unten, 3,0 tief | r 38,2 | wie 6 | 6

Teil-Nr. | Anzahl
104 | 1x

1. Nicht bemaßte Geometrie nach RFN_Edelstahlring.stp.
2. Allgemeintoleranzen ISO 2768-mK.
3. Kanten gebrochen 0,2, gratfrei.
4. *DF Radialnut, Flachnut und Unterseite Ra 0,8.
5. Ober- und Unterseite planparallel 0,02.
6. Ansicht von unten ist gespiegelt.

Fachbereich 07 | Edelstahlring

2026 | Datum | Name
Entw. | 24.10. | Wehkamp
Gez. | 24.10. | Wehkamp
Gepr. | 00.00. | name
Ansprechpartner RFN_Edelstahlring.stp Konrad Wehkamp (konrad.helmut.wehkamp@physik.uni-giessen.de) Jana Zorn(jana.zorn-2@exp1.physik.uni-giessen.de) | Blatt 1/1

*H=HELICOIL, *E=ENSAT, *EB=ENTLÜFTUNGSBOHRUNG, *AG=ABGESTIMMT MIT GEGENSTÜCK,
*DF=DICHTFLÄCHE KEINE KRATZER
