konradweh/ABEP_Koppeltest/Fertigung/RF-Neutralisator/PDF/RF-NeutralisatorGFK_Ring oben.pdf

Draufsicht ( 1 : 1 ); Fase 0,5 × 45°

Lippe, Spulenstäbe stehen hier

Glasauflage r 27,5 bis 31 *DF

Bohrungen und Konturen

Element | Lage | Winkel | n
1 | Ø5,5 durch, Ansenkung Ø8,2 × 4,9 tief von oben | Ø76 | 0° + n·40° | 9
2 | Ø6 durch (Keramikhülse) | r 37 | 20° | 1
3 | Randnut 4,2 breit durch, inneres Ende R2,1 um Ø84, nach außen offen | Ø84 | 60°, 180°, 300° | 3
4 | Anschlussnut Spule 4 breit, 4,3 tief, Grund = Lippe oben | — | 140° | 1

1. Nicht bemaßte Geometrie nach RFN_GFK_Ring_oben.stp.
2. Allgemeintoleranzen ISO 2768-mK.
3. Kanten gebrochen 0,2, gratfrei.
4. Glasauflage *DF eben 0,02, Ra 1,6.

Teil-Nr. | Anzahl
105 | 1x

GFK (EP-Glashartgewebe)

Fachbereich 07 | GFK-Ring oben

2026 | Datum | Name
Entw. | 24.10. Wehkamp
Gez. | 24.10. | Wehkamp
Gepr. | 00.00. name
Ansprechpartner RFN_GFK_Ring_oben.stp Konrad Wehkamp (konrad.helmut.wehkamp@physik.uni-giessen.de) Jana Zorn(jana.zorn-2@exp1.physik.uni-giessen.de) | Blatt 1/1

*H=HELICOIL, *E=ENSAT, *EB=ENTLÜFTUNGSBOHRUNG, *AG=ABGESTIMMT MIT GEGENSTÜCK,
*DF=DICHTFLÄCHE KEINE KRATZER
