konradweh/ABEP_Koppeltest/Fertigung/RF-Neutralisator/PDF/RF-NeutralisatorKeramikhuelse.pdf

Draufsicht ( 4 : 1 ); Keramik Al2O3

1. Allgemeintoleranzen ISO 2768-mK.
2. Kaufteil Al2O3-Rohr ⌀5 × ⌀3,2, auf Länge trennen.
3. Stirnflächen plan und parallel, Kanten leicht gebrochen.

Teil-Nr. | Anzahl
111 | 1x

Fachbereich 07 | Keramikhülse

2026 | Datum | Name
Entw. | 24.10. Wehkamp
Gez. | 24.10. | Wehkamp
Gepr. | 00.00. | name
Ansprechpartner RFN_Keramikhuelse.stp Konrad Wehkamp (konrad.helmut.wehkamp@physik.uni-giessen.de) Jana Zorn(jana.zorn-2@exp1.physik.uni-giessen.de) | Blatt 1/1

*H=HELICOIL, *E=ENSAT, *EB=ENTLÜFTUNGSBOHRUNG, *AG=ABGESTIMMT MIT GEGENSTÜCK,
*DF=DICHTFLÄCHE KEINE KRATZER
