konradweh/ABEP_Koppeltest/Fertigung/RF-Neutralisator/PDF/RF-NeutralisatorKontaktbolzen.pdf

Ansicht ( 4 : 1 ); 0,3 × 45° beide Enden; Stirnansicht ( 10 : 1 )

1. Gewindestange DIN 976-1 M2,5 A2-70, auf 24 ablängen.
2. Gewinde gängig, gratfrei.

Teil-Nr. | Anzahl
110 | 1x

Fachbereich 07 | Kontaktbolzen

2026 | Datum | Name
Entw. | 24.10. Wehkamp
Gez. | 24.10. | Wehkamp
Gepr. | 00.00. | name
Ansprechpartner RFN_Kontaktbolzen.stp Konrad Wehkamp (konrad.helmut.wehkamp@physik.uni-giessen.de) Jana Zorn(jana.zorn-2@exp1.physik.uni-giessen.de) | Blatt 1/1

*H=HELICOIL, *E=ENSAT, *EB=ENTLÜFTUNGSBOHRUNG, *AG=ABGESTIMMT MIT GEGENSTÜCK,
*DF=DICHTFLÄCHE KEINE KRATZER
