konradweh/ABEP_Koppeltest/Fertigung/RF-Neutralisator/PDF/RF-NeutralisatorSpulenstaebe.pdf

Wendelnut rechtsgängig, P 5; Draufsicht, getrennt ( 2 : 1 )

Rohr vor dem Trennen, Schnitt ( 2 : 1 )

1. Allgemeintoleranzen ISO 2768-mK.
2. Kanten gebrochen 0,2, gratfrei.
3. Wendelnut rechtsgängig, Steigung 5, Breite 3,3, Grund ⌀54,2.
4. Stäbe 1 bis 4 nummerieren, Reihenfolge beim Einbau
beibehalten.

Teil-Nr. | Anzahl
112 | 1 Satz (4)

GFK (EP-Glashartgewebe)

Fachbereich 07 | Spulenstäbe

2026 | Datum | Name
Entw. | 24.10. | Wehkamp
Gez. | 24.10. | Wehkamp
Gepr. | 00.00. | name
Ansprechpartner RFN_Spulenstaebe.stp Konrad Wehkamp (konrad.helmut.wehkamp@physik.uni-giessen.de) Jana Zorn(jana.zorn-2@exp1.physik.uni-giessen.de) | Blatt 1/1

*H=HELICOIL, *E=ENSAT, *EB=ENTLÜFTUNGSBOHRUNG, *AG=ABGESTIMMT MIT GEGENSTÜCK,
*DF=DICHTFLÄCHE KEINE KRATZER
