konradweh/ABEP_Koppeltest/CAD/RF-Neutralisator/RFN_Zeichnungen/RFN_Zeichnungssatz.pdf

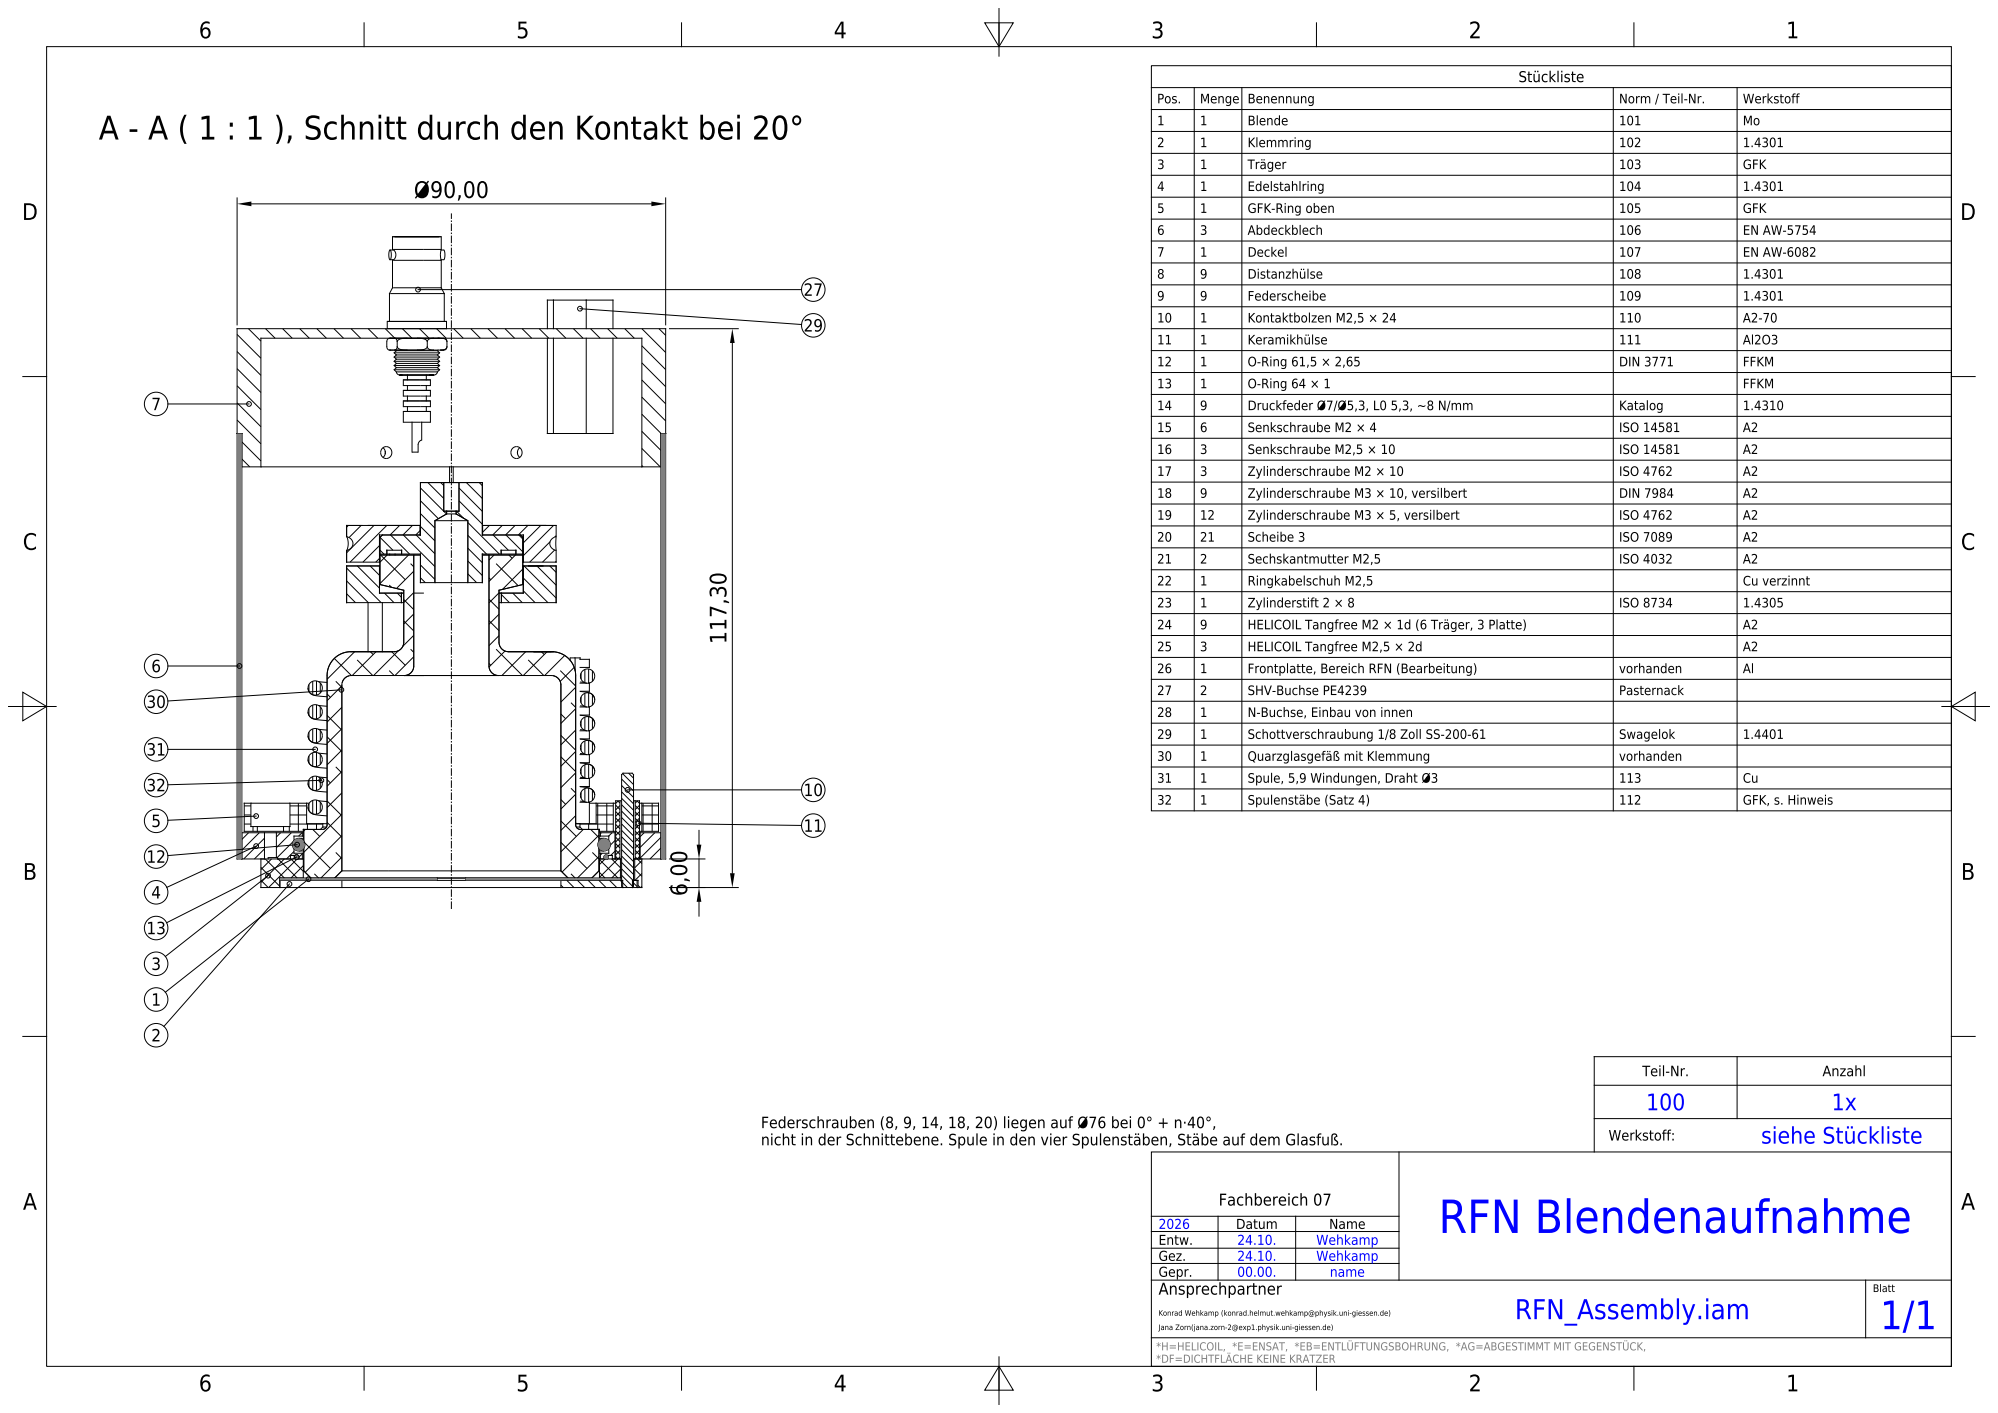
[picture p84: page 1]

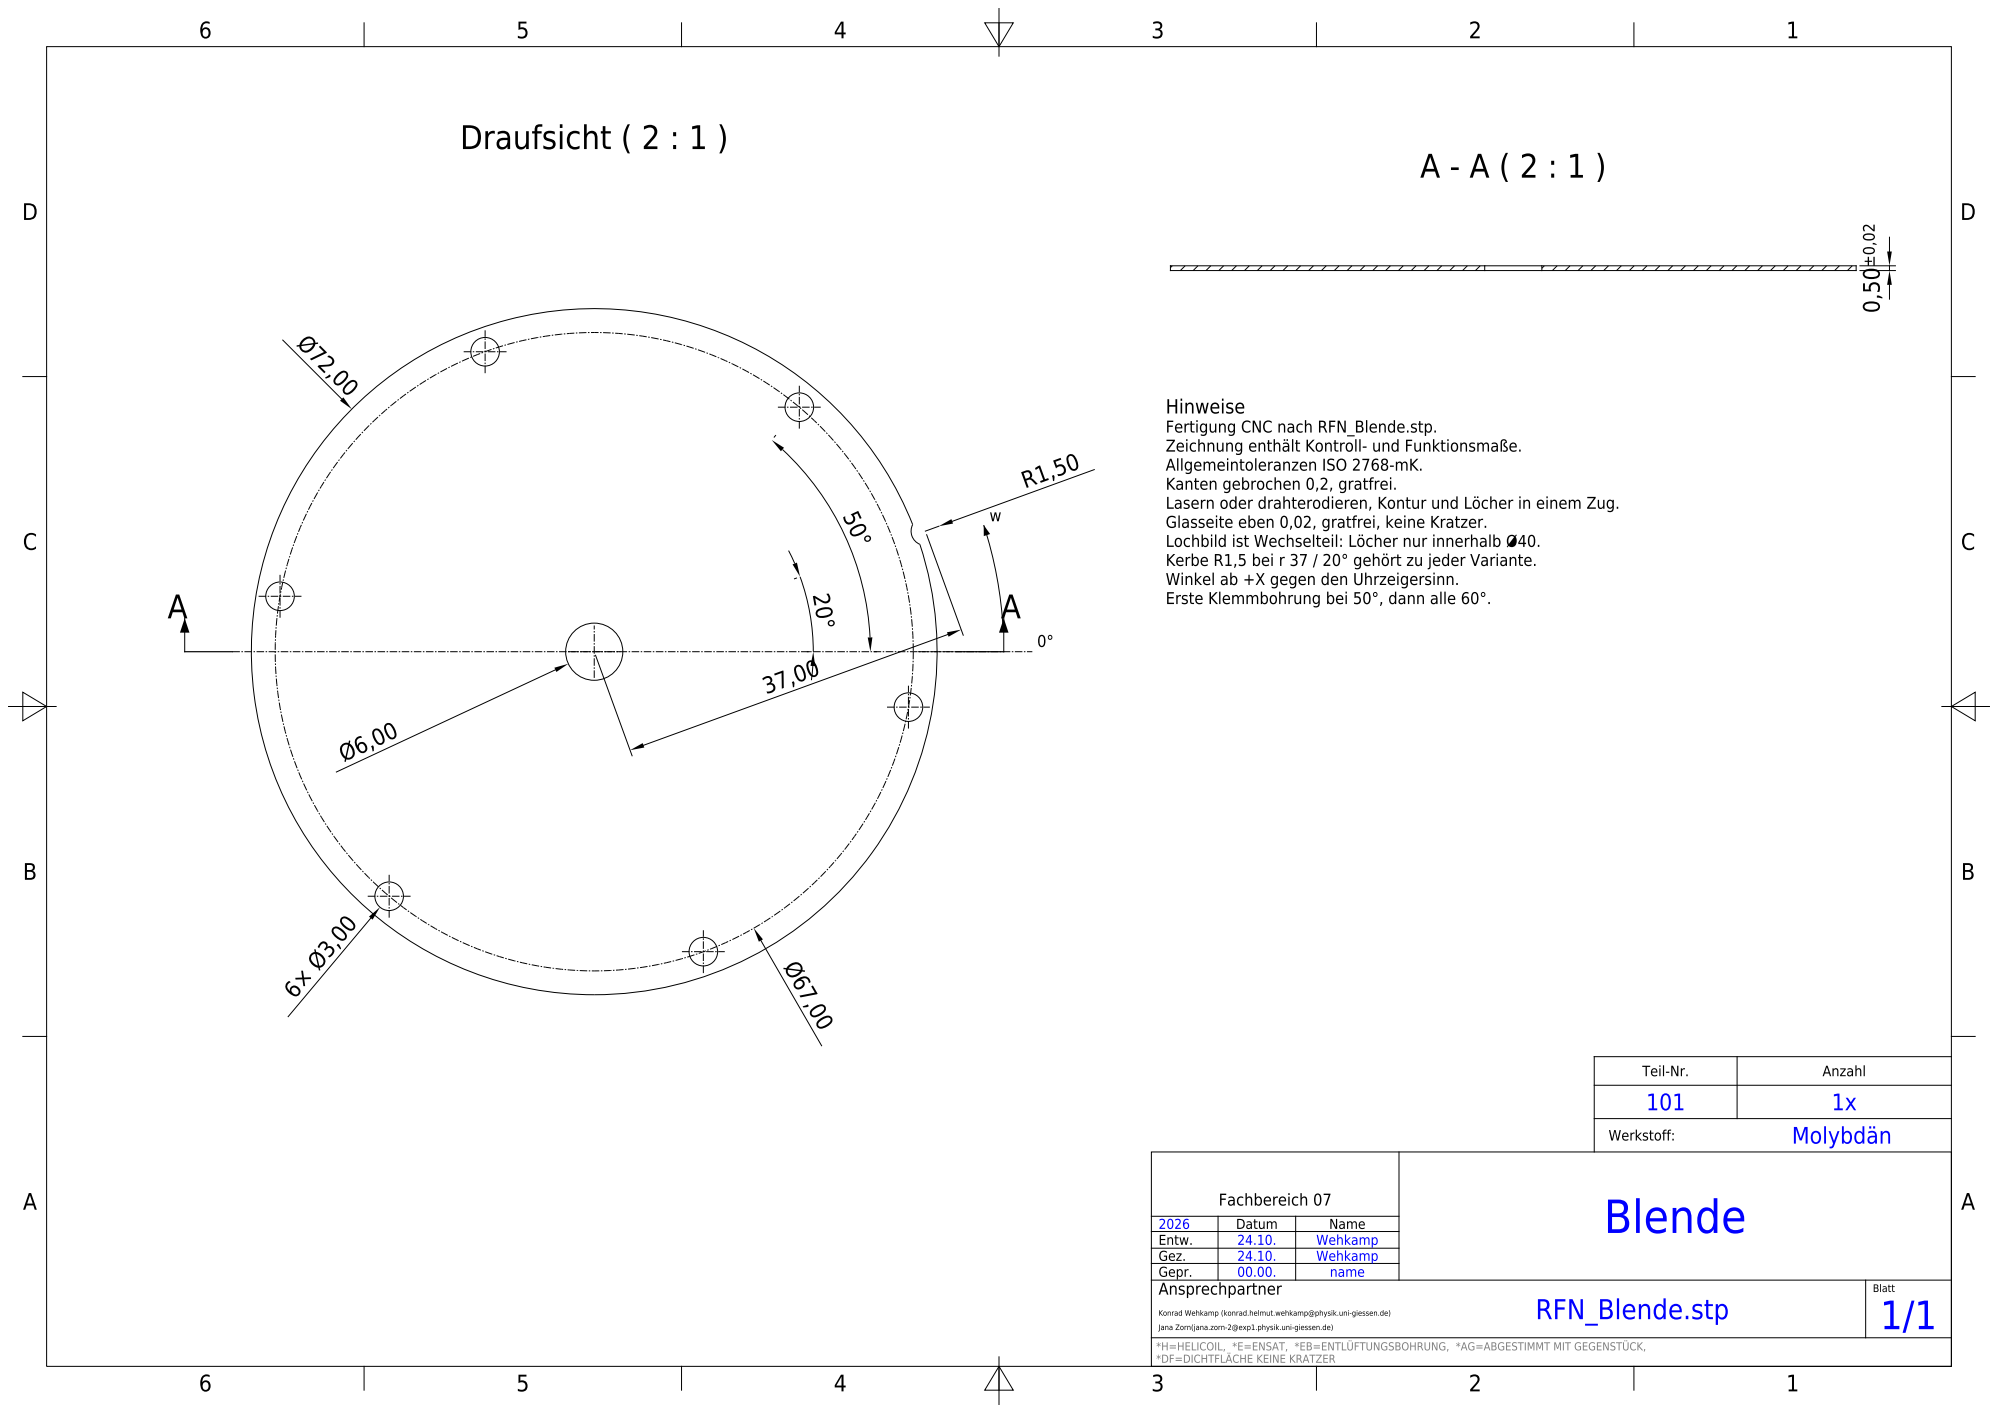
[picture p85: page 2]

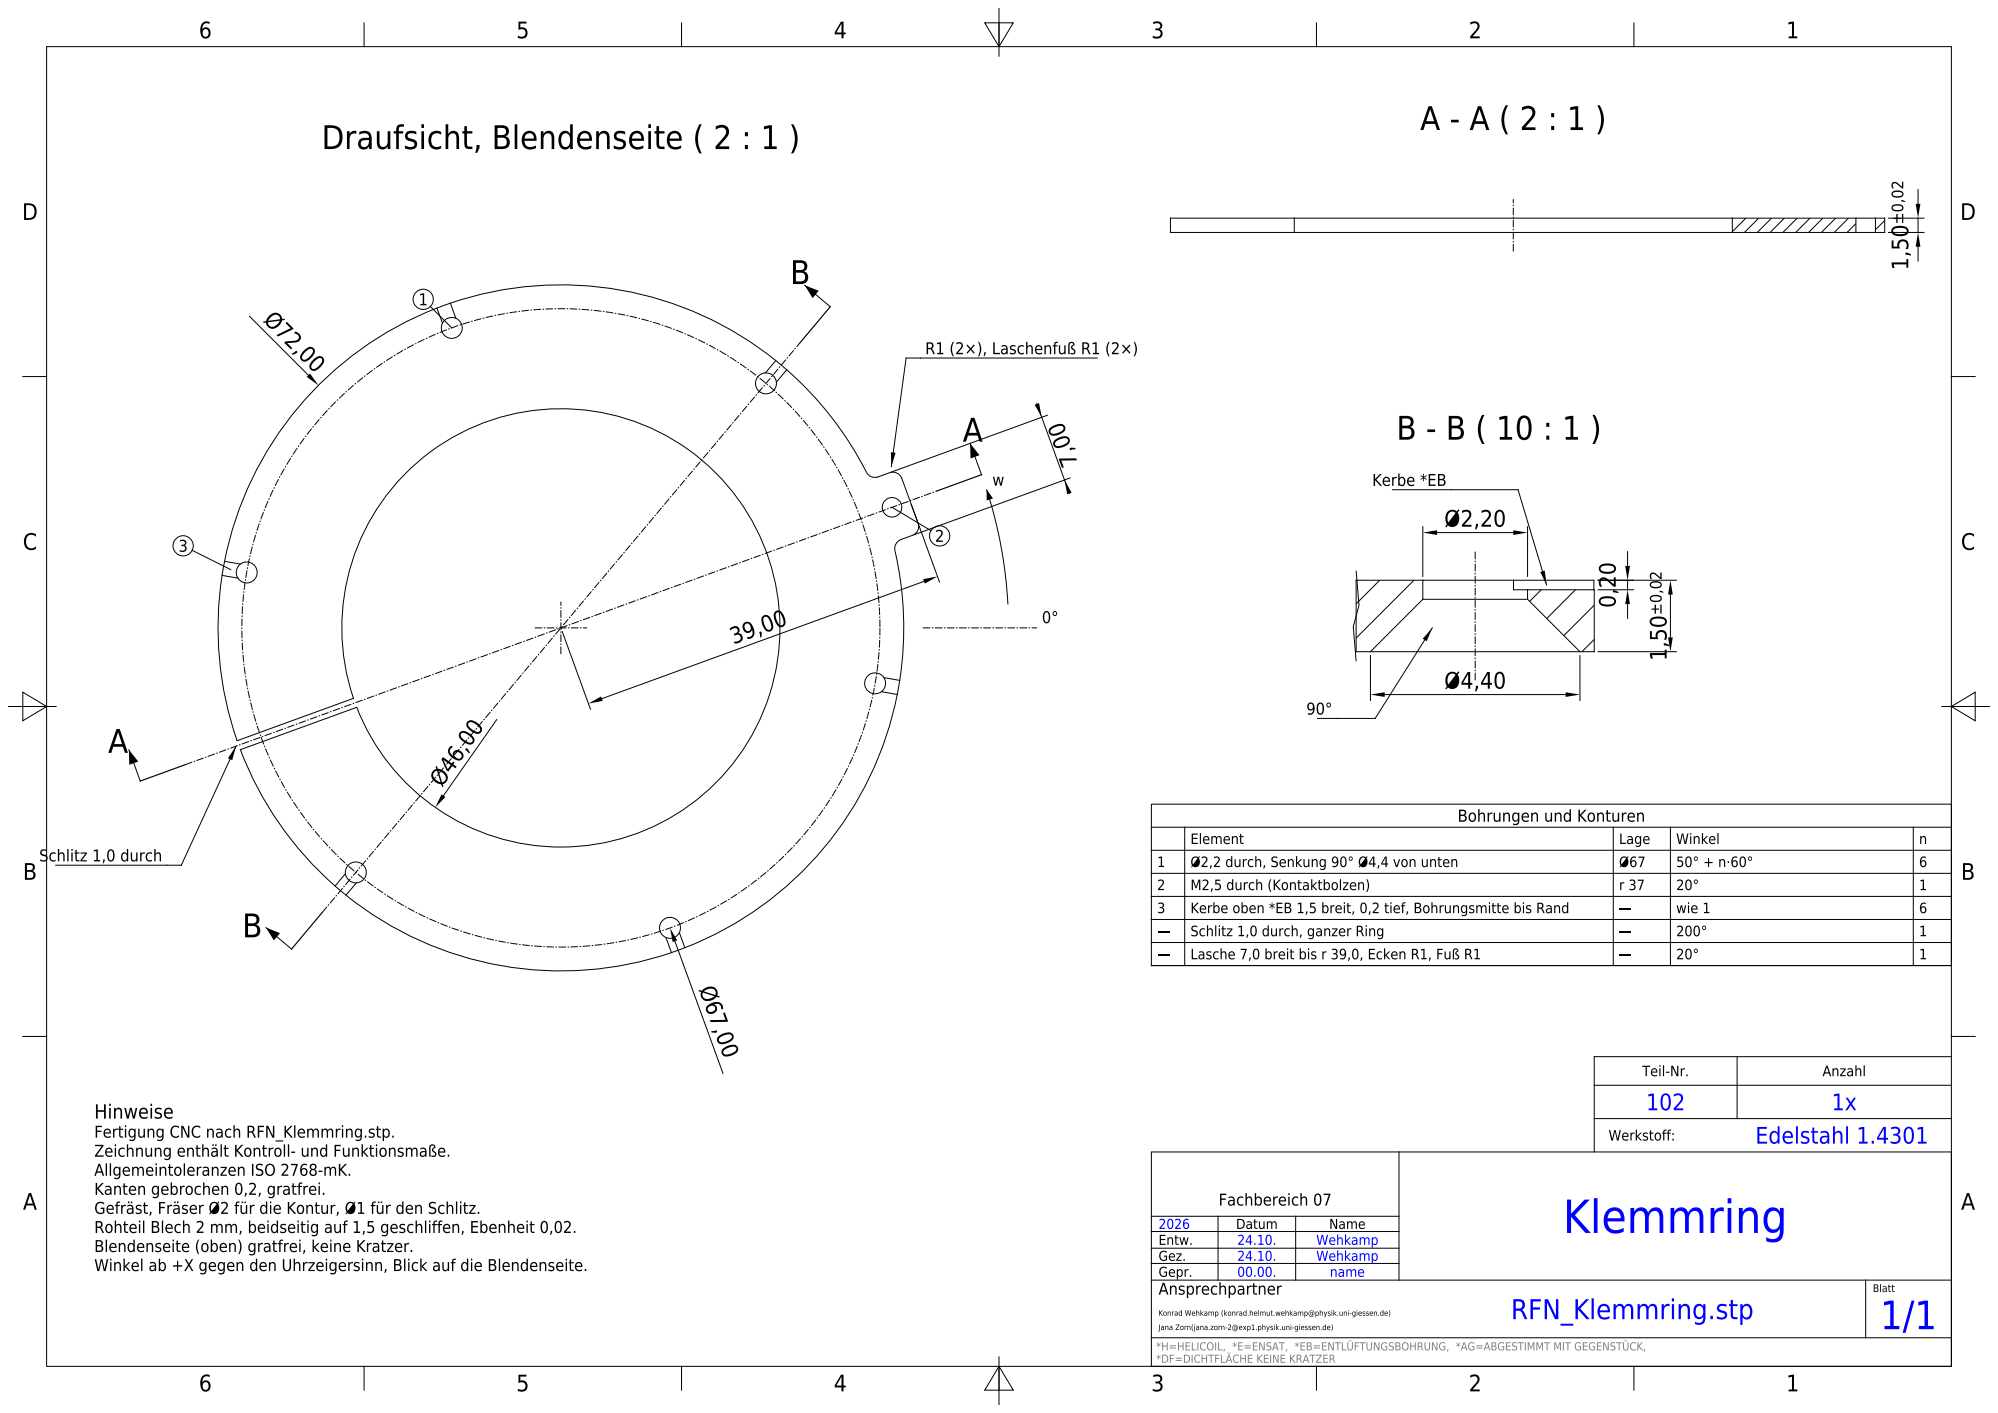
[picture p86: page 3]

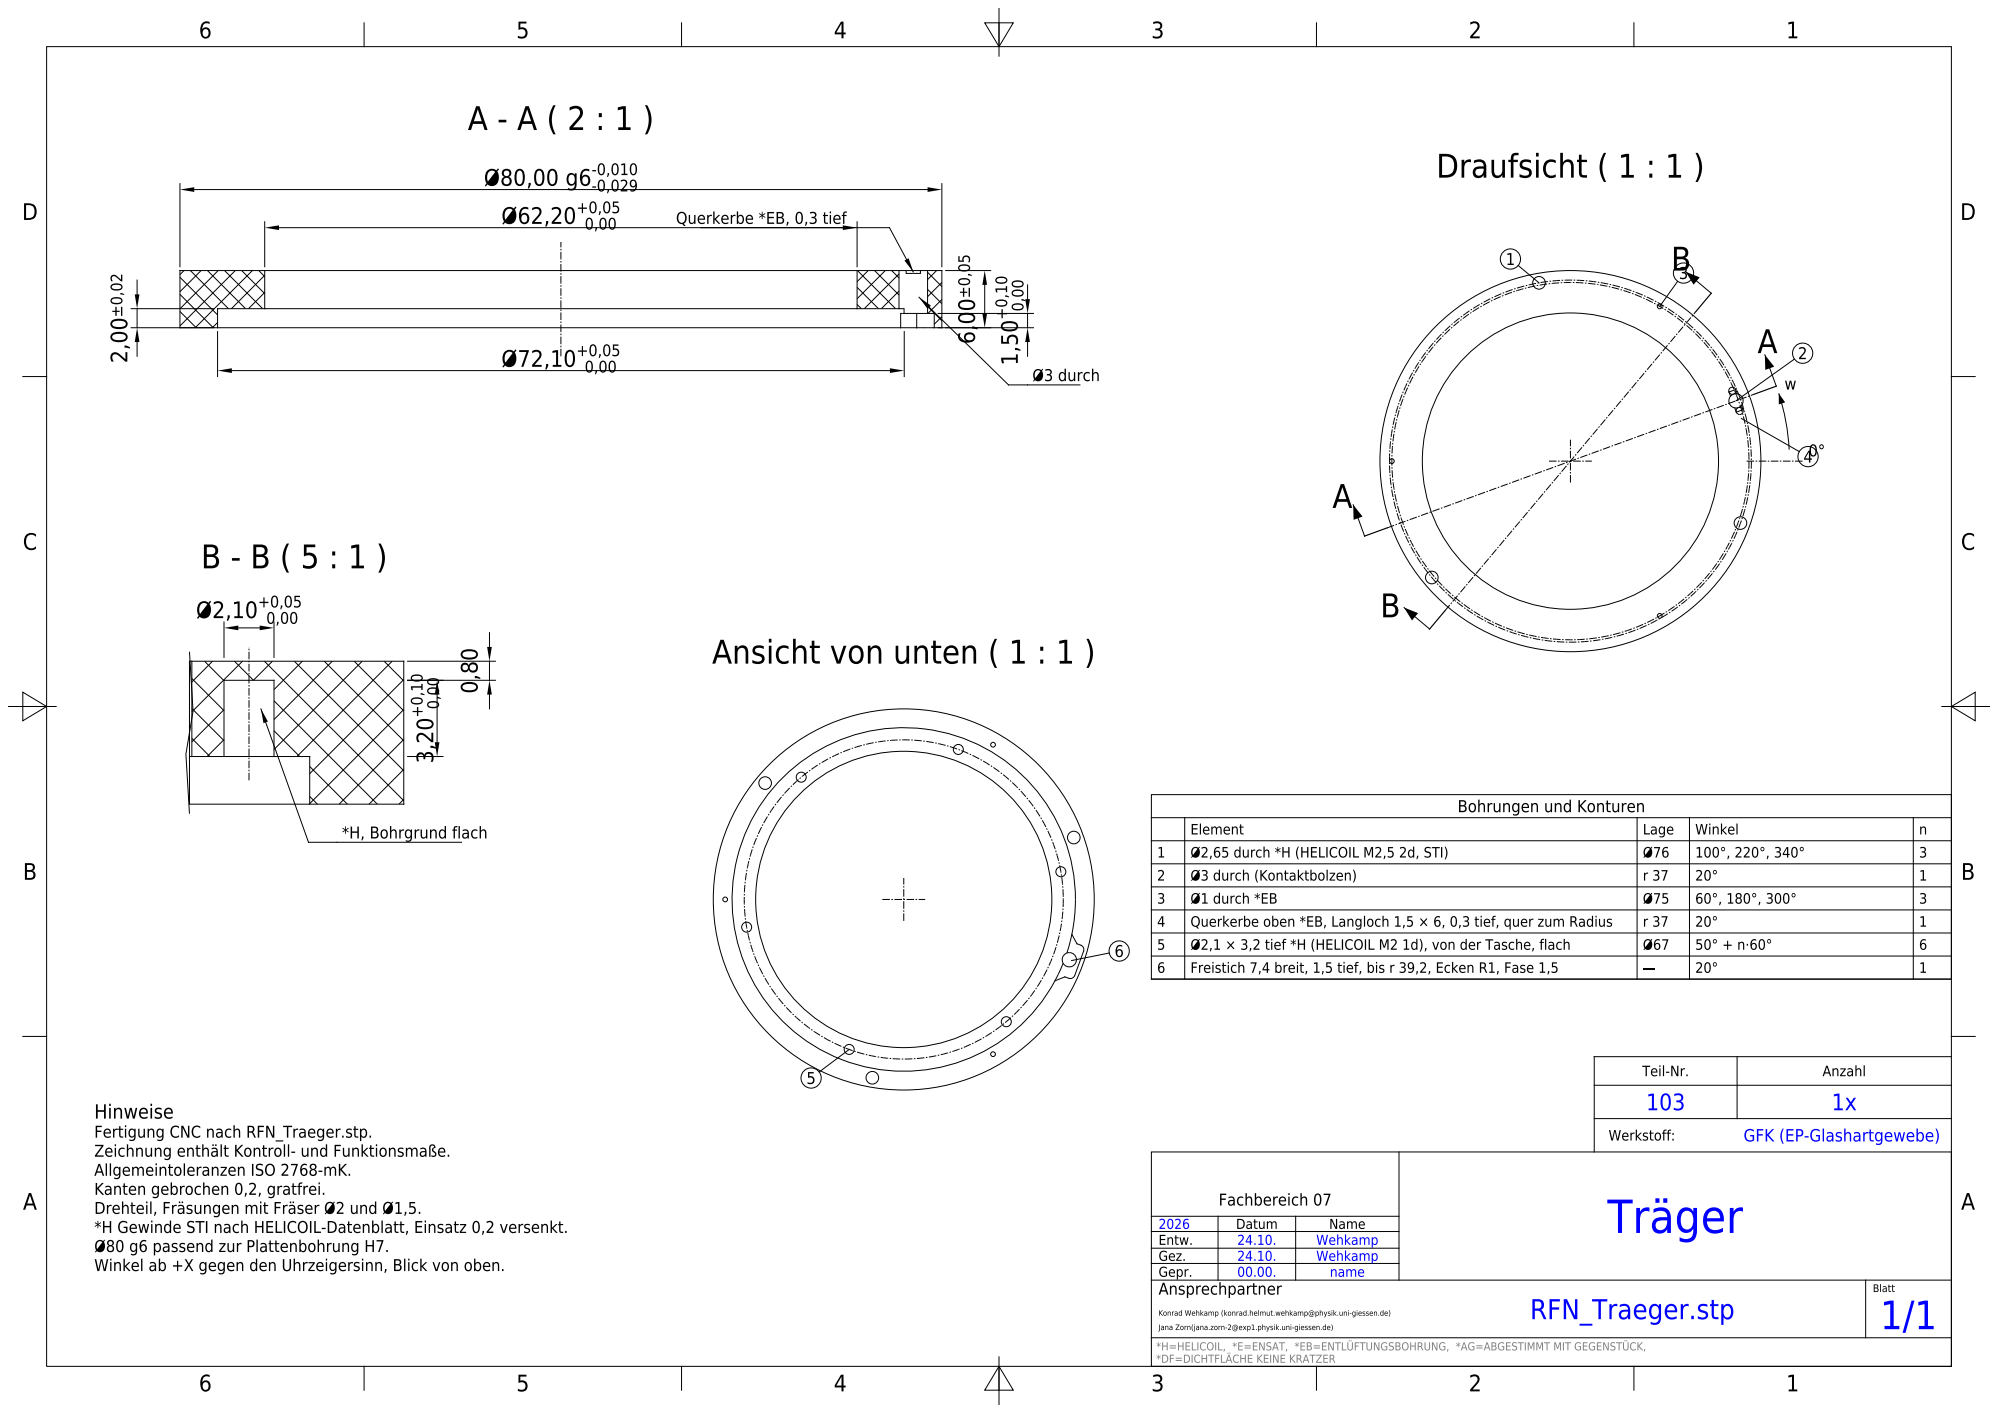
[picture p87: page 4]

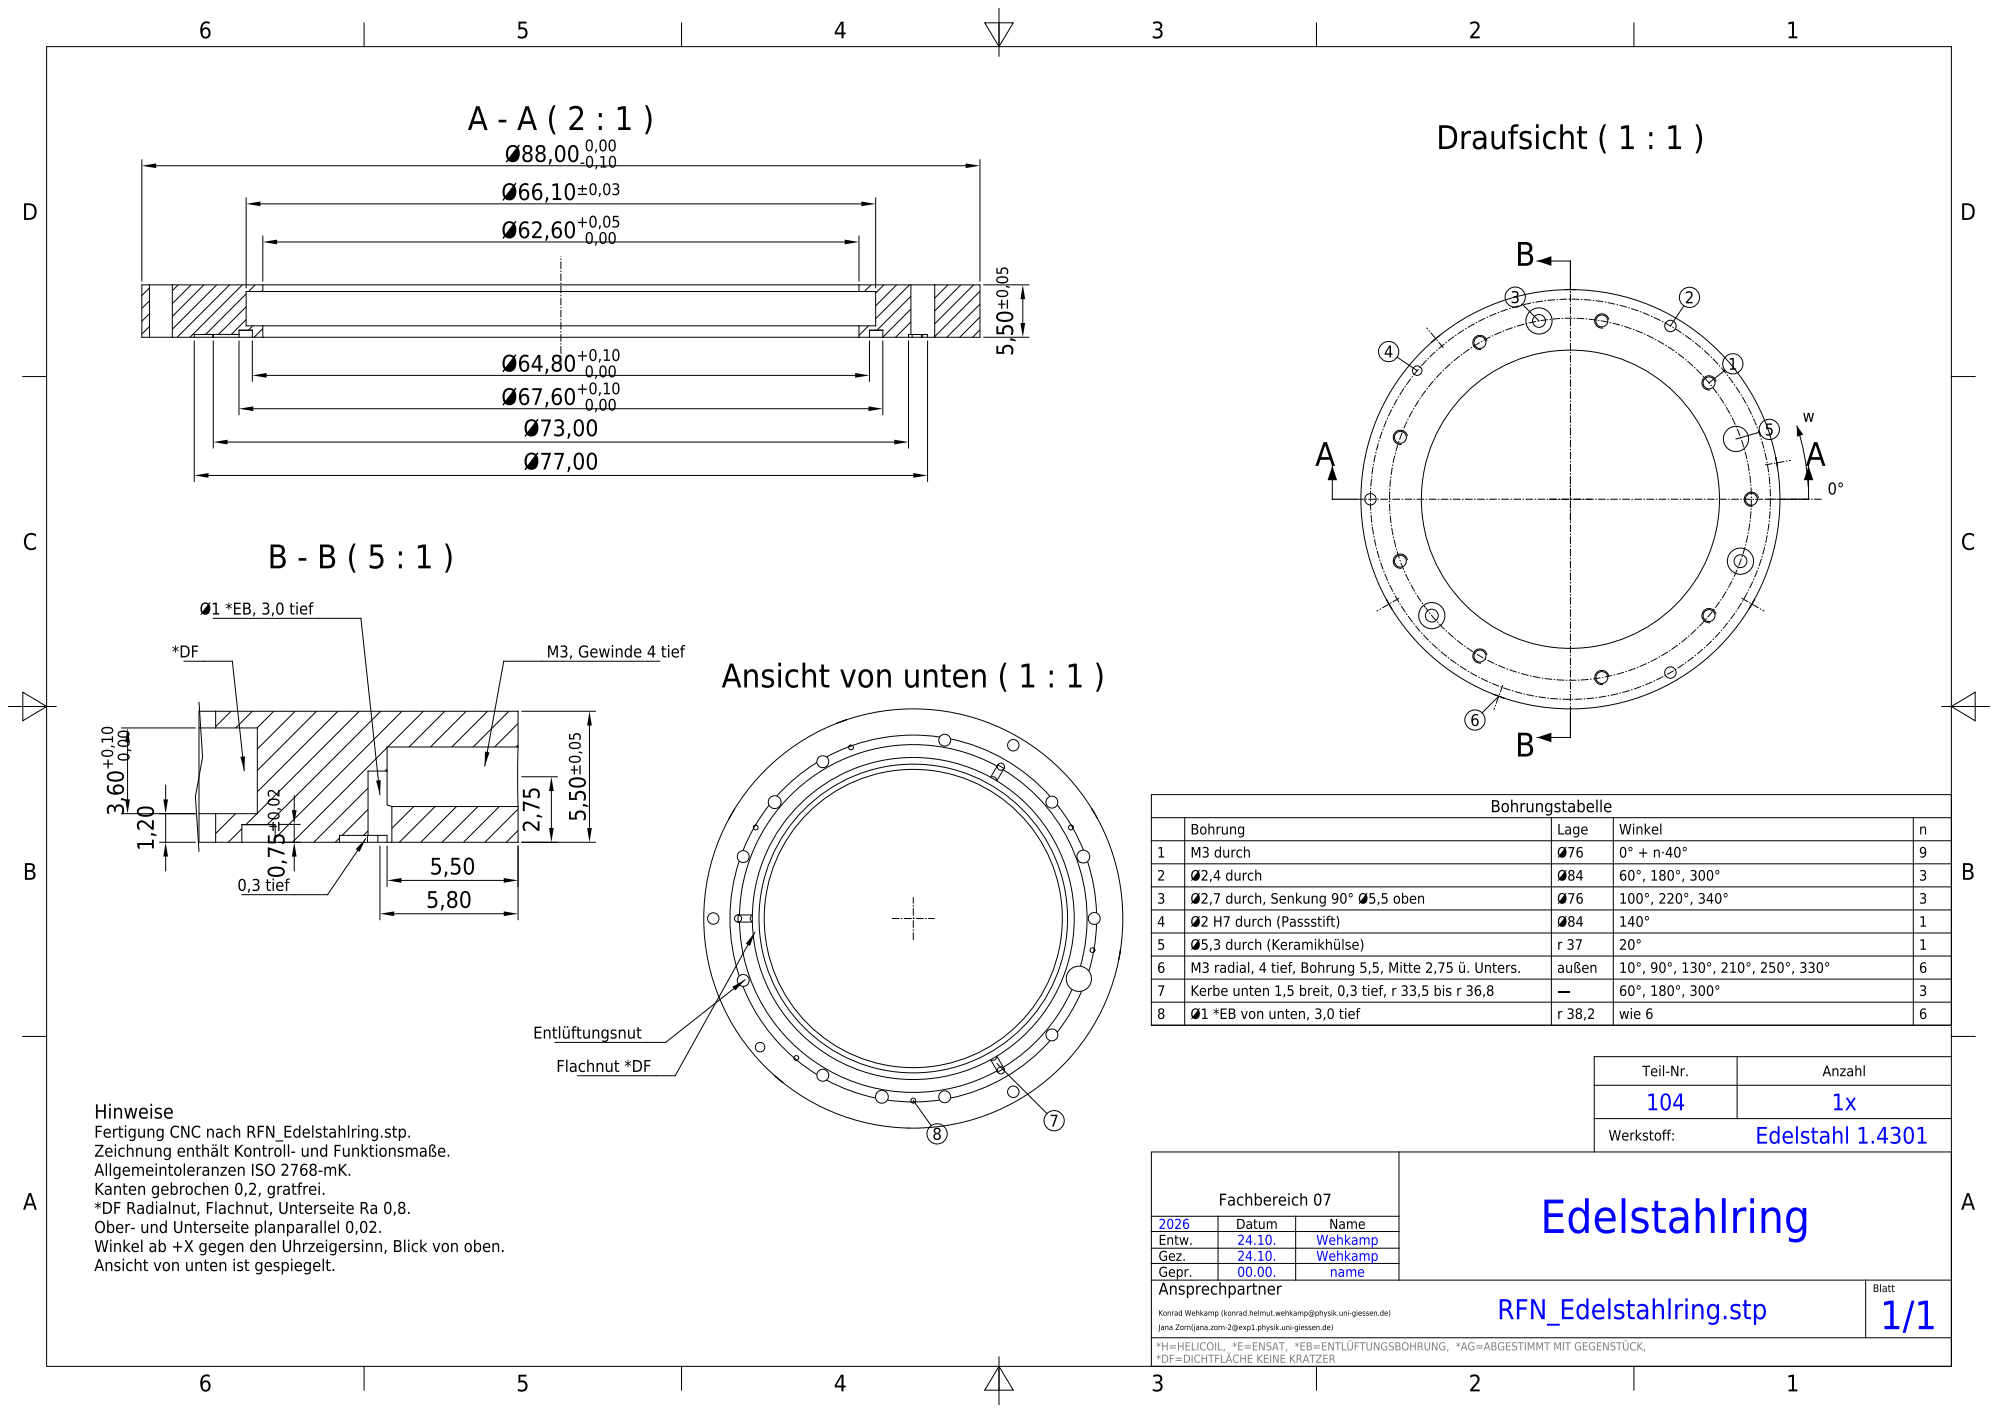
[picture p88: page 5]

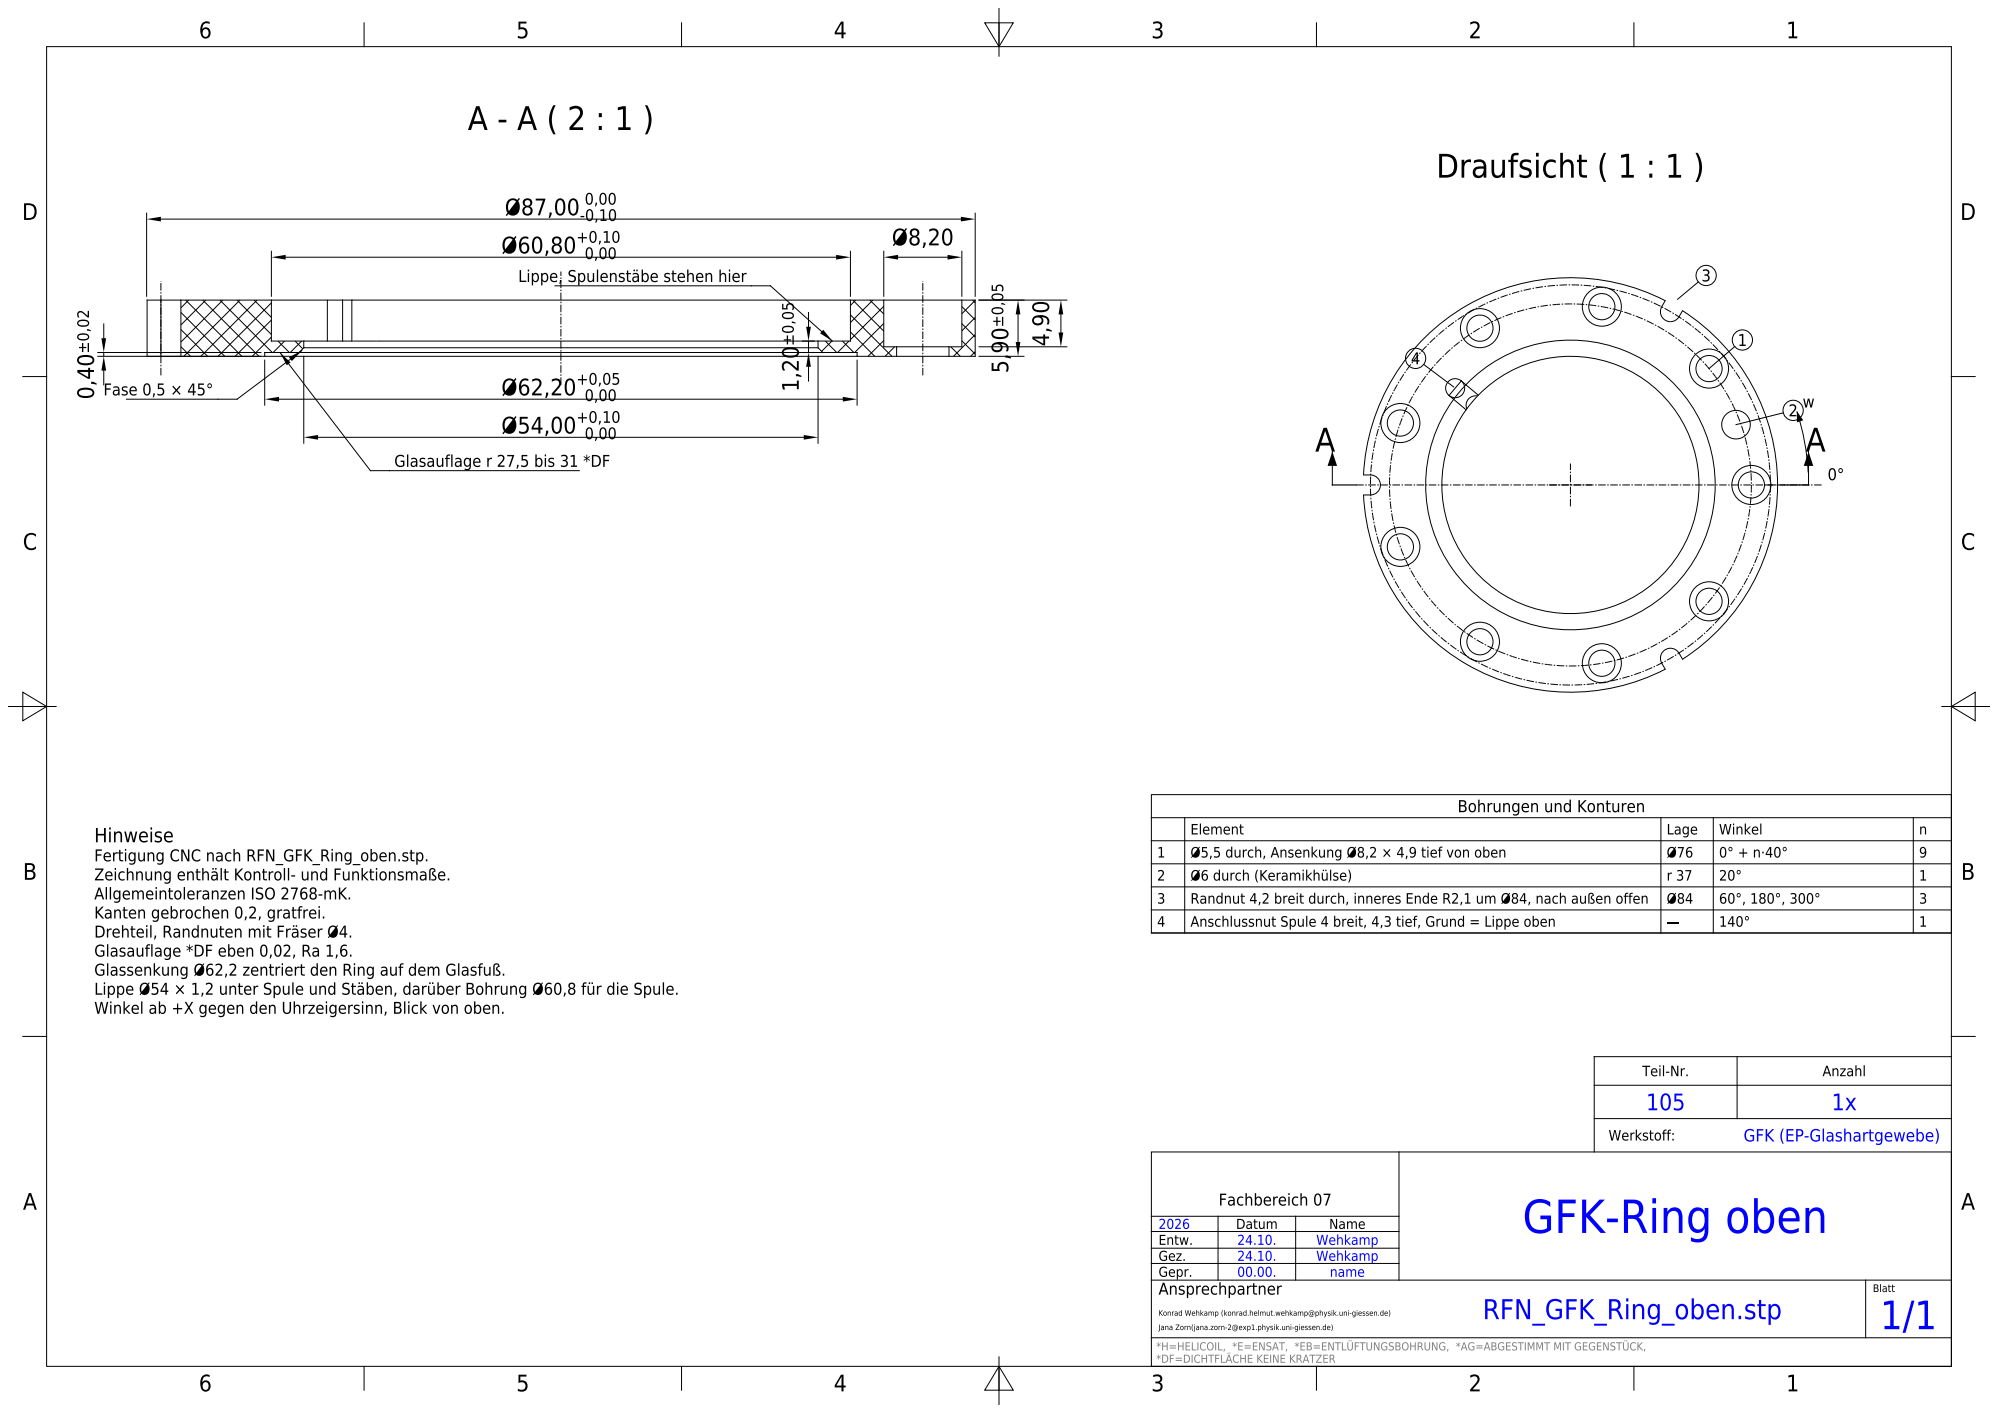
[picture p89: page 6]

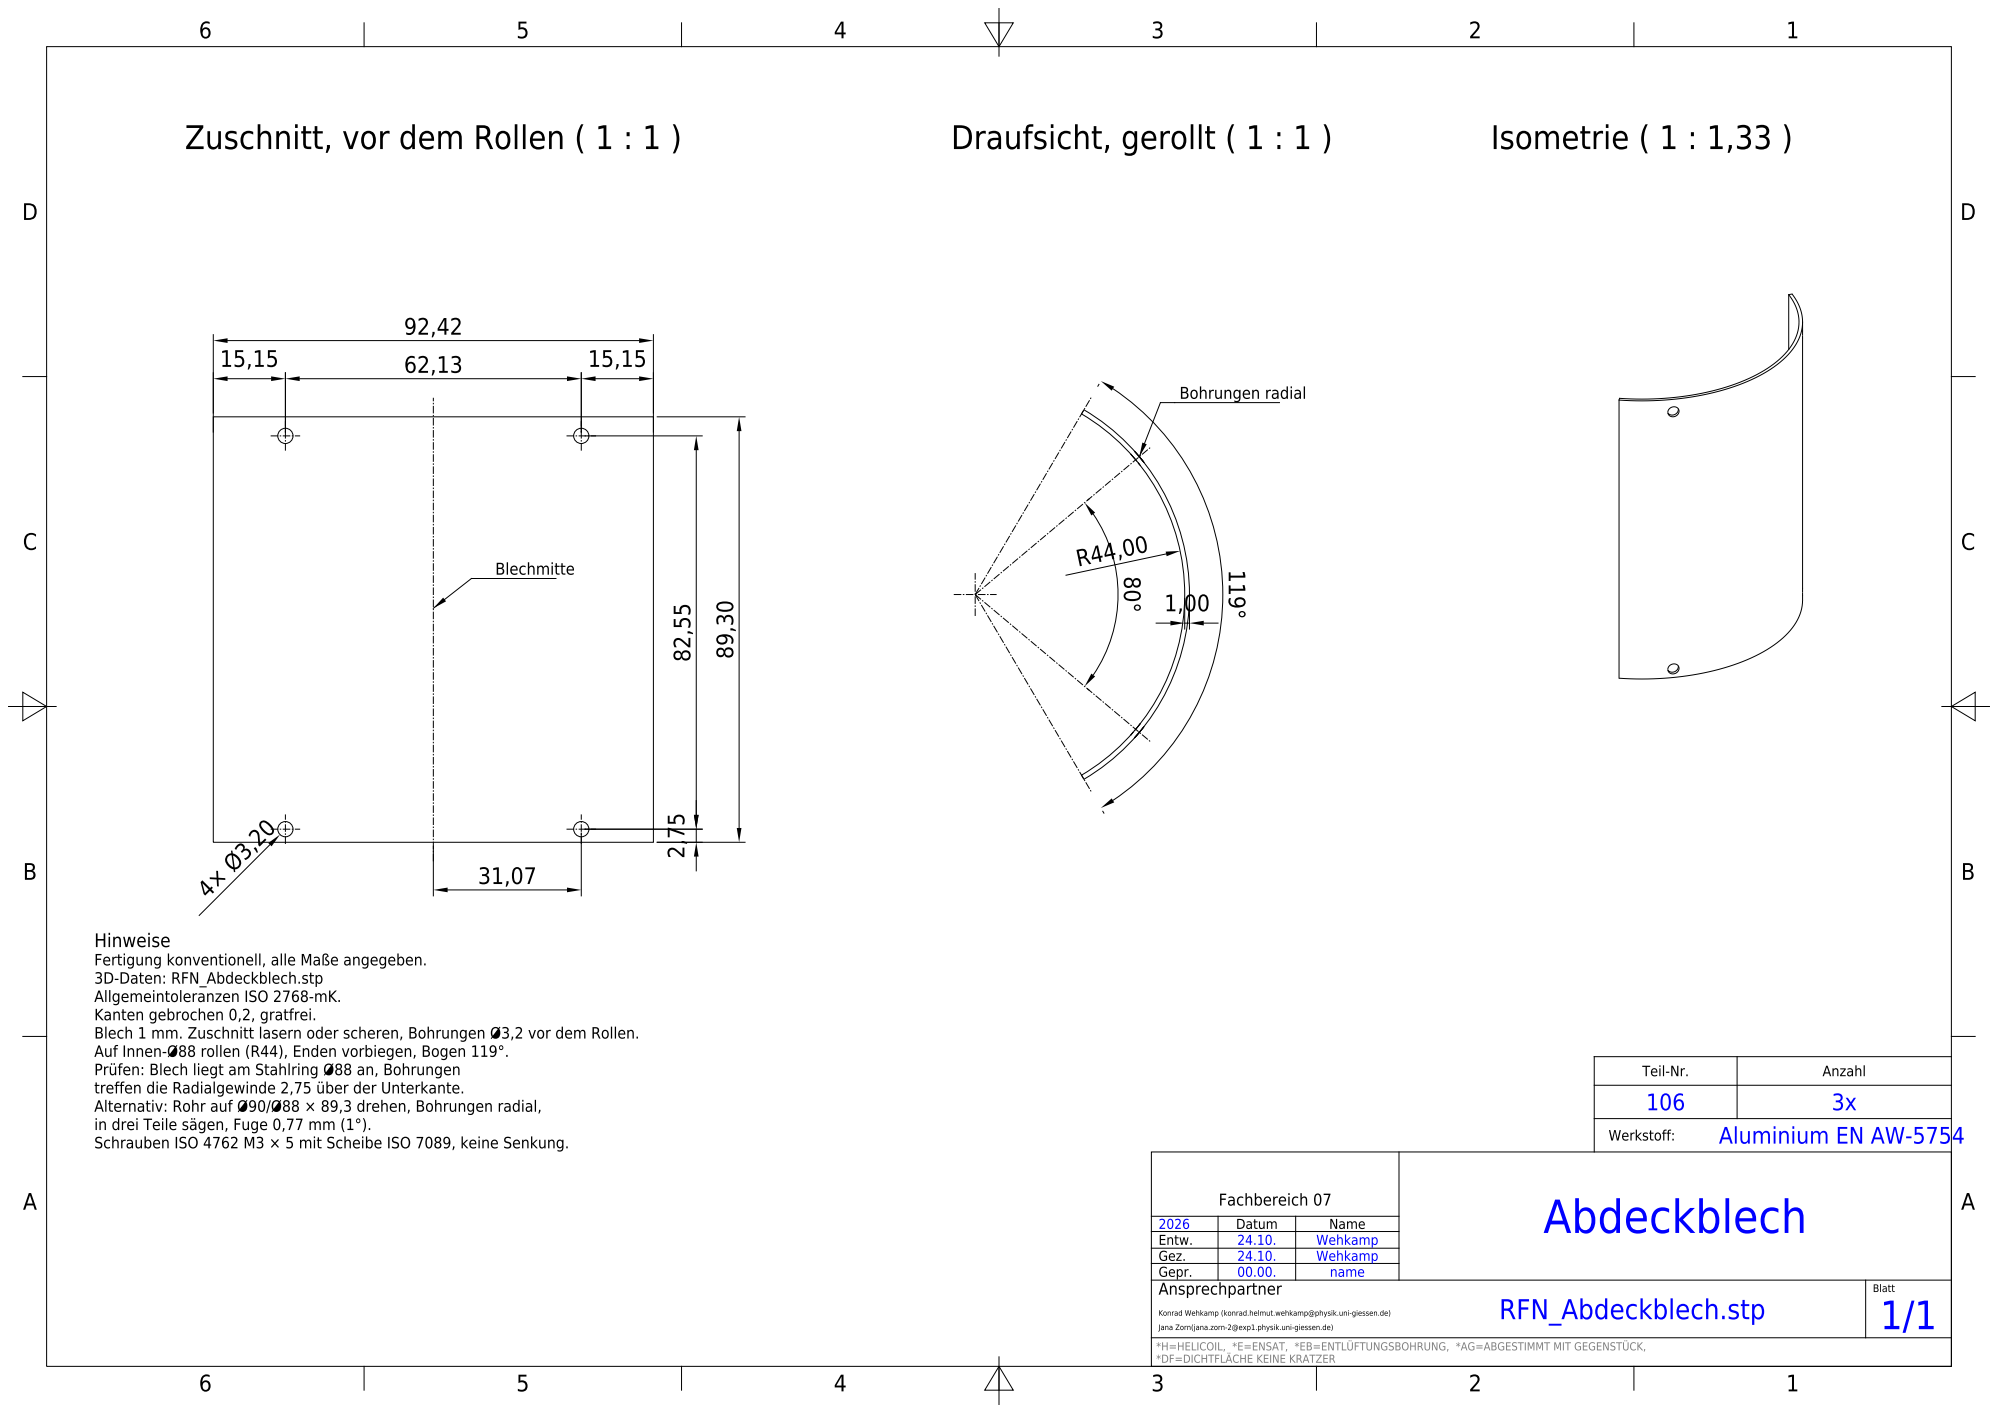
[picture p90: page 7]

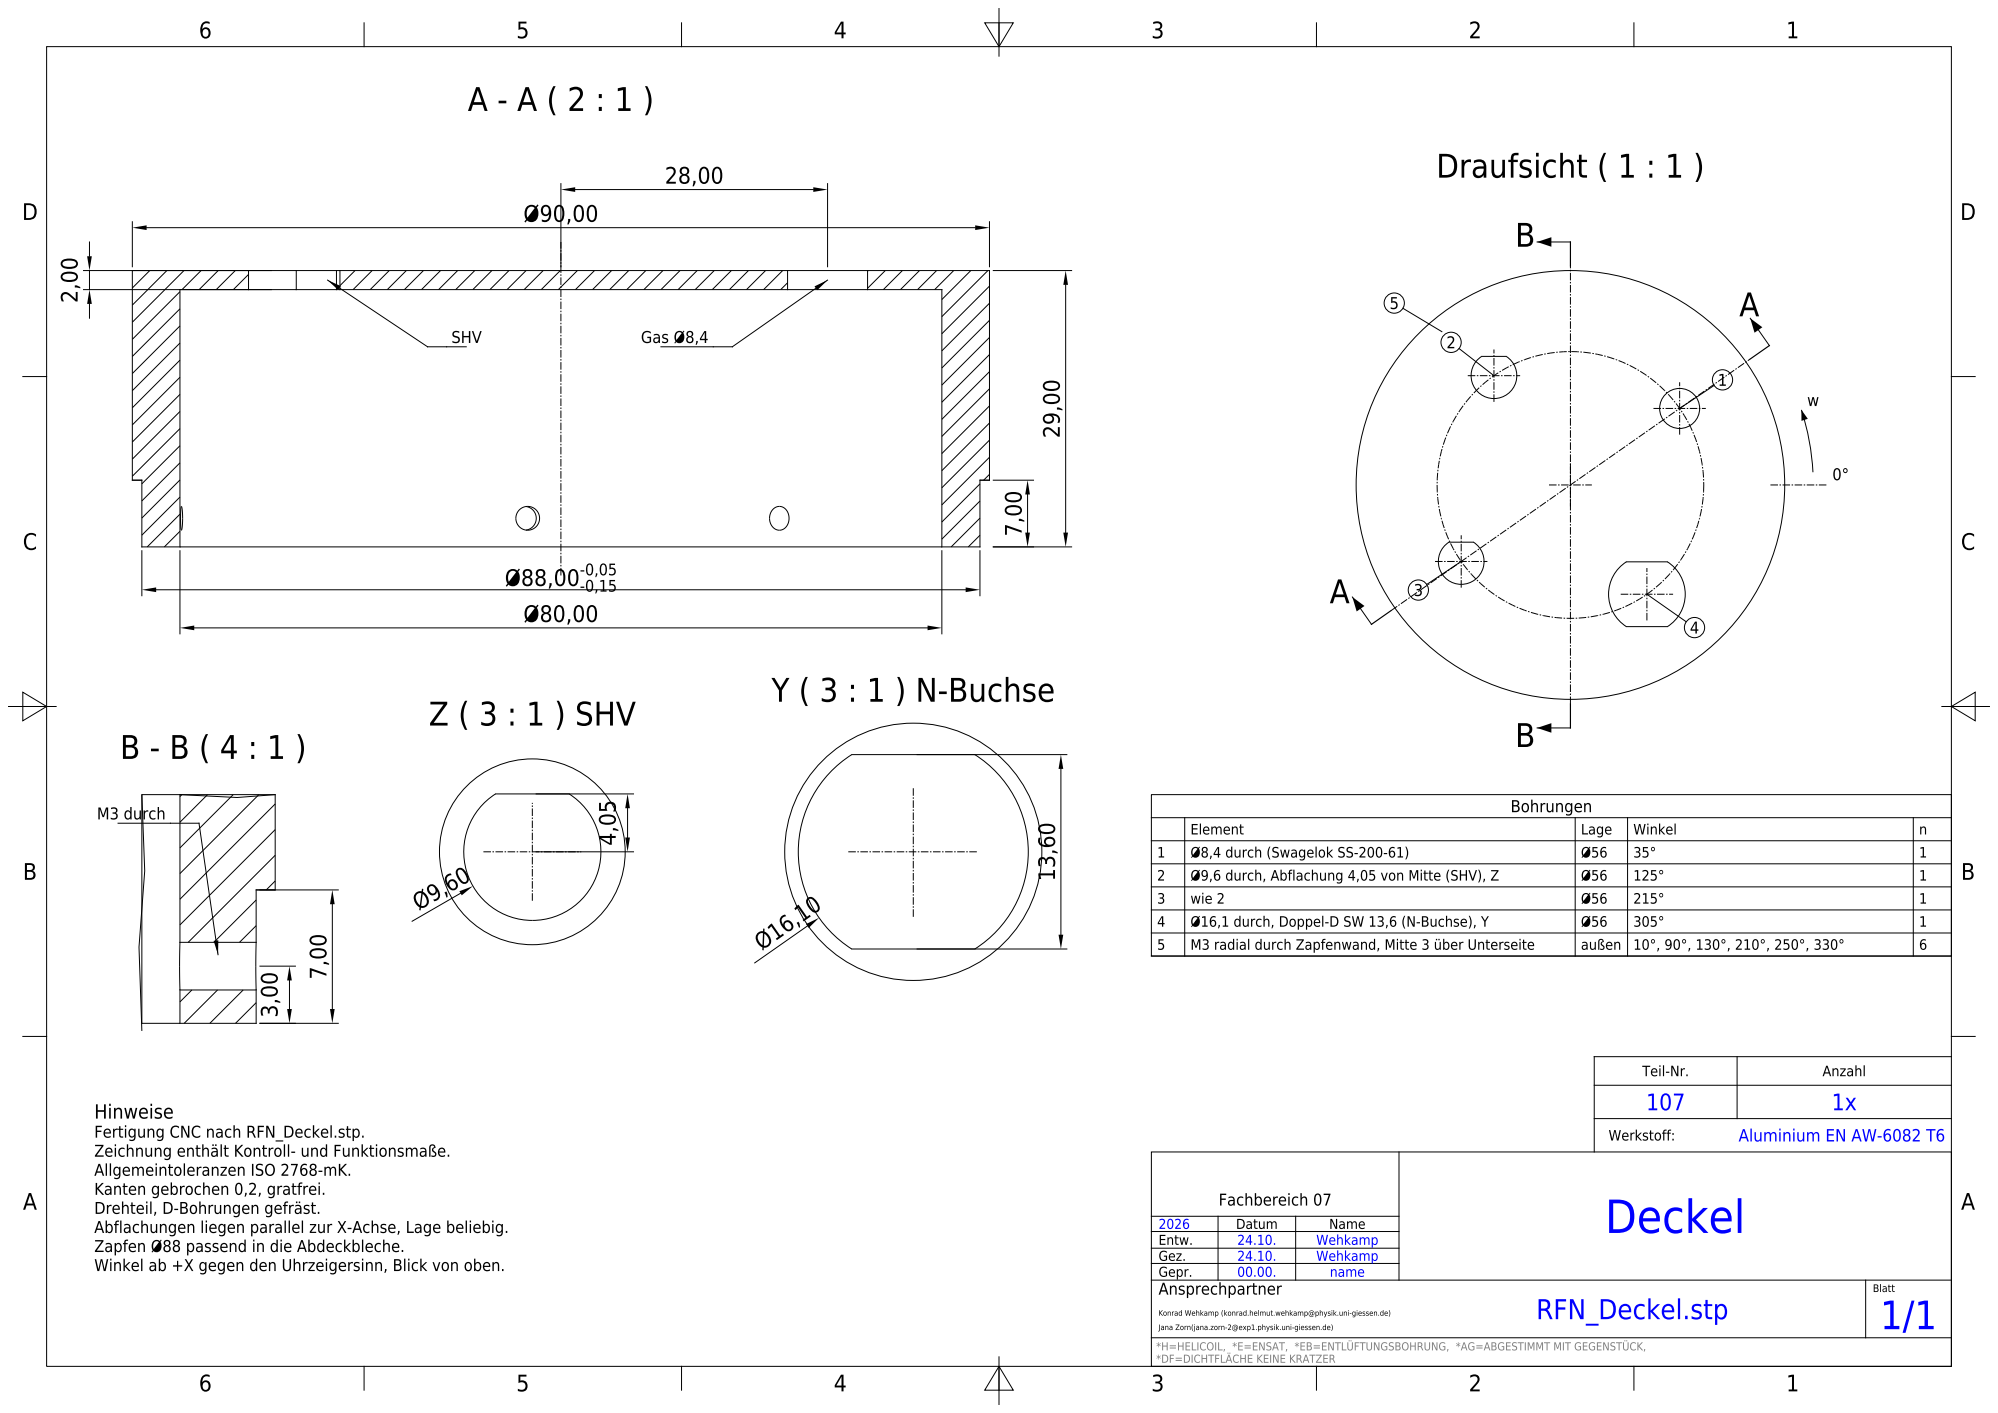
[picture p91: page 8]

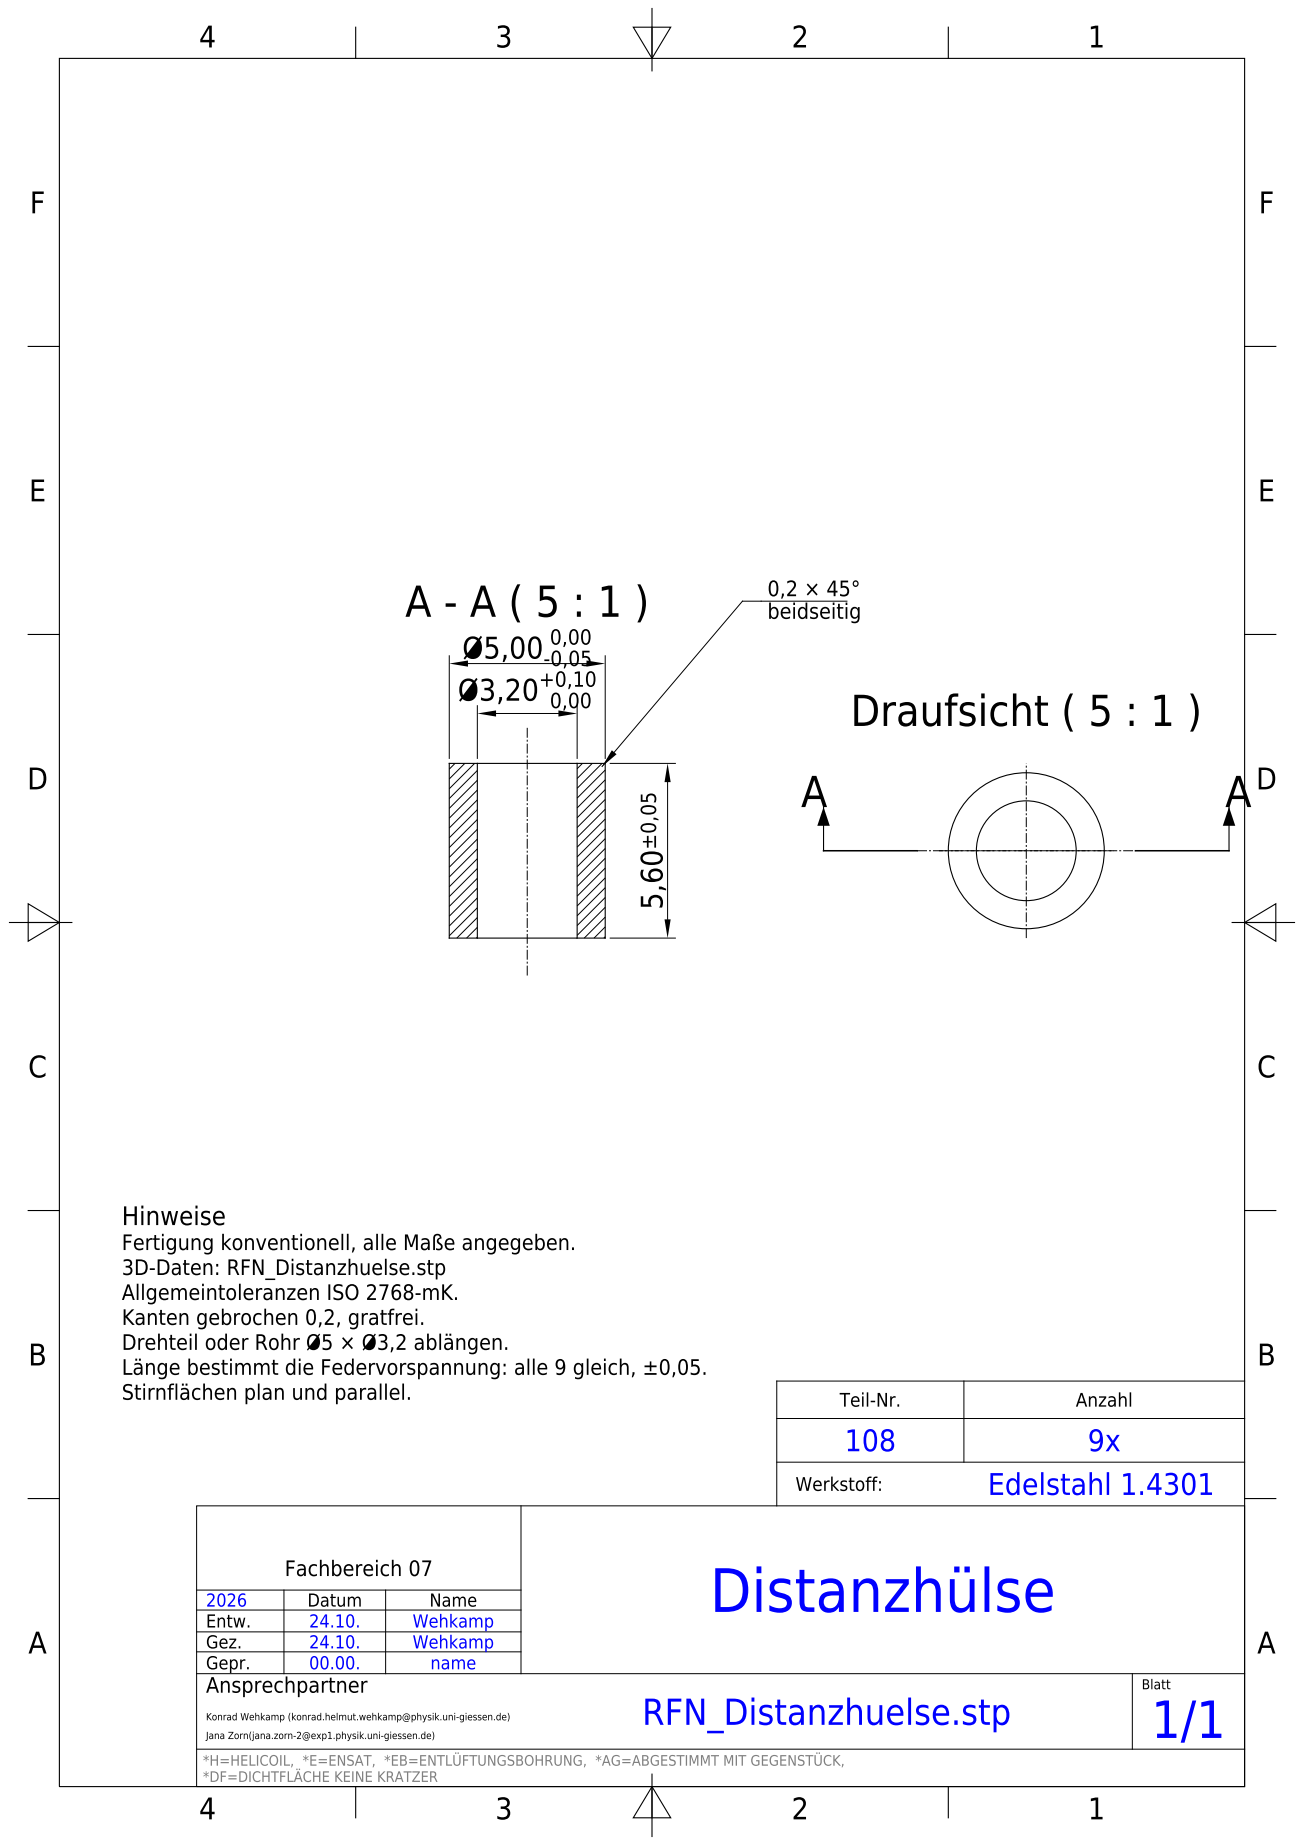
[picture p92: page 9]

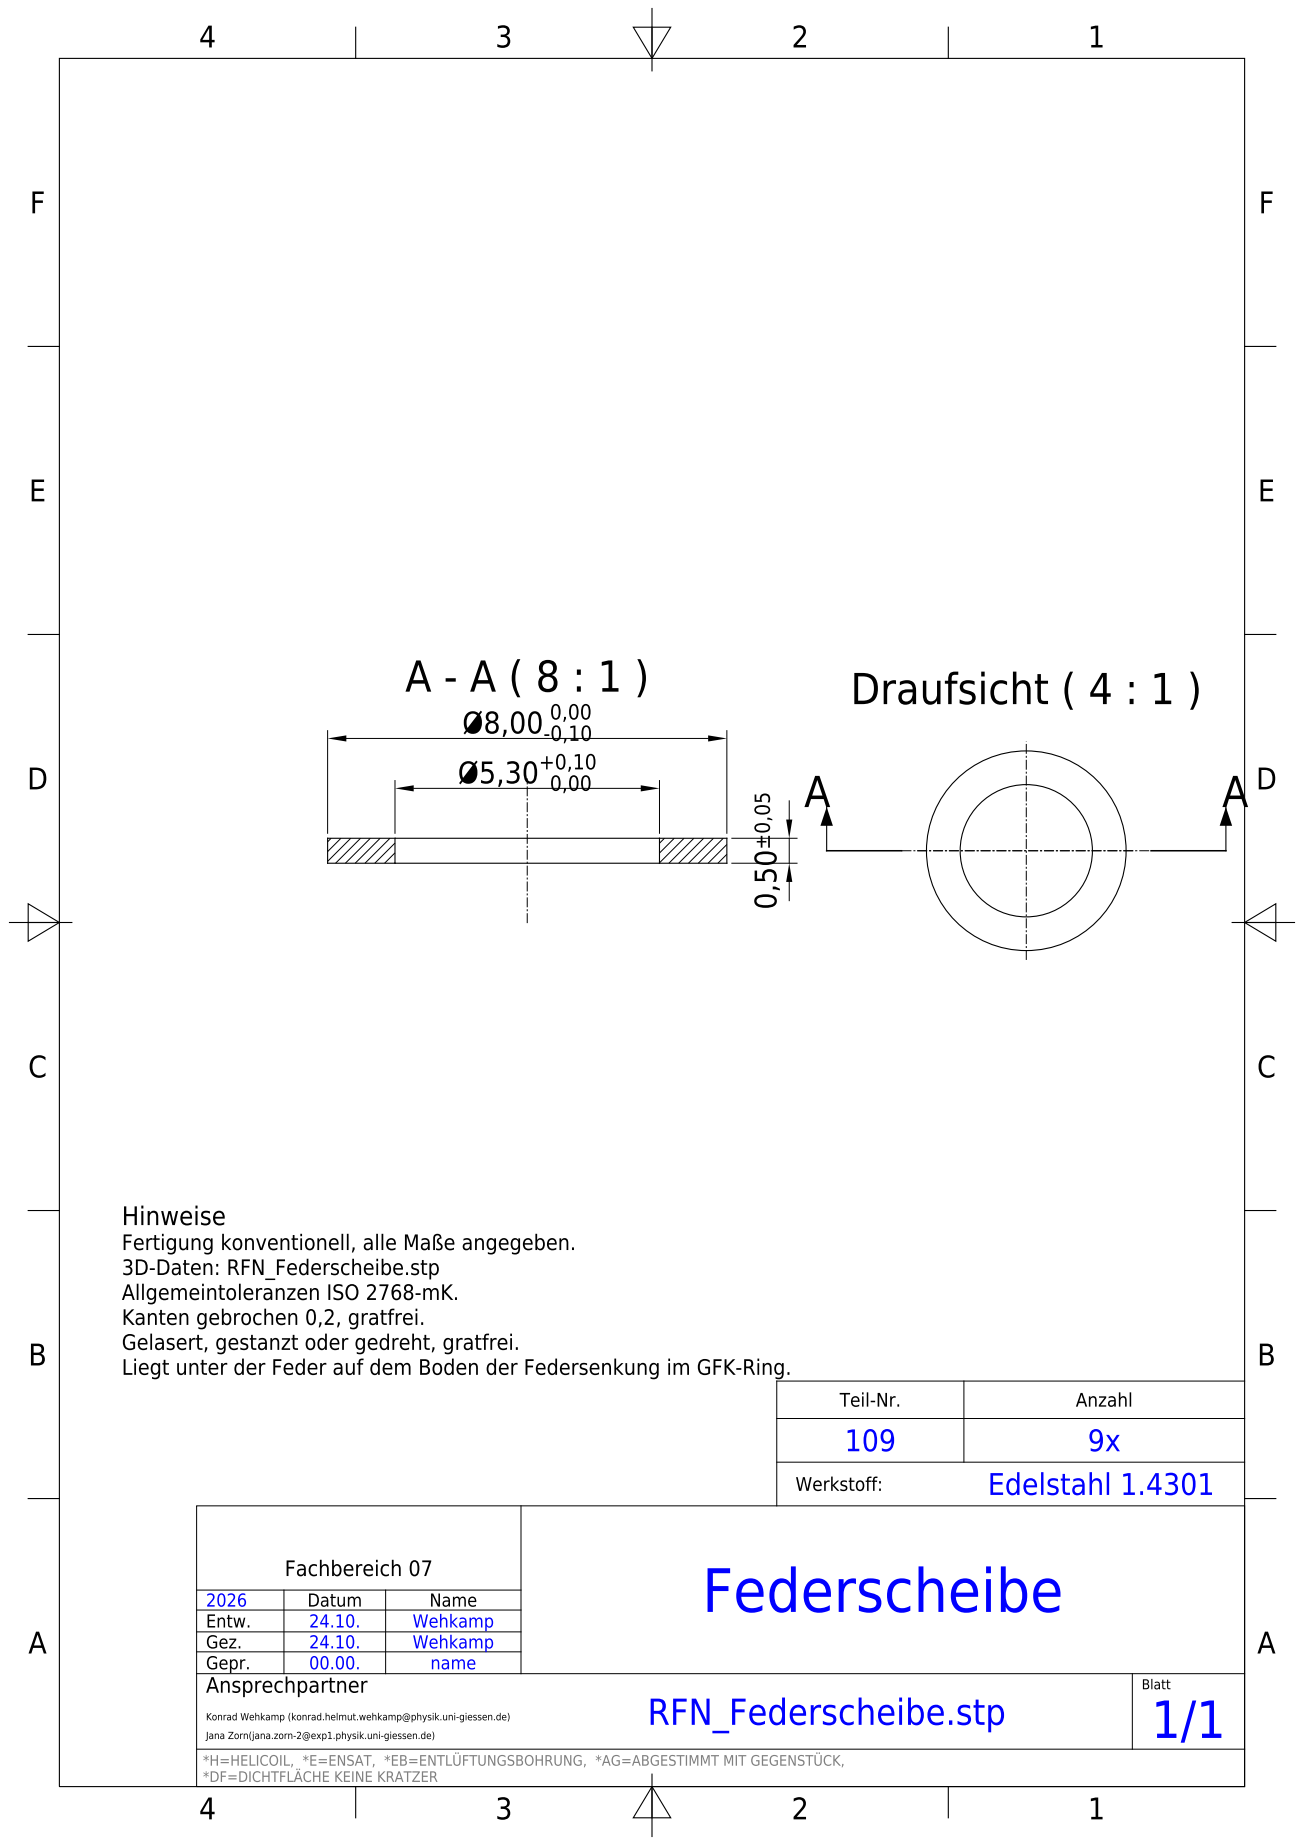
[picture p93: page 10]

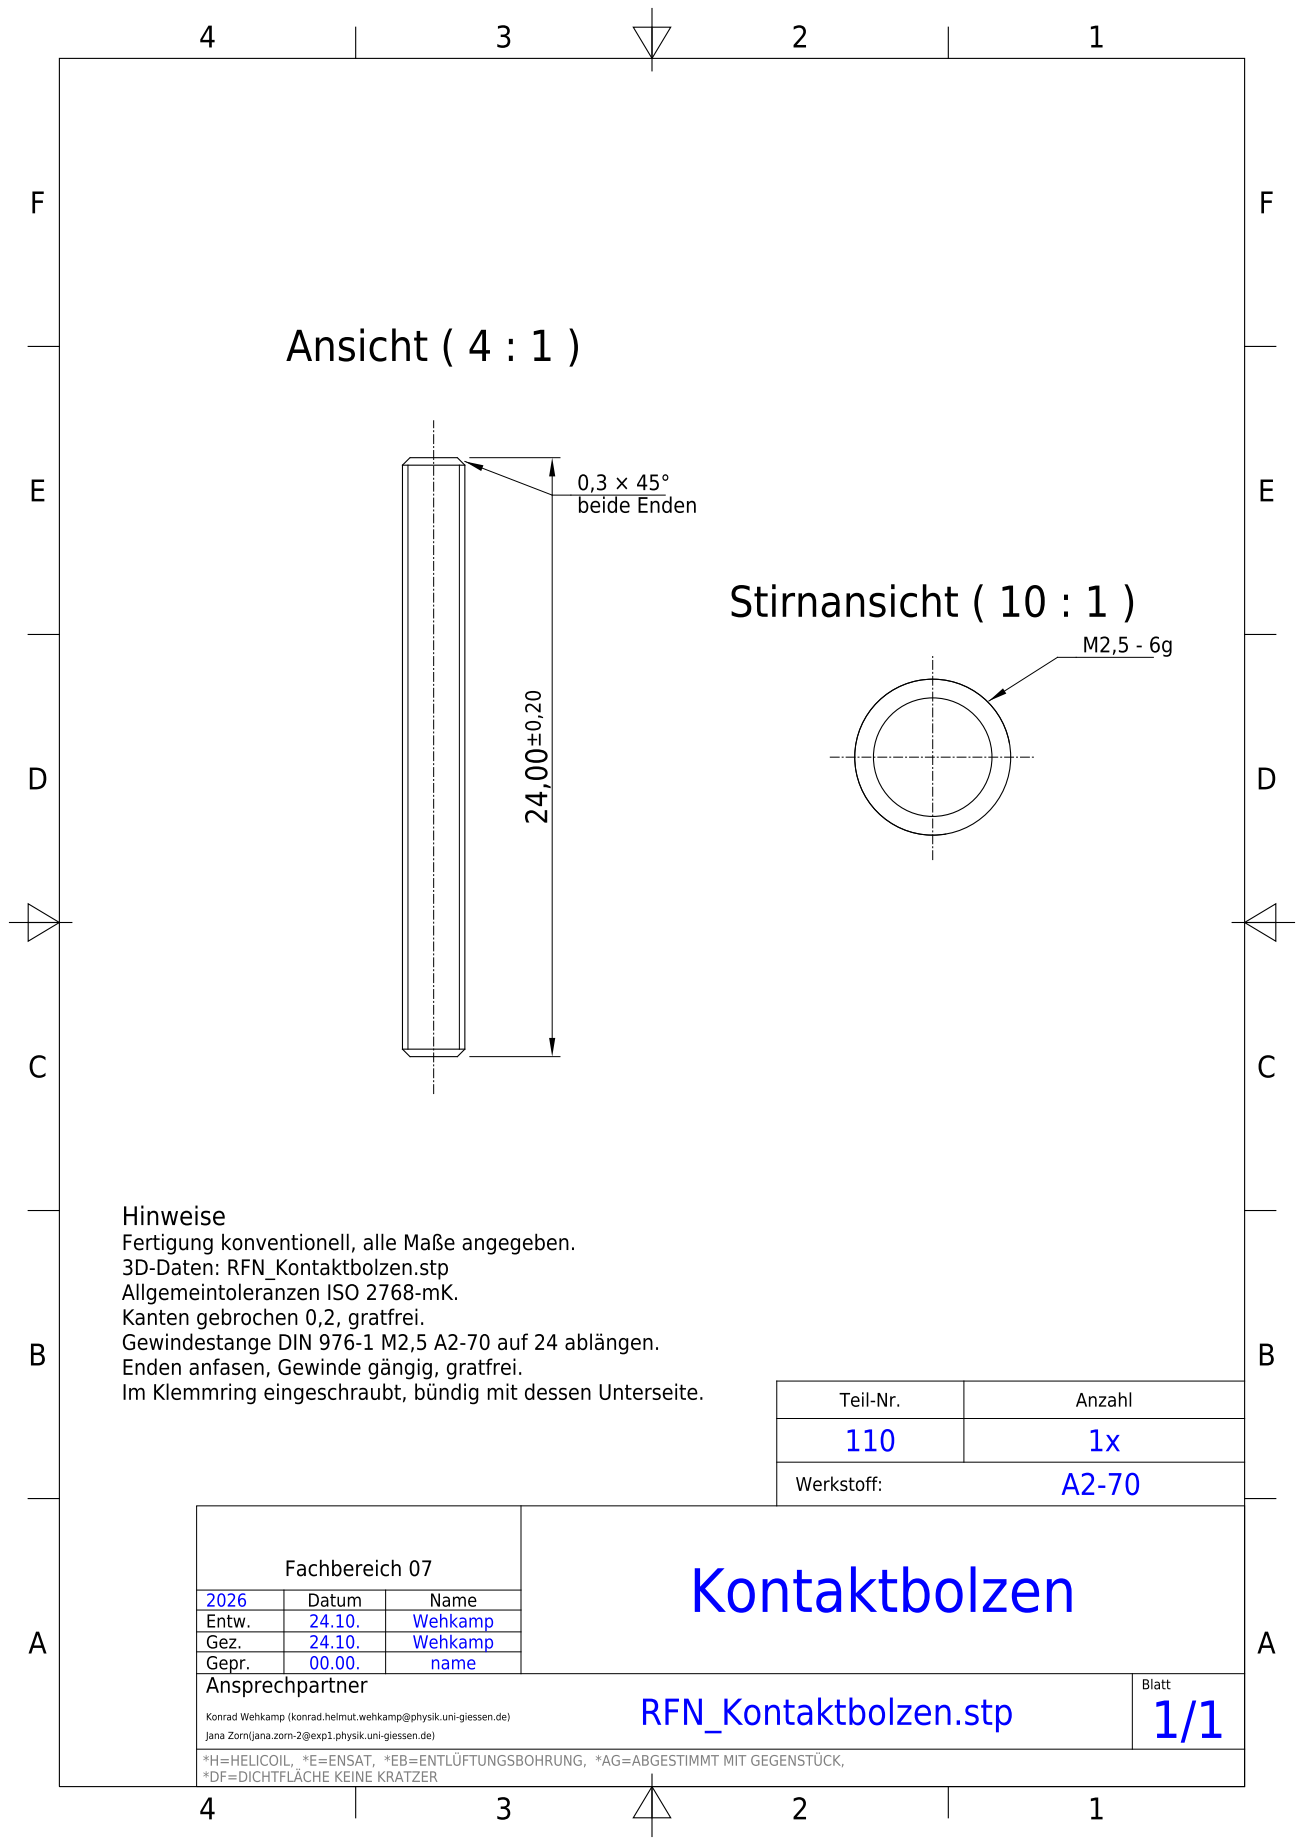
[picture p94: page 11]

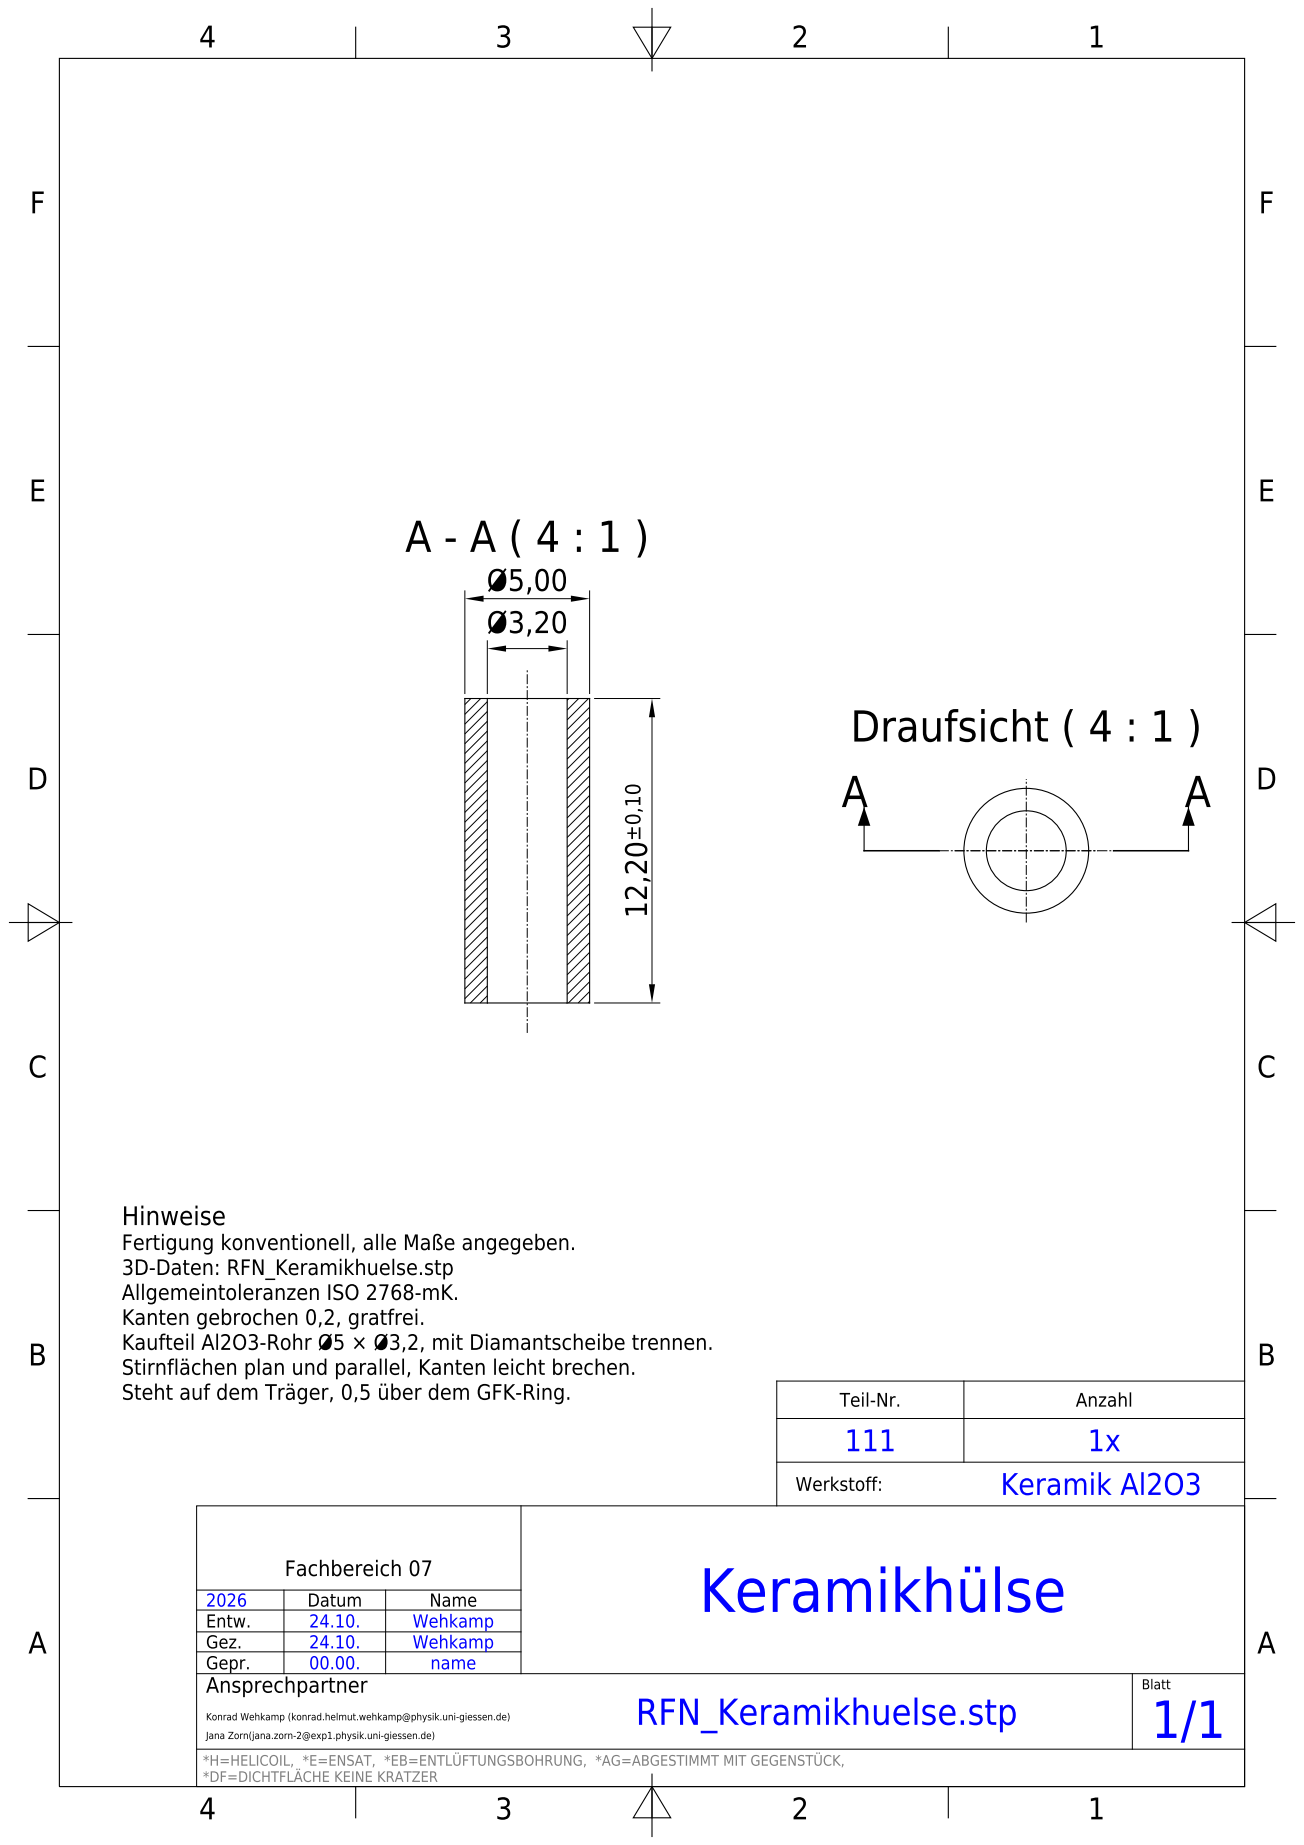
[picture p95: page 12]

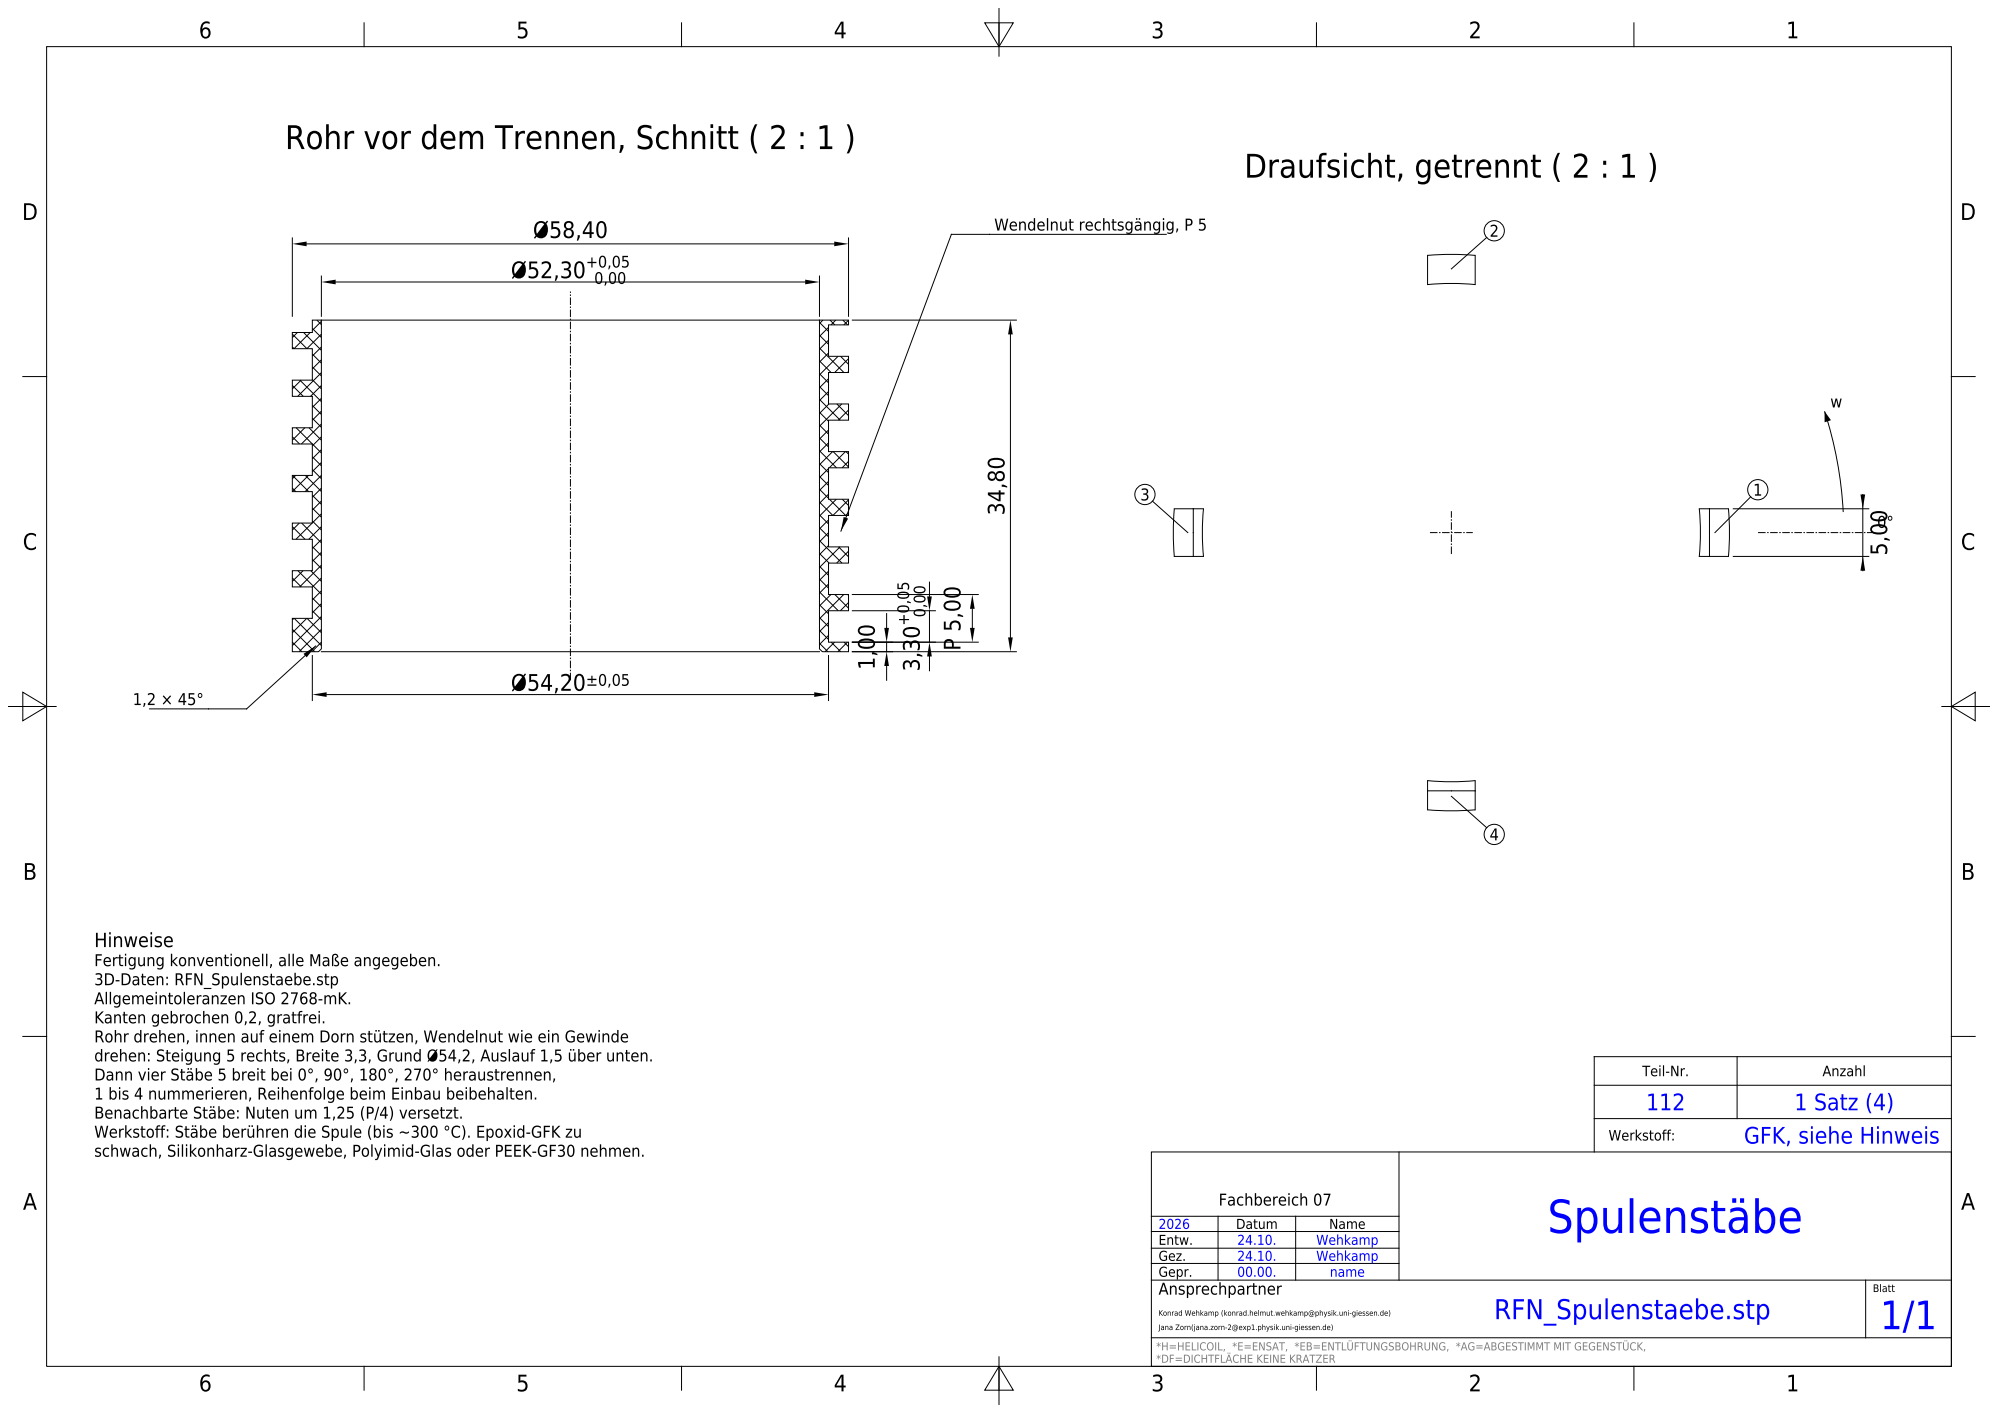
[picture p96: page 13]

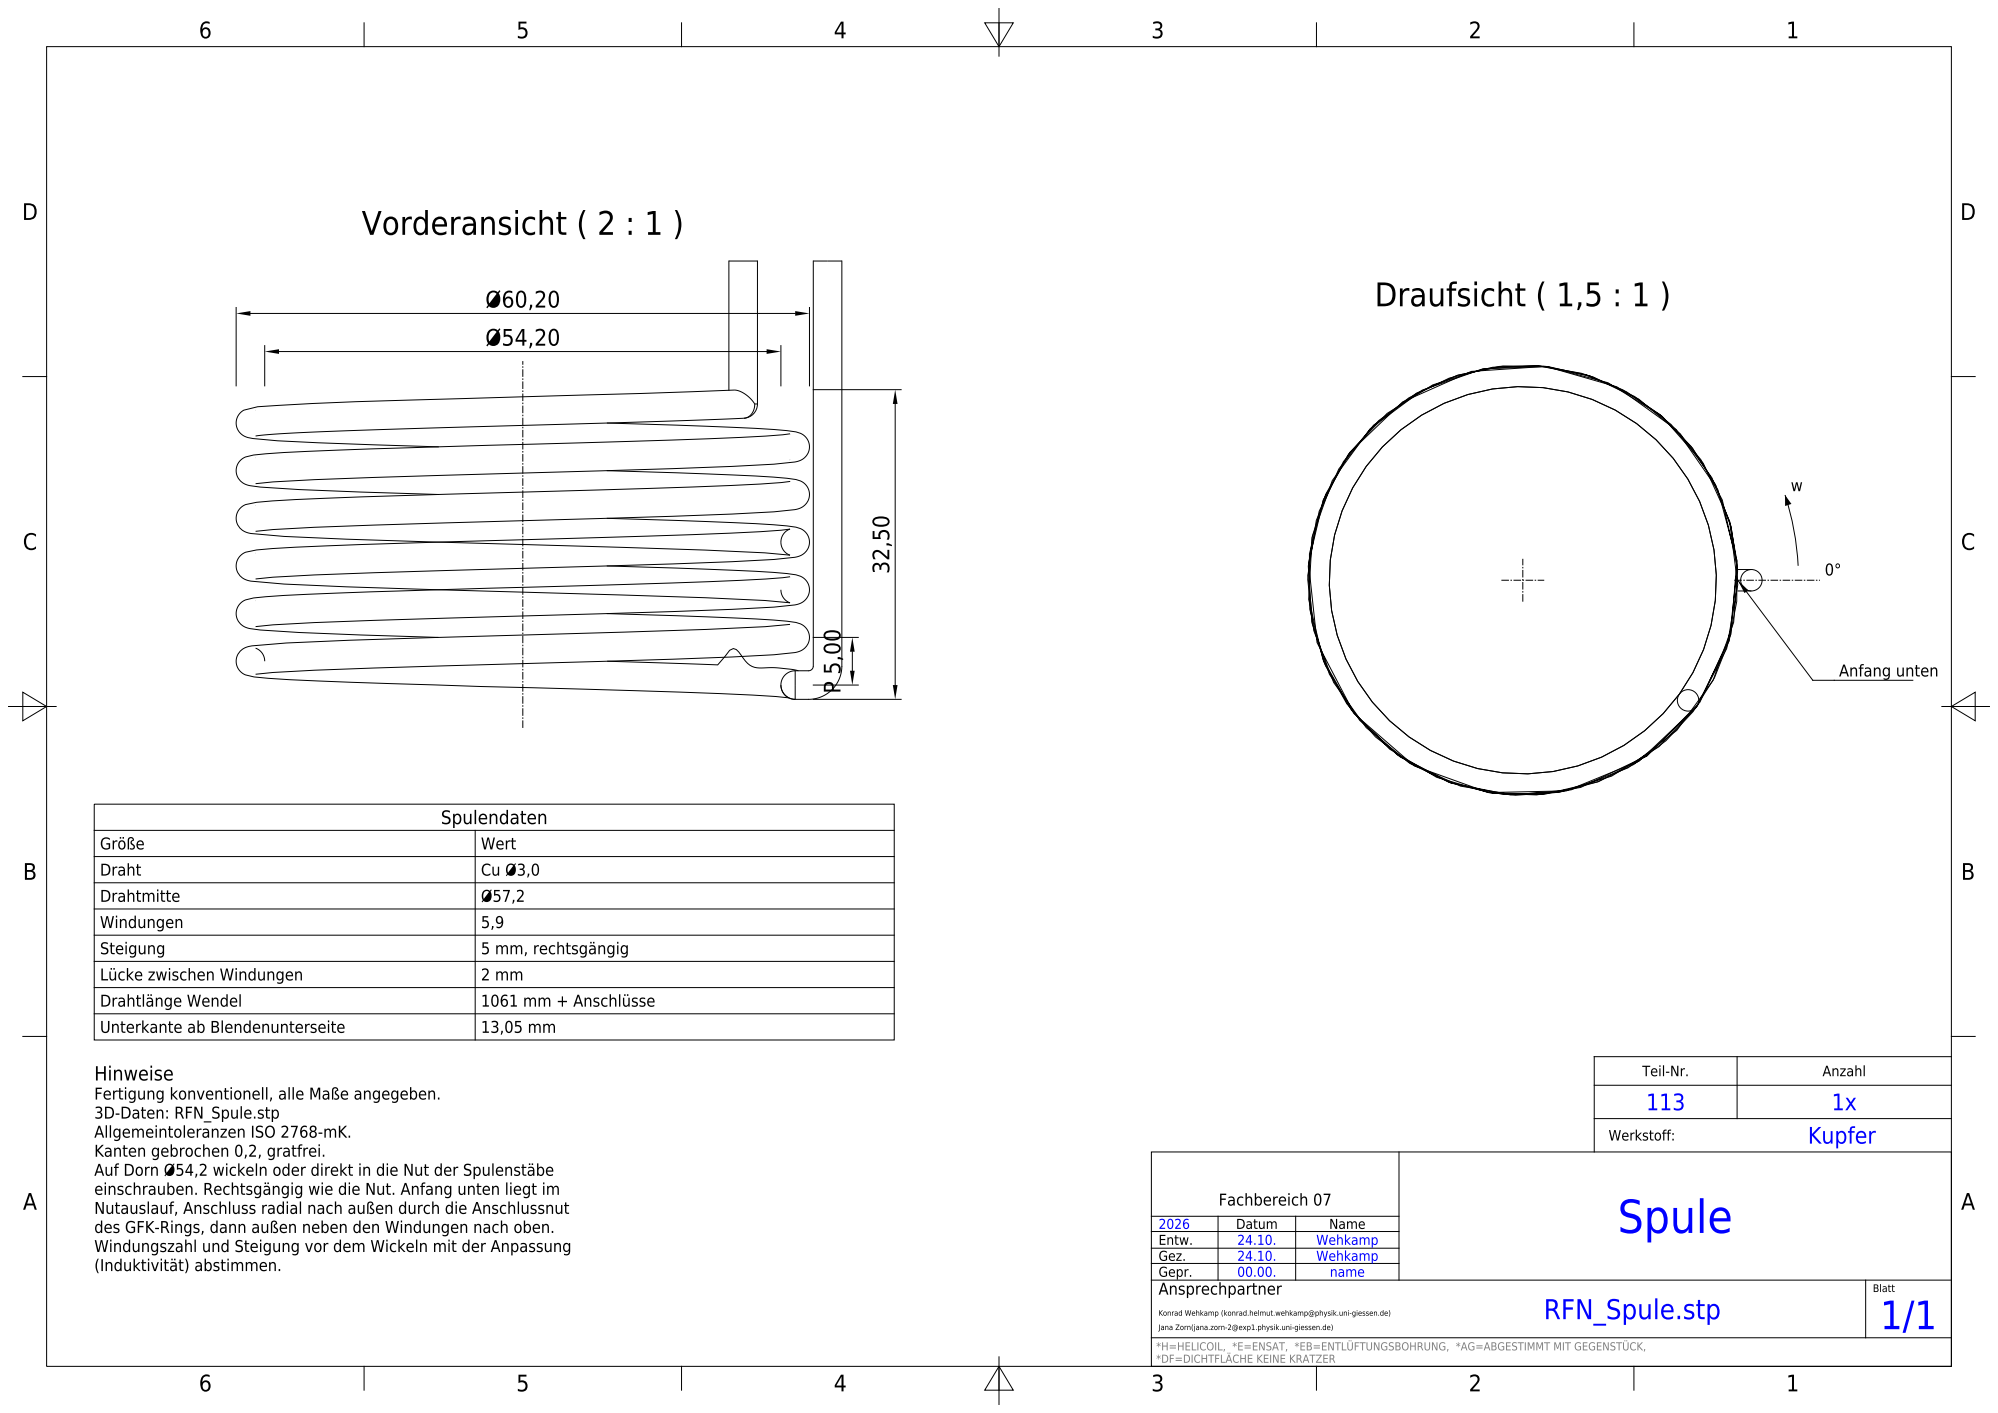
[picture p97: page 14]
