konradweh/ABEP_Koppeltest/Praesentation/img/RFN/halbschnitt.pdf

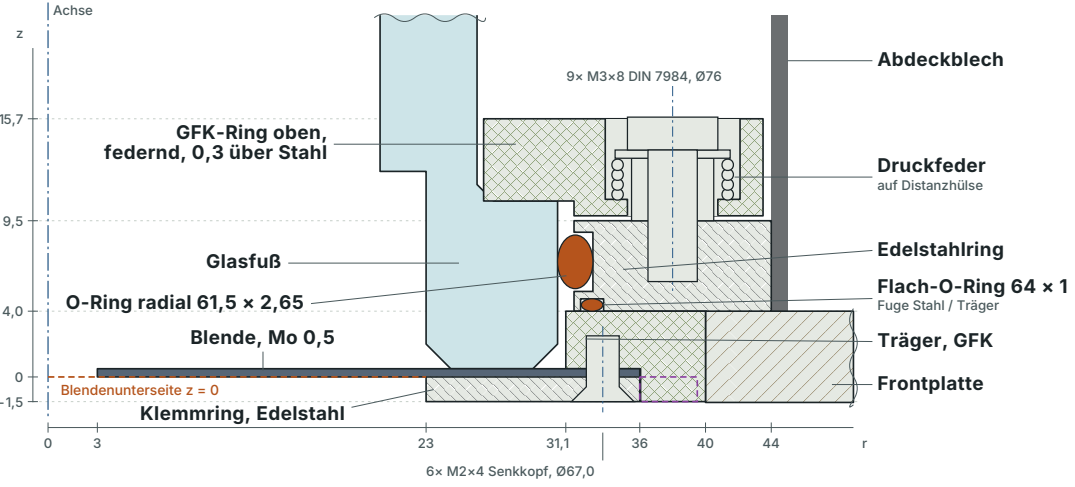
[picture p98: page 1]
Achse; Blendenunterseite z = 0; Blende, Mo 0,5; Klemmring, Edelstahl; Glasfuß; O-Ring radial 61,5 × 2,65; Abdeckblech; Druckfeder auf Distanzhülse; 9× M3×8 DIN 7984, Ø76; 6× M2×4 Senkkopf, Ø67,0

GFK-Ring oben,

federnd, 0,3 über Stahl

Edelstahlring
Flach-O-Ring 64 × 1
Fuge Stahl / Träger
Träger, GFK
Frontplatte
