konradweh/ABEP_Koppeltest/CAD/Halterung/Zeichnungen/Abgabe/Halterung_Gewindestange.pdf

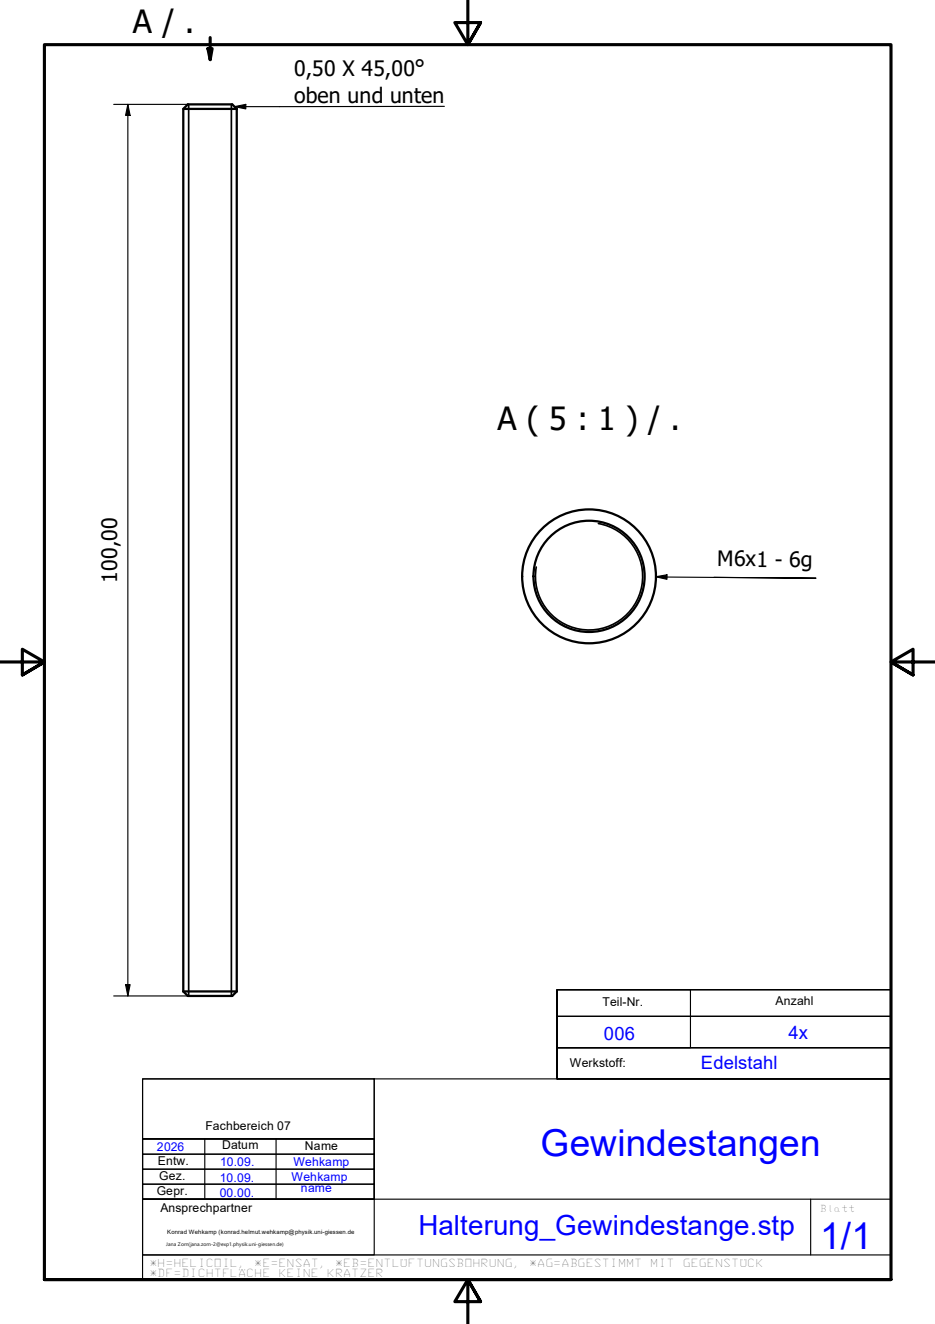
[picture p99: page 1]

oben und unten

Teil-Nr. | Anzahl
006 | 4x

Fachbereich 07 | Gewindestangen
2026 | Datum | Name

Entw. | 10.09. | Wehkamp
Gez. | 10.09. | Wehkamp
Gepr. | 00.00. | name

Ansprechpartner Konrad Wehkamp (konrad.helmut.wehkamp@physik.uni-giessen.de Jana Zorn(jana.zorn-2@exp1.physik.uni-giessen.de) | Halterung_Gewindestange.stp | Blatt 1/1

*H=HELICOIL, *E=ENSAT, *EB=ENTLÜFTUNGSBOHRUNG, *AG=ABGESTIMMT MIT GEGENSTÜCK
*DF=DICHTFLÄCHE KEINE KRATZER
