konradweh/ABEP_Koppeltest/CAD/Halterung/Zeichnungen/Abgabe/Halterung_Winkelprofilrahmen.pdf

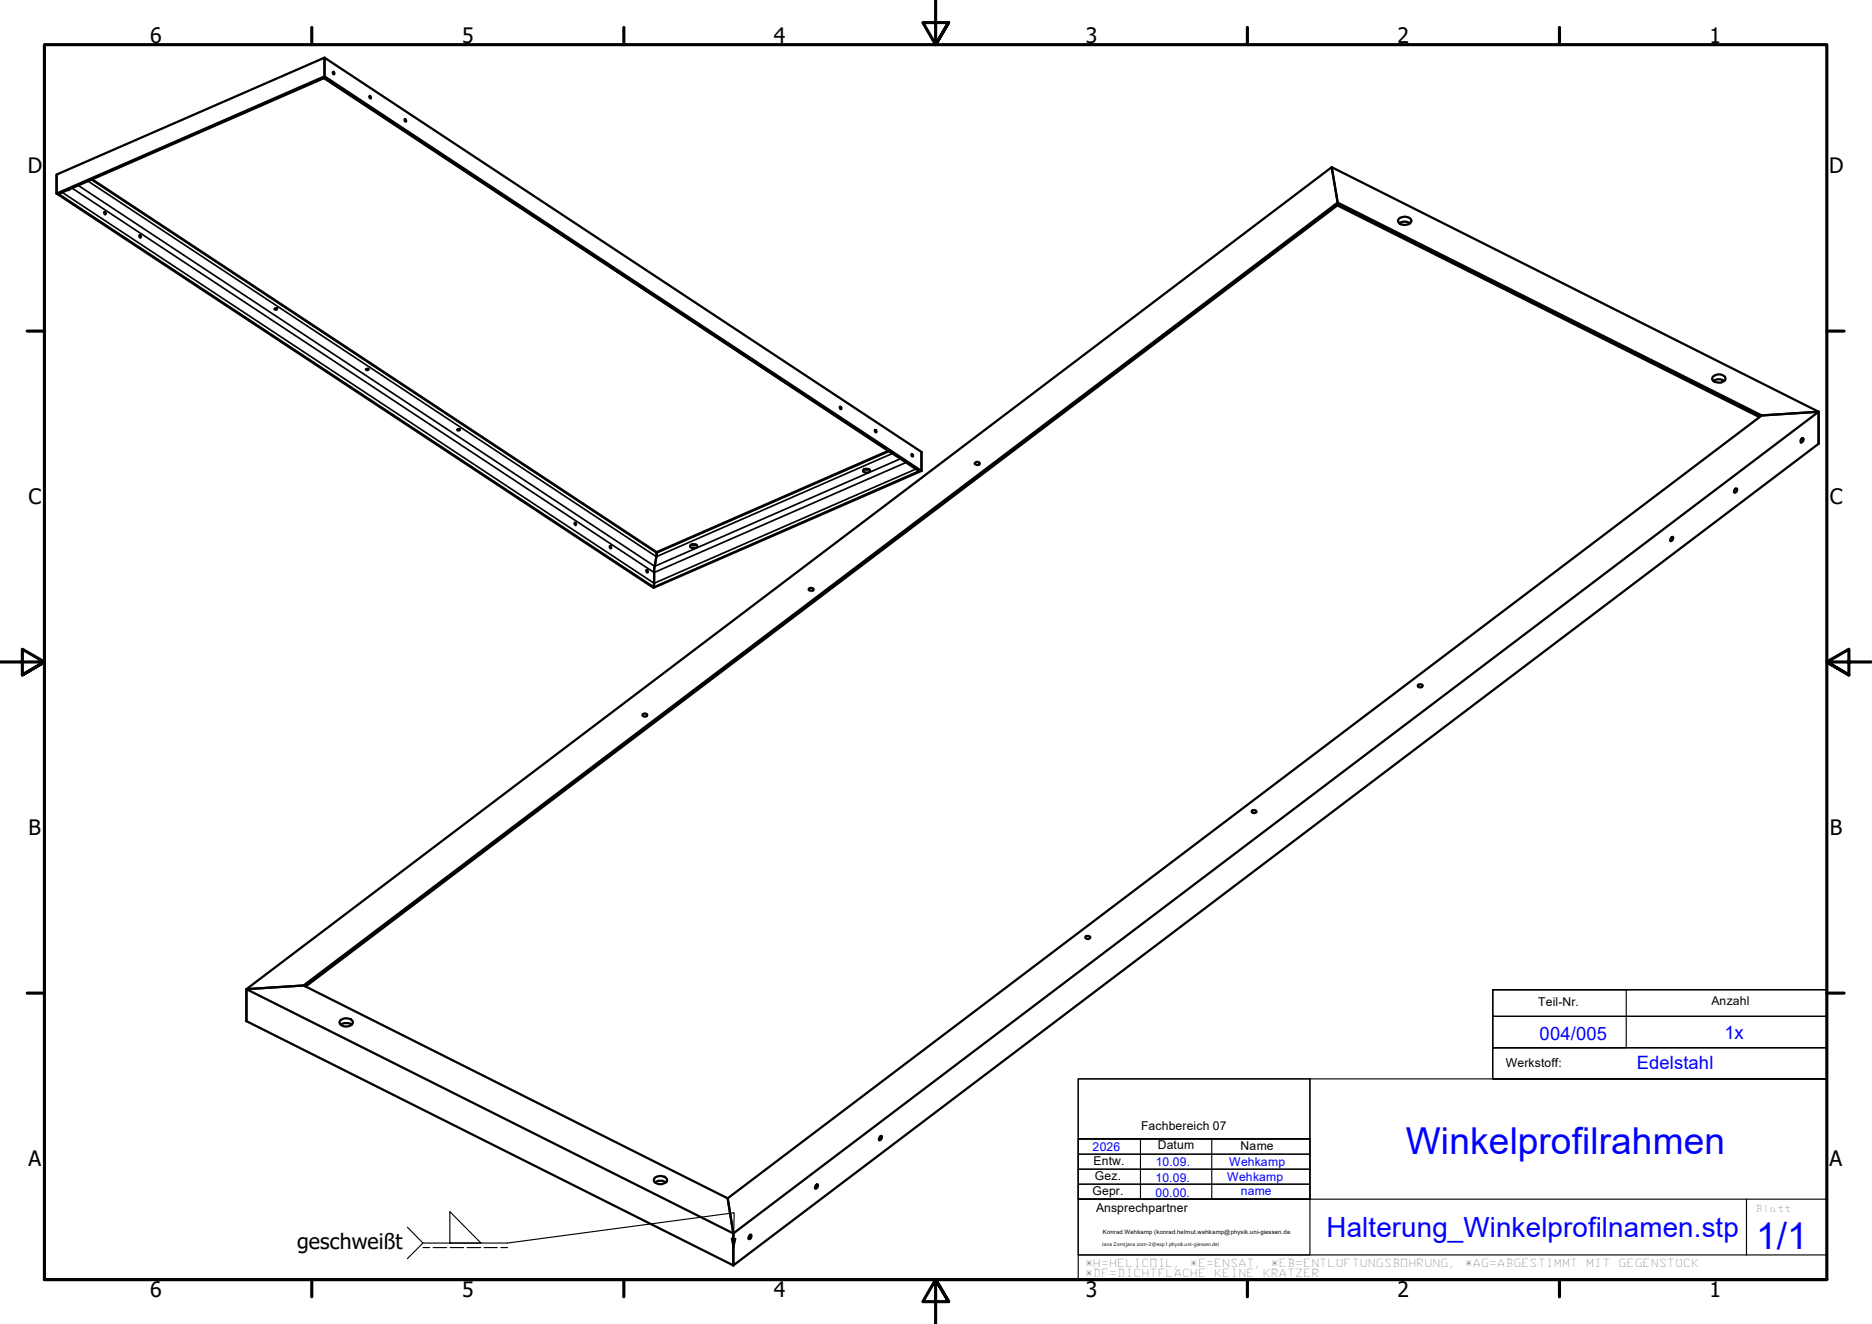
[picture p100: page 1]

Teil-Nr. | Anzahl
004/005 | 1x

Fachbereich 07 | Winkelprofilrahmen
2026 | Datum | Name

Entw. | 10.09. | Wehkamp
Gez. | 10.09. | Wehkamp
Gepr. | 00.00. | name
Ansprechpartner Konrad Wehkamp (konrad.helmut.wehkamp@physik.uni-giessen.de Jana Zorn(jana.zorn-2@exp1.physik.uni-giessen.de) | Halterung_Winkelprofilnamen.stp | Blatt 1/1

*H=HELICOIL, *E=ENSAT, *EB=ENTLÜFTUNGSBOHRUNG, *AG=ABGESTIMMT MIT GEGENSTÜCK
*DF=DICHTFLÄCHE KEINE KRATZER
