konradweh/ABEP_Koppeltest/(commit log)

2026-08-17 deleted old files and renamed everything
    [Abdeckung_Gaseinlass.ipt, Aufhängung.0003.iam, Aufhängung.0004.ipt, Aufhängung_Drehscheibe.0004.ipt, Aufhängung_Front_Koppeltest.0002.ipt, Aufhängung_Front_RFG.ipt, Aufhängung_Front_RFG_Koppeltest.0005.ipt, Aufhängung_Front_RIT10.ipt]
2026-09-14 Stand bevor Meeting Nr. 2 mit Wasem und Jana
2026-10-22 Repo-Reorganisation: alles unter CAD/ zusammengefasst
    - Gesamte CAD-Struktur (19K_..., 22K_..., Halterung, RF-Neutralisator,
    Aufhaengung) unter neuen Top-Level-Ordner CAD/ verschoben
    - Koppeltest_Halterung zu CAD/Halterung umbenannt und um
    Halterung_Assembly.iam und Halterung_Tisch.iam erweitert
    - Praesentation ueberarbeitet (slides.* -> rfn_aufbau.*, neue Bilder)
    und Zeichnungen/*.dwg in die jeweiligen CAD-Unterordner verteilt
    - RFN-COMSOL-Simulationsergebnisse (Briefing + Temperatur-/
    Verlustdichte-Plots) im Root ergaenzt
    Entspricht dem Stand von vorgestern (2026-10-20), vor dem
    RF-Neutralisator-Redesign. Die ueberarbeiteten "- Kopie"-Varianten
    von RF-Neutralisator und Aufhaengung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
2026-10-22 RF-Neutralisator und Aufhaengung: Redesign uebernommen
    Ersetzt den bisherigen Stand von CAD/RF-Neutralisator und
    CAD/Aufhaengung durch das komplette Redesign (vorher als
    "- Kopie"-Varianten gefuehrt, jetzt final uebernommen, Kopie-Suffix
    entfernt).
    Neue/geaenderte Teile u.a.: Blende_new, Distanzhuelse, Druckfeder,
    Edelstahlring, GFK-Ring oben, Keramikhuelse, Klemmring, Kontaktbolzen,
    O-Ring-Varianten, Trae ger, RFN_Aufhaengung_Front sowie zugehoerige
    Zeichnungen und RFN_Aufnahme_Parameter.xlsx.
2026-10-22 .gitignore einfuehren, OldVersions-Backups und Lock-Dateien aus Git entfernen
    - .gitignore ergaenzt: Inventor/AutoCAD-Temp- und Lock-Dateien
    (*.lck, *.tmp, ~*, *.dwl, *.dwl2, *.sv$) sowie OldVersions/-Ordner
    werden ab jetzt nicht mehr versioniert
    - Alle vorhandenen OldVersions/-Ordner aus dem Git-Index entfernt
    (bleiben lokal auf der Platte, Git-Historie uebernimmt die
    Versionierung zuverlaessiger und ohne das Repo weiter aufzublaehen)
    - Zwei versehentlich committete AutoCAD-Sperrdateien
    (~Halterung_Querwinkel.dwg.14400.tmp, ~Halterung_Seitenteil...)
    entfernt
2026-10-22 Git LFS fuer CAD-Binaerformate einrichten
    Trackt *.ipt, *.iam, *.dwg, *.stp ueber Git LFS (.gitattributes).
    Gilt nur fuer zukuenftige Aenderungen: bereits committete Dateien
    bleiben im normalen Git-Objektspeicher, bis sie das naechste Mal
    gespeichert und committet werden. Keine Historie umgeschrieben,
    kein Force-Push noetig.
2026-10-22 Aufraeumen: Ordnernamen, Root-Dateien, README
    - Leeren Default-Ordner "Neuer Ordner" (RF-Neutralisator) entfernt
    - RF-Neutralisator/alt -> Archiv_Sicherung_ohne_Federn (sprechender Name,
    Entstehungsdatum nicht mehr rekonstruierbar)
    - Halterung/Zeichnungen/Abgabe/Neuer Ordner -> STEP_Export
    - Lose Root-Dateien sortiert: RFN_Aufhaengung_Drehscheibe.stp nach
    CAD/Aufhaengung/, COMSOL-Simulationsergebnisse (Briefing + Plots) in
    neuen Ordner COMSOL/
    - README.md mit Strukturuebersicht und Hinweisen zu OldVersions/
    und Git LFS ausgebaut
2026-10-22 Fertigung/-Ordner fuer Werkstattunterlagen einfuehren
    - Neuer Top-Level-Ordner Fertigung/ mit Unterordnern je Baugruppe
    (RF-Neutralisator, Aufhaengung, Halterung) fuer Zeichnungen (.dwg)
    und STEP-Dateien (.stp), die an die Werkstatt gehen
    - Bei Halterung zwei widerspruechliche STEP-Staende bereinigt:
    Zeichnungen/Abgabe/ enthielt sowohl veraltete STEP-Dateien direkt
    im Ordner als auch eine abweichende, aktuellere Version in
    Zeichnungen/Abgabe/STEP_Export/ (unterschiedliche Dateigroessen,
    z.B. Seitenteil 126.914 vs. 143.575 Bytes). Die aktuelle Version
    (ex-STEP_Export) wandert nach Fertigung/Halterung/, die veraltete
    wird entfernt, die PDFs ziehen mit um
    - README.md: Fertigung/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
